Edzelf/Esp-radio/schema.png

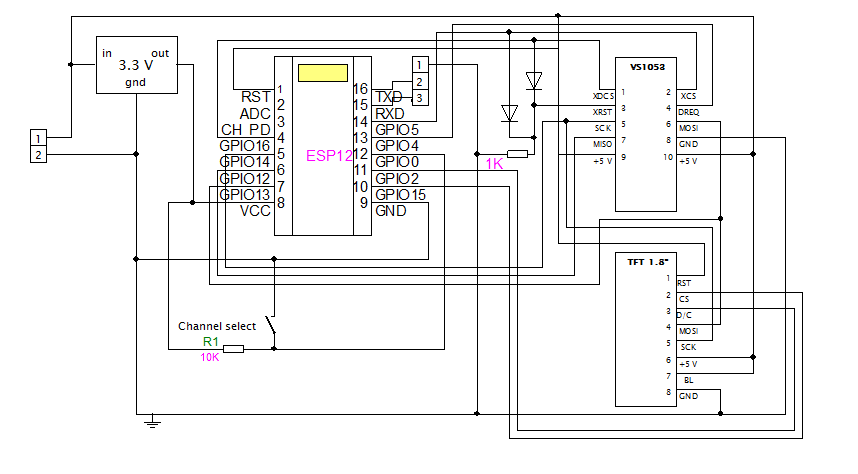
schema.png
