Edzelf/Esp-radio/(threads)

Thread 2 (2016-04-26):

Why not move mp3client to AsyncTCP as well?

me-no-dev, 2016-04-26:
Since I see you already have the Async server up (yeah! :)), why not move the mp3 stream to async as well? You will not need to buffer the client and you can write to the VS1053 as data comes. Using that will also ACK the data only after you have it loaded to the VS, which will make networking a little more predictable :)
Let me know what you think, I can help if needed :)

Edzelf, 2016-04-26:
I will try that.

Edzelf, 2016-04-26:
Hello,

I 've tried it.  But is was no success.
It looks like the client misses some bytes now and then.
In de debug output I see in the original version:
D: ICY 200 OK
D: icy-notice1:<BR>This stream requires <a
href="http://www.winamp.com/">Winamp</a><BR>
D: icy-notice2:SHOUTcast Distributed Network Audio Server/Linux v1.9.8<BR>
D: icy-name:NAXI LOVE RADIO (NAXI,Belgrade,Serbia, NAXI,Beograd,Srbija) - 128k

And in de async version:
D: ICY 200 OK
D: icy-notice1:<BR>This stream requires <a
href="http://www.winamp.com/">Winamp</a><BR>
D: icy-notice2:SHOUTcast Distributed Network Audio Server/Linux
v1.9.8<BR>icy-name:NAXI LOVE RADIO (NAXI,Belgrade,Serbia, NAXI,Beograd,Srbija) -
128k

So at least one linefeed is missing.
After that, the separation between mp3-data and metadata is not possible.

You will find the new source below.

Greetings,
Ed.

--------------------------------------------------------------------------------
//******************************************************************************************
//*  Esp_radio -- Webradio receiver for ESP8266, 1.8 color display and VS1053
MP3 module.  *
//*  With ESP8266 running at 80 MHz, it is capable of handling up to 256 kb
bitrate.       *
//*  With ESP8266 running at 160 MHz, it is capable of handling up to 320 kb
bitrate.      *
//******************************************************************************************
// ESP8266 libraries used:
//  - ESP8266WiFi
//  - SPI
//  - Adafruit_GFX
//  - TFT_ILI9163C
//  - EEPROM
//  - ESPAsyncTCP
//  - ESPAsyncWebServer
//  - FS
//  - ArduinoOTA
// A library for the VS1053 (for ESP8266) is not available (or not easy to
find).  Therefore
// a class for this module is derived from the maniacbug library and integrated
in this sketch.
//
// See http://www.internet-radio.com for suitable stations.  Add the stations of
your choice
// to the table "hostlist" in the global data secting further on.  This will be
written to
// EEPROM and can be modified through remote access through the web server.
//
// Brief description of the program:
// First a suitable WiFi network is found and a connection is made.
// Then a connection will be made to a shoutcast server.  The server starts with
some
// info in the header in readable ascii, ending with a double CRLF, like:
//  icy-name:Classic Rock Florida - SHE Radio
//  icy-genre:Classic Rock 60s 70s 80s Oldies Miami South Florida
//  icy-url:http://www.ClassicRockFLorida.com
//  content-type:audio/mpeg
//  icy-pub:1
//  icy-metaint:32768          - Metadata after 32768 bytes of MP3-data
//  icy-br:128                 - in kb/sec
//
// After de double CRLF is received, the server starts sending mp3-data.  This
data contains
// metadata (non mp3) after every "metaint" mp3 bytes.  This metadata is empty
in most cases,
// but if any is available the content will be presented on the TFT.
// Pushing the input button causes the player to select the next station in the
hostlist (EEPROM).
//
// The display used is a Chinese 1.8 color TFT module 128 x 160 pixels.  The
TFT_ILI9163C.h
// file has been changed to reflect this particular module.  TFT_ILI9163C.cpp
has been
// changed to use the full screenwidth if rotated to mode "3".  Now there is
room for 26
// characters per line and 16 lines.  Software will work without installing the
display.
//
// For configuration of the WiFi network(s): see the global data section further on.
//
// The SPI interface for VS1053 and TFT uses hardware SPI.
//
// Wiring:
// NodeMCU  GPIO    Pin to program  Wired to LCD        Wired to VS1053
Wired to rest
// -------  ------  --------------  ---------------     -------------------
---------------------
// D0       GPIO16  16              -                   pin 1 DCS            -
// D1       GPIO5    5              -                   pin 2 CS             LED
on nodeMCU
// D2       GPIO4    4              -                   pin 4 DREQ           -
// D3       GPIO0    0 FLASH        -                   -          
Control button
// D4       GPIO2    2              pin 3 (D/C)         -                    -
// D5       GPIO14  14 SCLK         pin 5 (CLK)         pin 5 SCK            -
// D6       GPIO12  12 MISO         -                   pin 7 MISO           -
// D7       GPIO13  13 MOSI         pin 4 (DIN)         pin 6 MOSI           -
// D8       GPIO15  15              pin 2 (CS)          -                    -
// D9       GPI03    3 RXD0         -                   -          
Reserved serial input
// D10      GPIO1    1 TXD0         -                   -          
Reserved serial output
// -------  ------  --------------  ---------------     -------------------
---------------------
// GND      -        -              pin 8 (GND)         pin 8 GND  
Power supply
// VCC 3.3  -        -              pin 6 (VCC)         -                    LDO
3.3 Volt
// VCC 5 V  -        -              -                   pin 9 5V   
Power supply
// RST      -        -              pin 1 (RST)         pin 3 RESET
Reset circuit
//
// The reset circuit is a circuit with 2 diodes to GPIO5 and GPIO16 and a
resistor to ground
// (wired OR gate) because there was not a free GPIO output available for this
function.
// This circuit is included in the documentation.
// Issue:
// Webserver produces error "LmacRxBlk:1" after some time.  After that it will
work verry slow.
// The program will reset the ESP8266 in such a case.  It seems that this error
will show up
// less frequently if DNS is not used.  Now we have switched to async webserver,
maybe that
// results in a better stability.
//
// 31-03-2016, ES: First set-up.
// 01-04-2016, ES: Detect missing VS1053 at start-up.
// 05-04-2016, ES: Added commands through http server on port 80.
// 06-04-2016, ES: Added list of stations in EEPROM
// 14-04-2016, ES: Added icon and switch preset on stream error.
// 18-04-2016, ES: Added SPIFFS for webserver
// 19-04-2016, ES: Added ringbuffer
// 20-04-2016, ES: WiFi Passwords through SPIFFS files, enable OTA
// 21-04-2016, ES: Switched to Async Webserver (thanks to me-no-dev)
// 26-04-2016, ES: Switched to Async client as well
//
#include <ESP8266mDNS.h>
#include <ESP8266WiFi.h>
#include <ESPAsyncTCP.h>
#include <ESPAsyncWebServer.h>
#include <ESPAsyncTCP.h>
#include <SyncClient.h>
#include <SPI.h>
#include <Adafruit_GFX.h>
#include <TFT_ILI9163C.h>
#include <Ticker.h>
#include <stdio.h>
#include <string.h>
#include <EEPROM.h>
#include <FS.h>
#include <ArduinoOTA.h>

extern "C"
{
  #include "user_interface.h"
}

// Color definitions for the TFT screen
#define    BLACK   0x0000
#define    BLUE    0xF800
#define    RED     0x001F
#define    GREEN   0x07E0
#define CYAN    GREEN | BLUE
#define MAGENTA RED | BLUE
#define YELLOW  RED | GREEN
#define WHITE   0xFFFF

// Digital I/O used
// Pins for VS1053 module
#define VS1053_CS     5
#define VS1053_DCS    16
#define VS1053_DREQ   4
// Pins CS and DC for TFT module
#define TFT_CS 15
#define TFT_DC 2
// Control button for controlling station
#define BUTTON 0
// Maximal number of presets in EEPROM and size of an entry
#define EENUM 64
#define EESIZ 64
// Ringbuffer for smooth playing 20000 bytes is 160 Kbits, about 1.5 seconds at
128kb bitrate.
#define RINGBFSIZ 20000

//******************************************************************************************
// Global data
section.                                                                    *
//******************************************************************************************
enum datamode_t { INIT, HEADER, DATA, METADATA } ;         // State for datastream
// Global variables
String           ssid ;                                    // SSID of selected
WiFi network
int              DEBUG = 1 ;
#if defined ( dns )
  MDNSResponder  mdns ;                                    // The MDNS responder
#endif
SyncClient       mp3client ;                               // An instance of the
mp3 client
AsyncWebServer   cmdserver ( 80 ) ;                        // Instance of
embedded webserver
String           cmd ;                                     // Command from remote
TFT_ILI9163C     tft = TFT_ILI9163C ( TFT_CS, TFT_DC ) ;
Ticker           tckr ;                                    // For timing 10 sec
uint32_t         totalcount = 0 ;                          // Counter mp3 data
char             sbuf[100] ;                               // For debug lines
datamode_t       datamode ;                                // State of datastream
int              metacount ;                               // Number of bytes in
metadata
int              datacount ;                               // Counter databytes
before metadata
char             metaline[150] ;                           // Readable line in
metadata
char             streamtitle[150] ;                        // Streamtitle from
metadata
int              bitrate = 0 ;                             // Bitrate in
kb/sec  
int              metaint = 0 ;                             // Number of
databytes between metadata
int              currentpreset = 1 ;                       // Preset station to
play (index in hostlist (EEPROM))
int              newpreset = 1 ;                           // Requested preset
char             host[EESIZ] ;                             // The hostname
char             sname[100] ;                              // Stationname
int              port ;                                    // Port number for host
char             newstation[EESIZ] ;                       // Station:port from
remote
int              delpreset = 0 ;                           // Preset to be
deleted if nonzero
uint8_t          reqvol = 80 ;                             // Requested volume
char             currentstat[EESIZ] ;                      // Current station:port
uint8_t*         ringbuf ;                                 // Ringbuffer for VS1053
uint16_t         rbwindex = 0 ;                            // Fill pointer in
ringbuffer
uint16_t         rbrindex = RINGBFSIZ - 1 ;                // Emptypointer in
ringbuffer
uint16_t         rcount = 0 ;                              // Number of bytes in
ringbuffer
//
// List of initial preset stations.
// This will be copied to EEPROM if EEPROM is empty.  The first entry [0] is
reserved
// for detection of a not yet filled EEPROM.
// In EEPROM, every entry takes EESIZ bytes.
const char*      hostlist[] = {
                     "Stations from remote control",  // Reserved entry
                     "109.206.96.34:8100",            //  1 - NAXI LOVE RADIO,
Belgrade, Serbia 128-kbps
                     "us1.internet-radio.com:8180",   //  2 - Easy Hits Florida
128-kbps
                     "us2.internet-radio.com:8050",   //  3 - CLASSIC ROCK MIA
WWW.SHERADIO.COM
                     "us1.internet-radio.com:15919",  //  4 - Magic Oldies Florida
                     "us2.internet-radio.com:8132",   //  5 - Magic 60s Florida
60s Top 40 Classic Rock
                     "us1.internet-radio.com:8105",   //  6 - Classic Rock
Florida - SHE Radio
                     "205.164.36.153:80",             //  7 - BOM PSYTRANCE
(1.FM TM)  64-kbps
                     "205.164.62.15:10032",           //  8 - 1.FM - GAIA, 64-kbps
                     "109.206.96.11:80",              //  9 - TOP FM Beograd
106,8  64-kpbs
                     "85.17.121.216:8468",            // 10 - RADIO LEHOVO 971
GREECE, 64-kbps
                     "85.17.121.103:8800",            // 11 - STAR FM 88.8 Corfu
Greece, 64-kbps
                     "85.17.122.39:8530",             // 12 - stylfm.gr laiko,
64-kbps
                     "94.23.66.155:8106",             // 13 - *ILR CHILL &
GROOVE* 64-kbps
                     "205.164.62.22:7012",            // 14 - 1.FM - ABSOLUTE
TRANCE (EURO) RADIO 64-kbps
                     NULL } ;

//******************************************************************************************
// End of lobal data
section.                                                              *
//******************************************************************************************

void dbgprint ( const char* p ) ;   // Forward declaration for VS1053 stuff

//******************************************************************************************
// VS1053 stuff.  Based on maniacbug
library.                                              *
//******************************************************************************************
// VS1053 class
definition.                                                                *
//******************************************************************************************
class VS1053
{
private:
  uint8_t       cs_pin ;                        // Pin where CS line is connected
  uint8_t       dcs_pin ;                       // Pin where DCS line is connected
  uint8_t       dreq_pin ;                      // Pin where DREQ line is connected
  uint8_t       curvol ;                        // Current volume setting
0..100%
  const uint8_t vs1053_chunk_size = 32 ;
  // SCI Register
  const uint8_t SCI_MODE          = 0x0 ;
  const uint8_t SCI_BASS          = 0x2 ;
  const uint8_t SCI_CLOCKF        = 0x3 ;
  const uint8_t SCI_AUDATA        = 0x5 ;
  const uint8_t SCI_WRAM          = 0x6 ;
  const uint8_t SCI_WRAMADDR      = 0x7 ;
  const uint8_t SCI_AIADDR        = 0xA ;
  const uint8_t SCI_VOL           = 0xB ;
  const uint8_t SCI_AICTRL0       = 0xC ;
  const uint8_t SCI_AICTRL1       = 0xD ;
  const uint8_t SCI_num_registers = 0xF ;
  // SCI_MODE bits
  const uint8_t SM_SDINEW         = 11 ;        // Bitnumber in SCI_MODE always on
  const uint8_t SM_RESET          = 2 ;         // Bitnumber in SCI_MODE soft reset
  const uint8_t SM_CANCEL         = 3 ;         // Bitnumber in SCI_MODE cancel song
  const uint8_t SM_TESTS          = 5 ;         // Bitnumber in SCI_MODE for tests
  const uint8_t SM_LINE1          = 14 ;        // Bitnumber in SCI_MODE for
Line input
  SPISettings   VS1053_SPI ;                    // SPI settings for this slave
  uint8_t       endFillByte ;                   // Byte to send when stopping song
  char          lsbuf[60] ;                     // For debugging
protected:
  inline void await_data_request() const
  {
    while ( !digitalRead ( dreq_pin ) )
    {
        yield() ;                         // Very short delay
    }
  }

  inline void control_mode_on() const
  {
    SPI.beginTransaction ( VS1053_SPI ) ; // Prevent other SPI users
    digitalWrite ( dcs_pin, HIGH ) ;      // Bring slave in dontrol mode
    digitalWrite ( cs_pin, LOW ) ;
  }

  inline void control_mode_off() const
  {
    digitalWrite ( cs_pin, HIGH ) ;       // End control mode
    SPI.endTransaction() ;                // Allow other SPI users
  }

  inline void data_mode_on() const
  {
    SPI.beginTransaction ( VS1053_SPI ) ; // Prevent other SPI users
    digitalWrite ( cs_pin, HIGH ) ;       // Bring slave in data mode
    digitalWrite ( dcs_pin, LOW ) ;
  }

  inline void data_mode_off() const
  {
    digitalWrite ( dcs_pin, HIGH ) ;      // End data mode
    SPI.endTransaction() ;                // Allow other SPI users
  }

  uint16_t read_register ( uint8_t _reg ) const ;
  void     write_register ( uint8_t _reg, uint16_t _value ) const ;
  void     sdi_send_buffer ( uint8_t* data, size_t len ) ;
  void     sdi_send_fillers ( size_t length ) ;
  void     wram_write ( uint16_t address, uint16_t data ) ;
  uint16_t wram_read ( uint16_t address ) ;

public:
  // Constructor.  Only sets pin values.  Doesn't touch the chip.  Be sure to
call begin()!
  VS1053 ( uint8_t _cs_pin, uint8_t _dcs_pin, uint8_t _dreq_pin ) ;
  void     begin() ;                                   // Begin operation.  Sets
pins correctly,
                                                       // and prepares SPI bus.
  void     startSong() ;                               // Prepare to start
playing. Call this each
                                                       // time a new song starts.
  void     playChunk ( uint8_t* data, size_t len ) ;   // Play a chunk of data.
Copies the data to
                                                       // the chip.  Blocks
until complete.
  void     stopSong() ;                                // Finish playing a song.
Call this after
                                                       // the last playChunk call.
  void     setVolume ( uint8_t vol ) ;                 // Set the player
volume.Level from 0-100,
                                                       // higher is louder.
  uint8_t  getVolume() ;                               // Get the currenet
volume setting.
                                                       // higher is louder.
  void     printDetails ( const char *header ) ;       // Print configuration
details to serial output.
  void     softReset() ;                               // Do a soft reset
  bool     testComm ( const char *header ) ;           // Test communication
with module
  inline bool data_request() const
  {
    return ( digitalRead ( dreq_pin ) == HIGH ) ;
  }
} ;

//******************************************************************************************
// VS1053 class
implementation.                                                            *
//******************************************************************************************

// Constructor
VS1053::VS1053 ( uint8_t _cs_pin, uint8_t _dcs_pin, uint8_t _dreq_pin ) :
  cs_pin(_cs_pin), dcs_pin(_dcs_pin), dreq_pin(_dreq_pin)
{
}

uint16_t VS1053::read_register ( uint8_t _reg ) const
{
  uint16_t result ;

  control_mode_on() ;
  SPI.write ( 3 ) ;                          // Read operation
  SPI.write ( _reg ) ;                       // Register to write (0..0xF)
  // Note: transfer16 does not seem to work
  result = ( SPI.transfer ( 0xFF ) << 8 ) |  // Read 16 bits data
           ( SPI.transfer ( 0xFF ) ) ;
  await_data_request() ;                     // Wait for DREQ to be HIGH again
  control_mode_off() ;
  return result ;
}

void VS1053::write_register ( uint8_t _reg, uint16_t _value ) const
{
  control_mode_on( );
  SPI.write ( 2 ) ;                          // Write operation
  SPI.write ( _reg ) ;                       // Register to write (0..0xF)
  SPI.write16 ( _value ) ;                   // Send 16 bits data
  await_data_request() ;
  control_mode_off() ;
}

void VS1053::sdi_send_buffer ( uint8_t* data, size_t len )
{
  size_t chunk_length ;                      // Length of chunk 32 byte or shorter

  data_mode_on() ;
  while ( len )                              // More to do?
  {
    await_data_request() ;                   // Wait for space available
    chunk_length = len ;
    if ( len > vs1053_chunk_size )
    {
      chunk_length = vs1053_chunk_size ;
    }
    len -= chunk_length ;
    SPI.writeBytes ( data, chunk_length ) ;
    data += chunk_length ;
  }
  data_mode_off() ;
}

void VS1053::sdi_send_fillers ( size_t len )
{
  size_t chunk_length ;                      // Length of chunk 32 byte or shorter

  data_mode_on() ;
  while ( len )                              // More to do?
  {
    await_data_request() ;                   // Wait for space available
    chunk_length = len ;
    if ( len > vs1053_chunk_size )
    {
      chunk_length = vs1053_chunk_size ;
    }
    len -= chunk_length ;
    while ( chunk_length-- )
    {
      SPI.write ( endFillByte ) ;
    }
  }
  data_mode_off();
}

void VS1053::wram_write ( uint16_t address, uint16_t data )
{
  write_register ( SCI_WRAMADDR, address ) ;
  write_register ( SCI_WRAM, data ) ;
}

uint16_t VS1053::wram_read ( uint16_t address )
{
  write_register ( SCI_WRAMADDR, address ) ;            // Start reading from WRAM
  return read_register ( SCI_WRAM ) ;                   // Read back result
}

bool VS1053::testComm ( const char *header )
{
  // Test the communication with the VS1053 module.  The result wille be returned.
  // If DREQ is low, there is problably no VS1053 connected.  Pull the line HIGH
  // in order to prevent an endless loop waiting for this signal.  The rest of the
  // software will still work, but readbacks from VS1053 will fail.
  int       i ;                                         // Loop control
  uint16_t  r1, r2, cnt = 0 ;
  uint16_t  delta = 300 ;                               // 3 for fast SPI

  if ( !digitalRead ( dreq_pin ) )
  {
    dbgprint ( "VS1053 not properly installed!" ) ;
    // Allow testing without the VS1053 module
    pinMode ( dreq_pin,  INPUT_PULLUP ) ;               // DREQ is now input
with pull-up
    return false ;                                      // Return bad result
  }
  // Further TESTING.  Check if SCI bus can write and read without errors.
  // We will use the volume setting for this.
  // Will give warnings on serial output if DEBUG is active.
  // A maximum of 20 errors will be reported.
  if ( strstr ( header, "Fast" ) )
  {
    delta = 3 ;                                         // Fast SPI, more loops
  }
  dbgprint ( header ) ;                                 // Show a header
  for ( i = 0 ; ( i < 0xFFFF ) && ( cnt < 20 ) ; i += delta )
  {
    write_register ( SCI_VOL, i ) ;                     // Write data to SCI_VOL
    r1 = read_register ( SCI_VOL ) ;                    // Read back for the
first time
    r2 = read_register ( SCI_VOL ) ;                    // Read back a second time
    if  ( r1 != r2 || i != r1 || i != r2 )              // Check for 2 equal reads
    {
      sprintf ( lsbuf, "VS1053 error retry SB:%04X R1:%04X R2:%04X", i, r1, r2 ) ;
      dbgprint ( lsbuf ) ;
      cnt++ ;
      delay ( 10 ) ;
    }
    yield() ;                                           // Allow ESP firmware to
do some bookkeeping
  }
  return ( cnt == 0 ) ;                                 // Return the result
}

void VS1053::begin()
{
  pinMode      ( dreq_pin,  INPUT ) ;                   // DREQ is an input
  pinMode      ( cs_pin,    OUTPUT ) ;                  // The SCI and SDI signals
  pinMode      ( dcs_pin,   OUTPUT ) ;
  digitalWrite ( dcs_pin,   HIGH ) ;                    // Start HIGH for SCI en SDI
  digitalWrite ( cs_pin,    HIGH ) ;
  delay ( 100 ) ;
  dbgprint ( "Reset VS1053..." ) ;
  digitalWrite ( dcs_pin,   LOW ) ;                     // Low & Low will bring
reset pin low
  digitalWrite ( cs_pin,    LOW ) ;
  delay ( 2000 ) ;
  dbgprint ( "End reset VS1053..." ) ;
  digitalWrite ( dcs_pin,   HIGH ) ;                    // Back to normal again
  digitalWrite ( cs_pin,    HIGH ) ;
  delay ( 500 ) ;
  // Init SPI in slow mode ( 2 MHz )
  VS1053_SPI = SPISettings ( 200000, MSBFIRST, SPI_MODE0 ) ;
  //printDetails ( "Right after reset/startup" ) ;
  delay ( 20 ) ;
  //printDetails ( "20 msec after reset" ) ;
  testComm ( "Slow SPI,Testing VS1053 read/write registers..." ) ;
  // Most VS1053 modules will start up in midi mode.  The result is that there
is no audio
  // when playing MP3.  You can modify the board, but there is a more elegant way:
  wram_write ( 0xC017, 3 ) ;                            // Switch to MP3 mode
  wram_write ( 0xC019, 0 ) ;                            // Switch to MP3 mode
  delay ( 100 ) ;
  //printDetails ( "After test loop" ) ;
  softReset() ;                                         // Do a soft reset
  // Switch on the analog parts
  write_register ( SCI_AUDATA, 44100 + 1 ) ;            // 44.1kHz + stereo
  // The next clocksetting allows SPI clocking at 5 MHz, 4 MHz is safe then.
  write_register ( SCI_CLOCKF, 6 << 12 ) ;              // Normal clock settings
multiplyer 3.0 = 12.2 MHz
  //SPI Clock to 4 MHz. Now you can set high speed SPI clock.
  VS1053_SPI = SPISettings ( 4000000, MSBFIRST, SPI_MODE0 ) ;
  write_register ( SCI_MODE, _BV ( SM_SDINEW ) | _BV ( SM_LINE1 ) ) ;
  testComm ( "Fast SPI, Testing VS1053 read/write registers again..." ) ;
  delay ( 10 ) ;
  await_data_request() ;
  endFillByte = wram_read ( 0x1E06 ) & 0xFF ;
  sprintf ( lsbuf, "endFillByte is %X", endFillByte ) ;
  dbgprint ( lsbuf ) ;
  //printDetails ( "After last clocksetting" ) ;
  delay ( 100 ) ;
}

void VS1053::setVolume ( uint8_t vol )
{
  // Set volume.  Both left and right.
  // Input value is 0..100.  100 is the loudest.
  uint16_t value ;                                      // Value to send to SCI_VOL

  if ( vol != curvol )
  {
    curvol = vol ;                                      // Save for later use
    value = map ( vol, 0, 100, 0xFF, 0x00 ) ;           // 0..100% to one channel
    value = ( value << 8 ) | value ;
    write_register ( SCI_VOL, value ) ;                 // Volume left and right
  }
}

uint8_t VS1053::getVolume()                             // Get the currenet
volume setting.
{
  return curvol ;
}

void VS1053::startSong()
{
  sdi_send_fillers ( 10 ) ;
}

void VS1053::playChunk ( uint8_t* data, size_t len )
{
  sdi_send_buffer ( data, len ) ;
}

void VS1053::stopSong()
{
  uint16_t modereg ;                     // Read from mode register
  int      i ;                           // Loop control

  sdi_send_fillers ( 2052 ) ;
  delay ( 10 ) ;
  write_register ( SCI_MODE, _BV ( SM_SDINEW ) | _BV ( SM_CANCEL ) ) ;
  for ( i = 0 ; i < 200 ; i++ )
  {
    sdi_send_fillers ( 32 ) ;
    modereg = read_register ( SCI_MODE ) ;  // Read status
    if ( ( modereg & _BV ( SM_CANCEL ) ) == 0 )
    {
      sdi_send_fillers ( 2052 ) ;
      sprintf ( lsbuf, "Song stopped correctly after %d msec",
                i * 10 ) ;
      dbgprint ( lsbuf ) ;
      return ;
    }
    delay ( 10 ) ;
  }
  printDetails ( "Song stopped incorrectly!" ) ;
}

void VS1053::softReset()
{
  write_register ( SCI_MODE, _BV ( SM_SDINEW ) | _BV ( SM_RESET ) ) ;
  delay ( 10 ) ;
  await_data_request() ;
}

void VS1053::printDetails ( const char *header )
{
  uint16_t     regbuf[16] ;
  uint8_t      i ;

  dbgprint ( header ) ;
  dbgprint ( "REG   Contents" ) ;
  dbgprint ( "---   -----" ) ;
  for ( i = 0 ; i <= SCI_num_registers ; i++ )
  {
    regbuf[i] = read_register ( i ) ;
  }
  for ( i = 0 ; i <= SCI_num_registers ; i++ )
  {
    delay ( 5 ) ;
    sprintf ( lsbuf, "%3X - %5X", i, regbuf[i] ) ;
    dbgprint ( lsbuf ) ;
  }
}

// The object for the MP3 player
VS1053 mp3 (  VS1053_CS, VS1053_DCS, VS1053_DREQ ) ;

//******************************************************************************************
// End VS1053
stuff.                                                                       *
//******************************************************************************************

//******************************************************************************************
// Ringbuffer (fifo)
routines.                                                             *
//******************************************************************************************
//******************************************************************************************
//                              R I N G S P A C
E                                          *
//******************************************************************************************
inline bool ringspace()
{
  return ( rcount < RINGBFSIZ ) ;     // True is at least one byte of free space
is available
}

//******************************************************************************************
//                              R I N G A V A I
L                                          *
//******************************************************************************************
inline uint16_t ringavail()
{
  return rcount ;                     // Return number of bytes available
}

//******************************************************************************************
//                                P U T R I N
G                                            *
//******************************************************************************************
bool putring ( uint8_t b )            // Put one byte in the ringbuffer
{
  // No check on available space.  See ringspace()
  *(ringbuf+rbwindex) = b ;           // Put byte in ringbuffer
  if ( ++rbwindex == RINGBFSIZ )      // Increment pointer and
  {
    rbwindex = 0 ;                    // wrap at end
  }
  rcount++ ;                          // Count number of bytes in the
}

//******************************************************************************************
//                                G E T R I N
G                                            *
//******************************************************************************************
uint8_t getring()
{
  // Assume there is always something in the bufferpace.  See ringavail()
  if ( ++rbrindex == RINGBFSIZ )      // Increment pointer and
  {
    rbrindex = 0 ;                    // wrap at end
  }
  rcount-- ;                          // Count is now one less
  return *(ringbuf+rbrindex) ;        // return the oldest byte
}

//******************************************************************************************
//                               E M P T Y R I N
G                                         *
//******************************************************************************************
void emptyring()
{
  rbwindex = 0 ;                      // Reset ringbuffer administration
  rbrindex = RINGBFSIZ - 1 ;
  rcount = 0 ;
}

//******************************************************************************************
//                                  D B G
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

Thread 8 (2016-05-23):

D: VS1053 error retry SB:0000 R1:FFFF R2:FFFF

praveenchaun, 2016-05-23:
Hi There,
I am getting some errors however code continue to run. Cannot listen anything from head phone. Do I need to modify the board to support MP3?

Serial monitor output attached.

Thanks,
[error.txt](https://github.com/Edzelf/Esp-radio/files/277036/error.txt)

praveenchaun, 2016-05-23:
I mean no sound on head phone. Thanks.

Edzelf, 2016-05-23:
Praveenchaun,

It looks like the connection to the VS1053 is not correct.  There shouldn't be errors after "Slow SPI,Testing VS1053 read/write registers...".  In your case I see a readback of "FFFF", so I assume that writing commands to SPI did not work.  Check the wiring.....

praveenchaun, 2016-05-24:
Thanks for your response.
I have not connected the reset wiring to VS1053, is that could be an issue?
I was trying to reset the board manually pulling it to GND between below steps.
D: Reset VS1053...
D: End reset VS1053...
Could you please let me know what the diod values you used?

Edzelf, 2016-05-24:
There is no need for the reset wiring as long as you use power-off power-on to reset the radio.  I used 14148 diodes.  If "Testing VS1053 read/write registers" produces errors, check pins 1,2,4,5, and 7 of the VS1053 board.  I'm pretty sure that one of these pins is not (or wrong) wired.

praveenchaun, 2016-05-26:
Today I reconnected everything and noticed that it stops at the below location:

: Restored settings: volume 80, preset 1
D: 1Reset VS1053...
D: End reset VS1053...
D: inside testComm
D: VS1053 not properly installed!

Once I disconnect the DREQ Pin, proceeds to rest of the steps and fails!!

D: Fast SPI, Testing VS1053 read/write registers again...
D: VS1053 error retry SB:0003 R1:0000 R2:0000
D: VS1053 error retry SB:0006 R1:0000 R2:0000

Something wrong with my module. I am using ESP12E Firmware :

2nd boot version : 1.4(b1)
  SPI Speed      : 40MHz
  SPI Mode       : QIO
  SPI Flash Size & Map: 8Mbit(512KB+512KB)
jump to run user1 @ 1000

ŒÂÕ�MEM CHECK FAIL!!!
ärlŽ‚rô
Ai-Thinker Technology Co. Ltd.
=====================
Sketch upload options as you suggested.

Edzelf, 2016-05-26:
Your ESP8266 works correctly according to the debug output.
After power up or reset the DREQ line must be HIGH. "VS1053 not properly installed!" will be printed if this line is LOW.  Pin 4 of the VS1084 should be on a 3 Volt level  when not connected.  If not, the board is probably damaged.  Are u sure that the module is powered by 5 Volt?

Closed 2016-06-06.

Thread 9 (2016-05-24):

esp board, do not connect to internet..what I doing wrong?

yo2ldk, 2016-05-24:
Hi Ed,

 first, thank you for your work, I really need something like this !
I have two modules, one esp8266 like ESP-12F :

http://g02.a.alicdn.com/kf/HTB1gXfyLVXXXXafXFXXq6xXFXXXk/221078962/HTB1gXfyLVXXXXafXFXXq6xXFXXXk.jpg

and other like ESP-12E I think:

http://g01.a.alicdn.com/kf/HTB18APYLVXXXXaOaXXXq6xXFXXXb/221815479/HTB18APYLVXXXXaOaXXXq6xXFXXXb.jpg

 Now, i change the file name ssid.pw, to my ssid network, and text inside with my password. then I copy into folder Data, where the schetch it is, also folder ESP8266FS with jar file in it.
 When I upload file, I selected NodeMCU 0.9 board, then NodeMCU 1.0.
not work  at all.. (firmware is uploaded ok)
 I not see on router this connection, and LCD is blank.
please some advice  I'm blocked  :(

(or on my mail - yo2ldk  a r r o u n d yahoo dot   c o m )
  thank you in advance

Edzelf, 2016-05-24:
The .pw file must be, together with index.html and favicon.ico in the map "data" (lower case).  Then you have to upload this map to your ESP8266 as shown at page 2 of the the pdf-file.  There should not be a "jar"-file in it.  Try to capture the debug output and publish it here, than I can see what's wrong.

yo2ldk, 2016-05-24:
thank you for you time and fast reply!

 please tell me also in Arduino software/tools/debbug level, what I need to select from there ?
 and, because I'm still novice, how can I read.obtain the debug file?

Edzelf, 2016-05-24:
No settings are required for debug level output.  Just start serial monitor (Ctrl+Shift+M in IDE) and copy the output.

yo2ldk, 2016-05-24:
still the same, nothing in headset, looks like is not connected via wifi , LED is on for a bit when insert power, then is off, is it was traffic, I presume it was blink,
wires is checked and re check, firmware is ok, on serial terminal monitor is blank, nothing.
I put out display, still nothing.
I will try later, at home router. Thank you for your patience

Edzelf, 2016-05-24:
I do not know what you mean by "firmware".  Did the upload of the sketch and the "ESP8266 Data Upload" succeed?  In the debug output you should see at least some output lines concerning WiFi connection and VS1053 tests.  As an example of the debug output see the attached file.
[debug.txt](https://github.com/Edzelf/Esp-radio/files/279410/debug.txt)

MiloPS3, 2016-05-26:
Hello, I had the same problem, I have ESP12E Lolin
you must rename .pw file at "myssid.pw" and change password and ssid inside
select Flash Size: "4 M(1M SPIFFS)".
upload this map to your ESP8266 as shown at page 2 of the pdf-file(pw file +index.html+favicon.ico)
if in debug output is (my neme ssid is "PS4" and "MO")
`D: FS Total 957314, used 9287
D: /favicon.ico                     -    766
D: /index.html                      -   6563
D: /MO.pw                           -     71
D: /PS4.pw                          -     71
`
upload success done
if in next debug output is
`D: Selected network:               
D: Try WiFi
`
wrong name pw file of wrong select Flash Size
right is
`D: Selected network: PS4              
D: Try WiFi PS4
`
if not define USETFT and use  button on D8/GPIO15 , disconnect pull-up if is used at start esp,log high on D8 is Boot on SD card (esp not start)

Excuse me for my bad English

Edzelf, 2016-05-26:
Milo, You are right about the .pw file(s).  I will make that more clear in the document file.
You are also right about GPIO15 (D8), which must be low to allow the ESP to start.  I will think of a solution for that.

MiloPS3, 2016-05-26:
change LOW to HIGH   in
oldval3 = newval ;                          // Yes, remember value
      //if ( newval == LOW )                        // Button pushed?
	  if ( newval == HIGH )                        // Button pushed?
It is not a good solution (2 button active in low and 1 button active high)
but it works

Edzelf, 2016-05-26:
Fixed it already.

WiGeorg, 2018-03-07:
hello Ed,
I followed this discussion (and others I found) with some given solutions to connect to WiFi, but I dont have any success! My little system only open an AP under 192.168.4.1
I use a NodeMCU 1.0(ESP 12F - LoLin), my configuration is:
4M (3M SPIFFS) => 4M(1MSPIFFS) do not work too
v2 Prebuilt (MSS0536) => v1.4Prebuilt do not work too
Arduino IDE 1.85
My pw-file is named "mySSID.pw" with the content "mySSID/mypw"

Please see the debug-file here:
[My Output.txt](https://github.com/Edzelf/Esp-radio/files/1789058/My.Output.txt)
Do you have any idea what goes wrong?

Thanks!

Willi

Edzelf, 2018-03-07:
A *.pw file is no longer required for the latest version of the radio.  You have to enter the WiFi credentials in the radio.ini file like this:
```
# WiFi network credentials, may be more than on entry.  Strongest signal will be selected.
wifi_00 = TP-LINK_9ECA/PASWORDXXX

```

WiGeorg, 2018-03-07:
Hello Ed, thank you!I started without a pw-file, but without succes. I found the pw tip in a thread. After my last mail I found out that the system connect, when I configer my router to No Security. This isn't a real solution. Standard is WEP/WEP2 with AES/TPK. It seems to be a problem of cryptage.Do you have any idea?WilliAm 07.03.2018 16:30 schrieb Ed Smallenburg <notifications@github.com>:A *.pw file is no longer required for the latest version of the radio.  You have to enter the WiFi credentials in the radio.ini file like this:
# WiFi network credentials, may be more than on entry.  Strongest signal will be selected.
wifi_00 = TP-LINK_9ECA/PASWORDXXX

—You are receiving this because you commented.Reply to this email directly, view it on GitHub, or mute the thread.

Closed 2016-06-06.

Thread 11 (2016-08-05):

ESP-01

iqbeul, 2016-08-05:
Dear Edzelf
Im newbie for esp8266, but interested with your project, i try following your pdf guide from preparing Arduino IDE to Install Library. i dont understand how to upload the sketch what is the different update through Tools/ESP8266Sketch Data Upload with Upload like usual arrow in the main panel of Arduino IDE.
So far is unsuccesfull when i try with ESP-01 and use arduino uno as ISP, is it possible to upload and test with this board ? what should i do to get esp-01 can receive upload sketch
Thank you in advance

Edzelf, 2016-08-06:
The ESP-01 is not suitable for this project.  There are not enough pins to drive the VS1053 module and the memory is too small to load the program and the data.  I suggest to use a ESP-12 or even better a nodeMCU module.  The nodeMCU has its own USB interface so you don't need the Arduino for upload.

bickyb, 2016-08-15:
First off, awesome project.   I had a few questions:

1)I was reading through the PDF and it mentions using a "VS1063 module".  Was that supposed to be VS1053 module?

2) Let's say I want to play just a standalone MP3 file residing on a web server (e.g., www.somedomain.com/mymp3file.mp3
How would I go about doing this?  It seems your code shows how to connect to mp3 streams, but I wanted to see if single mp3 playback is doable.

3) I wanted to see if the following board would be usable:
https://learn.adafruit.com/adafruit-feather-huzzah-esp8266/overview

instead of the ESP-12 board.

Closed 2016-08-15.

Thread 12 (2016-08-05):

Web page not loading completely

nlovrens, 2016-08-05:
Hi,
First of all, i would like to thank you for all what you have done, great work!
But I have one issue:
When opening web page of the esp, page is not loaded completely (see attach).
Everything else works, I can listen to music, issue additional commands thru web and so on...
Can you, please help?

Thank you

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

Edzelf, 2016-08-06:
Check if index.html in the data directory (the files in the SPIFFS) has the right length. It should be 6563 bytes.  If you connect a serial monitor, you should see a directory listing in the debug output.
An ESP-12 should have more than enough space to hold the files.
You could use the "show source" of your browser to examine the contents (specially near the end) of the index.html file.

nlovrens, 2016-08-06:
I couldn't find the problem. File index.html is correct size and it is listed in serial output.
I have also tried to delete most of the stuff from index.html and leave just the header and one word in the body, then page was loaded completely. After that I have tried to add more and more stuff to body and then after some point page didn't want to load anymore. It looks like if the index.html grows over certain size then problem starts.
I have also tried to downgrade Arduino ide to 1.6.8 and ESP8266 package to 2.2.0 as stated in your PDF but it didn't help. I have also tried to flash esp as 1M(3M SPIFFS) to check if memory is corrupted, but behavior was the same.

Edzelf, 2016-08-07:
I think your analysis is right.  Could you try to use a different WiFi network (ask a neighbour or a friend)?
What kind of ESP module are you using?

nlovrens, 2016-08-07:
Hi.
After lots of troubleshooting I have found the problem. Cisco VPN client that I have installed on my PC changed MTU on all my network interfaces to 1300 (default in windows is 1500). And apparently expressIFs IP stack doesn't support MTU size less than 1460. After manually reverting my MTU to 1500 web page loaded successfully. You can close the issue.
Thank you for all your support!

Closed 2016-08-08.

Thread 16 (2016-08-15):

Feature Request - Bootstrapping to Wifi

bickyb, 2016-08-15:
It would be really cool if you could make it so that one can connect to the ESP-radio via their phone using a browser (kind of like you do a wifi router upon initial config).  From there, it would be nice if you could search for wifi spots available, select one, and provide credentials to connect to it.
I love the current setup but right now it requires one to have to know what wifi spots they might be connecting to and to preprogram them.  It would be cool if one could press a button to put the device in learn mode so you can configure the wifi credentials on the fly.

Edzelf, 2016-08-15:
The web server is included in the Esp-radio.  In order to connect to the webserver the ESP has has to connect to the WiFi first.  Theoretically it should be possible to let the ESP act like a station and access point simultaneously, but I do not have experience with this set-up.

But if you mean to dynamically add WiFi stations while the ESP is already connected it is possible.  This feature would need some extra software.

bbx10, 2016-08-24:
[WiFiManager](https://github.com/tzapu/WiFiManager) works well for entering new SSID and password. I have used it before.

Edzelf, 2016-08-24:
bbx10,
That looks nice!  I will implement this feature in the near future.

Edzelf, 2016-10-04:
Fixed in the current version.

Closed 2016-10-04.

Thread 17 (2016-08-15):

Which type of diodes

bickyb, 2016-08-15:
Hi,
I saw in the circuit diagram in the PDF that you use 2 diodes.
Can you please specify which types of diodes you suggest using?

Edzelf, 2016-08-15:
The diodes are not critical.  I used 1N5148.

Closed 2016-10-04.

Thread 18 (2016-08-15):

Where to hookup audio amplifier

bickyb, 2016-08-15:
Hi,
One thing I could not figure out from the circuit diagrams is how you are connecting the audio amplifier to the VS1053 board.
The VS1053 board has a 3.5mm output which can be connected to headphones.
What is a bit unclear to me is how you can connect the audio amp to the VS1053 board.  Do you have a cable plugged into the 3.5 jack and are you tapping into the audio from the line level out or do you somehow connect the amplifier to the VS1053 board directly?

Also, can you please let us know an example of the type of amplifier you used in your circuit?

Edzelf, 2016-08-15:
The audio amplifier is connected through the 3.5 mm output jack.  Note that the common pin of the output jack is not at ground level.  Therefore I used a separate power circuit (battery) for the amplifier.

For the amplifier I used a cheap class D type base on a PAM8403 chip ( 2 dollar for 10 pieces).

Closed 2016-09-15.

Thread 19 (2016-09-08):

webserver doesnt work correct

macmattes, 2016-09-08:
hi

thanks for this project, i use your software with a nodemcu clone from china and a vs1003 board.
streaming and audio works fine, but i am unable to use the webinterface. Some time the site loads nearly full, only the presets are missed , mostly i got a broken website which starts with "hr.open ( "GET", theUrl, false ...........  and shows the html code instead the site.
And if the site is visible i am unable to use any of the buttons, because loading never ends.
i have reflashed the esp some times also with a blink sketch and different flash sizes. nothing changed.
if i stop the site loading and use only the functions like "/?uppreset=1" it changes the channel without a delay. the other functions are also working. hope you can help to find my problem with the website.
i used safari or firefox on osx, both the same

Edzelf, 2016-09-08:
Hello,
Maybe it is a problem with the vs1003 board.  Just remove the vs1003 and try the web-interface to see if it is loading.  I tried several Chinese boards without problems.  Send you debug output to ed.at.smallenburg.nl.  (.at. = @).
Ed.

Verzonden vanaf Samsung-tablet.

-------- Oorspronkelijk bericht --------
Van: macmattes <notifications@github.com>
Datum: 08-09-2016  20:04  (GMT+01:00)
Aan: Edzelf/Esp-radio <Esp-radio@noreply.github.com>
Onderwerp: [PossibleSpam] [Edzelf/Esp-radio] webserver doesnt work correct (#19)

hi

thanks for this project, i use your software with a nodemcu clone from china and a vs1003 board.

streaming and audio works fin, but i am unable to use the webinterface. Some time the site loads nearly full, only the presets are missed , mostly i got a broken website which starts with "hr.open ( "GET", theUrl, false ...........  and shows the html code instead the site.

And if the site is visible i am unable to use any of the buttons, because loading never ends.

i have reflashed the esp some times also with a blink sketch and different flash sizes. nothing changed.

if i stop the site loading and use only the functions like "/?uppreset=1" it changes the channel without a delay. the other functions are also working. hope you can help to find my problem with the website.

i used safari or firefox on osx, both the same

—
You are receiving this because you are subscribed to this thread.
Reply to this email directly, view it on GitHub, or mute the thread.

{"api_version":"1.0","publisher":{"api_key":"05dde50f1d1a384dd78767c55493e4bb","name":"GitHub"},"entity":{"external_key":"github/Edzelf/Esp-radio","title":"Edzelf/Esp-radio","subtitle":"GitHub repository","main_image_url":"https://cloud.githubusercontent.com/assets/143418/17495839/a5054eac-5d88-11e6-95fc-7290892c7bb5.png","avatar_image_url":"https://cloud.githubusercontent.com/assets/143418/15842166/7c72db34-2c0b-11e6-9aed-b52498112777.png","action":{"name":"Open in GitHub","url":"https://github.com/Edzelf/Esp-radio"}},"updates":{"snippets":[{"icon":"DESCRIPTION","message":"webserver doesnt work correct (#19)"}],"action":{"name":"View Issue","url":"https://github.com/Edzelf/Esp-radio/issues/19"}}}

Edzelf, 2016-09-08:
Are you sure that javascript works on osx?

Verzonden vanaf Samsung-tablet.

-------- Oorspronkelijk bericht --------
Van: macmattes <notifications@github.com>
Datum: 08-09-2016  20:04  (GMT+01:00)
Aan: Edzelf/Esp-radio <Esp-radio@noreply.github.com>
Onderwerp: [PossibleSpam] [Edzelf/Esp-radio] webserver doesnt work correct (#19)

hi

thanks for this project, i use your software with a nodemcu clone from china and a vs1003 board.

streaming and audio works fin, but i am unable to use the webinterface. Some time the site loads nearly full, only the presets are missed , mostly i got a broken website which starts with "hr.open ( "GET", theUrl, false ...........  and shows the html code instead the site.

And if the site is visible i am unable to use any of the buttons, because loading never ends.

i have reflashed the esp some times also with a blink sketch and different flash sizes. nothing changed.

if i stop the site loading and use only the functions like "/?uppreset=1" it changes the channel without a delay. the other functions are also working. hope you can help to find my problem with the website.

i used safari or firefox on osx, both the same

—
You are receiving this because you are subscribed to this thread.
Reply to this email directly, view it on GitHub, or mute the thread.

{"api_version":"1.0","publisher":{"api_key":"05dde50f1d1a384dd78767c55493e4bb","name":"GitHub"},"entity":{"external_key":"github/Edzelf/Esp-radio","title":"Edzelf/Esp-radio","subtitle":"GitHub repository","main_image_url":"https://cloud.githubusercontent.com/assets/143418/17495839/a5054eac-5d88-11e6-95fc-7290892c7bb5.png","avatar_image_url":"https://cloud.githubusercontent.com/assets/143418/15842166/7c72db34-2c0b-11e6-9aed-b52498112777.png","action":{"name":"Open in GitHub","url":"https://github.com/Edzelf/Esp-radio"}},"updates":{"snippets":[{"icon":"DESCRIPTION","message":"webserver doesnt work correct (#19)"}],"action":{"name":"View Issue","url":"https://github.com/Edzelf/Esp-radio/issues/19"}}}

Edzelf, 2016-09-08:
Could you try to use a different wifi network?  Maybe it something to do with the maximal packet size of your router.  You may also try to load a short and a long .txt file on the SPIFFS.  Your browser should be able to load this correctly (http://<IP>/file.txt or something like that).
Verzonden vanaf Samsung-tablet.

-------- Oorspronkelijk bericht --------
Van: macmattes <notifications@github.com>
Datum: 08-09-2016  20:04  (GMT+01:00)
Aan: Edzelf/Esp-radio <Esp-radio@noreply.github.com>
Onderwerp: [PossibleSpam] [Edzelf/Esp-radio] webserver doesnt work correct (#19)

hi

thanks for this project, i use your software with a nodemcu clone from china and a vs1003 board.

streaming and audio works fin, but i am unable to use the webinterface. Some time the site loads nearly full, only the presets are missed , mostly i got a broken website which starts with "hr.open ( "GET", theUrl, false ...........  and shows the html code instead the site.

And if the site is visible i am unable to use any of the buttons, because loading never ends.

i have reflashed the esp some times also with a blink sketch and different flash sizes. nothing changed.

if i stop the site loading and use only the functions like "/?uppreset=1" it changes the channel without a delay. the other functions are also working. hope you can help to find my problem with the website.

i used safari or firefox on osx, both the same

—
You are receiving this because you are subscribed to this thread.
Reply to this email directly, view it on GitHub, or mute the thread.

{"api_version":"1.0","publisher":{"api_key":"05dde50f1d1a384dd78767c55493e4bb","name":"GitHub"},"entity":{"external_key":"github/Edzelf/Esp-radio","title":"Edzelf/Esp-radio","subtitle":"GitHub repository","main_image_url":"https://cloud.githubusercontent.com/assets/143418/17495839/a5054eac-5d88-11e6-95fc-7290892c7bb5.png","avatar_image_url":"https://cloud.githubusercontent.com/assets/143418/15842166/7c72db34-2c0b-11e6-9aed-b52498112777.png","action":{"name":"Open in GitHub","url":"https://github.com/Edzelf/Esp-radio"}},"updates":{"snippets":[{"icon":"DESCRIPTION","message":"webserver doesnt work correct (#19)"}],"action":{"name":"View Issue","url":"https://github.com/Edzelf/Esp-radio/issues/19"}}}

macmattes, 2016-09-10:
hi

i am searching for a solution, it looks like a problem with the asyncwebserver or spiffs, i tried now without the decoder board and different flash spiff sizes, and also with a new nodemcu clone(same model)  nothing changes, the debug log shows the commands /?list uppreset.... all available, and i can see also that the t.md file is loaded from spiffs, but the index.html will not load.
a first test with a index.html without the script block fails, also.
i have send you my debug log, and i will search further

macmattes, 2016-09-11:
hi

everything is fine with espradio, it works on my cellphone browser. thanks
courios

Edzelf, 2016-09-11:
Take a look at this: https://support.zen.co.uk/kb/Knowledgebase/Changing-the-MTU-size-in-Mac-OS-X-10.6-to-10.9

Verzonden vanaf Samsung-tablet.

-------- Oorspronkelijk bericht --------
Van: macmattes <notifications@github.com>
Datum: 11-09-2016  10:46  (GMT+01:00)
Aan: Edzelf/Esp-radio <Esp-radio@noreply.github.com>
Cc: Ed Smallenburg <ed@smallenburg.nl>, Comment <comment@noreply.github.com>
Onderwerp: Re: [Edzelf/Esp-radio] webserver doesnt work correct (#19)

hi

everything is fine with espradio, it works on my cellphone browser. thanks

courios

—
You are receiving this because you commented.
Reply to this email directly, view it on GitHub, or mute the thread.

{"api_version":"1.0","publisher":{"api_key":"05dde50f1d1a384dd78767c55493e4bb","name":"GitHub"},"entity":{"external_key":"github/Edzelf/Esp-radio","title":"Edzelf/Esp-radio","subtitle":"GitHub repository","main_image_url":"https://cloud.githubusercontent.com/assets/143418/17495839/a5054eac-5d88-11e6-95fc-7290892c7bb5.png","avatar_image_url":"https://cloud.githubusercontent.com/assets/143418/15842166/7c72db34-2c0b-11e6-9aed-b52498112777.png","action":{"name":"Open in GitHub","url":"https://github.com/Edzelf/Esp-radio"}},"updates":{"snippets":[{"icon":"PERSON","message":"@macmattes in #19: hi\r\n\r\neverything is fine with espradio, it works on my cellphone browser. thanks\r\ncourios"}],"action":{"name":"View Issue","url":"https://github.com/Edzelf/Esp-radio/issues/19#issuecomment-246169270"}}}

Closed 2016-09-10.

Thread 21 (2016-09-15):

sound comes out in chunks

tomtobback, 2016-09-15:
Hi, thanks a lot for this excellent project. I almost got it working and maybe you can help me to troubleshoot. I hear very short chunks of music from my VS1053. The webserver test says:
Free memory is 8992, ringbuf 0, stream 0  (is this normal?)
At startup, the Serial monitor reports that the VS1053 is not properly installed, as below.
There seems to be a problem with the reset of the VS1053, if i connect the pull-down resistor to the diodes' output, it stays LOW in permanent reset and i don't get any sound; if i disconnect the pull-down, then i get those sound chunks.
Thanks fro any suggestions- Tom

D: Reset VS1053...
D: End reset VS1053...
D: VS1053 not properly installed!
D: Fast SPI, Testing VS1053 read/write registers again...
D: VS1053 error retry SB:0000 R1:FFFF R2:FFFF
D: VS1053 error retry SB:0003 R1:FFFF R2:FFFF
D: VS1053 error retry SB:0006 R1:FFFF R2:FFFF
D: VS1053 error retry SB:0009 R1:FFFF R2:FFFF
D: VS1053 error retry SB:000C R1:FFFF R2:FFFF
D: VS1053 error retry SB:000F R1:FFFF R2:FFFF
D: VS1053 error retry SB:0012 R1:FFFF R2:FFFF
D: VS1053 error retry SB:0015 R1:FFFF R2:FFFF
D: VS1053 error retry SB:0018 R1:FFFF R2:FFFF
D: VS1053 error retry SB:001B R1:FFFF R2:FFFF
D: VS1053 error retry SB:001E R1:FFFF R2:FFFF
D: VS1053 error retry SB:0021 R1:FFFF R2:FFFF
D: VS1053 error retry SB:0024 R1:FFFF R2:FFFF
D: VS1053 error retry SB:0027 R1:FFFF R2:FFFF
D: VS1053 error retry SB:002A R1:FFFF R2:FFFF
D: VS1053 error retry SB:002D R1:FFFF R2:FFFF
D: VS1053 error retry SB:0030 R1:FFFF R2:FFFF
D: VS1053 error retry SB:0033 R1:FFFF R2:FFFF
D: VS1053 error retry SB:0036 R1:FFFF R2:FFFF
D: VS1053 error retry SB:0039 R1:FFFF R2:FFFF
D: endFillByte is FF
D: * Scan Networks *

Edzelf, 2016-09-15:
It looks like you have the diodes mounted in reverse.
For testing you could do without the reset circuit.
First step is to get rid of the error messages.  Are you sure that the GND of the VS1053 is tightly connected to the GND of the ESP?

While not playing, ringbuf 0, stream 0 is okay (no streem, nothing buffered).
During playing the ringbuf is mostly filled up to 20000 bytes and the stream should also have some bytes in it.

tomtobback, 2016-09-16:
Hi Ed, i got rid of some errors; Slow SPI is working, but the Fast SPI test still fails as below
CPU is set to 160MHz, not sure where the speed issue comes from. the ESP-12 that i am using is quite old, maybe a hardware issue, i'll buy a new one to try. or any other ideas?
Than

D: Reset VS1053...
D: End reset VS1053...
D: Slow SPI,Testing VS1053 read/write registers...
D: Fast SPI, Testing VS1053 read/write registers again...
D: VS1053 error retry SB:07E9 R1:07E9 R2:0000
D: VS1053 error retry SB:13E9 R1:13E9 R2:0000
D: VS1053 error retry SB:17A9 R1:17A9 R2:0000
D: VS1053 error retry SB:1929 R1:1929 R2:0000
D: VS1053 error retry SB:1AA9 R1:1AA9 R2:0000
D: VS1053 error retry SB:1C29 R1:1C29 R2:0000
D: VS1053 error retry SB:1DA9 R1:1DA9 R2:0000
D: VS1053 error retry SB:2FA9 R1:2FA9 R2:0000
D: VS1053 error retry SB:3009 R1:3009 R2:0000
D: VS1053 error retry SB:3069 R1:3069 R2:0000
D: VS1053 error retry SB:37E9 R1:37E9 R2:0000
D: VS1053 error retry SB:38A9 R1:38A9 R2:0000
D: VS1053 error retry SB:3A29 R1:3A29 R2:0000
D: VS1053 error retry SB:3BA9 R1:3BA9 R2:0000
D: VS1053 error retry SB:3EA9 R1:3EA9 R2:0000
D: VS1053 error retry SB:43E9 R1:43E9 R2:0000
D: VS1053 error retry SB:47A9 R1:47A9 R2:0000
D: VS1053 error retry SB:4929 R1:4929 R2:0000
D: VS1053 error retry SB:4AA9 R1:4AA9 R2:0000
D: VS1053 error retry SB:4C29 R1:4C29 R2:0000
D: endFillByte is 0

Edzelf, 2016-09-16:
Looks like an SPI problem.
Did you check the ground connections?
You may try to run the ESP on 80 MHz, change line 1382 to:
system_update_cpu_freq ( 80 ) ; // Set to 80/160 MHz.
You may also try to disconnect the TFT display, it shares the SPI bus and maybe there is something wrong there.

tomtobback, 2016-10-06:
Hi Ed,
It seems i have identified the cause of the problem: the VS1053 i am using is an Arduino shield, with a SD card, and when an SD card is inserted, it interferes with the SPI. As soon as i unplug the SD card, it works without a glitch! I tried pulling the chip select of the SD card high but that does not solve it. Maybe you have any ideas?
Thanks a lot for this great project.

Edzelf, 2016-10-06:
Yes, that makes sense.  Maybe you can find out what GPIO is used for the SD card and then redefine the pins used in the project.
Have you noticed the new version of Esp_radio (with MQTT and new configuration setup)?

tomtobback, 2016-10-07:
hi Ed, all working fine now with the new version, without display, one button on GPIO0 for next station. It seems the next station function does not check for the number of defined stations so it just keeps going up, trying even when there's no presets - is this easy to fix?
Another note; the code as GPIO0 as INPUT_PULLUP so the 10K resistor in the schematics is not necessary, right?
And in the VS1053.begin, the test for slow SPI says 2MHz in the comments but the number is 200,000 so that is rather 200kHz, right?

Edzelf, 2016-10-07:
tomtobback:
1 - Will return to preset 0 now after highest preset.
2 - Pull-up not necessary (but doesn't harm).
3- Slow SPI test is at 200 kHz indeed.

Current version has some loose ends, as I am trying to make uploads more stable and I am busy to support stand-alone mp3 files.

Closed 2016-10-04.

Thread 25 (2016-10-04):

Make AsyncMqttClient.h optional like USETFT

NoNeedForAName123, 2016-10-04:
please add download reference to AsyncMqttClient.h to documentation and make the usage of Mqtt configurable.
see https://github.com/NoNeedForAName123/Esp-radio/blob/master/Esp_radio.ino how it worked for me.

NoNeedForAName123, 2016-10-04:
pls. see https://github.com/NoNeedForAName123/Esp-radio/blob/master/Esp_radio.ino how it worked for me.

Edzelf, 2016-10-05:
If you mean "upload", thats already documented.  You can switch off Mqtt by removing the "mqtt"-lines in the radio.ini file.  I documented the last feature in the new pdf-file.

NoNeedForAName123, 2016-10-05:
Sorry, I mean in the ESP-radio.pdf in the chapter "Arduino IDE installation for Esp-radio" there is the download location for the AsyncMqttClient missing. So even with switching off mqtt in the ini file compilation fails:

`/Esp-radio/Esp-radio.ino:113:29: fatal error: AsyncMqttClient.h: No such file or directory
 #include <AsyncMqttClient.h>

https://github.com/marvinroger/async-mqtt-client
                             ^
compilation terminated.`

Edzelf, 2016-10-11:
Fixed.

Closed 2016-10-11.

Thread 28 (2016-10-11):

power supply

tomtobback, 2016-10-11:
Hi Ed, thanks again for this wonderful project, working well now.
Some notes that might be of interest; when i tried to power both ESP and amp (small 5V stereo class D amp) from the same 5V, i found out that the VS1053 audio output is DC biased to 1.25V, which seems to be the case on most boards. There's an application note explaining how to get rid of the bias (blocking caps etc), but that still had a lot of noise probably due to the shared power supply (or the breadboard setup). So i also opted for 2 separate power supplies, and the sound is very clean.
I like the switch circuit in your PDF but i was wondering if this is not a little dangerous, to charge 2 lithium cells at the same time, with 1 charger which cannot know the state of both cells. Additionally, when you switch your radio off, the (presumably) fully charged batt1 is directly connected to the less than fully charged batt2, which i think can lead to high currents, potentially dangerous if your lithium cells do not each have protection circuits.
The ESP seems to need more than 100mA constantly, just out of interest, how many hours do you get out of your battery approximately?
As above is not really an issue, feel free to close it.

Edzelf, 2016-10-11:
Thank you for your feedback.  You are right.  The current may be very high.  For simplicity I think might be sufficient to add a current limiting resistor, like 5.6 ohms, to the load line of "battery 2".  An extra charger would also do the trick as well as using cells with protection circuits.
I cannot tell how long the radio runs on batteries.  Normally it is connected to a power adapter, so it will be charged when I switch of to "off".  In the "On" state, only the battery for the amplifier is discharged (26 mA).  The current for the ESP8266 plus the VS1053 is 135 mA, so it should work for about 15 hours.
Have you tried my new version?  It now can play standalone MP3s as well.

tomtobback, 2016-10-15:
Hi Ed, i was a bit confused, you mean mp3 files on another server, right?
for a moment i thought we could upload mp3 files to the ESP, at the bottom of the config screen, but i guess that's not what this upload is intended for?

Edzelf, 2016-10-15:
Esp-radio will play mp3 file that are placed on a remote server.  You can however upload any file to the ESP, it was meant to make changes to the html files.  I do have a version that is capable of playing from SPIFFS by specifying "localhost" as the server in the station, but since the SPIFFS can only store 3 MB it is not very useful.
The SPIFFS is not very stable.  I noticed that reading from a file is very slow sometimes.
However, my TFT has an on-board "MicroSD Card Breakout".  Do you think it's worthwhile to have this implemented?

tomtobback, 2016-11-16:
Hi Ed, it took me a while to finish this project, it's working very well now. to answer your question, personally i'm not too interested in playing music from SD card so wouldn't vote for that.
it's very functional for me the way it is now.
i've posted some pics on my blog if you'd like to see my build: http://cassiopeia.hk/internetradio/

Edzelf, 2017-01-31:
Finally saw your blog.
Nice box and nice story too!

Closed 2017-02-22.

Thread 29 (2016-10-14):

Problem with library AsyncMqttClient

Lubosno, 2016-10-14:
Thank you for super project.
New version i can not compile.
I have error  in line 1566  mqttclient.onConnect ( onMqttConnect ) ;
Please advice and help
Lubosno from Czech rep.

This is my error report:
> Arduino: 1.6.8 (Windows XP), Vývojová deska: "Generic ESP8266 Module, 160 MHz, 80MHz, DIO, >115200, 4M (1M SPIFFS), ck, Disabled, None"

> C:\Documents and Settings\sklad\Dokumenty\Arduino\Esp-radio-master (1)\Esp-radio-master\Esp->radio-master.ino: In function 'void setup()':

>Esp-radio-master:1566: error: no matching function for call to 'AsyncMqttClient::onConnect(void (&)())'
>       mqttclient.onConnect ( onMqttConnect ) ;

>C:\Documents and Settings\sklad\Dokumenty\Arduino\Esp-radio-master (1)\Esp-radio-master\Esp->radio-master.ino:1566:44: note: candidate is:

>In file included from C:\Documents and Settings\sklad\Dokumenty\Arduino\libraries\async-mqtt-client->master\src/AsyncMqttClient.h:4:0,

> from C:\Documents and Settings\sklad\Dokumenty\Arduino\Esp-radio-master (1)\Esp-radio->master\Esp-radio-master.ino:116:

>C:\Documents and Settings\sklad\Dokumenty\Arduino\libraries\async-mqtt-client->master\src/AsyncMqttClient.hpp:43:20: note: AsyncMqttClient& >AsyncMqttClient::onConnect(AsyncMqttClientInternals::OnConnectUserCallback)
 >  AsyncMqttClient& onConnect(AsyncMqttClientInternals::OnConnectUserCallback callback);
>C:\Documents and Settings\sklad\Dokumenty\Arduino\libraries\async-mqtt-client->master\src/AsyncMqttClient.hpp:43:20: note:   no known conversion for argument 1 from 'void()' to >'AsyncMqttClientInternals::OnConnectUserCallback {aka std::function<void(bool)>}'
>exit status 1
>no matching function for call to 'AsyncMqttClient::onConnect(void (&)())'

Edzelf, 2016-10-14:
Looks like you have the wrong library for MQTT.  This project uses "AsyncMqttClient by Marvin Roger Version 0.3.0".  See https://github.com/marvinroger/async-mqtt-client.

This is a list of the libraries used (at the end of the compiler logging:
ESP8266WiFi op versie 1.0 in map: \AppData\Local\Arduino15\packages\esp8266\hardware\esp8266\2.3.0\libraries\ESP8266WiFi
ESPAsyncTCP-master op versie 1.0.0 in map: \Arduino\libraries\ESPAsyncTCP-master
ESPAsyncWebServer-master op versie 1.0.0 in map: \Arduino\libraries\ESPAsyncWebServer-master
async-mqtt-client-master op versie 0.3.0 in map: \Arduino\libraries\async-mqtt-client-master
SPI op versie 1.0 in map: \AppData\Local\Arduino15\packages\esp8266\hardware\esp8266\2.3.0\libraries\SPI
Adafruit_GFX_Library op versie 1.1.5 in map: \Arduino\libraries\Adafruit_GFX_Library
TFT_ILI9163C-master op versie 0.9 in map: \Arduino\libraries\TFT_ILI9163C-master
Ticker op versie 1.0 in map: \Arduino15\packages\esp8266\hardware\esp8266\2.3.0\libraries\Ticker
ArduinoOTA op versie 1.0 in map: \Arduino15\packages\esp8266\hardware\esp8266\2.3.0\libraries\ArduinoOTA
Hash op versie 1.0 in map: \Arduino15\packages\esp8266\hardware\esp8266\2.3.0\libraries\Hash
ESP8266mDNS in map: \Arduino15\packages\esp8266\hardware\esp8266\2.3.0\libraries\ESP8266mDNS (legacy)

Lubosno, 2016-10-14:
Hallo, i have lastes version from internet 0.5.0

This is my log

> async-mqtt-client-master ve verzi 0.5.0 v adresáři: C:\Documents and Settings\sklad\Dokumenty\Arduino\libraries\async-mqtt-client-master

the others library are the same

Thank

Edzelf, 2016-10-14:
I updated the code for using 0.5.0 version of the library.

Closed 2016-10-14.

Thread 30 (2016-10-14):

Support for m3u URLs

larbigj, 2016-10-14:
Please add support for m3u URLs

karawin, 2016-10-14:
and xspf and pls to be complete ;-)
Nice project.

Edzelf, 2016-10-14:
Hmm, I will look into that.

larbigj, 2016-10-24:
mp3: http://www.rockantenne.de/webradio/rockantenne.m3u

aac: http://www.rockantenne.de/webradio/rockantenne.aac.pls

Edzelf, 2016-11-15:
m3u playlists are now supported.

Closed 2016-12-07.

Thread 31 (2016-10-22):

function "muteflag" not working  and Configuration file cannot be edited through web interface.

pasagame, 2016-10-22:
1. function "muteflag" not working, i test by MQTT (mute, unmute) no effect.
2. Configuration file can not be edited or upload through web interface. if have edit or uploading files "Radio.ini"  from the Web server some data on file is lost and espradio cannot working. Be solved by upload via "ESP8266 Sketch Data Upload" on arduino ide only then will work properly.

http://www.mx7.com/view2/zr9d6GpCasnkljmj

Edzelf, 2016-10-22:
1. mute/unmute works now.
2. Sometimes uploads are damaged.  It looks like there is a problem in the SPIFFS library.

pasagame, 2016-10-23:
now i test function mute/unmute not work.

Edzelf, 2016-10-23:
Did you rebuild the project?
Check line 111 in your sketch.  It should read "#define VERSION "22-oct-2016".
I tested it in the webinterface:
http://192.168.2.12/?mute
http://192.168.2.12/?unmute

pasagame, 2016-10-23:
thank you, i update to lastest version. mute function working proberly.

Closed 2016-10-23.

Thread 32 (2016-10-22):

Reset connection in schematic different from wiring diagram

harmverbeek, 2016-10-22:
In the schematic the RST pin of the ESP12 seems to be connected to +5V(!) and the RST pin of the LCD.
In the wiring table it is supposed to connect to the RST pins of both LCD and VS1053.

What is the right way?

Edzelf, 2016-10-22:
Harm,
The drawing was not correct.  I 've uploaded a new one.  The reset of the ESP is pulled high by a resistor on the mounting board.  The reset of the TFT and the VS1053 is done by the reset circuit (2 diodes and a resistor): when GPIO5 and GPIO16 are both low, the reset pins go low.

68erDirk, 2016-11-13:
What is the purpose of the reset circuit? I left it away completely and only connected everything as described under "wiring"? Everything seems to work well.

snazzware, 2017-03-21:
FYI, I recently loaded up this project on a Wemos D1 mini, and just wired the Reset pin of the VS1053 board to the D1's reset pin. Worked like a charm!

Edzelf, 2017-03-24:
snazzware: thats fine.  But this pin is not programmable, so the VS1053 will not be reset on powerup.  This reset, however, seems to be not necessary in practice.  So all will work correctly, even if you connect the reset pin of the VS1053 to +5 Volt.

Thread 33 (2016-10-27):

TFT display not working

pasagame, 2016-10-27:
I use a 1.8 TFT, but it does not work. I used standalone. (Test code), works properly. please look picture this link http://www.mx7.com/view2/zrLdZLyC7TSCjbPc

standalone (test code)
# include <Adafruit_GFX.h>  //Adafruit_GFX.h
# include <TFT_ILI9163C.h>  //TFT_ILI9163C.h
# include <SPI.h>  //SPI.h

// Color definitions for the TFT screen (if used)
# define  BLACK   0x0000
# define BLUE    0xF800
# define RED     0x001F
# define GREEN   0x07E0
# define CYAN    GREEN | BLUE
# define MAGENTA RED | BLUE
# define YELLOW  RED | GREEN
# define WHITE   0xFFFF
# define TFT_CS 15
# define TFT_DC 2

TFT_ILI9163C     tft = TFT_ILI9163C ( TFT_CS, TFT_DC ) ;

void setup() {
  SPI.begin() ;
  tft.begin() ;                                      // Init TFT interface
  tft.fillRect ( 0, 0, 160, 128, BLACK ) ;           // Clear screen does not work when rotated
  tft.setRotation ( 3 ) ;                            // Use landscape format
  tft.clearScreen() ;                                // Clear screen
  tft.setTextSize ( 1 ) ;                            // Small character font
  tft.setTextColor ( WHITE ) ;
  tft.println ( "Starting" ) ;

}

void loop(){
  //
}

Edzelf, 2016-10-27:
At the moment I have no possibility to look at the code.  If it works stand-alone, try to disconnect the VS1053 and the resetlines.
Verzonden vanaf Samsung-tablet.

-------- Oorspronkelijk bericht --------
Van: pasagame <notifications@github.com>
Datum: 27-10-16  10:58  (GMT+01:00)
Aan: Edzelf/Esp-radio <Esp-radio@noreply.github.com>
Onderwerp: [PossibleSpam] [Edzelf/Esp-radio] TFT display not working (#33)

I use a 1.8 TFT, but it does not work. I used standalone. (Test code), works properly. please look picture this link http://www.mx7.com/view2/zrLdZLyC7TSCjbPc

standalone (test code)

#include

#include

#include

// Color definitions for the TFT screen (if used)

#define  BLACK   0x0000

#define BLUE    0xF800

#define RED     0x001F

#define GREEN   0x07E0

#define CYAN    GREEN | BLUE

#define MAGENTA RED | BLUE

#define YELLOW  RED | GREEN

#define WHITE   0xFFFF

#define TFT_CS 15

#define TFT_DC 2

TFT_ILI9163C     tft = TFT_ILI9163C ( TFT_CS, TFT_DC ) ;

void setup() {

  SPI.begin() ;

  tft.begin() ;                                      // Init TFT interface

  tft.fillRect ( 0, 0, 160, 128, BLACK ) ;           // Clear screen does not work when rotated

  tft.setRotation ( 3 ) ;                            // Use landscape format

  tft.clearScreen() ;                                // Clear screen

  tft.setTextSize ( 1 ) ;                            // Small character font

  tft.setTextColor ( WHITE ) ;

  tft.println ( "Starting" ) ;

}

void loop(){

//

}

—
You are receiving this because you are subscribed to this thread.
Reply to this email directly, view it on GitHub, or mute the thread.

{"api_version":"1.0","publisher":{"api_key":"05dde50f1d1a384dd78767c55493e4bb","name":"GitHub"},"entity":{"external_key":"github/Edzelf/Esp-radio","title":"Edzelf/Esp-radio","subtitle":"GitHub repository","main_image_url":"https://cloud.githubusercontent.com/assets/143418/17495839/a5054eac-5d88-11e6-95fc-7290892c7bb5.png","avatar_image_url":"https://cloud.githubusercontent.com/assets/143418/15842166/7c72db34-2c0b-11e6-9aed-b52498112777.png","action":{"name":"Open in GitHub","url":"https://github.com/Edzelf/Esp-radio"}},"updates":{"snippets":[{"icon":"DESCRIPTION","message":"TFT display not working (#33)"}],"action":{"name":"View Issue","url":"https://github.com/Edzelf/Esp-radio/issues/33"}}}

pasagame, 2017-09-17:
until now i cannot use tft display.

Closed 2017-01-31.

Thread 34 (2016-10-31):

% simbol in wifi passw

jammoyano, 2016-10-31:
If wifi passw uses % can't connect to SSID

jammoyano, 2016-11-08:
Partially solved. Just insert wifi passw on code.

Closed 2016-11-08.

Thread 36 (2016-11-02):

ESP Record voice by vs1053

etoshey, 2016-11-02:
Hello,
According to your shematic, i have an wierd esp wroom and vs1053 mudule (geeethec) , then use your esp radio code (that is great and useful source code) , it works fine.
You wrote a comment on your code about start up modules in midi mode , i have to change PGIO DDR and ODATA for record voice?
I am trying to record voice  but i have a problem . Dreq pin gone low when start to record.
At the first, in my code :
cs pin ==> HIGH
dcs pin==> HIGH
dreq pin define as an INPUT
SPISettings => 250000, MSBFIRST, SPI_MODE0
and then soft reset (SCI_MODE= SM_SDINEW | SM_RESET)
Now, SCI_STATUS register equals 72 (0010 1010). Sine Test is OK,
record initiation :
SCI_CLOCKF = 0xC000 // set max clock
wait for rising DREQ pin
SCI_BASS = 0 // clear Bass
SCI_MODE= SM_SDINEW | SM_RESET // soft reset
wait for rising DREQ pin
SCI_WRAMADDR =0xC01A
SCI_WRAM = 0x02
SCI_AICTRL0= 1024
SCI_AICTRL1= 1024
SCI_AICTRL2= 0
SCI_AICTRL3= 0;
loadPlugin...
Active
SCI_MODE = SM_ADPCM | SM_SDINEW
SCI_AIADDR = 0x34
wait for rising DREQ pin ==> INFINITY LOOP, because the DREQ pin stay down.

I can not find my mistake , If is possible guide me, Thanks

Edzelf, 2016-11-15:
I did some experimenting with recording (ogg-format).  Not with the best results....  You can examine my code on http://smallenburg.nl/Ogg-encoder.zip.
Note that you have to supply a file for your WiFi SSID containing the password, for example SSID.pw.

fredericplante, 2016-12-13:
At line 18, you specifies "Pin to program". What does that mean? What is hooked on those pins?

Edzelf, 2016-12-14:
It is the pinnumber that you use in the sketch to address the pin.  Note the issue I mentioned at the top of the Ogg-encoder sketch: "Sometimes the conversion will not start"....
GPIO[0] and GPIO[1] are being set to LOW in the sketch.

fredericplante, 2016-12-14:
So it basically, it's the same pin out then the Radio-player, except for Xrst that is set to pin 3, instead of the reset pin of the ESP8266.

Edzelf, 2016-12-14:
Could be, this is a different project, so the pin configuration and software will differ.

fredericplante, 2016-12-21:
Before I buy another VS1053, tel me will this broadcaster project, the zip file you just sent, and the radio project connect and play along together?

Edzelf, 2016-12-21:
Yes, I had it working for a while.  But it was not very reliable.  I think it will be a challenge to get it working.

fredericplante, 2016-12-21:
Well ok then, it will be part of my late xMass shopping. Thank you Ed

Closed 2016-11-15.

Thread 37 (2016-11-08):

Panic & reboot

jammoyano, 2016-11-08:
It's unable to play or use the radio .... just reboot after reboot.

Here is the serial monitor ... ¿any idea?

`D: /config.html                     -   3817
D: /favicon.ico                     -    766
D: /index.html                      -   6769
D: /radio.ini                       -    538
D: Added SSID 00 = Wlan_99d5_2 to acceptable networks
D: * Scan Networks *
D: Number of available networks: 7
D:  1 - ONO_2016                  Signal: -87 dBm Encryption Auto
D:  2 - _AUTO_ONOWiFi             Signal: -86 dBm Encryption None
D:  3 - Orange-5F28               Signal: -89 dBm Encryption Auto
D:  4 - Ptv Maria Jose            Signal: -91 dBm Encryption Auto
D:  5 - MOVISTAR_B888             Signal: -93 dBm Encryption WPA
D:  6 - Wlan_99d5_2               Signal: -82 dBm Encryption WPA2  Acceptable
D:  7 - Ptv_4729_2                Signal: -83 dBm Encryption WPA2
D: --------------------------------------
D: Command: mqttbroker with parameter broker.hivemq.com
D: Command: mqttport with parameter 1883
D: Command: mqttuser with parameter none
D: Command: mqttpasswd with parameter none
D: Command: mqtttopic with parameter espradio
D: Command: mqttpubtopic with parameter espradioIP
D: Command: wifi_00 with parameter Wlan_99d5_2/xxxxxxx
D: Starting ESP Version 22-oct-2016...  Free memory 16880
D: Sketch size 321056, free size 724992
D: Reset VS1053...
D: End reset VS1053...
D: Slow SPI,Testing VS1053 read/write registers...
D: Fast SPI, Testing VS1053 read/write registers again...
D: endFillByte is 0
D: Selected network: Wlan_99d5_2      
D: Try WiFi Wlan_99d5_2
D: IP = 10.0.0.70
D: Start server for commands
D: list request from browser

Panic C:\Users\Jose\AppData\Local\Arduino15\packages\esp8266\hardware\esp8266\2.3.0\cores\esp8266\core_esp8266_main.cpp:98 __yield

ctx: sys
sp: 3ffff840 end: 3fffffb0 offset: 01b0

>>>stack>>>
3ffff9f0:  3fff7ac8 00000007 3ffffa40 40216b35
3ffffa00:  0000000a 3ffffa58 3ffffa40 402153a5
3ffffa10:  3ffe0070 0000021a 3ffffa58 4021434d
3ffffa20:  3ffe8be0 3fff865c 3ffffa40 402143db
3ffffa30:  00000000 3fff865c 3fff8bc4 4020858e
3ffffa40:  3fff8ac4 0000001f 0000001e 40214139
3ffffa50:  00000000 00000000 3ffea0d8 00000000
3ffffa60:  000003e8 00003b60 3fff921c 3fff8b94
3ffffa70:  3ffe90fc 3fff0ad4 3fff0298 3fff925c
3ffffa80:  0000005f 0000005a 3fff9314 0000005f
3ffffa90:  0000005a 3fff87ec 0000000f 0000000a
3ffffaa0:  3fff8ac0 3fff2bcc 3fff865c 00003b56
3ffffab0:  00000002 00000001 3fff865c 40209715
3ffffac0:  00000000 00000000 00000000 3fff0aac
3ffffad0:  00000010 3ffffb60 3ffea0d8 00000000
3ffffae0:  000003e8 3ffffb98 00000000 00000000
3ffffaf0:  00000010 3ffffb80 00000000 3fff2abc
3ffffb00:  0000000f 00000001 3fff2bcc 0000000f
3ffffb10:  00000004 00000003 3ffffb60 00000000
3ffffb20:  00000000 3ffffb80 3ffffb80 4021490c
3ffffb30:  3ffe8ca0 00000000 3ffffb80 00000002
3ffffb40:  00000002 3fff865c 3fff865c 40216288
3ffffb50:  3fff8670 3fff8804 3ffffb80 4020eb69
3ffffb60:  3ffe8ca0 3fff8804 3fff8670 402148ac
3ffffb70:  3fff8670 3fff292c 3fff8670 40214b2d
3ffffb80:  00000000 3ffeb9c0 3fff865c 4020d000
3ffffb90:  00000002 3ffeb9c0 3fff8670 40214b90
3ffffba0:  3ffeb9c0 00000000 00000000 00000002
3ffffbb0:  00000002 3ffeb9c0 3fff865c 4020d3f6
3ffffbc0:  3fff8670 3fff292c 3fff8670 00000018
3ffffbd0:  0000001a 3ffeb9a8 3fff865c 4020d036
3ffffbe0:  3fff8670 3ffeb9a8 3fff8670 40214b90
3ffffbf0:  3ffeb9a8 00000000 00000000 00000018
3ffffc00:  0000001a 3ffeb9a8 3fff865c 4020d228
3ffffc10:  3fff8670 3fff292c 3fff8670 0000001c
3ffffc20:  00000036 3ffeb98c 3fff865c 4020d036
3ffffc30:  3fff8670 3ffeb98c 3fff8670 40214b90
3ffffc40:  3ffeb98c 00000000 00000000 0000001c
3ffffc50:  00000036 3ffeb98c 3fff865c 4020d228
3ffffc60:  3fff8670 3fff292c 3fff8670 00000020
3ffffc70:  00000056 3ffeb96c 3fff865c 4020d036
3ffffc80:  3fff8670 3ffeb96c 3fff8670 40214b90
3ffffc90:  3ffeb96c 00000000 00000000 00000020
3ffffca0:  00000056 3ffeb96c 3fff865c 4020d228
3ffffcb0:  3fff8670 3fff292c 3fff8670 00000036
3ffffcc0:  0000008c 3ffeb936 3fff865c 4020d036
3ffffcd0:  3fff8670 3ffeb936 3fff8670 40214b90
3ffffce0:  3ffeb936 00000000 00000000 00000036
3ffffcf0:  0000008c 3ffeb936 3fff865c 4020d228
3ffffd00:  3fff8670 3fff292c 3fff8670 00000049
3ffffd10:  000000d5 3ffeb8ed 3fff865c 4020d036
3ffffd20:  3fff8670 3ffeb8ed 3fff8670 40214b90
3ffffd30:  3ffeb8ed 00000000 00000000 00000049
3ffffd40:  000000d5 3ffeb8ed 3fff865c 4020d228
3ffffd50:  3fff8670 00000001 3fff8670 00000057
3ffffd60:  0000012c 3ffeb896 3fff865c 4020d036
3ffffd70:  3fff8670 3ffeb896 3fff8670 40214b90
3ffffd80:  3ffeb896 00000000 00000000 00000057
3ffffd90:  0000012c 3ffeb896 3fff865c 4020d228
3ffffda0:  3ffe8ca0 3fff8670 3fff8670 00000011
3ffffdb0:  0000013d 3ffeb885 3fff865c 4020d036
3ffffdc0:  3fff8670 3ffeb885 3fff8670 40214b90
3ffffdd0:  3ffeb885 00000000 00000000 00000011
3ffffde0:  0000013d 3ffeb885 3fff865c 4020d228
3ffffdf0:  00000002 40100fab 3fff8670 00000033
3ffffe00:  00000170 3ffeb852 3fff865c 4020cfa9
3ffffe10:  3fff8670 3ffeb852 3fff8670 40214b90
3ffffe20:  3ffeb852 3ffee370 3ffffe70 00000033
3ffffe30:  00000170 3ffeb852 3fff865c 4020d228
3ffffe40:  3ffeb16c 00000000 00000000 4010068c
3ffffe50:  00000000 00e7c449 4010292a 00000100
3ffffe60:  3fff8670 3ffeb16c 3ffeb16c 00000001
3ffffe70:  00000001 00007fff 000000d6 3fff2b60
3ffffe80:  00000001 3fff2a8c 3fff2b0c 4020d421
3ffffe90:  3fffc278 401026c4 3fff2b0c 4020b50c
3ffffea0:  3fff85a4 3fff07d8 3fff85a4 402350d1
3ffffeb0:  3fff23c4 3fff23d0 00000006 3fff21d8
3ffffec0:  3fff85a4 3fff21e0 3fff21dc 4020b55f
3ffffed0:  3fff85a4 3fff21e0 3fff21dc 4023a84c
3ffffee0:  00000170 4600000a 00000018 00000170
3ffffef0:  00000018 00000000 3fff2c8c 40106d84
3fffff00:  00000000 00000000 3ffeb84a 3fff23c8
3fffff10:  3ffeb82a 3fff23d0 3fff2a8c 40238d45
3fffff20:  3fff2104 3fff2c44 3fff2c44 3ffef490
3fffff30:  00000000 3fff2a8c 0000001c 3fff2c44
3fffff40:  3ffeb81c 00000000 3fff2a8c 40238141
3fffff50:  0700000a 000001ce 00000000 00000014
3fffff60:  00000002 0000001a 40218b8b 3ffee370
3fffff70:  3ffeb7f4 3fffdcc0 3ffea9c0 3ffea9c0
3fffff80:  40218afe 3ffee370 00000000 3fff2c94
3fffff90:  3fffdc80 00000000 3fff2a8c 4022cbcf
3fffffa0:  40000f49 3fffdab0 3fffdab0 40000f49
<<<stack<<<

 ets Jan  8 2013,rst cause:2, boot mode:(3,7)

load 0x4010f000, len 1384, room 16
tail 8
chksum 0x2d
csum 0x2d
v3de0c112
~ld
…CáD: FS Total 2949250, used 14056
`

Edzelf, 2016-11-15:
I think that in an asynchronous part of the code (the webserver) a  "yield" or "delay" is executed.  That is not allowed.  Does the radio works if you do not connect to the webserver?

Pavulon87, 2016-11-24:
Got the same problem. It is caused by lauching "list" command.
It happens when **radio.ini** is not ended with new line character.
In `readinifile()` function:
`line = inifile.readStringUntil ( '\n' ) ;`

Pavulon87, 2016-11-24:
Quick workaround:

`
void getpresets ( AsyncWebServerRequest *request )
{
  String              path ;                           // Full file spec as string
  File                inifile ;                        // File containing URL with mp3
  String              line ;                           // Input line from .ini file
  String              linelc ;                         // Same, but lowercase
  int                 inx ;                            // Position of search char in line
  int                 i ;                              // Loop control
  AsyncResponseStream *response ;                      // Response to client

  response = request->beginResponseStream ( "text/plain" ) ;
  path = String ( INIFILENAME ) ;                      // Form full path
  inifile = SPIFFS.open ( path, "r" ) ;                // Open the file

  if ( inifile )
  {
    int fileSize = inifile.size();
    int readBytes = 0;
    char c[1];

    while ( inifile.available() && readBytes < fileSize  )
    {
      line = "";
      while ( readBytes < fileSize && inifile.readBytes(c, 1) )
      {
        readBytes++;

        if ( c[0] == '\n' )
        {
          break;
        }

        line += c[0];
      }

      //line = inifile.readStringUntil ( '\n' ) ;        // Read next line
      linelc = line ;                                  // Copy for lowercase
      linelc.toLowerCase() ;                           // Set to lowercase
      if ( linelc.startsWith ( "preset_" ) )           // Found the key?
      {
        i = linelc.substring(7, 9).toInt() ;           // Get index 00..99
        inx = line.indexOf ( "#" ) ;                   // Get position of "#"
        if ( inx > 0 )                                 // Equal sign present?
        {
          line.remove ( 0, inx + 1 ) ;                 // Yes, remove non-comment part
        }
        else
        {
          inx = line.indexOf ( "=" ) ;                 // Get position of "="
          line.remove ( 0, inx + 1 ) ;                 // Yes, remove first part of line
        }
        line = chomp ( line ) ;                        // Remove garbage
        response->printf ( "%02d%s|", i,
                           line.c_str() ) ;            // 2 digits plus description
      }
    }
    inifile.close() ;                                  // Close the file
  }

  request->send ( response ) ;
}
`

jammoyano, 2017-02-12:
Hi guys,

Sorry for too long answer, but I've several "questions" to solve (including moved to another city)
I've just try the new web interface by @Sander0542 (https://github.com/Edzelf/Esp-radio/issues/52) and seems to be solved ... but It still in "surveillance mode"

Thanks.

Closed 2017-02-12.

Thread 38 (2016-11-13):

Slightly changed config.html

68erDirk, 2016-11-13:
I added a "back" button to the config.html which now leads back to the index.html. See attached file (rename to "config.html")
[config.txt](https://github.com/Edzelf/Esp-radio/files/587710/config.txt)
and use this if you like.

68erDirk, 2016-11-13:
Managed to fork and piull request. PLease see there.

Closed 2016-11-13.

Thread 39 (2016-11-13):

This is an updated Version with additional features

68erDirk, 2016-11-13:
[Esp_radio.txt](https://github.com/Edzelf/Esp-radio/files/587877/Esp_radio.txt)

This is an updated version. I didn't manage to fork from the source, so I just renamed and uploaded the new file. Please check and feel free to integrate the code into your codebase.

New Features for TFT-Version with one button are:
- Long button press (between 300 ms and 2 secs) go back one channel
- Wrap channel up and down (so back form preset zero goes to last preset)
- Long press (>2 secs) mutes, every press afterwards unmutes the sound.

68erDirk, 2016-11-13:
Finally managed to fork and pull request, please see there

Closed 2016-11-13.

Thread 41 (2016-11-15):

Way to gain extra pins

fredericplante, 2016-11-15:
Has any one consider introducing a PCF8574 chip to handle all the control lines? The chip even has an interrupt pin so the handling of DREQ on the vs1053 would be fairly générique. I might give it a look this weekend, cause you seam to use 5 pins +2 for reset where you only need 3

Have a good one you all :D

Edzelf, 2016-11-15:
I did some experimenting with a simple 74HC595.  With this shiftregister connected to the SPI-bus you can control 8 output lines including:
VS1053: Reset, DCS and CS
TFT:  Reset, D/C and CS
The rest of the outputs may be used  to drive some informative LEDs.

fredericplante, 2016-11-15:
The problem with 595 is that they use an cs line of it's own. while the pcf8574 only use 2, the extra one is to probe interruption, if you want it. otherwise you can drop the int line and check the I2C when you feel it need it.

Many people don't like the I2C for many reason, the fact is that it's no good for heavy stream of data. But it's the best to handle small stuff, like doing an interrupt contrôler, keyboard, status led, and other simple data.

68erDirk, 2016-11-15:
Why don't you spent a bit more than 2 Euros and buy an arduino pro mini or nano? The ka-radio project uses an arduino nano just connected by the TX Wire, VCC and GND to connect to a display. It gives a lot of additional possibilities like easily using a remote control.

fredericplante, 2016-11-15:
Bravo 68erDirk, your project also rock :)

68erDirk, 2016-11-15:
it's not my project, it is karawin's project. I just built both since I wanted to find out the differences. I like both. Ka-radio has the advantage of downloading new versions via OTA and it has a nicer web interface. The new idea of an additional idea seems promising for add-ons. Your project is great since it is very minimalistic (display without additional chip), so I built it into a very small case of about 4x5x3 cm size! I prfer the Arduino IDE since I have some experience with it and it was not necessary to create a different ide. So I was able to create an addon (see my fork with pull request) to use the single button for three features (Fwd, Back an d mute). I would like to contribute more features to your project, so if you have some ideas, feel free to ask me for help.

fredericplante, 2016-11-15:
The next step, I guess, is to plug all that on the TVOut project

Closed 2016-12-12.

Thread 42 (2016-11-23):

App

Sander0542, 2016-11-23:
Hello,

This is not an issue, but i'am making an app and I was wondering if I have to use the buttons or can use some urls like <ip>/index.html?<parameter>=<value>
Is this possible, because I dont have the radio right now.

Kinds Regards,
Sander Jochems

Edzelf, 2016-11-24:
Sander,
Yes, you can control the radio through the web-interface.  That's the way I use it: no buttons.  You may also control it by MTTQ commands or through the serial interface, although the last option is probably not suitable in combination with an app.

Regards,
Ed.

Sander0542, 2016-11-24:
Thanks,

Could you please give me an list of all the url parameters so i can make as much as possible in the app

Kind Regards,
Sander Jochems

Edzelf, 2016-11-25:
It is documented in the pdf-file.

Sander0542, 2016-11-26:
In the PDF is see ?parameter=value but i can get anymore out

I have this:
?uppreset=1
?downpreset=1
?upvolume=2
?downvolume=2

Sander0542, 2016-11-26:
Is there a way to add a station without entering a number or can I look what the latest number is?

Sander0542, 2016-12-01:
If you want to take a look on what I have now visit [this site](http://www.sanderjochems.nl/projects/2). Any ideas or tips are welcome.

Sander0542, 2016-12-06:
I have added a download link on the site, if you want to try it your welcome to do. if you find any bug could you please tell them.

Edzelf, 2016-12-07:
I used in the software the settings according to the datasheet:
- ST AMPLITUDE bits 15:12 Treble Control in 1.5 dB steps (-8..7, 0 = off)
- ST FREQLIMIT bits 11:8 Lower limit frequency in 1000 Hz steps (1..15)
- SB AMPLITUDE bits 7:4 Bass Enhancement in 1 dB steps (0..15, 0 = off)
- SB FREQLIMIT bits 3:0 Lower limit frequency in 10 Hz steps (2..15)

Although 4 bits are reserved for the 4 settings, not all 16 values are meaningful.  The select buttons in index.html are used to limit the settings to acceptable values (14 to 16 options per function, never 17).

GabeHC, 2017-01-20:
preset station not working which has Chinese characters in it's name.
help please!

Edzelf, 2017-01-20:
Example please.

Verzonden vanaf Samsung-tablet.

-------- Oorspronkelijk bericht --------
Van: Gabriel Huang <notifications@github.com>
Datum: 20-01-17  17:29  (GMT+01:00)
Aan: Edzelf/Esp-radio <Esp-radio@noreply.github.com>
Cc: Ed Smallenburg <ed@smallenburg.nl>, Comment <comment@noreply.github.com>
Onderwerp: Re: [Edzelf/Esp-radio] App (#42)

preset station not working which has Chinese characters in it's name.

help please!

—
You are receiving this because you commented.
Reply to this email directly, view it on GitHub, or mute the thread.

{"api_version":"1.0","publisher":{"api_key":"05dde50f1d1a384dd78767c55493e4bb","name":"GitHub"},"entity":{"external_key":"github/Edzelf/Esp-radio","title":"Edzelf/Esp-radio","subtitle":"GitHub repository","main_image_url":"https://cloud.githubusercontent.com/assets/143418/17495839/a5054eac-5d88-11e6-95fc-7290892c7bb5.png","avatar_image_url":"https://cloud.githubusercontent.com/assets/143418/15842166/7c72db34-2c0b-11e6-9aed-b52498112777.png","action":{"name":"Open in GitHub","url":"https://github.com/Edzelf/Esp-radio"}},"updates":{"snippets":[{"icon":"PERSON","message":"@GabeHC in #42:  preset station not working which has Chinese characters in it's name. \r\nhelp please!"}],"action":{"name":"View Issue","url":"https://github.com/Edzelf/Esp-radio/issues/42#issuecomment-274115497"}}}

Sander0542, 2017-01-20:
Maybe the characters are not supported by the app, if you send an example i can test it and fix this bug.

GabeHC, 2017-01-21:
I am using Lenovo YOGA tablet. my radio.ini is [Here](https://dl.dropboxusercontent.com/u/23181672/radio.ini)

Sander0542, 2017-01-21:
Hello,

There was a bug in the app with preset numbers, if you update the app then I guess it is fixed.

Regards,
Sander

GabeHC, 2017-01-21:
did you update download link in your project?
try to update several times, still V 1.3.4

Sander0542, 2017-01-21:
I'll reupload the file

Sander0542, 2017-03-28:
The App is now uploaded to Google Play --> [](https://play.google.com/store/apps/details?id=com.thunkable.android.sander542jochems.ESP_Radio)

Its also updated on the about page.

Sander0542, 2017-04-06:
If anyone has good ideas for the app, just say it to me and I may can add it!

Thread 44 (2016-12-03):

Version without VS1053

probonopd, 2016-12-03:
Is is also possible to run this without the VS1053 as described [here](https://github.com/espressif/ESP8266_MP3_DECODER#running-without-the-i2s-dac)? This would shorten the long waiting time for the China module to arrive...

probonopd, 2016-12-03:
Similarly, I am wondering whether a "[Audio AUX WITH IR Remote Control MP3+WAV+WMA Decoder Board 2W Amplifier TF Card](http://www.ebay.com/itm/Audio-AUX-WITH-IR-Remote-Control-MP3-WAV-WMA-Decoder-Board-2W-Amplifier-TF-Card/131851346950)" could somehow be hooked up to the ESP. For 5 USD this not only includes a MP3 decoder, but also an infrared remote sender and receiver, and a class D amplifier.

Question, how would we get the radio streams in there. Emulate reading an audio file from SD card?

Edzelf, 2016-12-05:
I don't think it is worthwhile to use the PWM method.  The sound quality is minimal and stereo is not possible.
The GPD2826C chip is great, but it has no interface to communicate with the ESP8266.

probonopd, 2016-12-05:
So if we could emulate a SD card, the GPD2826C could "read" from it...

fredericplante, 2016-12-06:
That is actually the most retort idea I have read so far. Can the SPI library allow the esp8266 to work in SPI slave mode? Then the next question is, are you willing to make a FAT emulator that will patch between the Net and the GPD2856C module to make a stream flow so the GPD2856C believe he is dealing with a SDcard.

fredericplante, 2016-12-06:
I guess, if you manage to put the ESP8266 in SPI slave mode, It would be a breeze to simply wait for the play signal, then upload the MP3 crudely, like you do with the VS1053, straight to the GPD2856C module, using the SD port. I would drop functions like next and last. button.

I would be curious to see if it's very complicated to pick up the recorded signal, using the record function on the GPD2856C module, to stream the input line of the device over the network

fredericplante, 2016-12-06:
http://electronics.stackexchange.com/questions/29010/sd-card-emulation

Edzelf, 2016-12-07:
It's a wild idea...  But I don't think I will pick this up.
Even wilder: There are SD-cards that can be filled over a WiFi connection, so theoretically you could send mp3 files OTA to the SD in the module....

milkpirate, 2017-05-16:
Since we are talking about alternatives to the VS1053: As the, by probonopd, mentioned project uses an
 I2S DAC (ES9023)... I have laying around. Since I had trouble getting this setup to work I would like to try you code with the ES9023. Would that be suitable to your project?

fredericplante, 2017-05-16:
The EsP would require some  extra RAM. There is such an MP3 player on the esp github page, I think

fredericplante, 2017-05-16:
Does not seem to be there

Edzelf, 2017-05-16:
I'm working on the ESP32 version for this radio.  That will give you plenty of RAM.

fredericplante, 2017-05-16:
Oh I have not follow for a month, now, so it work on esp32 now? I have lot of reading to do, it seem.

Thread 45 (2016-12-08):

Some error message

fredericplante, 2016-12-08:
I finally got to the point where it was your project turn to try. But I got these error message, myust be nothing but...

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

Edzelf, 2016-12-08:
Did you change something around line 112?  It should read something like:
// Define the version number:
#define VERSION "15-nov-2016"
// TFT.  Define USETFT if required.
#define USETFT
#include <ESP8266WiFi.h>

fredericplante, 2016-12-08:
`// 15-11-2016, ES: Support for .m3u playlists.
//
// Define the version number:
#define VERSION "15-nov-2016"                  //My line 112
// TFT.  Define USETFT if required.
#define USETFT
#include <ESP8266WiFi.h>
#include <ESPAsyncTCP.h>
#include <ESPAsyncWebServer.h>
#include <AsyncMqttClient.h>
#include <SPI.h>
#if defined ( USETFT )
#include <Adafruit_GFX.h>
#include <TFT_ILI9163C.h>
#endif`

fredericplante, 2016-12-08:
// 15-11-2016, ES: Support for .m3u playlists.
//
// Define the version number:
#define VERSION "15-nov-2016"           /<--- Line 112
// TFT.  Define USETFT if required.
#define USETFT
#include <ESP8266WiFi.h>
#include <ESPAsyncTCP.h>
#include <ESPAsyncWebServer.h>
#include <AsyncMqttClient.h>
#include <SPI.h>
#if defined ( USETFT )
#include <Adafruit_GFX.h>
#include <TFT_ILI9163C.h>
#endif

fredericplante, 2016-12-08:
If it can help
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

fredericplante, 2016-12-08:
This is what comes out with full débug message:

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

fredericplante, 2016-12-08:
I don't think that the problem is in your code, the problem seem to come from the AsynMTTQclient library, when I try ton compile the FullyFeatured example, it return the same exact message:

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

Any suggestions?

Edzelf, 2016-12-08:
Reïnstall IDE and libraries?

Verzonden vanaf Samsung-tablet.

-------- Oorspronkelijk bericht --------
Van: Frédéric Plante <notifications@github.com>
Datum: 09-12-16  00:00  (GMT+01:00)
Aan: Edzelf/Esp-radio <Esp-radio@noreply.github.com>
Cc: Ed Smallenburg <ed@smallenburg.nl>, Comment <comment@noreply.github.com>
Onderwerp: Re: [Edzelf/Esp-radio] Some error message (#45)

I don't think that the problem is in your code, the problem seem to come from the AsynMTTQclient library, when I try ton compile the FullyFeatured example, it return the same exact message:

Arduino: 1.6.5 (Windows XP), Board: "Generic ESP8266 Module, 80 MHz, 40MHz, DIO, 115200, 4M (3M SPIFFS), ck, Disabled, None"
In file included from C:\Documents and Settings\So sory\Application Data\Arduino15\packages\esp8266\hardware\esp8266\2.3.0-rc2\libraries\ESP8266WiFi\src/WiFiClient.h:25:0,

from C:\Documents and Settings\So sory\Application Data\Arduino15\packages\esp8266\hardware\esp8266\2.3.0-rc2\libraries\ESP8266WiFi\src/ESP8266WiFi.h:39,

from FullyFeatured.ino:1:

c:\documents and settings\so sory\application data\arduino15\packages\esp8266\tools\xtensa-lx106-elf-gcc\1.20.0-26-gb404fb9-2\xtensa-lx106-elf\include\c++\4.8.2\bits\stl_vector.h: In member function 'std::vector<_Tp, _Alloc>::size_type std::vector<_Tp, _Alloc>::_M_check_len(std::vector<_Tp, _Alloc>::size_type, const char*) const':

C:\Documents and Settings\So sory\Application Data\Arduino15\packages\esp8266\hardware\esp8266\2.3.0-rc2\cores\esp8266/Arduino.h:253:18: error: expected unqualified-id before '(' token

#define max(a,b) ((a)>(b)?(a):(b))

^

c:\documents and settings\so sory\application data\arduino15\packages\esp8266\tools\xtensa-lx106-elf-gcc\1.20.0-26-gb404fb9-2\xtensa-lx106-elf\include\c++\4.8.2\bits\stl_bvector.h: In member function 'std::vector<bool, _Alloc>::size_type std::vector<bool, _Alloc>::_M_check_len(std::vector<bool, _Alloc>::size_type, const char*) const':

C:\Documents and Settings\So sory\Application Data\Arduino15\packages\esp8266\hardware\esp8266\2.3.0-rc2\cores\esp8266/Arduino.h:253:18: error: expected unqualified-id before '(' token

#define max(a,b) ((a)>(b)?(a):(b))

^

Error compiling.
This report would have more information with

"Show verbose output during compilation"

enabled in File > Preferences.

Any suggestions?

—
You are receiving this because you commented.
Reply to this email directly, view it on GitHub, or mute the thread.

{"api_version":"1.0","publisher":{"api_key":"05dde50f1d1a384dd78767c55493e4bb","name":"GitHub"},"entity":{"external_key":"github/Edzelf/Esp-radio","title":"Edzelf/Esp-radio","subtitle":"GitHub repository","main_image_url":"https://cloud.githubusercontent.com/assets/143418/17495839/a5054eac-5d88-11e6-95fc-7290892c7bb5.png","avatar_image_url":"https://cloud.githubusercontent.com/assets/143418/15842166/7c72db34-2c0b-11e6-9aed-b52498112777.png","action":{"name":"Open in GitHub","url":"https://github.com/Edzelf/Esp-radio"}},"updates":{"snippets":[{"icon":"PERSON","message":"@fredericplante in #45: I don't think that the problem is in your code, the problem seem to come from the AsynMTTQclient library, when I try ton compile the FullyFeatured example, it return the same exact message:\r\n\r\n\u003e Arduino: 1.6.5 (Windows XP), Board: \"Generic ESP8266 Module, 80 MHz, 40MHz, DIO, 115200, 4M (3M SPIFFS), ck, Disabled, None\"\r\n\u003e \r\n\u003e In file included from C:\\Documents and Settings\\So sory\\Application Data\\Arduino15\\packages\\esp8266\\hardware\\esp8266\\2.3.0-rc2\\libraries\\ESP8266WiFi\\src/WiFiClient.h:25:0,\r\n\u003e                  from C:\\Documents and Settings\\So sory\\Application Data\\Arduino15\\packages\\esp8266\\hardware\\esp8266\\2.3.0-rc2\\libraries\\ESP8266WiFi\\src/ESP8266WiFi.h:39,\r\n\u003e                  from FullyFeatured.ino:1:\r\n\u003e c:\\documents and settings\\so sory\\application data\\arduino15\\packages\\esp8266\\tools\\xtensa-lx106-elf-gcc\\1.20.0-26-gb404fb9-2\\xtensa-lx106-elf\\include\\c++\\4.8.2\\bits\\stl_vector.h: In member function 'std::vector\u003c_Tp, _Alloc\u003e::size_type std::vector\u003c_Tp, _Alloc\u003e::_M_check_len(std::vector\u003c_Tp, _Alloc\u003e::size_type, const char*) const':\r\n\u003e C:\\Documents and Settings\\So sory\\Application Data\\Arduino15\\packages\\esp8266\\hardware\\esp8266\\2.3.0-rc2\\cores\\esp8266/Arduino.h:253:18: error: expected unqualified-id before '(' token\r\n\u003e  #define max(a,b) ((a)\u003e(b)?(a):(b))\r\n\u003e                   ^\r\n\u003e c:\\documents and settings\\so sory\\application data\\arduino15\\packages\\esp8266\\tools\\xtensa-lx106-elf-gcc\\1.20.0-26-gb404fb9-2\\xtensa-lx106-elf\\include\\c++\\4.8.2\\bits\\stl_bvector.h: In member function 'std::vector\u003cbool, _Alloc\u003e::size_type std::vector\u003cbool, _Alloc\u003e::_M_check_len(std::vector\u003cbool, _Alloc\u003e::size_type, const char*) const':\r\n\u003e C:\\Documents and Settings\\So sory\\Application Data\\Arduino15\\packages\\esp8266\\hardware\\esp8266\\2.3.0-rc2\\cores\\esp8266/Arduino.h:253:18: error: expected unqualified-id before '(' token\r\n\u003e  #define max(a,b) ((a)\u003e(b)?(a):(b))\r\n\u003e                   ^\r\n\u003e Error compiling.\r\n\u003e \r\n\u003e   This report would have more information with\r\n\u003e   \"Show verbose output during compilation\"\r\n\u003e   enabled in File \u003e Preferences.\r\n\r\nAny suggestions?\r\n"}],"action":{"name":"View Issue","url":"https://github.com/Edzelf/Esp-radio/issues/45#issuecomment-265881706"}}}

medamarko, 2016-12-09:
I would try to take ARDUINO directly from git and copy over installed one, there were some fixes in recent weeks.
https://github.com/esp8266/Arduino

fredericplante, 2016-12-09:
> Sketch uses 354,961 bytes (33%) of program storage space. Maximum is 1,044,464 bytes.
> Global variables use 44,072 bytes (53%) of dynamic memory, leaving 37,848 bytes for local variables. Maximum is 81,920 bytes.

Ah ah! This only show that I've negleted my arduino install folder for to long. ;)

Thank you for you patience. I getting on the few implementation that I was thinking about.

fredericplante, 2016-12-09:
By the way Would you freak alot if I put a toggle on the debug output to redirected to an telnet kind of output? Cause I would really appreciate to regain GPIO1 and GPIO3 to setup an I2C interface

Edzelf, 2016-12-09:
No problem, go ahead.

Verzonden vanaf Samsung-tablet.

-------- Oorspronkelijk bericht --------
Van: Frédéric Plante <notifications@github.com>
Datum: 09-12-16  17:58  (GMT+01:00)
Aan: Edzelf/Esp-radio <Esp-radio@noreply.github.com>
Cc: Ed Smallenburg <ed@smallenburg.nl>, Comment <comment@noreply.github.com>
Onderwerp: Re: [Edzelf/Esp-radio] Some error message (#45)

By the way Would you freak alot if I put a toggle on the debug output to redirected to an telnet kind of output? Cause I would really appreciate to regain GPIO1 and GPIO3 to setup an I2C interface

—
You are receiving this because you commented.
Reply to this email directly, view it on GitHub, or mute the thread.

{"api_version":"1.0","publisher":{"api_key":"05dde50f1d1a384dd78767c55493e4bb","name":"GitHub"},"entity":{"external_key":"github/Edzelf/Esp-radio","title":"Edzelf/Esp-radio","subtitle":"GitHub repository","main_image_url":"https://cloud.githubusercontent.com/assets/143418/17495839/a5054eac-5d88-11e6-95fc-7290892c7bb5.png","avatar_image_url":"https://cloud.githubusercontent.com/assets/143418/15842166/7c72db34-2c0b-11e6-9aed-b52498112777.png","action":{"name":"Open in GitHub","url":"https://github.com/Edzelf/Esp-radio"}},"updates":{"snippets":[{"icon":"PERSON","message":"@fredericplante in #45: By the way Would you freak alot if I put a toggle on the debug output to redirected to an telnet kind of output? Cause I would really appreciate to regain GPIO1 and GPIO3 to setup an I2C interface"}],"action":{"name":"View Issue","url":"https://github.com/Edzelf/Esp-radio/issues/45#issuecomment-266064705"}}}

Closed 2016-12-09.

Thread 46 (2016-12-10):

MetaName

Sander0542, 2016-12-10:
Hello,

Is there a way to get the song title in the website?

fredericplante, 2016-12-11:
There must be some standard in streaming MP3, just like in normal .mp3, there must be idx tag, or some thing.

[ID tag](https://www.google.ca/url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,d.cGc)

Sander0542, 2016-12-11:
Yes, but if you have debug on then you can see the StreamTitle but in the website i cant find any thing about it

fredericplante, 2016-12-11:
Oh I get what you mean, yeap, many thing miss on the web page, I say, it also lack a play, pause, stop buttons. and the web interface to play a standalone mp3 file. I let you work on this while I'm on the I2C interface to gain extra pins

Edzelf, 2016-12-12:
I will include some extra song information (web interface) in the next release.  In the current version this is only visible on the TFT.

fredericplante, 2016-12-12:
A webpage containing a play list that point to stand alone  mp3 would be nice also. ;)

Edzelf, 2016-12-23:
The status button displays some info now.  Will be better in the future.

Closed 2016-12-26.

Thread 47 (2016-12-12):

Wow! Great work

fredericplante, 2016-12-12:
The fact is that I have a Vs1003, so now you can say it also work with this serie. So far, to day, I only done the plain no tft montage. works to the perfection, not considering a rare and few skips here and there that I was expecting any way,.

Now this is the first time that this damn module work correctly, the "Hello" example sucked, and the library that attempt to cover the subject, well they lack of every thing, and did not work very well on esp8266. But you, you made it happen.

Ok, now that I know it work, I going to make the modifications, tomorrow, to introduce the PCF8575 to free up some pins, I would like to trow the gestion of All the control pins over I2C, so this way, it might be possible to add few button, and an SDCard to the beast.

Give you news about it, I should have lot of time within the next few week, since it's winter vacation now.

Take good care of you self Ed, and thank you some much, I really appreciate you job

Closed 2017-01-01.

Thread 48 (2016-12-12):

MQTT client

fredericplante, 2016-12-12:
All was good when I when to bed, last night, and this morning, BANG! it's dead, I've comment from line 1598 to 1611, and all is back on line, without the MQTT part.

What is MQTT, any way?

fredericplante, 2016-12-12:
Oh I see, it's a protocole that allow me to talk to my device from the internet, right? Personally, I prefere to use IRC services, then any internet of cloud thing.

Closed 2017-01-01.

Thread 51 (2016-12-25):

Resume player after stop command

ohalushchak, 2016-12-25:
Tried to add a new command "resume". It should start to play music after it was stoped. For this command I do the next logic:

hostreq = true ;

But it looks like something else is missing.

Edzelf, 2016-12-25:
Looks good.  I will test it later.

Verzonden vanaf Samsung-tablet.

-------- Oorspronkelijk bericht --------
Van: ohalushchak <notifications@github.com>
Datum: 25-12-16  15:56  (GMT+01:00)
Aan: Edzelf/Esp-radio <Esp-radio@noreply.github.com>
Cc: Subscribed <subscribed@noreply.github.com>
Onderwerp: [Edzelf/Esp-radio] Resume player after stop command (#51)

Tried to add a new command "resume". It should start to play music after it was stoped. For this command I do the next logic:
hostreq = true ;
But it looks like something else is missing.

—
You are receiving this because you are subscribed to this thread.
Reply to this email directly, view it on GitHub, or mute the thread.

{"api_version":"1.0","publisher":{"api_key":"05dde50f1d1a384dd78767c55493e4bb","name":"GitHub"},"entity":{"external_key":"github/Edzelf/Esp-radio","title":"Edzelf/Esp-radio","subtitle":"GitHub repository","main_image_url":"https://cloud.githubusercontent.com/assets/143418/17495839/a5054eac-5d88-11e6-95fc-7290892c7bb5.png","avatar_image_url":"https://cloud.githubusercontent.com/assets/143418/15842166/7c72db34-2c0b-11e6-9aed-b52498112777.png","action":{"name":"Open in GitHub","url":"https://github.com/Edzelf/Esp-radio"}},"updates":{"snippets":[{"icon":"DESCRIPTION","message":"Resume player after stop command (#51)"}],"action":{"name":"View Issue","url":"https://github.com/Edzelf/Esp-radio/issues/51"}}}

ohalushchak, 2016-12-25:
Here is some additional information:
Request: /?stop=0
log:
D: Command: stop with parameter 0
D: STOP requested
D: Stopping client
D: Song stopped correctly after 0 msec

Request: /?resume=0
log:
Command: resume with parameter 0
D: Connect to new host stream.mjoy.ua
D: Connect to stream.mjoy.ua on port 80, extension /
D: Connected to server
D: Server: Apache/2.4.7 (Ubuntu)
D: Last-Modified: Fri, 16 Oct 2015 10:26:07 GMT
D: Accept-Ranges: bytes
D: Content-Length: 11510
D: Connection: close
D: Content-Type: text/html
D: Switch to DATA, bitrate is 0
D: No data input
D: No data input
D: Trying other station/file...
D: STOP requested
D:
D:
D: Song stopped correctly after 0 msec
D: New preset/file requested
D: Connect to new host ua.uar.net:8000/galychyna
D: Slash in station
D: Connect to ua.uar.net on port 8000, extension /galychyna
D: Connected to server
D: Server: Icecast 2.4.1
D: Content-Type: audio/mpeg
D: Cache-Control: no-cache
D: Expires: Mon, 26 Jul 1997 05:00:00 GMT
D: Pragma: no-cache
D: Access-Control-Allow-Origin: *
D: icy-br:256
D: icy-description:This is only a trial
D: icy-genre:galychyna
D: icy-name:Galychyna FM
D: icy-pub:0
D: icy-url:http://www.galychyna.fm
D: icy-metaint:16000
D: Switch to DATA, bitrate is 256
D: Metadata block 16 bytes
D: Streamtitle found, 15 bytes
D: StreamTitle='';
D: Recovered from dataloss

Edzelf, 2016-12-26:
Yes, it's clear.  The variable "host" is shortened in the function "connecttohost", making it unusable for a second call to this function.  I will change this and add the "resume" feature to the software within a few days.

Edzelf, 2016-12-28:
Resume works now.  It is not yet implemented in the web interface.

Closed 2016-12-28.

Thread 53 (2016-12-30):

SPIFFS destroyed after OTA

GabeHC, 2016-12-30:
OTA uses esp's upper flash for buffering, how to avoid SPIFFS from destroy?
is it possible to update sketch data wirelessly?

GabeHC, 2016-12-30:
My mistake! it never happened! please ignore me.

Closed 2016-12-30.

Thread 54 (2017-01-04):

Connect To Website

Sander0542, 2017-01-04:
Hello,

Ed, I have a question, I'm trying to make a ESP8266 with a Temprature Sensor (DS18B20), How can I send data to a url with parameter like this: `example.com/add.php?room=livingroom&temp=20.5`
Could you please help me?

Regards,
Sander Jochems

Edzelf, 2017-01-04:
I will send you an example.

Sander0542, 2017-01-04:
Thank you very much!

Sander0542, 2017-01-06:
When do you will send it?

Edzelf, 2017-01-06:
Already send it through the contactform on you site.

Sander0542, 2017-01-06:
That one didnt work, the last week, there was a bug, could you please send it to contact@sanderjochems.nl?

Closed 2017-01-06.

Thread 56 (2017-01-15):

geeetech vs1053 shield & wemos D1

thermo2016, 2017-01-15:
Hello, I was hoping to use one of these shields
http://www.geeetech.com/wiki/index.php/Arduino_MP3_shield_board_with_TF_card
fitted to a wemos D1. I've changed the digitial io lines to:
`#define VS1053_CS     D6`
`#define VS1053_DCS    D7`
`#define VS1053_DREQ   D2`

These values are taken from the (arduino) sparkfun libraries.
I've also undefined digital switches & tft to prevent any contention.
Unfortunately it doesn't work, I get these errors when starting:
D: Reset VS1053...
D: End reset VS1053...
D: Slow SPI,Testing VS1053 read/write registers...
D: VS1053 error retry SB:012C R1:0000 R2:0000
D: VS1053 error retry SB:0258 R1:0000 R2:0000
D: VS1053 error retry SB:0384 R1:0000 R2:0000
D: VS1053 error retry SB:04B0 R1:0000 R2:0000
D: VS1053 error retry SB:05DC R1:0000 R2:0000
D: VS1053 error retry SB:0708 R1:0000 R2:0000
D: VS1053 error retry SB:0834 R1:0000 R2:0000
D: VS1053 error retry SB:0960 R1:0000 R2:0000
D: VS1053 error retry SB:0A8C R1:0000 R2:0000
D: VS1053 error retry SB:0BB8 R1:0000 R2:0000
D: VS1053 error retry SB:0CE4 R1:0000 R2:0000
D: VS1053 error retry SB:0E10 R1:0000 R2:0000
D: VS1053 error retry SB:0F3C R1:0000 R2:0000
D: VS1053 error retry SB:1068 R1:0000 R2:0000
D: VS1053 error retry SB:1194 R1:0000 R2:0000
D: VS1053 error retry SB:12C0 R1:0000 R2:0000
D: VS1053 error retry SB:13EC R1:0000 R2:0000
D: VS1053 error retry SB:1518 R1:0000 R2:0000
D: VS1053 error retry SB:1644 R1:0000 R2:0000
D: VS1053 error retry SB:1770 R1:0000 R2:0000
D: VS1053 not properly installed!
D: endFillByte is 0

It looks like the vs1053 isn't being detected for some reason.
Any ideas?
Thanks

GabeHC, 2017-01-16:
I have it figure out that WEMOS D1 map pin2 to ESP8266 GPIO 16, and it is the only pin can't be use for interrupt, So I had it remap like following:
#define VS1053_CS     16
#define VS1053_DCS    4
#define VS1053_DREQ   5

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

and hardwire like this 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

thermo2016, 2017-01-16:
Thank you for the very helpful info.  It's now working with the pins you suggested. Thank you.
(Although the issue is resolved the info is useful enough to keep somewhere)

GabeHC, 2017-01-20:
Dose any one gets SD files playing working?
Try to add SdFat.h SdFatUtil.h got an error says  redefinition of 'class fs::File'

thermo2016, 2017-01-21:
Are you using SDFat.h from the sparkfun libraries? If so, these do not compile on the esp8266 - I tried!
I have better luck when using an example from File->Examples->SD(esp8266).
Using the cardinfo example I was able to list the contents of the SD card - use chipSelect = 2;
If you have the sparkfun libraries, you may have to move/delete them.

GabeHC, 2017-01-21:
i had modify sparkfun libraries to work on ESP8266. and it works just fine.
the same hardware play MP3 files from SD card.
I thought it will be simple to just adapt it SdFat to ESP-RADIO
but there are conflicts on fs.h
don't know differences between SPIFFS and SD file system.
Do you?

acocalypso, 2017-03-16:
I have an geeetech vs1053 as well and using a nodemcu any idea how to get it working?

SurenBono, 2019-01-18:
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

> `#define VS1053_CS D1`   // break pin xcs, hard solder vspin6 to D1 only after confirming 1ST  by fritzzing
> `#define VS1053_DCS D0` // break pin xds, hard solder vspin7 to D0 only after confirming 1ST  by fritzzing
> `#define VS1053_DREQ D2`  // remains

upload sketch with 180mhz & iW variant / v2HigherBandwidth option

Thread 57 (2017-01-17):

M3U not working.

GabeHC, 2017-01-17:
add these lines to preset station, but can't get it to work.

preset_17 = pianosolo.streamguys.net/live.m3u               # 17 - Whisperings:Solo Piano Radio
preset_19 = listen.radionomy.com/taiwan-lounge.m3u    # 19 - Taiwan-Lounge Radio

Can you help? Thanks!

Edzelf, 2017-01-17:
Fixed.

GabeHC, 2017-01-17:
Thanks, Working good now!

is playing Youtube Radio possible?

Edzelf, 2017-01-17:
No, sorry.

arlaor, 2017-01-18:
Hi @Edzelf
How can i play mp3 on a server?

Edzelf, 2017-01-19:
.mp3 should work.  Enter the following example in the in the play-field of the webinterface:
www.stephaniequinn.com/Music/Rondeau.mp3
or add it to your presets.
For (small) .mp3 file in SPIFFS use something like:
localhost/friendly.mp3

arlaor, 2017-01-19:
Hi @Edzelf
Then what I would have to do is generate a local radio with my audio files?
Other Question.
Is it possible to save the volume and equalization parameters for each radio station? Or does it save the general volume of last entry to the ESP-12E module?

Edzelf, 2017-01-19:
If you have your mp3-files on a NAS, you should be able to play them.
Parameters per station is a nice feature for the wishlist...

GabeHC, 2017-01-22:
My M3U file as following:
#EXTM3U
#EXTINF:281,JUDY10
http://10.0.0.5/music/2008/10.mp3
#EXTINF:282,JUDY02
http://10.0.0.5/music/2008/02.mp3
#EXTINF:236,JUDY03
http://10.0.0.5/music/2008/03.mp3
#EXTINF:257,JUDY04
http://10.0.0.5/music/2008/04.mp3
#EXTINF:254,JUDY05
http://10.0.0.5/music/2008/05.mp3
#EXTINF:258,JUDY06
http://10.0.0.5/music/2008/06.mp3
#EXTINF:268,JUDY07
http://10.0.0.5/music/2008/07.mp3
#EXTINF:247,JUDY08
http://10.0.0.5/music/2008/08.mp3
#EXTINF:326,JUDY09
http://10.0.0.5/music/2008/09.mp3
#EXTINF:219,JUDY01
http://10.0.0.5/music/2008/01.mp3

it keeps looping first track, is it something wrong it did of the m3u file or sketches bug?
and how to make it m3u8 compatible?

Edzelf, 2017-01-23:
Fixed.

arlaor, 2017-01-23:
Hi @Edzelf

As I can set the VS1053 settings so that when I start, show them in the control page as I have set them in the radio.ini file, for example: treble gain + 4.5dB, Bass Freq: 50Hz.
I have tried to put them this way literally, but it does not show them as I have established them and I have also tried
```javascript
# VS1053 settings
volume = 84
toneha = 3
tonehf = 6
tonela = 5
tonelf = 6
```
But neither shows them and I do not know if they have already taken them internally.

another question. With what parameters and files do you recommend updating the firmware of the ESP-12E, in order to achieve the best compatibility between the module and the esp-radio project?

Edzelf, 2017-01-24:
You tone-settings should work.  But it is a one-way command.  The result is not visible in the webinterface.  Maybe I will include this feature in the next release.

As far as  I know, the term "firmware" is used in the ESP826 for the software in flash memory.  So in this case it's the software of Esp-radio.  Other types of "firmware" are NodeMCO or the "AT"-interface.
There is no way to update the  ROM-software.

arlaor, 2017-01-24:
Hi @Edzelf
You can also include that automatically when the station is changed, by the NEXT or PREV button or when the module is turned on, automatically shows the station that is playing from the PRESET section and in the STATUS section, showing the streamtitle

GabeHC, 2017-01-26:
Sluggish WEB UI response when playing mp3, m3u.
Randomly skips songs playing.

arlaor, 2017-01-26:
sound error to station play http://live3.rcnmundo.com/lamega.mp3

Edzelf, 2017-01-26:
The station "live3.rcnmundo.com/lamega.mp3" gives the wrong stream info:
icy-metaint: 16000
In fact there is no metadata after 16000 bytes.
Look at the debug-output for more information.

arlaor, 2017-01-27:
Hi @Edzelf
I was trying to get the debug-output for more information, but I did not know how to do it, the [information](https://github.com/esp8266/Arduino/blob/master/doc/Troubleshooting/debugging.md) I found about debug-output, talk about a debug port that my arduino IDE does not have and does not show how I can enable it to get it report.
The same problem I have obtained in other stations:
prem2.radiotunes.com/latinpophits_hi?6637214e119025aea9c9de18
19523.live.streamtheworld.com/LOS40.mp3
19373.live.streamtheworld.com/CADENADIAL.mp3
oidos.streamlicensing.com/thedumphigh?cb=472457.mp3

Which makes me believe that due to problems of speed of internal transmission of the ESP-12E or memory to buffer.
I do not know if the signatureware that has my module leaves very little work space for your sketch and must change it.

The arduino IDE also does not show exceptions that are generating the problem.
When the radio station generates the noises mentioned, the red led of the ESP-12E module flashes, indicating that there is a small cut in the transmission
What else can I check?

Edzelf, 2017-01-28:
prem2.radiotunes.com/latinpophits_hi?6637214e119025aea9c9de18 works well here.
19523.live.streamtheworld.com/LOS40.mp3 works well here.
19373.live.streamtheworld.com/CADENADIAL.mp3 works well here.
oidos.streamlicensing.com/thedumphigh?cb=472457.mp3 works well here.
live3.rcnmundo.com/lamega.mp3 still does not work due wrong "icy-metaint" supplied by the station.

For debugging: just start the "Serial monitor" of the IDE.  Thee first chunk of the mp3-data will be displayed and it should start with "FF FB" for these stations.

The ESP-8266 has enough memory and CPU power for this project, but it lacks buffers for multiple TCP-connections.  So when all inputbuffers are filled with mp3 data, you may have difficulties reaching the web interface.

The led on the ESP-module should be on (probably flashing very fast) all the time when playing.

arlaor, 2017-01-28:
`D: First chunk:
D: FF F3 82 64 00 0E E9 67
D: 75 3F 3C C2 6A 0F C8 FE
D: CA 44 4B C4 68 A1 5D E1
D: D5 12 D8 53 92 5B 1F A1
`

arlaor, 2017-01-29:
Hi @Edzelf
I found the following when initially playing radio stations that have a bitrate of 64kbps and smaller bitrates.
Free memory is reduced to a value of 4000 and smaller, but when I initially touch stations with bitrates higher than 128kbps, free memory have a value of 8500 and higher.

When the free memory falls to a value of 4000, the stations begin to generate strange noises and to break the transmission. After lowering the free memory to 4000, it remains in this value and all the stations that are heard after this no matter the bitrate (128kbps), all produce strange noises and the free memory is not recovered until the reset button is pressed .

I do not believe that the error is of the radio transmitters but of the way the arduino code establishes the parameters to reproduce small bitrates and of not allow the recovery of the free memory or of releasing it after the change of a station of radio to another one.

Edzelf, 2017-01-29:
Can you give me the URL of the station that shows the problem?

arlaor, 2017-01-30:
live3.rcnmundo.com/ntn24.mp3
live3.rcnmundo.com/lamega.mp3
live4.rcnmundo.com/lafmpoplatino.mp3
live1.rcnmundo.com/rumbaybembe.mp3
...and others
These stations can listen to them normally without any noise or cuts from foobar2000 player or from google chrome, but unfortunately not in your project.
I would like to be able to solve these small problems in your project.

Another concern is about OTA. Request password to open the arduino IDE and to upload a file via the network port. what is the password?

Edzelf, 2017-01-30:
I will try.
No need for OTA password, just select the right port and start upload.  It 's not very reliable, sometimes it works after 3 times.

Edzelf, 2017-01-30:
All these station have an error in the metadata.  The first metadata block is always at 16014 bytes.  It should be at 16000.  After the first block it is sometimes at 16000 but mostly not.
I don't know a solution for this.

karawin, 2017-01-30:
Edzel, sorry but these stations are in chunked html. They play well in karadio.
See the chunked html definition at https://fr.wikipedia.org/wiki/Chunked_transfer_encoding
No doubt that you can improve your software.

karawin, 2017-01-30:
https://en.wikipedia.org/wiki/Chunked_transfer_encoding

Edzelf, 2017-01-30:
Clear.  It's new for me.  I will try to implement  this.

Edzelf, 2017-01-30:
Fixed.  New version supports "chunked transfer encoding" now.

arlaor, 2017-01-30:
Hi @Edzelf  @karawin
Now it works normally. Excellent work

arlaor, 2017-01-30:
Hi @Edzelf
The handling of the controls in the web page like volume, status, test, treble, Bass, when I am playing the radio stations mentioned in previous messages (64kbps and lower bitrates), produce important delays in the web page.

Edzelf, 2017-01-31:
See my answer on "Random error while updating web page".
There is a hardware solution: use a separate ESP8266 for the webinterface and interconnect the 2 through the serial interface.

GabeHC, 2017-02-02:
I suggest following changes.

1. make PREV NEXT to work on playlist on tracks when playing m3u
2. add random playing when in playlist mode
3. add m3u8 support, to do this will
  - change html charset to utf-8
  - remove all ( b > 0x7F )
  - add
```
if ( host.endsWith ( ".m3u" )                     // Is it an m3u playlist?
    ||  host.endsWith ( ".m3u8" )                // or .m3u8 for UTF-8 playlist
   )
```

arlaor, 2017-02-08:
Hi @Edzelf
You can support this radio station or this type of links
The two links belong to the same station and are supported by foobar2000 player
http://streams.deltaradio.de/delta-live/mp3-128/streams.deltaradio.de/play.m3u
http://streams.deltaradio.de/delta-live/mp3-128
The second link can be played from chrome

Edzelf, 2017-02-09:
The 2nd link yields a redirection to: regiocast.hoerradar.de/deltaradio128?sABC=589p85q8%233n79694784rn57rr01s34sp2s9305
Use this instead, as Esp-radio does not support redirection.

Closed 2017-04-05.

Thread 59 (2017-01-24):

Random error while updating web page

arlaor, 2017-01-24:
Hi @Edzelf
Sometimes happens that when you update the web page this does not reload the sp-radio page and sends the following code to the web page
After this does not reload the page, until you press the reset button

```javascript
     }
    }
    xhr.open ( "GET", theUrl, false ) ;
    xhr.send() ;
   }

   function handlepreset ( presctrl )
   {
    if ( presctrl.value >= 0 )
    {
      httpGet ( "preset=" + presctrl.value ) ;
    }
   }

   function handletone ( tonectrl )
   {
     var theUrl = "/?tone" + tonectrl.id + "=" + tonectrl.value +
                  "&version=" + Math.random() ;
     var xhr = new XMLHttpRequest() ;
     xhr.onreadystatechange = function() {
       if ( xhr.readyState == XMLHttpRequest.DONE )
       {
         resultstr.value = xhr.responseText ;
       }
     }
     xhr.open ( "GET", theUrl, false ) ;
     xhr.send() ;
   }

   function setstat()
   {
     var theUrl = "/?station=" + station.value + "&version=" + Math.random() ;
     var xhr = new XMLHttpRequest() ;
     xhr.onreadystatechange = function() {
       if ( xhr.readyState == XMLHttpRequest.DONE )
       {
         resultstr.value = xhr.responseText ;
       }
     }
     xhr.open ( "GET", theUrl, false ) ;
     xhr.send() ;
   }
   // Fill preset list initially
   //
   var i, select, opt, stations ;
   select = document.getElementById("selpres") ;
   var theUrl = "/?list=0" + "&version=" + Math.random() ;
   var xhr = new XMLHttpRequest() ;
   xhr.onreadystatechange = function() {
     if ( xhr.readyState == XMLHttpRequest.DONE )
     {
       stations = xhr.responseText.split ( "|" ) ;
       for ( i = 0 ; i < ( stations.length - 1 ) ; i++ )
       {
         opt = document.createElement( "OPTION" ) ;
         opt.value = stations[i].substring ( 0, 2 ) ;
         opt.text = stations[i].substring ( 2 ) ;
         select.add( opt ) ;
       }
     }
   }
   xhr.open ( "GET", theUrl, false ) ;
   xhr.send() ;
  </script>
  <script type="text/javascript">
    var stylesheet = document.createElement('link') ;
    stylesheet.href = 'radio.css' ;
    stylesheet.rel = 'stylesheet' ;
    stylesheet.type = 'text/css' ;
    document.getElementsByTagName('head')[0].appendChild(stylesheet) ;
  </script>
 </body>
</html>
<noscript>
  <link rel="stylesheet" href="radio.css">
  Sorry, ESP-radio does not work without JavaScript!
</noscript>
```

Edzelf, 2017-01-24:
Yes,  this is probably the case when there is no buffer space left for the TCP data.  I have the idea that it happens more when listening to mp3-files.  mp3 streams works better.  I will try to find a solution, but its not so easy.

GabeHC, 2017-01-28:
Adding spi dram will help?

Edzelf, 2017-01-28:
There is plenty of RAM in the ESP8266 for this project.  It's the lack of TCP-buffers in the the "BIOS" that has problem with multiple TCP connections.

arlaor, 2017-02-01:
When making a change directly in the CONFIG page, such as removing or increasing a radio station and saving the changes, with the SAVE and RESTART buttons, upon restarting the ESP-12E module can not be connected again until the file " Radio.ini "again via arduino IDE.
If more than 20 radio stations are added, the INDEX page is not displayed in the PRESET drop-down list and displays incorrect information on the "config" web page.

Edzelf, 2017-02-01:
The size of the radio.ini file is limited to about 3292 bytes, due to limited free memory space .  If you want more, you have to lower the size of the RINGBUF.
You can check the size of radio.ini by entering "testfile=radio.ini" in the serial monitor.
You may also uses TABs instead of multiple spaces in radio.ini and remove commentlines in order to preserve space.  This way I managed to have a list of 30 presets in my radio.ini (RINGUFSIZE=20000), 80 presets with RINGBUFSIZE=10000.
Tip: use STOP before changing the configuration.

arlaor, 2017-02-01:
Hi @Edzelf
I have seen in some projects that use FS, they upload compressed files in ".gz", to gain space in memory.
Is there any possibility of doing the same with the file radio.ini, to be able to obtain a greater number of stations?

Edzelf, 2017-02-09:
radio.ini must be in a form readable bij the sketch.  For .gz file you need software to unzip the file in the ESP8266.

Birdstreet, 2017-12-13:
Decreasing the size of the .ini file helped in my case. And thanks for your job!

Thread 60 (2017-02-01):

SPIFFS files

fenyvesi, 2017-02-01:
I try to use a different VS1063b board (Sparkfun breakout board) without success: no sound. The board works, I tried it with Arduino.
For debugging I wanted to play a local mp3 file stored in SPIFFS. I put the mp3 files ( 2 * 11k) into the /data directory but they are not transferred in the process of uploading. I wasn't able to guess how to upload through the Web interface either.
Any advice?
Thanks.

fenyvesi, 2017-02-01:
Arduino v1.6.11 is used.

Edzelf, 2017-02-01:
I do not have a VS1063 board, so I can't test it.
For uploading to SPIFFS: press the "STOP" before uploading or saving configuration.

fenyvesi, 2017-02-01:
Thank you for the answer.

Sorry it was misspelled. VS1053B.
The board connects GPIO0, GPIO1, GPIO2, GPIO3 to Ground.  The Line_In, MIC_P to AGND through a capacitor. Reset, Rx to HIGH.

I can see the 1st chunk in the console, the status seems to be OK, but I can see often:
Free memory is 10704, ringbuf 0, stream 0 (may be because of streaming and not having capacity for http.

The mp3 file i can play from browser doesn't work:

D: STOP requested
D: Stopping client
D: Song stopped correctly after 0 msec
D: Command: station with parameter www.stephaniequinn.com/Music/Rondeau.mp3
D: Connect to new host www.stephaniequinn.com/Music/Rondeau.mp3
D: Connect to www.stephaniequinn.com on port 80, extension /Music/Rondeau.mp3
D: Connected to server
D: Content-Type: audio/mpeg
D: Last-Modified: Wed, 29 Jul 2009 16:21:00 GMT
D: Accept-Ranges: bytes
D: Server: Microsoft-IIS/8.5
D: X-Powered-By: ASP.NET
D: Content-Length: 2157423
D: Connection: close
D: Switch to DATA, bitrate is 0
D: No data input
D: No data input
D: Trying other station/file...
D: STOP requested
D: Song stopped correctly after 0 msec
D: New preset/file requested (6/0) from 205.164.62.15:10032

fenyvesi, 2017-02-01:
I tried to upload. It crashed.

: Command: stop (without parameter)
D: STOP requested
D: Stopping client
D: Song stopped correctly after 0 msec
D: Command: getnetworks with parameter 0
D: File upload gsm.mp3, len 1321, index 0
D: File upload gsm.mp3, len 308, index 10081
D: File upload gsm.mp3, 9068 bytes finished
D: FileRequest received /upload

Exception (28):
epc1=0x40207dbb epc2=0x00000000 epc3=0x00000000 excvaddr=0x00000000 depc=0x00000000

ctx: sys
sp: 3ffffbf0 end: 3fffffb0 offset: 01a0

>>>stack>>>

fenyvesi, 2017-02-01:
After restarting I have it:

D: FS Total 2949250, used 11546
D: /radio.ini                       -    1601
D: /gsm.mp3                     -    9068

The length is incorrect, the real length is 10.389 bytes instead of 9.068. In the uploading process seems to be a problem.

I can't play:

D: Command: stop (without parameter)
D: Command: station with parameter localhost/gsm.mp3
D: Switch to DATA, bitrate is 0
D: STOP requested
D: Song stopped correctly after 0 msec

Edzelf, 2017-02-01:
Even without a VS1053 connected the debug output should be like the text below.
The lines starting with "D: First chunk:" are missing.  That means that there is no data coming from the WiFi connection.  So first concentrate on that.  Do you have a steady WiFi connection?  Do you have a strong powersupply?
-----------------------------------------------------------------------------------------------

D: Connect to new host www.stephaniequinn.com/Music/Rondeau.mp3
D: Connect to www.stephaniequinn.com on port 80, extension /Music/Rondeau.mp3
D: Connected to server
D: Content-Type: audio/mpeg
D: Last-Modified: Wed, 29 Jul 2009 16:21:00 GMT
D: Accept-Ranges: bytes
D: Server: Microsoft-IIS/8.5
D: X-Powered-By: ASP.NET
D: Content-Length: 2157423
D: Connection: close
D: Switch to DATA, bitrate is 0
D: First chunk:
D: FF FB B0 60 00 00 00 00
D: 00 00 00 00 00 00 00 00
D: 00 00 00 00 00 00 00 00
D: 00 00 00 00 00 00 00 00

fenyvesi, 2017-02-01:
The ESP and the VS board powered by USB. Even 500 mA should be enough. The Wifi connection is stable, 1 meter from the AP.

If I connect a preset station, than tranfers data.

D: Song stopped correctly after 0 msec
D: New preset/file requested (4/0) from airspectrum.cdnstream1.com:8114/1648_128
D: Connect to new host airspectrum.cdnstream1.com:8114/1648_128
D: Connect to airspectrum.cdnstream1.com on port 8114, extension /1648_128
D: Connected to server
D: Content-Type: audio/mpeg
D: icy-br:128
D: ice-audio-info: ice-samplerate=44100;ice-bitrate=128;ice-channels=2
D: icy-br:128
D: icy-description:Today's Easy Hits from the 70s, 80s, 90s through Today!
D: icy-genre:Easy Listening
D: icy-name:Easy Hits Florida
D: icy-private:0
D: icy-pub:1
D: icy-url:http://www.easyhitsflorida.com
D: Server: Icecast 2.4.0-kh3
D: Cache-Control: no-cache, no-store
D: Pragma: no-cache
D: Access-Control-Allow-Origin: *
D: Access-Control-Allow-Headers: Origin, Accept, X-Requested-With, Content-Type
D: Access-Control-Allow-Methods: GET, OPTIONS, HEAD
D: Connection: Close
D: Expires: Mon, 26 Jul 1997 05:00:00 GMT
D: icy-metaint:16000
D: Switch to DATA, bitrate is 128
D: Metadata block 48 bytes
D: Streamtitle found, 47 bytes
D: StreamTitle='Teddy Pendergrass - Love T.K.O. ';

fenyvesi, 2017-02-01:
But no chunk only title.

fenyvesi, 2017-02-01:
After restarting I always get the 1st chunk, no later. The LED is almost constantly lights. In the meantime the test: Free memory is 10720, ringbuf 0, stream 0

: New preset/file requested (-1/0) from icecast.omroep.nl:80/radio1-bb-mp3
D: Connect to new host icecast.omroep.nl:80/radio1-bb-mp3
D: Connect to icecast.omroep.nl on port 80, extension /radio1-bb-mp3
D: Connected to server
D: Server: Icecast 2.4.2
D: Content-Type: audio/mpeg
D: Cache-Control: no-cache
D: Expires: Mon, 26 Jul 1997 05:00:00 GMT
D: Pragma: no-cache
D: icy-br:192
D: ice-audio-info: bitrate=192
D: icy-br:192
D: icy-genre:Talk
D: icy-name:Radio 1
D: icy-pub:0
D: icy-url:http://www.radio1.nl
D: icy-metaint:16000
D: Switch to DATA, bitrate is 192
D: First chunk:
D: F7 C2 DD 0C AF 1E 2A 44
D: 88 9E 3F 2D C4 2D 08 A5
D: 55 AF AE 42 5C 1B DD 3C
D: 88 90 57 2A 15 EB C6 12
D: Metadata block 64 bytes
D: Streamtitle found, 56 bytes
D: StreamTitle='NPO Radio 1 - Radio EenVandaag - AVROTROS';

fenyvesi, 2017-02-01:
I will try your latest version, now I use the previous one.

.

Edzelf, 2017-02-01:
I just fixed a bug concerning file upload: the first chunk was not saved to SPIFFS.
Ringbuf = 0 or stream = 0 means that incoming data is slower than it should be for the given bitrate.  If the led is on, it could mean that the VS1053 demands too much data.  Maybe DREQ is always low.  In that case you may have the line "VS1053 not properly installed!" in your debug output at startup.

fenyvesi, 2017-02-01:
I haven't seen the message but will check DREQ.
this is the debug after boot. The SCI registers are dumped twice.  Immediately before the chunk is printed, all the registers show 0.

D: FS Total 2949250, used 21837
D: /radio.ini                       -    1601
D: /gsm.mp3                         -    9068
D: /mqtt.mp3                        -    9851
D: Added SSID 00 = MADOX3G to acceptable networks
D: Added SSID 01 = TUSNAD5 to acceptable networks
D: * Scan Networks *
D: Number of available networks: 2
D:  1 - TUSNAD6                   Signal: -90 dBm Encryption WPA2
D:  2 - MADOX3G                   Signal: -55 dBm Encryption WPA2  Acceptable
D: --------------------------------------
D: Command: mqttbroker (without parameter)
D: Command: mqttport with parameter 1883
D: Command: mqttuser with parameter none
D: Command: mqttpasswd with parameter none
D: Command: mqtttopic with parameter espradio
D: Command: mqttpubtopic with parameter espradioIP
D: Command: wifi_00 with parameter MADOX3G/Newton01
D: Command: wifi_01 with parameter TUSNAD5/Newton01
D: Command: volume with parameter 72
D: Command: toneha with parameter 0
D: Command: tonehf with parameter 0
D: Command: tonela with parameter 0
D: Command: tonelf with parameter 0
D: Command: preset with parameter 6
D: Preset set to 6
D: Command: preset_00 with parameter 109.206.96.34:8100
D: Command: preset_01 with parameter airspectrum.cdnstream1.com:8114/1648_128
D: Command: preset_02 with parameter us2.internet-radio.com:8050
D: Command: preset_03 with parameter airspectrum.cdnstream1.com:8000/1261_192
D: Command: preset_04 with parameter airspectrum.cdnstream1.com:8008/1604_128
D: Command: preset_05 with parameter us1.internet-radio.com:8105
D: Command: preset_06 with parameter icecast.omroep.nl:80/radio1-bb-mp3
D: Command: preset_07 with parameter 205.164.62.15:10032
D: Command: preset_08 with parameter skonto.ls.lv:8002/mp3
D: Command: preset_09 with parameter 94.23.66.155:8106
D: Starting ESP Version Tue, 23 Jan 2017 15:10:00 GMT...  Free memory 14648
D: Sketch size 340784, free size 704512
D: Reset VS1053...
D: End reset VS1053...
D: Slow SPI,Testing VS1053 read/write registers...
D: Fast SPI, Testing VS1053 read/write registers again...
D: endFillByte is 0
D: After last clocksetting
D: REG   Contents
D: ---   -----
D:   0 -  4800
D:   1 -    40
D:   2 -     0
D:   3 -  6000
D:   4 -     0
D:   5 -  AC44
D:   6 -     0
D:   7 -  1E06
D:   8 -     0
D:   9 -     0
D:   A -     0
D:   B -  FFFC
D:   C -     0
D:   D -     0
D:   E -     0
D:   F -     0
D: Selected network: MADOX3G          
D: Try WiFi MADOX3G
D: IP = 192.168.0.201
D: Start server for commands
D: STOP requested
D: Song stopped correctly after 0 msec
D: New preset/file requested (-1/0) from icecast.omroep.nl:80/radio1-bb-mp3
D: Connect to new host icecast.omroep.nl:80/radio1-bb-mp3
D: Connect to icecast.omroep.nl on port 80, extension /radio1-bb-mp3
D: Connected to server
D: Server: Icecast 2.4.2
D: Content-Type: audio/mpeg
D: Cache-Control: no-cache
D: Expires: Mon, 26 Jul 1997 05:00:00 GMT
D: Pragma: no-cache
D: icy-br:192
D: ice-audio-info: bitrate=192
D: icy-br:192
D: icy-genre:Talk
D: icy-name:Radio 1
D: icy-pub:0
D: icy-url:http://www.radio1.nl
D: icy-metaint:16000
D: Switch to DATA, bitrate is 192
D: first chunk
D: REG   Contents
D: ---   -----
D:   0 -     0
D:   1 -     0
D:   2 -     0
D:   3 -     0
D:   4 -     0
D:   5 -     0
D:   6 -     0
D:   7 -     0
D:   8 -     0
D:   9 -     0
D:   A -     0
D:   B -     0
D:   C -     0
D:   D -     0
D:   E -     0
D:   F -     0
D: First chunk:
D: DC E6 19 61 4B 01 4E CA
D: EC C8 ED 53 52 5C A6 D6
D: 3F FF AA 4E EA 9A 6E CC
D: 86 39 39 4D 6A 2D 7E 59
D: Metadata block 64 bytes
D: Streamtitle found, 56 bytes
D: StreamTitle='NPO Radio 1 - Radio EenVandaag - AVROTROS';

fenyvesi, 2017-02-01:
I compiled your latest version (30 minutes old) and I got the message you suggested. I check DREQ.

D: Reset VS1053...
D: End reset VS1053...
D: VS1053 not properly installed!

fenyvesi, 2017-02-01:
I'm not sure, but almost.

The problem is that after initialization th VS1053 is kept in reset. I was lazy and not having TFT I used GPIO15 for reset directly (without the diodes). But if TFT is not used you suppose that it is a button and goes low later so keeping the board in reset status forever.

I rearrange the setup tomorrow.

Thank you for your help and sorry for being so dumb.
George

fenyvesi, 2017-02-02:
It works.

Closed 2017-02-02.

Thread 61 (2017-02-05):

TFT Colours

thermo2016, 2017-02-05:
I have a problem with the colours shown on the TFT, they seem to completely messed up.
I have a TFT which seems to match what is shown in the PDF, blue circuit board, "1.8 SPI 128x160" at the top, "1.8 TFT MODULE" at the bottom.
The colours are defined as:
#define	BLACK   0x0000
#define	BLUE    0xF800
#define	RED     0x001F
#define	GREEN   0x07E0
#define CYAN    GREEN | BLUE
#define MAGENTA RED | BLUE
#define YELLOW  0x07FF
#define WHITE   0xFFFF

But through trial & error I have found these are close:
#define BLACK   0xFFFF
#define CYAN    0x00E1
#define YELLOW  0x0070
#define WHITE   0x00E0

It appears the colour scheme on the TFT is not 5:6:5. Any ideas what is going on?

Edzelf, 2017-02-06:
The color scheme for my TFT is 5:6:5.  It seems strange that BLACK = 0xFFFF in your case.  Looks like the color bits are inverted.  So try the inversed values.
The library I used is TFT_ILI9163C-master version 0.9.
For the TFT module, I am using the 8 pins connector, the 16 pins on the other side are not used.

thermo2016, 2017-02-06:
I tried inverting the bits, but the colours didn't make sense. I think there is a hardware fault with the TFT. I have ordered replacements (red circuit board). I'll close when I can confirm.
BTW, I think your definition of BLUE & RED may be swapped, and YELLOW may be incorrect. From the TFT_ILI9163C-master example test.ino the colours are defined as:
#define	BLACK   0x0000
#define	BLUE    **0x001F**
#define	RED     **0xF800**
#define	GREEN   0x07E0
#define CYAN    0x07FF
#define MAGENTA 0xF81F
#define YELLOW  **0xFFE0**
#define WHITE   0xFFFF
My TFT shows these colours incorrectly as well.

thermo2016, 2017-02-16:
Replacement TFT has arrived, connected and tested. Using the default colours as defined, it works as expected.
I think the blue mother board TFT screens have quality issues. In my experience, the red motherboard TFT appears to work.
Issue closed. Problem was hardware fault.

Closed 2017-02-16.

Thread 63 (2017-03-16):

Preset not working

acocalypso, 2017-03-16:
Hi after playing around with it, I figured out that my preset is not laoding.

D: New preset/file requested (-1/0) from http://server1.blitz-stream.de:4400
D: Connect to new host http://server1.blitz-stream.de:4400
D: Connect to http on port 0, extension //server1.blitz-stream.de:4400
D: Request http://server1.blitz-stream.de:4400 failed!
D: No data input

radio.ini

# Presets
preset = 1					                                  # Start with preset 6
preset_00 = http://server1.blitz-stream.de:4400               #  0 - METAL-ONLY

But when I enter http://server1.blitz-stream.de:4400 and press play it is working.

Any idea what causes that issue?

Edzelf, 2017-03-16:
In the debug log you see that the portnumber derived from the preset is "0".  This should be "4400"
Note that the "http://" prefix is not allowed in the preset list in radio.ini.  Remove this prefix like:
preset_00 = server1.blitz-stream.de:4400 # 0 - METAL-ONLY
And it will work correctly.

acocalypso, 2017-03-16:
Thanks that worked for me :)

Closed 2017-03-16.

Thread 64 (2017-04-04):

Any plan porting to ESP32?

GabeHC, 2017-04-04:
is there any plan to port it to ESP32?

Edzelf, 2017-04-04:
I do not own an ESP32 at the moment.  But it shouldn't be to hard to port it.

Edzelf, 2017-05-23:
ESP32 version is released.

bbx10, 2017-05-24:
Thanks @Edzelf. ESP32 version working on one of these https://github.com/espressif/arduino-esp32#esp32dev-board-pinmap and Adafruit VS1053 breakout board.

GabeHC, 2017-06-23:
Thanks! and it works much better than ESP8266

Closed 2018-01-09.

Thread 66 (2017-04-10):

Schematic and Analog buttons

hcremer, 2017-04-10:
Hello,

first of all, I would like to express my admiration and gratitude for the great job you have done programming this.
I first tried it with the Linux Arduino IDE, it compiles fine but it is not uploading the sketch.
I then switched to Windows and it worked.
I still have no sound, but I think my VS1053 is a piece of junk as it doesn't give any sound in the MIDI and MP3 tests with an arduino also (already ordered a new one).

I had problems understanding the circuit schematic (png-image) on the reset circuit. I think the 5V and other wires are mixed up between the diodes and the VS1053. Could you maybe draw this more clear?
Afterwards I found out, that the pdf-instructions-file has a corrected version of the schematic, but I used a printout of the png-image first.

Another question is if it would be possible to add 2 more analog switches for volume up and down? Or maybe a MCP23017 portexpander? This would be great for a standalone radio.

Again thanks a lot for this great piece of work.

Edzelf, 2017-04-10:
**Reset circuit.**
The reset circuit for the VS1053 is base on a OR-gate formed by the two diodes.  Only if both GPIO16 and GPIO05 are LOW, the VS1053 reset pin will go low.
I will correct the PNG-image.
But I think you can omit this circuit and just pull up XRST as the VS1053 does not need the reset in normal circumstances.
**Extra functions.**
I think it is possible to add 2 more analog switches.  A port expander is also possible.  And you may consider GPIO0 for a simple IR remote control.

hcremer, 2017-04-10:
Thank you very much for the quick response!

Closed 2017-04-10.

Thread 67 (2017-04-10):

how to solve Sluggish WEB UI response problem when playing MP3?

GabeHC, 2017-04-10:
You mentioned it is lack of TCP buffer, Do you figuring out how to?

Edzelf, 2017-04-10:
Some station deliver MP3 data faster than the decoder can handle according to the bitrate.  The TCP buffers will then be saturated, leaving no space for handling data for the web interface.  You may have noticed that some stations are working fine, while others have problems.
It would be nice if some buffer space could be reserved for the webinterface.
I also tried to speed up the bitrate of the decoder a little when the buffers are filling up, but it did not work in my case.  An other approach might be to skip frames in this case, but I haven't tried that.
A final solution is to use 2 a separate ESP for the webinterface....

Edzelf, 2017-05-23:
ESP32 version is released.  Performance seems much better with multiple TPC connections.

GabeHC, 2017-06-23:
You are amazing!
No more lost control while playing M3U MP3. Web interface response almost instantly.
Thank you so much.

One Question thought: my VS1053 MP3 shield SD card mounting fails, it works fine on 5V arduinos. could it be logic level issues?

Edzelf, 2017-06-23:
Sounds like a wiring error.  Have you tried different SD cards?

jgrulich, 2018-01-10:
I've found that when disabled ArduinoOTA, it improves significantly the web response and overall stability.
BTW, HTTPUpdate may be better choice for OTA.

Thread 68 (2017-04-10):

Analog Input

hcremer, 2017-04-10:
I made some tests with analog input switches. My ESP-12F always reads 1024 when the voltage is over 1 V. So I needed to add a 15k resistor between 3.3V and the analog circuit.
Are other ESP's reading 0 - 3.3V with the same software?

Edzelf, 2017-04-11:
Yes, some models will measure 0-1 Volt, other 0-3.3V.  In your case you have to lower the resistor in the ladder that is connected to ground to about 2.7 kOhm.
You can use the web-interface or the serial interface to monitor the ADC reading.

hcremer, 2017-04-11:
Thank you very much for the quick answer!

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

NonaSuomy, 2017-05-08:
I did a simulation here [analog read 3.3v](http://www.falstad.com/circuit/circuitjs.html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)

[analog read 1v](http://www.falstad.com/circuit/circuitjs.html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)

If you change R5 to anything under 4.3k you will be in the 1v range.

NonaSuomy, 2017-05-09:
Any chance @Edzelf can add something to the documentation about this as a lot are 1v analog read.

Edzelf, 2017-05-09:
Fixed.

NonaSuomy, 2017-05-09:
Thank you.

Closed 2017-06-08.

Thread 69 (2017-04-12):

SPI problem with ESP32

madjid13, 2017-04-12:
hello,

I have a problem with my esp32 i have bought to aliexpress:
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

When i connect it to my sd card spi interface, i have this message in my serial windows arduino:
ets Jun  8 2016 00:22:57

rst:0x1 (POWERON_RESET),boot:0x33 (SPI_FAST_FLASH_BOOT)
ets Jun  8 2016 00:22:57

rst:0x10 (RTCWDT_RTC_RESET),boot:0x33 (SPI_FAST_FLASH_BOOT)
configsip: 0, SPIWP:0x00
clk_drv:0x00,q_drv:0x00,d_drv:0x00,cs0_drv:0x00,hd_drv:0x00,wp_drv:0x00
mode:DIO, clock div:1
cmd len -1
Falling back to built-in command interpreter.
OK
>ets Jun  8 2016 00:22:57

rst:0x10 (RTCWDT_RTC_RESET),boot:0x33 (SPI_FAST_FLASH_BOOT)
configsip: 0, SPIWP:0x00
clk_drv:0x00,q_drv:0x00,d_drv:0x00,cs0_drv:0x00,hd_drv:0x00,wp_drv:0x00
mode:DIO, clock div:1
cmd len -1
Falling back to built-in command interpreter.
OK
>ets Jun  8 2016 00:22:57

rst:0x10 (RTCWDT_RTC_RESET),boot:0x33 (SPI_FAST_FLASH_BOOT)
configsip: 0, SPIWP:0x00
clk_drv:0x00,q_drv:0x00,d_drv:0x00,cs0_drv:0x00,hd_drv:0x00,wp_drv:0x00
mode:DIO, clock div:1
cmd len -1
Falling back to built-in command interpreter.
OK
Could helpppp me, thanks!!!!

Edzelf, 2017-04-13:
Sorry, I do not own any ESP32.  I will order one from Ali.
The ESP-radio software is designed for ESP-12.

madjid13, 2017-04-13:
Thanks

Le 13 avr. 2017 9:47 AM, "Ed Smallenburg" <notifications@github.com> a
écrit :

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

andybrk, 2017-04-27:
I did check the SW (with modifications) under ESP32. (without Web interface yet)
I move the SPIFFS to the SD card and this has absolutely no problems.  May be you have a hardware issue.
The problem with the ESP32 is different:
Have to modify the timer (no problem)
All seems to work, but no sound (I suppose the ESP32 is more slowly under Arduino, but I'm still investigate)
The WIFI and web functions are complete different (should not be a problem but hard work)

madjid13, 2017-04-27:
Thanks a lot
I will try again.
Have a nice day.

Le 27 avr. 2017 3:53 AM, "andybrk" <notifications@github.com> a écrit :

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

Edzelf, 2017-04-27:
Got my ESP32 now.  I'm working on the ESP32 version.  Fixing the webinterface is quite a job.

andybrk, 2017-04-27:
The speed is real a problem, too. I did measure this sub with a scope:  putring ( mp3client.read() ) ;
need for esp8266 7us and for the esp32 80us about (include digitalWrite). For the esp32 is missing the "user_interface.h". This could be the reason that the SW can't use direct the espressif libraries

madjid13, 2017-04-27:
Edzelf:please if you have the same esp32 iot from Aliexpress, could tell me exactly how sdcard

madjid13, 2017-04-27:
Is working and share schematics pinout.
Thanks 🤔

Edzelf, 2017-05-23:
ESP32 version is released!

Thread 70 (2017-04-23):

Fun: Python script to send URLs from streamtheworld.com (iheartradio) to esp-radio player.

NonaSuomy, 2017-04-23:
Send a radio station to your esp-radio player: [GIST](https://gist.github.com/NonaSuomy/5f09f76d60e30ad127230cf22709f986)

Simple script, at the top of the script, is the usage example, basically, find a radio station on iheartradio:

[iheartradio station list USA](https://en.wikipedia.org/wiki/List_of_radio_stations_owned_by_iHeartMedia)
[iheartradio](http://www.iheartradio.com)
[iheartradio Canada](http://www.iheartradio.ca)

Look at the source code of the iheartradio page (click on song history will help a bit) you will find things like this in it:

view-source:http://www.iheartradio.ca/all-stations/7.13793734?mode=history

```
<div class="delayed-image-load" data-class=""  data-src="/image/policy:1.1870492:1472654994/Trancid.jpg?f=default&$p$f=a34e00f&{width}" data-ratio="" data-alt="">

                                        <noscript>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</noscript>
                
        </div>

                    <div class="streamIcon">
                        <button class="stream-link stream-radio-station" data-ajax="true"
                                                        data-station-callsign="IHR_TRAN"
                                data-ad-unit="/5479/iheartradio.en/allstations"
                                data-ad-ss="radioplayer"
                                data-station-id="1.1870491"
                        >
                            <span class="ico ico-play">
                                <span class="ico load-hover"></span>
                            </span>
                        </button>
```

This is what we want:

```
data-station-callsign="IHR_TRAN"
```

IHR_TRAN is the callsign for the station you want to play. (Trancid)

Another stations callsign CIMXFM etc.

This is the radio station we are grabbing below from [iheartradio 89x "CIMXFM"](http://www.iheartradio.ca/89x)

```
Usage: python2 streamtheworldespradio.py CIMXFM 10.13.37.65
                                   ^Radio callsign  ^IP address of esp-radio Device
```
Make sure you have python2 and curl installed on the system you are sending the station from, download the script to a file on that device, then type the command, I named the script streamtheworldespradio.py, so type on the command line:

```
python2 streamtheworldespradio.py (The radio call sign + FM/AM on the end) (IP Address of your esp-radio Player)
```

First, test with the call sign above/below make sure it is all in CAPS as I know that one works (may not work outside of Canada), the hard part would be finding how they named the call sign for the station you want, and some may be location locked so be aware. Also add FM/AM on the end of the call sign or the script will complain "Callsign is missing FM, AM".

The script then tells the website to give us the ShoutCast stream URL for audio stream compatibility purposes with _SC.

```
python2 streamtheworldespradio.py CIMXFM 10.13.37.65
```

The script is grabbing the stream URL that is a randomly encoded string of characters for that station you want, then send the URL to the ESP8266.

The script requests a URL like this:
http://playerservices.streamtheworld.com/api/livestream?version=1.5&mount=CIMXFM&lang=en

Then it sends back an XML which we extract the values from:
```
<live_stream_config xmlns="http://provisioning.streamtheworld.com/player/livestream-1.5" version="1.5">
  <script/>
    <mountpoints>
      <mountpoint>
        <status>
          <status-code>200</status-code>
          <status-message>OK</status-message>
        </status>
        <transports>
          <transport>http</transport>
        </transports>
        <metadata>
          <shoutcast-v1 enabled="true" mountSuffix="_SC"/>
          <shoutcast-v2 enabled="false" mountSuffix="_SC"/>
          <sse-sideband enabled="true" streamSuffix="_SC" metadataSuffix="_SBM"/>
        </metadata>
        <servers>
          <server sid="18853">
          <ip>18853.live.streamtheworld.com</ip>
          <ports>
            <port type="http">80</port>
            <port type="http">3690</port>
          </ports>
        </server>
        <server sid="17023">
          <ip>17023.live.streamtheworld.com</ip>
          <ports>
            <port type="http">80</port>
            <port type="http">3690</port>
          </ports>
        </server>
        <server sid="13733">
          <ip>13733.live.streamtheworld.com</ip>
          <ports>
             <port type="http">80</port>
             <port type="http">3690</port>
          </ports>
        </server>
        <server sid="14213">
          <ip>14213.live.streamtheworld.com</ip>
          <ports>
            <port type="http">80</port>
            <port type="http">3690</port>
          </ports>
        </server>
      </servers>
      <metrics>
        <tag name="uuid"/>
      </metrics>
      <mount>CIMXFM</mount>
      <format>FLV</format>
      <bitrate>48000</bitrate>
      <media-format container="flv" cuepoints="stwcue">
        <audio index="0" samplerate="22050" codec="mp3" bitrate="48000" channels="2"/>
      </media-format>
      <authentication>0</authentication>
      <timeout>0</timeout>
      <send-page-url>0</send-page-url>
    </mountpoint>
  </mountpoints>
</live_stream_config>
```

The script extracts,

Random generated IP: 18853.live.streamtheworld.com
Port: 80, 3690, etc
MountPoint(callsign): CIMXFM

I noticed that there was ShoutCast compatibility in the XML which it shows to add "_CS" onto the mount point: CIMXFMAAC_CS

Then the script sends this data gathered from the XML to esp-radio device:

curl http://10.13.37.65/?station="18853.live.streamtheworld.com:3690/CIMXFMAAC_SC"

Then esp-radio should start playing the stream.

If you attach a serial cable to esp-radio you should be able to debug what URL is getting passed to it, to see if the station is getting sent properly.

Successful run should look like this on the serial line:

```
$ cu -l ttyUSB0 -s 115200
Connected.
D: Connect to new host 18163.live.streamtheworld.com:80/CIMXFMAAC_SC
D: Connect to 18163.live.streamtheworld.com on port 80, extension /CIMXFMAAC_SC
D: Connected to server
D: Expires: Thu, 01 Dec 2003 16:00:00 GMT
D: Cache-Control: no-cache, must-revalidate
D: Pragma: no-cache
D: Access-Control-Allow-Methods: GET, HEAD
D: Access-Control-Allow-Origin: *
D: Access-Control-Allow-Credentials: true
D: Set-Cookie: uuid=01e12b07-2b5b-4fe1-a009-0dd613569506; expires=Sat, 22-Dec-2029 21:30:41 GMT; path=
D: Content-Type: audio/aacp
D: Connection: close
D: icy-br: 40
D: icy-description:
D: icy-genre: Rock
D: icy-name:
D: icy-url: http://www.89xradio.com
D: icy-metaint: 16000
D: Server: MediaGateway 4.2.5-003
D: Switch to DATA, bitrate is 40
D: First chunk:
D: FF F1 5E 40 1D 5F FC 01
D: 58 15 25 0C C4 93 05 04
D: 21 5A F9 9F 77 44 F7 D5
D: F7 CD 6A B8 E5 75 15 08
D: Metadata block 48 bytes
D: Streamtitle found, 45 bytes
D: StreamTitle='Young the Giant - Silvertongue';
```

Hope it helps!

NonaSuomy, 2017-05-04:
[Integration](https://github.com/Edzelf/Esp-radio/issues/82)

Closed 2017-05-09.

Thread 71 (2017-04-24):

Can't send URLs with symbols "&" tried &amp; and %26 URL gets cut off.

NonaSuomy, 2017-04-24:
Example URL http://10.13.37.65/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

Console shows it got the url: http://api.voicerss.org/?f=32khz_16bit_stereo
I removed the & symbol and then it shows:
http://api.voicerss.org/?f=32khz_16bit_stereokey=29334415954d491b85535df4eb4dd821
etc... I tried to use url escape codes but they have symbols in them that it doesn't like as well so they get cut off, ie &amp; and %26.

Also tried to send a URL with & in it from the website send box and it did the same thing, I will test the console commands next.

Edzelf, 2017-04-24:
Your "station"-command is probably too long (159 characters).  Try to increase the size of "cmd" from 130 to 200 and the value of "DEBUG_BUFFER_SIZE" to 200.
Note that there is no need to include "http://" in the station command (saves another 7 bytes..).

NonaSuomy, 2017-04-24:
I'll give that a shot increasing those values, does it start counting after = or station= included or is the entire URL included?

```
http://10.13.38.65/?station=
?station=http://api.voicerss.org/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
```

Equals 155 Characters: [letter counter](http://www.lettercount.com/)

Also
```
station=http://api.voicerss.org/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
```
Works from the serial interface but
```
http://10.13.38.65/?station=
?station=http://api.voicerss.org/?f=32khz_16bit_stereo&key=29334415954d491b85535df4eb4dd821&hl=en-us&src=hello
```
Count: 139 (Full URL)

Doesn't work from the web browser, will increasing that debug_buffer_size help that?

Maybe there is not enough memory on the ESP8266 to handle this but valid URLs can be as long as 2000 characters give or take for most standard web browsers.

Excerpt from (SOF)[http://stackoverflow.com/questions/417142/what-is-the-maximum-length-of-a-url-in-different-browsers]

[RFC 2616](http://www.faqs.org/rfcs/rfc2616.html) (Hypertext Transfer Protocol HTTP/1.1) section 3.2.1 says
```
The HTTP protocol does not place any a priori limit on the length of a URI. Servers MUST be able to handle the URI of any resource they serve, and SHOULD be able to handle URIs of unbounded length if they provide GET-based forms that could generate such URIs. A server SHOULD return 414 (Request-URI Too Long) status if a URI is longer than the server can handle (see section 10.4.15).
```

That RFC has been obsoleted by [RFC7230](http://tools.ietf.org/html/rfc7230#section-3.1.1) which is a refresh of the HTTP/1.1 specification. It contains similar language, but also goes on to suggest this:

```
Various ad hoc limitations on request-line length are found in practice. It is RECOMMENDED that all HTTP senders and recipients support, at a minimum, request-line lengths of 8000 octets.
```

NonaSuomy, 2017-04-24:
Not sure if this helps any,

<Rickta59> https://github.com/me-no-dev/ESPAsyncWebServer/blob/master/src/WebRequest.cpp#L244
<Rickta59> that seems to be where it starts parsing the args
<shbrngdo> I'm just anticipating the usual problems that show up on a) microcontroller b) trying to be a web server c) the way networking behaves sometimes when you can't have large buffers
<Rickta59> this seems to be where it parse out each arg ... I don't see any limit https://github.com/me-no-dev/ESPAsyncWebServer/blob/master/src/WebRequest.cpp#L206
<shbrngdo> how much RAM is available on that device (esp8266) anyway
<Rickta59> lots
<NoSu> Rickta59, in the esp-radio ino I think host only holds the first part of the URL before /
<shbrngdo> well, lots = megabytes, or ?
<Rickta59> 10s of k
<shbrngdo> ok, so a URL line should be "bufferable" before parsing it.  I assume it's re-assembled from the MTU 'chunks' properly?
<NoSu> 45k
<Rickta59> I would put some debug prints in the _parseReqHeader routine and see if you are receiving the entire string
<shbrngdo> ^^^ yes
<Rickta59> if that is true .. then keep dive deeper and deeper until you find where it is chopped
<Rickta59> from what I see here it seems like there is no limit
<Rickta59> you might send a bogus arg after the station= ...
<Rickta59> something like &argends=1
<Rickta59> so the parse routine can see the end of your tts string
<shbrngdo> the other thing to consider, when an HTTP request is sent, it's a whole boatload of crap to wade through
<Rickta59> he is just looking at a get request  ...
<shbrngdo> you could easily exceed an MTU with the first chunk, which might cause your URLs to be truncated
<Rickta59> the info he needs is on the first line
<shbrngdo> right it's a GET request but it is HTTP/1.1 ?
<Rickta59>  I don't know how the esp webserver works
<shbrngdo> use nc to listen on a port, and do a simple GET request from firefox to your nc application.  watch the output.
<Rickta59> he is using a web browser to send the url
<shbrngdo> I'm anticipating that the web browser's request has a boatload of cruft in it, which may exceed the MTU, causing the request to be truncated if it's not re-assembled into a buffer
<shbrngdo> or it might exceed a buffer size that's too small
<shbrngdo> one nice test would be to send an HTTP/1.0 request, by hand, using nc or similar utility
<Rickta59> do you have any long real mp3 stations NoSu ?
<Rickta59> are they limited to 130 bytes?
<Rickta59> or is it just the ip address of the shoutcast station?
<NoSu> that's a hard one as most stations are just a url:port/mp3
<NoSu> most people don't have massivedomainnamegarbledygook123408230948etc.com domain names
<Rickta59> right ..
<Rickta59> https://github.com/Edzelf/Esp-radio/blob/master/Esp_radio.ino#L2476
<Rickta59> that does seem to limit the length of the string
<Rickta59> you are co-opting the station thing ...
<Rickta59> might be better to deal with it differently
<Rickta59> as it assumes you are only going to be using a short string
<Rickta59> make it "speakmsg" or something ...
<Rickta59> then implement it similar but use different buffers
<shbrngdo> I did a quick check - entering the example URL from earlier, I got a 492 byte HTTP/1.1 request.  but that's on my machine.  not sure what other browsers might do.  But the URL was at the beginning, so overrun might not be relevant.
<Rickta59> https://github.com/Edzelf/Esp-radio/blob/master/Esp_radio.ino#L2583
<Rickta59> seems like that line, you could corrupt memory if you send a really long string
<shbrngdo> ouch - nice find then
<Rickta59> and then it just be acting weird not because it truncates the get arg .. but because memory has become corrupt
<shbrngdo> exactly - buffer too small?
<shbrngdo> I hadn't considered buffer overrun [assuming that much was obvious... guess not]
<NoSu> do you mean if you comment out that sprintf statement it might just work with more chars
<NoSu> characters
<NoSu> as it did crash one time when I sent it a long URL
<NoSu> then when it rebooted I sent it again and it played.
<shbrngdo> that would make sense, yeah.  sprintf if using '%s' and similar is likely to overrun with unexpected data.  'snprintf' helps

NonaSuomy, 2017-04-25:
so tried with DEBUG_BUFFER_SIZE set to 200 still works from the console to a max of
```
D: Connect to new host api.voicerss.org/?f=32khz_16bit_stereo&key=29334415954d491b85535df4eb4dd821&hl=en-us&src=hello-this-is-that-extended-par
D: Connect to api.voicerss.org on port 80, extension /?f=32khz_16bit_stereo&key=29334415954d491b85535df4eb4dd821&hl=en-us&src=hello-this-is-that-extended-par
```
Character Count 128

Basically the same as before, from the serial console, and through the web interface it still doesn't work.

NonaSuomy, 2017-04-25:
Got it working with _POST instead of the GET url, it definatly trunicates the url because of the ampersand as first questioned.

**SEND FROM _POST**
```
curl --data "station=api.voicerss.org/?f=32khz_16bit_stereo%26key=29334415954d491b85535df4eb4dd821%26hl=en-us%26src=hello-this-is-that-extended-part-two-woot-woot-chaboogie" 10.13.38.65
```

Post as well first didn't work and cut off the URL at the ampersand, but the one thing post allowed was escaping the ampersands with %26 which using the web URL didn't.

NonaSuomy, 2017-04-27:
This is what I got working so far:
[OpenHab](http://www.openhab.org) is Home Automation Software
[ESP-Radio with Text To Speech for OpenHab](https://gist.github.com/NonaSuomy/8a41816defe7b3d918c147d9d274c101)
Next I may try to get the stations changing channels through OpenHab.

Thread 72 (2017-04-24):

set volume for each main loop pass?

andybrk, 2017-04-24:
In the actual SW will change the volume each main loop pass.
I think its better to do it so to lost not so much of time:

  bool           old_muteflag;
......
  if (!( muteflag == old_muteflag )) {
    old_muteflag = muteflag;
    if ( muteflag ) {                                   // mute / unmute
      vs1053player.setVolume ( 0 ) ;                    // Mute
    } else {
      vs1053player.setVolume ( ini_block.reqvol ) ;     // Unmute
    }
  }

Edzelf, 2017-04-24:
The requested volume will be written to the VS1053 register only if there is a change.  If nothing chnges, setVolume returns without any action.
Check the code of "setVolume".

andybrk, 2017-04-24:
Ok, this I didn't see. But you save the sub routine call if you catch this case in the main. I don't know which and how many registers will safe the ESP SW for a call. I did not analyse the timing if this could be  important or not. I suppose the ESP has much to do. ;-)
Just I try understand the SW to make this SW for the ESP32.

Edzelf, 2017-04-24:
Note that "volume"-, "upvolume"- and "downvolume"-commands will not work anymore with your code.
The function call will probably take less than 0.5 microseconds and even a delay of several milliseconds will not harm in the mail loop.
I will get my ESP32 next week (I hope) and I will try to make e Esp-radio for it.

andybrk, 2017-04-26:
You are right. This I didn't see.
I had in my mind that we need 50us about to put one byte to the VS1053 for higher bit rate. But the filling of the VBS103 is running in the both first wile loops of the main loop. So we have much of time. ;-)
If you can make this SW for the ESP32 this would be fine. My planning is to use a SD card for the mp3 files, the configuration and the websites. So we can have a fine mpeg player. I want t use this with a touch screen.
The other idea is, make a mod for the ESP8266 and remove GPIO9 and 10 from the flash. Then we have enough GPIOs for an additional SD card. (use the same SPI) but not for a touch screen.

Closed 2017-04-26.

Thread 73 (2017-04-25):

Get Current Station ID

Sander0542, 2017-04-25:
Hi,

I am the developer of the ESP Radio App, and I would love to have a option to get the current preset id.

Regards,
Sander

Sander0542, 2017-04-25:
or when you do this:

`http://192.168.178.24/?uppreset=1`

that it says `current preset is 3` instead of `command accepted`

Edzelf, 2017-04-26:
Fixed.  Output will look like: "Preset is now 6"

Sander0542, 2017-04-27:
Thanks you so much!

This is very hard needed for the tablet app

Sander0542, 2017-04-30:
I just installed the update, but when you are on preset 0 and go prev I go to -1 and then -2

Edzelf, 2017-05-01:
If the preset is out of range (like -1), the software will detect "no data" and will switch to the next higher preset.
I realize that the selected preset is not reflected to the app automatically.

NonaSuomy, 2017-05-13:
ok will do, I cleaned it up a bit, and then found out it sends blank values just fine :+1: also changed it so it didn't retain and had QoS of 0 in case those things were causing the connection drop and no luck still dropped the connection.

Here's the  refactored code: [GIST](https://gist.github.com/NonaSuomy/e50cfdf079fe1bbbcac30a381e34fd93)

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

Thread 74 (2017-04-27):

Request: First time boot with no radio.ini start up in wireless ad-hoc mode.

NonaSuomy, 2017-04-27:
Any chance you could make so the esp8266 starts up in ad-hoc mode if there's no radio.ini then the person could configure their AP then save a radio.ini for next boot.

Edzelf, 2017-04-28:
Esp-radio was designed to start up in AP mode if no ini-file is found.  I must admit I did not test this thoroughly.

NonaSuomy, 2017-04-28:
Ok I will test again, I somehow got stuck where it spammed the serial console with messages that it couldn't find the ini, but once I figured out how to upload the data folder with the arduino ide it started to work so didn't try it again.

NonaSuomy, 2017-05-02:
Ok so I was able to see the AP, but when I connect to Esp-radio with the password Esp-radio it connects and then when I try to go to the url in the browser 192.168.4.1 I html source code:

```
q.statusText ;
          }
        }
        oReq.send ( oData ) ;
        return false ;
      }

      // Fill configuration initially
      // First the available WiFi networks
      var i, select, opt, networks, params ;

      select = document.getElementById("selnet") ;
      var theUrl = "/?getnetworks=0" + "&version=" + Math.random() ;
      var xhr = new XMLHttpRequest() ;
      xhr.onreadystatechange = function() {
        if ( xhr.readyState == XMLHttpRequest.DONE )
        {
          networks = xhr.responseText.split ( "|" ) ;
  
          for ( i = 0 ; i < ( networks.length - 1 ) ; i++ )
          {
            opt = document.createElement( "OPTION" ) ;
            opt.value = i ;
            opt.text = networks[i] ;
            ssid.add( opt ) ;
          }
        }
      }
      xhr.open ( "GET", theUrl, false ) ;
      xhr.send() ;

      // Now get the configuration parameters from radio.ini
      theUrl = "/radio.ini" ;
      xhr.onreadystatechange = function() {
        if ( xhr.readyState == XMLHttpRequest.DONE )
        {
          inifile.value = xhr.responseText ;
        }
      }
      xhr.open ( "GET", theUrl, false ) ;
      xhr.send() ;
    </script>
    <script type="text/javascript">
      var stylesheet = document.createElement('link') ;
      stylesheet.href = 'radio.css' ;
      stylesheet.rel = 'stylesheet' ;
      stylesheet.type = 'text/css' ;
      document.getElementsByTagName('head')[0].appendChild(stylesheet) ;
    </script>
  </body>
</html>
```

Edzelf, 2017-05-03:
Fixed: New version will no longer try to connect if no Internet connection.
The fact that you see the source code cannot reproduced here.
Check your config_html.h file.

NonaSuomy, 2017-05-09:
Thanks, nothing was wrong with config_html.h probably had something to do with corrupt SPIFFS or memory overflow. After reflashing SPIFFS it has yet to dump the code, I have yet to have it dump the code again. Have yet to get AP properly working though, will keep looking and report back after playing with other items.

Edzelf, 2017-05-10:
Yes, SPIFFS is not very reliable.  For that reason there is a "testfile" function available in the radio.  Specially for long files it will show read problems.

robpan3, 2017-11-14:
I´m sorry, but I don´t understand where the file "radio.ini" man must put.
The error on "serial monitor" is "File /radio.ini not found!"
Thanks a lot for any help.
Roberto
Italy

Edzelf, 2017-11-14:
Roberto, the radio.ini file must be transferred to the SPIFFS.  It should be in your "data" subdirectory an can be uploaded by the IDE,  menu tools-> ESP8266 Sketch Data Upload.

robpan3, 2017-11-14:
Thanks a lot, ED for your suggestions.
I have read with "attention" your PDF of the project.
I have create a folder "Tools" instead "tools".  I think is was the problem.
Now I understand someting more about SPIFFS.
Thanks very much for your speed answering.
Your project is fantastic.  I hope (I'm sure)  to complete all.
Thanks.
Roberto
Aosta
Italy

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

robpan3, 2017-11-14:
"ESP8266 Sketch Data Upload" on Arduino IDE
Perfect!  Thanks!

Edzelf, 2017-11-14:
I meant the Tools option/tab in the IDE, not a folder.....

robpan3, 2017-11-15:
Again a little question.
You said that you use **14148** Diodes (in the page https://github.com/edzelf/esp-radio/issues/8). I think you use **1N4148**.
But can I use 1N4007 instead? I already have it at home.
I 'm already able to receive my preferred station (without audio), only on serial monitor.
I'm already satisfied for the moment.  But I am beginner! I'm studiing also the SPIFFS.
Excuse me for my poor english.
Thanks again!
And again many many compliments for your complex and big big project!
Roberto
Italy

Edzelf, 2017-11-15:
The reset circuit is not really necessary.  Just connect the reset line of the VS1053 to the reset line of the ESP6288.
If you like, any diode will do, but keep the lines short, as the radio signals of the wifi may cause a DC signal on the diodes.

robpan3, 2017-11-16:
Thanks, Ed!

atacanteknik, 2017-11-19:
i add diodes  on vs1053 its very simple

robpan3, 2017-12-14:
Hallo Ed,
I have almost realized the Espradio without the display. But it RUN!!!! You have made a SUPER SUPER Project!
I don't have time for hobby because my job!!
I don't have the precise TFT display of the project.
Can I use the Nokia 5110 instead?
If not, I wait from China the correct component.
Thanks a lot!
How can I contribute for your project/projects?
I'm very satisfied!!
Roberto
Aosta
Italy

Edzelf, 2017-12-14:
The 5110 is very limited.  It is worth the trouble of waiting for a better display.  Order a ESP32 as well, because it is much better than the 8266.

Birdstreet, 2018-01-25:
Compressing the .html  .css  and javascript part of the .html files of the web UI make the radio work more stable in AP mode. No partly loaded content issue.

olavsson, 2018-02-16:
How do you compress the .html .css and javascript part of the .html files?

Edzelf, 2018-02-16:
@Roberto. A small donation on my paypal account (ed@smallenburg.nl) will be welcome of course.

msafu2668, 2019-07-15:
hi Ed..I am first here.. where to put the data folder..?

Edzelf, 2019-07-16:
In the same directory where the sketch (the .ino file) is located.

bnicolae86, 2023-07-13:
I cannot make it work. The `data `folder is located on the same directory but I still receive this message: `File /radio.ini not found!
` . Maybe that's why the wifi connection is not working. I modified `radio.ini `  and put it inside data folder.

Edzelf, 2023-07-16:
Yes, the file radio.ini should be in the data folder.

bnicolae86, 2023-07-16:
> Yes, the file radio.ini should be in the data folder.

I wrote a sketch to read the file from SPIFFS and the file radio.ini is present,  I can view its content. But when I upload esp radio sketch I receive this message, radio.ini file not found. Maybe is something that I'm doing wrong.

Edzelf, 2023-07-16:
Please show the error message and the surrounding texts.

bnicolae86, 2023-07-17:
> Please show the error message and the surrounding texts.

After sketch upload I push also the radio.ini file

```
[SPIFFS] data    : C:\Users\user\Downloads\esp-radio\Esp_radio\data
[SPIFFS] size    : 3048
[SPIFFS] page    : 256
[SPIFFS] block   : 8192
/radio.ini
[SPIFFS] upload  : C:\Users\user\AppData\Local\Temp\arduino_build_930043/Esp_radio.spiffs.bin
[SPIFFS] address  : 0x100000
[SPIFFS] reset    : --before default_reset --after hard_reset
[SPIFFS] port     : COM3
[SPIFFS] speed    : 115200
........
Configuring flash size...
Auto-detected Flash size: 4MB
Compressed 3121152 bytes to 5246...
Writing at 0x00100000... (100 %)
Wrote 3121152 bytes (5246 compressed) at 0x00100000 in 0.5 seconds (effective 53831.0 kbit/s)...
Hash of data verified.
```

radio.ini file cannot be found
```
D: FS Total 3121152, used 16384
D: File /radio.ini not found!
D: * Scan Networks *
D: Number of available networks: 6
...
D: File /radio.ini not found, use save command to create one!
D: Starting ESP Version Fri, 11 Feb 2022 13:05:00 GMT...  Free memory 22880
D: Sketch size 443120, free size 602112
D: Reset VS1053...
D: End reset VS1053...

Edzelf, 2023-07-17:
Ther is something wrong with the file upload.  You should see something like:
```
D: FS Total 1024000, used 24576
D: radio.ini                        -    1765
```
If you can connect using the network "Esp-radio" at 192.168.4.1, you may paste the contents of radio.ini in the config page, edit it and save it.

bnicolae86, 2023-07-17:
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

I tried that but my ESP keeps rebooting with a message like this:
```
--------------- CUT HERE FOR EXCEPTION DECODER ---------------

>>>stack>>>

<<<stack<<<

--------------- CUT HERE FOR EXCEPTION DECODER ---------------

Thread 75 (2017-04-27):

Request: Optional SRAM instead of ring buffer

NonaSuomy, 2017-04-27:
[23LC1024](http://www.microchip.com/wwwproducts/en/23LC1024)
[23LCV1024](http://www.microchip.com/wwwproducts/en/23LCV1024)
[PDF 23LC1024](http://ww1.microchip.com/downloads/en/DeviceDoc/20005142C.pdf)
[PDF 23LCV1024](http://ww1.microchip.com/downloads/en/DeviceDoc/25156A.pdf)

I've tested samples of these parts from Ti with Ka-Radio and they work.

23LC1024 has Vhold <== using this one.
23LCV1024 has VBAT

*Note: If your chip has a /Vhold in place of /VBAT, the pin 7 must be wired to VCC (pin8)* instead of pin 7 to GND for the V series..
*Note2: Pin3 is not used in SPI mode and should not be left floating on the 23LC1024 (23LCV1024 pin3 is N/C).

1:CS = GPIO16
2:MISO = GPIO12
3:NC = VCC 3.3v
4:GND
5:MOSI = GPIO13
6:SCK = GPIO14
7:VCC 3.3v
8:VCC 3.3v

andybrk, 2017-04-27:
For what? I think the internal ram is much more faster than a ram on the SPI interface. We  have to transfer one byte for max bitrate  (320kb) in 25us about.

Edzelf, 2017-04-27:
Additional RAM will not have any effect on the performance of Esp-radio.  The firmware will still use the limited TCP buffers.

NonaSuomy, 2017-04-27:
What are the TCP buffers limited to?

Edzelf, 2017-04-27:
The buffers are allocated by the Espressive firmware.  There's no way to add extra buffers.
So when the mp3-stream fills up all available buffers, communication with the webinterface and/or mqtt will be blocked.  Some stations send more data than the VS1053 can handle.  This causes the TCP input-buffers to saturate.
I'm working on the ESP32 version now.  Maybe this one has a better schema for using the TCP input buffers.

NonaSuomy, 2017-04-27:
Thanks for the explanation, well I hope you still work on the esp8266 version as it has the lowest entry point currently and seems to work well so far, also glad you did it with Arduino, do you happen to know why when trying to play a small sample of say 1 second or few seconds around that it starts of choppy in the audio? When I tell it to stream the Text To Speech files it sometimes chops the first few words up a bit. Any way you can think to prevent it?

h1aji, 2021-05-24:
Hi @Edzelf
I found this project [ESP8266Audio](https://github.com/earlephilhower/ESP8266Audio ) where SRAM is being used.
Can you tell what is done differently there? Is there any chance to use that approach for Esp-radio?
Thanks

Edzelf, 2021-05-24:
I don't know what the problem is with your radio, but I think extra memory will not help to fix it.  In fact, the ringbuffer can be extended, as it is not using all of the available memory.

h1aji, 2021-05-25:
The issue is interruptions when the radio works. Only low bitrates works fine, like 64. I checked the antenna and it seems fine.
I have seen also on Karadio project optional SRAM which improves this situation

Edzelf, 2021-05-25:
I do not think the lack of memory is the problem.  Please give me the station that is causing the problem, so I can try to reproduce the error.

h1aji, 2021-06-05:
for example this one: http://orion.shoutca.st:8554/stream

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

Edzelf, 2021-06-07:
I was able to reproduce the problem.   I guess 320 kbps is to much for the processor.  The ESP32 version of the radio will play this station without problems.

h1aji, 2021-06-07:
Would it be possible to add support for 23LC1024 SPI RAM? like descirebed in this project [ESP8266Audio](https://github.com/earlephilhower/ESP8266Audio)

> Using external SPI RAM to increase buffer
A class allows you to use a 23lc1024 SPI RAM from Microchip as input buffer. This chip connects to ESP8266 HSPI port and provides a large buffer to help avoid hiccus in playback of web streams.

I have got this SRAM chip and keen to test. Say if it could be added as USESRAM option.

I created fork and modified your code slightly to work with LCD 2004 and IR receiver
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

Edzelf, 2021-06-07:
As I said, the memory is probably not the problem.  And I dont think SPI memory will be faster than internal RAM.

h1aji, 2021-06-13:
What is the maximum value for RINGBFSIZ ?

>  And I dont think SPI memory will be faster than internal RAM.

In this case question is not speed but buffer size, having an extra 1Mb buffer should store 3 seconds if you play 320kbits/s mp3 stream. You can see it in Ka-radio project (also in ESP8266Audio), and people reported (on russian forum) that it fixed issues with hiccups.

Edzelf, 2021-06-13:
The TEST button in the webinterface will tell you the amount of free memory.  Increase the ring buffer size accordingly.

h1aji, 2021-07-12:
@NonaSuomy would you be able assist with testing code for spi ram?

Thread 76 (2017-04-28):

EarSpeaker spatial processing

Sindi1, 2017-04-28:
Hi,

first of all - thank for the great project!

Sound is great while using headphones. But using an amplifier with speakers 4 meters away from each other stereo sound is not very good. Compared to my web radio on the phone I was a little bit disappointed.
Checking the data sheet  for the VS1053 I think I found the reason:
"For the best headphone listening experience the VS1053 includes EarSpeaker spatial processing which accurately simulates how a room with stereo loudspeakers would sound. This option can naturally be turned off when required."

So my question is: Is there an option to turn this feature on / off? Would be great!

Second question: Has anybody a solution for running ESP / VS1053 and an amplifier with grounded audio input on same power ground?

Regards,
Bernd

andybrk, 2017-04-28:
The problem is that the VS1053 have not GND related outputs. I think the best solution is a preamplifier with differential inputs or use a small NF transformer betwen the VS1053 and your amplifier.
In default (see 3.6.1) is the spartial prcessing is on (default 0x4800). But the SW do switch off that in line 568. ( write_register ( SCI_MODE, _BV ( SM_SDINEW ) | _BV ( SM_LINE1 ) ) ; in VS1053::begin() )

Sindi1, 2017-04-29:
Tahnks. So how should the line look like to turn spartial prcessing on?

andybrk, 2017-04-29:
First has to define first the new used bits: (add after line 333)
const uint8_t SM_EARSPEAKER_LO          = 4 ;        // Bitnumber in SCI_MODE for spatial processing L
const uint8_t SM_EARSPEAKER_HI           = 7 ;        // Bitnumber in SCI_MODE for spatial processing H

Then in line 469 ( 3 possibilities)
minimal spatial processing:
( write_register ( SCI_MODE, _BV ( SM_SDINEW ) | _BV ( SM_LINE1 ) | _BV (SM_EARSPEAKER_LO) ) ;
normal spatial processing:
( write_register ( SCI_MODE, _BV ( SM_SDINEW ) | _BV ( SM_LINE1 ) | _BV (SM_EARSPEAKER_HI)  ) ;
extreme spatial processing:
 ( write_register ( SCI_MODE, _BV ( SM_SDINEW ) | _BV ( SM_LINE1 ) | _BV (SM_EARSPEAKER_LO) | _BV (SM_EARSPEAKER_HI ) ) ;

But I doesn't think that this is your problem.

Edzelf, 2017-04-29:
Sounds like this is a problem of the amplifier.  Note that the VS1053 has no grounded common for the output signals.  So you have to supply a separate power supply or use audio  transformers, 40 cents a piece on aliexpress.

Sindi1, 2017-04-29:
Thanks. I know that VS1035 has no grounded common. For now I am using separated power supplies.
I thought there might be an easy way like putting a capacitor between the output common and the amplifiers grounded input.

First  "problem" was the (stereo) sound compared to another webradio / source. Sounds a little bit like one reverse polarity speakers and I thought this might be the spatial processing. The headphone sound was so good, the amplifier / speaker combination also when using a different source.

So I will have to make some more comparison.

Sindi1, 2017-05-01:
I was a problem of the speakers and the distance between them. And the basement is no a good place to do a sound check.

Kestranor, 2017-06-12:
Sorry to hijack this thread, but I have a sound problem when connecting to a class D amplifier as well, even using separated power supplies it comes out very distorted and seems to be somewhat slowed as well. Is there a recommended way to connect the jack output from the VS1053 to a class D amplifier?
Thanks.

Edzelf, 2017-06-12:
Make sure that it works correctly with earphones.  Then make sure that the ground of the VS1053 is NOT connected to the ground of the amplifier or its power supply.  Th "middle" connection of the analog output of the VS1053 must be connected to the ground of the amplifier an its power supply.

Thread 80 (2017-04-30):

Diodes have to be schottky

andybrk, 2017-04-30:
Just I found why I had so much problems that the SW can't write any registers. (volume change doesn't work and so on)
I mad tests and found that if I uncomment the calls of "printDetails" then all registers of the vs1053 shows allways 0.
I try to put the reset pin on an extra port of the ESP8266 and modify the reset of the VS1053 for that. This works fine.
So I began to investigate and found that the high level on the reset port of the VS1053 with the diodes seems a little bit to low. I did use universal diodes 1N4848 for that. I did change the resistor from 1k to 10k, but this was not successful
As I replace this diodes with schottky type (1N 5817, just I had in my stuffs) then it works fine.
May be I have a bad exemplar of the VS1053, but for security should use schottky diodes for the reset circuit. Also I did change the resistor from 1k to 10k.

Edzelf, 2017-05-01:
Using Shottky diodes is a good idea.  You may omit the reset circuit.  Just add a pull-up on XRST.  Or connect it to the reset line of the ESP8266.

Closed 2017-06-17.

Thread 82 (2017-05-02):

Integrating IHeartRadio into ESP-Radio Arduino Code

NonaSuomy, 2017-05-02:
I started attempting to integrate IHeartRadio XML Parsing into ESP-Radio, but hit a bump in the Parsing code works outside of ESP-Radio but doesn't seem to be able to trigger mp3client inside ESP-Radio code base.

[Diff](https://www.diffchecker.com/hQtU7A7s) Line 1070 on the right of the Diff is where it tries to open the stream of data for XML content parsing.

XMLParsingTest.ino:
[GIST .ino](https://gist.github.com/NonaSuomy/3f35d98e9a0b5cb0054cec44923ee427)
Working...

Testing in ESP-Radio:
[https://github.com/NonaSuomy/Esp-radio/blob/NonaSuomy-XML-Parser/Esp_radio.ino](https://github.com/NonaSuomy/Esp-radio/blob/NonaSuomy-XML-Parser/Esp_radio.ino)

Gets stuck at line 1070
```
  if (mp3client.connect (ihrhost, xmlPort ) ) {
```

I tried to make a second client called xmlclient instead of mp3client and got the same results (nothing).

Any help would be appreciated!

NonaSuomy, 2017-05-03:
Enabled Debug Core+WiFi over serial and got some further information...

Connecting to url http://playerservices.streamtheworld.com:80/api/livestream?version=1.5&mount=CIMXFMAAC&lang=en
[hostByName] request IP for: playerservices.streamtheworld.com
[hostByName] Host: playerservices.streamtheworld.com lookup error: -5!
Not Connected to IHR
D: STOP requested
D: Song stopped correctly after 10 msec
D: Connect to new host
D: Connect to  on port 80, extension /
[hostByName] request IP for:
[hostByName] Host:  lookup error: -12!
D: Request  failed!

Edzelf, 2017-05-03:
Line 1070 is called during the "setup()" phase.  At that moment there is no Internet connection, so a DNS lookup will always fail.
The function "iheartradio" is called from "analyzeCmd".  Within "analyzeCmd" no timely actions are permitted as it will run mostly asynchronously to the main loop.

NonaSuomy, 2017-05-03:
Thanks for the tip!

[Show Diff](http://www.mergely.com/ay1A6BS8/)
[GitHub .ino ESP-Radio with XML-Parser](https://github.com/NonaSuomy/Esp-radio/blob/NonaSuomy-XML-Parser/Esp_radio.ino)

```
D: Command: xml with parameter IHR_TRAN
D: STOP requested
D: Stopping client
D: Song stopped correctly after 0 msec
D: Connect to new host: IHR_TRAN
D: Connecting to url: http://playerservices.streamtheworld.com:80/api/livestream?version=1.5&mount=IHR
[hostByName] request IP for: playerservices.streamtheworld.com
[hostByName] Host: playerservices.streamtheworld.com IP: 208.92.55.74
D: Connected!
D: XML parser processing...
D: Found: 18073.live.streamtheworld.com:3690/IHR_TRANAAC_SC
D: Closing XML connection.
D: Stopping client
D: Connect to new host 18073.live.streamtheworld.com:3690/IHR_TRANAAC_SC
D: Connect to 18073.live.streamtheworld.com on port 3690, extension /IHR_TRANAAC_SC
[hostByName] request IP for: 18073.live.streamtheworld.com
[hostByName] Host: 18073.live.streamtheworld.com IP: 208.92.55.40
D: Connected to server
D: Expires: Thu, 01 Dec 2003 16:00:00 GMT
D: Cache-Control: no-cache, must-revalidate
D: Pragma: no-cache
D: Access-Control-Allow-Methods: GET, HEAD
D: Access-Control-Allow-Origin: *
D: Access-Control-Allow-Credentials: true
D: Set-Cookie: uuid=e42b6045-278b-4d4d-9b9d-db3cc87d4921; expires=Sat, 22-Dec-2029 21:30:41 GMT; path=
D: Content-Type: audio/aacp
D: Connection: close
D: icy-br: 48
D: icy-description: Non-stop Trance and Progressive 24/7
D: icy-genre:
D: icy-name: iHeart Trancid
D: icy-url:
D: icy-metaint: 16000
D: Server: MediaGateway 4.2.5-003
D: Switch to DATA, bitrate is 48
D: First chunk:
D: FF F1 5E 40 23 FF FC 01
D: 44 36 2C 91 56 54 09 44
D: 82 11 9D F0 3B 8D 4A AB
D: 90 32 CC 91 08 05 DE 4A
D: Metadata block 48 bytes
D: Streamtitle found, 34 bytes
D: StreamTitle='Tiesto - Flight 643';
D: Command: xml with parameter CIMXFM
D: STOP requested
D: Stopping client
D: Song stopped correctly after 10 msec
D: Connect to new host: CIMXFM
D: Connecting to url: http://playerservices.streamtheworld.com:80/api/livestream?version=1.5&mount=CIM
[hostByName] request IP for: playerservices.streamtheworld.com
[hostByName] Host: playerservices.streamtheworld.com IP: 208.92.55.74
D: Connected!
D: XML parser processing...
D: Found: 14163.live.streamtheworld.com:3690/CIMXFMAAC_SC
D: Closing XML connection.
D: Stopping client
D: Connect to new host 14163.live.streamtheworld.com:3690/CIMXFMAAC_SC
D: Connect to 14163.live.streamtheworld.com on port 3690, extension /CIMXFMAAC_SC
[hostByName] request IP for: 14163.live.streamtheworld.com
[hostByName] Host: 14163.live.streamtheworld.com IP: 208.80.52.67
D: Connected to server
D: Expires: Thu, 01 Dec 2003 16:00:00 GMT
D: Cache-Control: no-cache, must-revalidate
D: Pragma: no-cache
D: Access-Control-Allow-Methods: GET, HEAD
D: Access-Control-Allow-Origin: *
D: Access-Control-Allow-Credentials: true
D: Set-Cookie: uuid=771e18c8-824a-4751-97d5-f59143a1e91c; expires=Sat, 22-Dec-2029 21:30:41 GMT; path=
D: Content-Type: audio/aacp
D: Connection: close
D: icy-br: 40
D: icy-description:
D: icy-genre: Rock
D: icy-name:
D: icy-url: http://www.89xradio.com
D: icy-metaint: 16000
D: Server: MediaGateway 4.2.5-003
D: Switch to DATA, bitrate is 40
D: First chunk:
D: FF F1 5E 40 1D 7F FC 01
D: 2E 15 20 80 18 28 06 0A
D: B2 41 B0 4C 8F 97 AF A6
D: BE 5E C6 75 BF 1E 7E 78
D: Metadata block 48 bytes
D: Streamtitle found, 33 bytes
D: StreamTitle='Muse - Dead Inside';
```
:tada:

Does it look copacetic?

NonaSuomy, 2017-05-03:
Added a channel switcher Test to the HTML code: [index_html.h](https://github.com/NonaSuomy/Esp-radio/blob/NonaSuomy-XML-Parser/index_html.h)
I'll try to figure out adding them to the radio.ini and load them from there later hopefully! :smile_cat:

Edzelf, 2017-05-04:
Looks good!  I'm including this feature in my version.  Testing now.

Edzelf, 2017-05-04:
iHeartRadio is implemented now.
mountpoints can be specified like normal presets, just prefix it with "ihr/", see documentation.
Is there a list somewhere of working iHeartRadio stations?

NonaSuomy, 2017-05-04:
Great work with the prefix, I'll give it a test when I get home.

Just to note I forgot to add XML to analyze cmd comment section inside the code I noticed it is in the PDF but not in the source. [.ino source](https://github.com/Edzelf/Esp-radio/blob/master/Esp_radio.ino#L2647)
I would add the line url from the documentation but it's in the PDF format and Github doesn't support that nicely.

I was trying to figure out a way to pull a list from their site but the API is undocumented, my priority was to get it playing first.

There are some tips here on how to find callsigns from the HTML source on the website: [issues/70](https://github.com/Edzelf/Esp-radio/issues/70)

Essentially the live radio stations are usually in this format XXXXFM for an FM broadcast or XXXXAM for an AM broadcast, so you could look up the callsign letters of a station online and then check to see if IHeartRadio manages their stream then just type ihr/CIMXFM etc, the IHR_ streams are outside of that normality as they only exist on their service. I found those by playing the station on their website then clicking the history option in their player than looking at the source of that page with the log of the songs they last played on it. usually, you can just search for the word "callsign" in the source and you should find a tag with it inside.

You can read their history to find out most of the stations they support in the [wikipedia iHeartRadio](https://en.wikipedia.org/wiki/IHeartRadio)

NonaSuomy, 2017-05-04:
Updated the [README.md ](https://github.com/NonaSuomy/Esp-radio/blob/master/README.md) -
 [Change](https://github.com/NonaSuomy/Esp-radio/commit/41d480abb426c1eb5e7ad0359a0e794f4c9c42f1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)

koskee, 2017-06-12:
@NonaSuomy would you by any chance have a tiny bit of free time to help me figure out why I can't get any of the IHR stations working? Edzelf has already implied that he will be busy for the next week(s) and won't be available to do so in that time.

 Having these stations functioning is one of the main points of leverage I will have to utilize to get my boss and coworkers to agree to evaluate the internet radio concept to be adopted in the shop where I work, so it is somewhat vital that I am able to get to the bottom of why they aren't playing properly. (the local station that they are stuck on just so happens to be an ihr station)

Any help would be appreciated, and I figure you're probably the only other person that understands the code well enough to help me work through the  issue. I am not sure if I'm doing something wrong, or if there's a bug or what, but i'm really at a loss when it comes to what approach to take next in resolving this.

I opened an issue under the esp32 version that explains where I'm at, and referenced it above. As far as I am aware, the code for both versions should be pretty much the same, although I haven't done a side by side comparison to legitimately make this claim.
Regardless, I believe you wrote (at least) the original code for the implementation, so If youd be so gracious as to go over it and put in your two cents on my problem, It'd be very much appreciated.

Let me know if there's anything I can do to make it easier on you as well..

Thanks in advance,
Koskee

NonaSuomy, 2017-06-13:
The callsign is indeed ihr/CHBDFM case sensitive.

Are you able to stream any of the shoutcast stations ip:port/mp3 etc ?

koskee, 2017-06-13:
Umm. I am uncertain. What I do recall is that it seemed that in addition to ihr not working, that any of the example stations that were addressed with a raw ip address were also not working, so I replaced them in the preset list almost immediately. I was unaware that these stations had anything in common (ie. Shoutcast) since they had no common domain name and hence didn't seem related.
I had assumed they were just random IPs from around the internet that had been broadcasting at one point or another, but had since shut down.

So those were Shoutcast then? They didn't work before, but it's been a long time since I've attempted to use them. Would it help if I gave them a go?

koskee, 2017-06-14:
Nevermind, I guess some of those IP addressed stations do work.

On another note, here is the debug output I'm getting from the `ihr/IHR_IEDM` station. Notice how by almost any measure, it appears to be working, yet for whatever reason, there is absolutely no audio output.

```
`rst:0x1 (POWERON_RESET),boot:0x17 (SPI_FAST_FLASH_BOOT)
ets Jun  8 2016 00:22:57

rst:0x10 (RTCWDT_RTC_RESET),boot:0x17 (SPI_FAST_FLASH_BOOT)
configsip: 0, SPIWP:0x00
clk_drv:0x00,q_drv:0x00,d_drv:0x00,cs0_drv:0x00,hd_drv:0x00,wp_drv:0x00
mode:DIO, clock div:1
load:0x3fff0008,len:8
load:0x3fff0010,len:160
load:0x40078000,len:10632
load:0x40080000,len:252
entry 0x40080034

D: Starting ESP32-radio Version Wed, 31 May 2017 12:05:00 GMT...  Free memory 194672
D: GPIO0 is HIGH
D: GPIO12 is HIGH
D: GPIO13 is HIGH
D: GPIO14 is HIGH
D: GPIO17 is HIGH
D: GPIO22 is HIGH
D: GPIO25 is HIGH
D: GPIO26 is HIGH
D: GPIO27 is HIGH
D: GPIO32 is HIGH
D: GPIO33 is HIGH
D: GPIO34 is LOW
D: GPIO35 is LOW
D: GPIO0 will execute uppreset = 1
D: GPIO12 will execute upvolume = 2
D: GPIO13 will execute downvolume = 2
D: Added SSID Excide to list of networks
D: Scan Networks
D: Scan completed
D: Number of available networks: 4
D:  1 - Excide                    Signal: -41 dBm, Encryption WPA2_PSK, Acceptable
D:  2 - 2WIRE891a                 Signal: -45 dBm, Encryption WPA2_PSK,
D:  3 - SASKTEL848                Signal: -91 dBm, Encryption WPA_WPA2_PSK,
D:  4 - JCW WiFi                  Signal: -93 dBm, Encryption WPA2_PSK,
D: End of list
D: Command: mqttbroker with parameter none
D: Command: mqttport with parameter 1883
D: Command: mqttuser with parameter none
D: Command: mqttpasswd with parameter ******
D: Command: volume with parameter 100
D: Command: toneha with parameter 2
D: Command: tonehf with parameter 6
D: Command: tonela with parameter 3
D: Command: tonelf with parameter 10
D: Command: preset with parameter 10
D: Slow SPI,Testing VS1053 read/write registers...
D: Fast SPI, Testing VS1053 read/write registers again...
D: endFillByte is 28
D: Connect to WiFi
D: Connecting to access point: Excide
D: Connected to Excide
D: IP = 192.168.1.10
D: Start server for commands
D: SD Card Mount Failed!
D: New preset/file requested (10/0) from ihr/IHR_IEDM
D: Connect to new iHeartRadio host: IHR_IEDM
D: GET /api/livestream?version=1.5&mount=IHR_IEDMAAC&lang=en
D: Connected!
D: XML parser processing...
D: Found: 15323.live.streamtheworld.com:3690/IHR_IEDMAAC_SC
D: Closing XML connection.
D: Stopping client
D: Connect to new host 15323.live.streamtheworld.com:3690/IHR_IEDMAAC_SC
D: Connect to 15323.live.streamtheworld.com on port 3690, extension /IHR_IEDMAAC_SC
D: Connected to server
D: Switch to HEADER
D: Expires: Thu, 01 Dec 2003 16:00:00 GMT
D: Cache-Control: no-cache, must-revalidate
D: Pragma: no-cache
D: Access-Control-Allow-Methods: GET, HEAD
D: Access-Control-Allow-Origin: *
D: Access-Control-Allow-Credentials: true
D: Set-Cookie: uuid=448d9fba-2137-4cca-8743-3b02464eb272; expires=Sat, 22-Dec-2029 21:30:41 GMT; path=/; domain=.live.streamtheworld.com
D: Content-Type: audio/aacp
D: audio/aacp seen.
D: Connection: close
D: icy-br: 48
D: icy-description: All Things Dance
D: icy-genre:
D: icy-name: Evolution
D: icy-url:
D: icy-metaint: 16000
D: Server: MediaGateway 4.2.6-001
D: Switch to DATA, bitrate is 48, metaint is 16000
D: First chunk:
D: FF F1 5E 40 22 BF FC 01
D: 52 36 2A 0C C5 22 0D 82
D: 82 50 A1 04 22 EE CC D0
D: C5 37 57 8A 01 12 A4 02
D: Metadata block 64 bytes
D: Streamtitle found, 60 bytes
D: StreamTitle='Yellow Claw / Dj Snake / Elliphant - Good Day';
D: Metadata block 64 bytes
D: Streamtitle found, 48 bytes
D: StreamTitle='David Guetta / Justin Bieber - 2u';`
```

Edzelf, 2017-06-14:
Contents type is audio/aacp.  Shouldn't that bee audio/mp3?  Please compare it with a working station.  I am not able to test it here.

koskee, 2017-06-16:
Sorry, spent the last couple evenings catching up on some other stuff and eradicating a virus/worm that snuck onto my personal network. All is back to normal now. I will see what further data I can dig up later tonight.

So,  it may be deciphering the wrong content type, does that mean these mp3 boards do not support aac, or would it be misinterpreting the data stream?
It seems odd that the stream works for others but not on mine, which (presumably)  has the same or nearly the same firmware.

Not sure if anyone else noticed the extra leading dot (.) near the end of this line, would that cause it to parse a poorly formatted url? :
`D: Set-Cookie: uuid=448d9fba-2137-4cca-8743-3b02464eb272; expires=Sat, 22-Dec-2029 21:30:41 GMT; path=/; domain=.live.streamtheworld.com`

NonaSuomy, 2017-06-18:
Nope AAC is correct and these boards support it. It defiantly looks like it`s working, just seems like the volumes turned down though it says 100 in the log maybe make it play a shoutcast station then play the ihr stream.

koskee, 2017-06-18:
I did a bit of further poking around, it seems that any mpeg stream is working (fantastically I might add) and anything that comes up with a content type of aac(p) refuses to play.

I found this (Dutch?) webstore that sells them: http://shop.egnite.de/de/embedded-entwicklung/audio-ics/66/vlsi-vs1053b-l?c=127

After auto-translation, it says:

> A license for the MPEG Layer-3 decoder from Technicolor is included in the price. For a WMA licensing, please contact Microsoft directly. Customers who wish to use AAC must purchase a license from Via Licensing.

The datasheet also talks about something about being able to have an embedded serial number from the factory for "digital rights management" purposes. Could it be that the board I have is not properly licenced for aac decoding? (After all it did come from China so I would not be surprised if it was either a counterfeit board or a slimmed down version that did not have full features.. Which  the sellers opted for as a penny pinching tactic)

NonaSuomy, 2017-06-18:
Unusual maybe try a sketch that only plays audio files from sd

I got mine from china ebay sellers http://www.ebay.ca/itm/VS1053-MP3-Module-with-SD-card-slot-VS1053B-Ogg-real-time-recording-for-Arduino-/262866917974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

maybe raw chips are not setup properly like the breakout boards?

NonaSuomy, 2017-06-18:
Here's the datasheet in english https://www.sparkfun.com/datasheets/Components/SMD/vs1053.pdf

Edzelf, 2017-06-18:
I used this one: [https://www.aliexpress.com/item/1PCS-New-VS1053-MP3-Module-Development-Bard-on-board-recording-function/32354143509.html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](url)

koskee, 2017-06-19:
Well, that's a bit frustrating, but I guess that would make sense - I had a closer look and figured out that the board I have has a VS1003B chip instead of a VS1053B, despite being sold as the latter. The datasheet for the 1003 makes no mention of the AAC format on first glance.

Guess I have to wait another 2 months for a new board to arrive >:(
It's really lucky that I hadn't started fab/etching the custom board I had designed for this. I had just finalized the layout yesterday, but the new board looks like it has a different pinout so I suppose some revisions are in order.

I'll close the issue on the other side, but this one doesn't belong to me. Thanks for your help everyone @Edzelf @NonaSuomy

NonaSuomy, 2017-06-23:
Glad I could help you solved the mystery!

Just to note I would double check the pin layout as I believe a bunch of the VS series are drop in replacements for each other without too much fuss.

koskee, 2017-06-24:
I was hoping they would be, although based on the pictures of the module (bought the one recommended by @Edzelf)  it appears that the pins are arranged in a double row pattern instead of the single row of 9 pins on the one I have. Obviously a different design, but I wanted to be sure that I got a genuine module this time, to avoid waiting additional months to get it all built.

Since I already designed for this board (and since they obviously do make 1053 versions with the same pinout - i'm guessing because this  board is labeled vs1003/VS1053 breakout or something like that) I will likely try to incorporate headers for the new board into the design I already made for dual compatibility. I'm trying to avoid making it a dual layer design for simplicity's sake so I guess we shall see.

On that note, can anyone confirm that the pinout is 2 x __ on those modules? Also if somebody has a caliper and one of those boards and doesn't mind taking a few measurements for me, it would save me a good chunk of time not having to wait for the new one to arrive. (or a datasheet would probably suffice if it includes a diagram with measurements)

NonaSuomy, 2017-06-24:
Maybe you could modify this board https://github.com/dsaltas/WiFi-WebRadio

koskee, 2017-06-25:
Oh I guess i should have been more clear, I would need a datasheet showing the measurements of this module (ie. the pin spacing and relative localisation between the board edges and the aforementioned pins):
 (https://www.aliexpress.com/item/1PCS-New-VS1053-MP3-Module-Development-Bard-on-board-recording-function/32354143509.html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)
I'd ask the seller, but in my experience they often don't have any usable information on the products they sell.

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

(this actually happened to me pretty recently)

Mantikor, 2017-06-25:
**koskee**, datasheet for this module is unlikely to exist in nature, probably you should guess to type in google.com datasheet vs1053, and not to laugh for Chinese, who does not know English and responds with a learned phrase.

koskee, 2017-06-25:
Was merely an example to illustrate the fact that the sellers often cannot communicate on a functional level. If anything,  I'd say I'm frustrated with the fact that I bought a VS1053 module and got something different. Any laughter would be because there's not much else I can do about it. Just have to realize,  that's how it goes sometimes, as irritating as it is waiting 3 months for stuff to arrive.

I agree that such a datasheet is unlikely to find its way into my hands, if it exists. That is why I am asking for someone to measure theirs with a caliper, if they could as it would save a lot of time and hassle searching for information that may or may not exist..

Thread 83 (2017-05-05):

Long time on

udavst, 2017-05-05:
After power on, immediately connects to Wifi, and does not respond 1-5 minutes, neither on ping, nor on the web, does not play. In the logs - connected to WIFI (last line), to buttons (A0) reacts - outputs to log. After 1-5 minutes, it starts to play itself and everything starts to work quickly and stably. Because of what there can be such a delay at turning on?

P.S. The version without LCD, ESP - Wemos D1 mini is used.

Edzelf, 2017-05-05:
There is no logging for "connected to Wifi".  The log should show something like:
D: Selected network: XXXXX       
D: Try WiFi XXXXXX
D: IP = 192.168.2.9
D: Start server for commands.
The radio tries to connect to the preset defined by your radio.ini file.  If the first station does not react it will try the next one and so on.  This may take some time.  But all of this must be visible in the logging.

udavst, 2017-05-05:
Yes, for a very long time it hangs on Try WiFi xxxxxxx. On the router it is already connected, and the address is issued, but ESP-Radio continues to wait for something in this place.

Edzelf, 2017-05-05:
Show me the complete logging

udavst, 2017-05-05:
`D: endFillByte is 0
D: Selected network: udavst@gmail.com 
D: Try WiFi udavst@gmail.com
D: FS Total 2949250, used 2008
D: /radio.ini                       -    1516
D: Added SSID 00 = udavst@gmail.com to acceptable networks
D: Added SSID 01 = udavst@gmail.com_5g to acceptable networks
D: * Scan Networks *
D: Number of available networks: 13
D:  1 - ARMENIA.AM                Signal: -70 dBm Encryption WPA2
D:  2 - MTSRouter_83B0E6          Signal: -60 dBm Encryption WPA2
D:  3 - zakroma                   Signal: -86 dBm Encryption WPA2
D:  4 - UPVEL                     Signal: -92 dBm Encryption Auto
D:  5 - Home-40                   Signal: -91 dBm Encryption Auto
D:  6 - MTSRouter_8423A6          Signal: -69 dBm Encryption WPA2
D:  7 - Home_Tatiana              Signal: -66 dBm Encryption WPA2
D:  8 - MTSRouter-010979          Signal: -70 dBm Encryption WPA2
D:  9 - MTSRouter_84D8C2          Signal: -86 dBm Encryption WPA2
D: 10 - Spark-Home                Signal: -88 dBm Encryption Auto
D: 11 - udavst@gmail.com          Signal: -64 dBm Encryption WPA2  Acceptable
D: 12 - BelMet                    Signal: -83 dBm Encryption None
D: 13 - MTSRouter-237CE2          Signal: -60 dBm Encryption WPA2
D: --------------------------------------
D: Command: mqttbroker with parameter broker.hivemq.com
D: Command: mqttport with parameter 1883
D: Command: mqttuser with parameter No
D: Command: mqttpasswd with parameter No
D: Command: mqtttopic with parameter espradio
D: Command: mqttpubtopic with parameter espradioIP
D: Command: wifi_00 with parameter udavst@gmail.com/00000000oo
D: Command: wifi_01 with parameter udavst@gmail.com_5g/00000000oo
D: Command: volume with parameter 82
D: Command: toneha with parameter 0
D: Command: tonehf with parameter 0
D: Command: tonela with parameter 5
D: Command: tonelf with parameter 12
D: Command: preset with parameter 2
D: Command: preset_00 with parameter 109.206.96.34:8100
D: Command: preset_01 with parameter ep128.streamr.ru
D: Command: preset_02 with parameter s2.radioheart.ru:8005/nonstop
D: Command: preset_03 with parameter 192.240.102.3:9042/stream
D: Command: preset_04 with parameter 81.30.54.74:8000/radio3
D: Command: preset_05 with parameter stream3.radiostyle.ru:8003/radioacca
D: Command: preset_06 with parameter s07.radio-tochka.com:6455/
D: Command: preset_07 with parameter s7.radioheart.ru:8003/live
D: Command: preset_08 with parameter 16bit.fm/play/16bit.fm_cafe_128.m3u
D: Command: preset_09 with parameter 94.23.66.155:8106
D: Command: preset_10 with parameter ic3.101.ru:8000/c10_4?setst=-1
D: Command: preset_11 with parameter radio.mixadance.fm:8000/relax
D: Command: preset_12 with parameter beloeradio.ru:8080/whiteradio.mp3
D: Starting ESP Version Wed, 04 May 2017 10:45:00 GMT...  Free memory 13696
D: Sketch size 341056, free size 704512
D: Reset VS1053...
D: End reset VS1053...
D: Slow SPI,Testing VS1053 read/write registers...
D: Fast SPI, Testing VS1053 read/write registers again...
D: endFillByte is 0
D: Selected network: udavst@gmail.com 
D: Try WiFi udavst@gmail.com
**DELAY**
D: IP = 192.168.1.11
D: Start server for commands
D: Connecting to MQTT broker.hivemq.com, port 1883, user No, password No...
D: MQTT Connected to the broker broker.hivemq.com, session is not present
D: Subscribing to espradio at QoS 2, packetId = 1
D: Publishing IP 192.168.1.11 to topic espradioIP
D: MQTT Subscribe acknowledged, packetId = 1, QoS = 2
D: MQTT Publish acknowledged, packetId = 2
D: STOP requested
D: Song stopped correctly after 0 msec
D: New preset/file requested (-1/0) from s2.radioheart.ru:8005/nonstop
D: Connect to new host s2.radioheart.ru:8005/nonstop
D: Connect to s2.radioheart.ru on port 8005, extension /nonstop
D: Connected to server
D: Accept-Ranges: none
D: Content-Type: audio/mpeg
D: icy-br:128
D: ice-audio-info: bitrate=128
D: icy-description:NONSTOP
D: icy-genre:Club
D: icy-name:Index_Radio
D: icy-pub:0
D: icy-url:http://club_inex.myrh.ru/
D: Server: Icecast 2.3.3-kh11
D: Cache-Control: no-cache, no-store
D: Pragma: no-cache
D: Access-Control-Allow-Origin: *
D: Access-Control-Allow-Headers: Origin, Accept, X-Requested-With, Content-Type
D: Access-Control-Allow-Methods: GET, OPTIONS, HEAD
D: Connection: close
D: Expires: Mon, 26 Jul 1997 05:00:00 GMT
D: icy-metaint:16000
D: Switch to DATA, bitrate is 128
D: First chunk:
D: FF FB 90 64 EC 80 02 C5
D: 25 DB 69 E7 1D 20 47 C2
D: 2B AF 24 E9 65 0C 24 95
D: 73 E7 A4 4F 41 60 8C 6D
D: Metadata block 48 bytes
D: Streamtitle found, 39 bytes
D: StreamTitle='Q-Q Biko - Picture Of Me';
D: list request from browser
`

udavst, 2017-05-05:
D: endFillByte is 0
D: Selected network: udavst@gmail.com 
D: Try WiFi udavst@gmail.com
D: FS Total 2949250, used 2008
D: /radio.ini                       -    1516
D: Added SSID 00 = udavst@gmail.com to acceptable networks
D: Added SSID 01 = udavst@gmail.com_5g to acceptable networks
D: * Scan Networks *
D: Number of available networks: 13
D:  1 - ARMENIA.AM                Signal: -70 dBm Encryption WPA2
D:  2 - MTSRouter_83B0E6          Signal: -60 dBm Encryption WPA2
D:  3 - zakroma                   Signal: -86 dBm Encryption WPA2
D:  4 - UPVEL                     Signal: -92 dBm Encryption Auto
D:  5 - Home-40                   Signal: -91 dBm Encryption Auto
D:  6 - MTSRouter_8423A6          Signal: -69 dBm Encryption WPA2
D:  7 - Home_Tatiana              Signal: -66 dBm Encryption WPA2
D:  8 - MTSRouter-010979          Signal: -70 dBm Encryption WPA2
D:  9 - MTSRouter_84D8C2          Signal: -86 dBm Encryption WPA2
D: 10 - Spark-Home                Signal: -88 dBm Encryption Auto
D: 11 - udavst@gmail.com          Signal: -64 dBm Encryption WPA2  Acceptable
D: 12 - BelMet                    Signal: -83 dBm Encryption None
D: 13 - MTSRouter-237CE2          Signal: -60 dBm Encryption WPA2
D: --------------------------------------
D: Command: mqttbroker with parameter broker.hivemq.com
D: Command: mqttport with parameter 1883
D: Command: mqttuser with parameter No
D: Command: mqttpasswd with parameter No
D: Command: mqtttopic with parameter espradio
D: Command: mqttpubtopic with parameter espradioIP
D: Command: wifi_00 with parameter udavst@gmail.com/00000000
D: Command: wifi_01 with parameter udavst@gmail.com_5g/00000000
D: Command: volume with parameter 82
D: Command: toneha with parameter 0
D: Command: tonehf with parameter 0
D: Command: tonela with parameter 5
D: Command: tonelf with parameter 12
D: Command: preset with parameter 2
D: Command: preset_00 with parameter 109.206.96.34:8100
D: Command: preset_01 with parameter ep128.streamr.ru
D: Command: preset_02 with parameter s2.radioheart.ru:8005/nonstop
D: Command: preset_03 with parameter 192.240.102.3:9042/stream
D: Command: preset_04 with parameter 81.30.54.74:8000/radio3
D: Command: preset_05 with parameter stream3.radiostyle.ru:8003/radioacca
D: Command: preset_06 with parameter s07.radio-tochka.com:6455/
D: Command: preset_07 with parameter s7.radioheart.ru:8003/live
D: Command: preset_08 with parameter 16bit.fm/play/16bit.fm_cafe_128.m3u
D: Command: preset_09 with parameter 94.23.66.155:8106
D: Command: preset_10 with parameter ic3.101.ru:8000/c10_4?setst=-1
D: Command: preset_11 with parameter radio.mixadance.fm:8000/relax
D: Command: preset_12 with parameter beloeradio.ru:8080/whiteradio.mp3
D: Starting ESP Version Wed, 04 May 2017 10:45:00 GMT...  Free memory 13696
D: Sketch size 341056, free size 704512
D: Reset VS1053...
D: End reset VS1053...
D: Slow SPI,Testing VS1053 read/write registers...
D: Fast SPI, Testing VS1053 read/write registers again...
D: endFillByte is 0
D: Selected network: udavst@gmail.com 
D: Try WiFi udavst@gmail.com
**DELAY**
D: IP = 192.168.1.11
D: Start server for commands
D: Connecting to MQTT broker.hivemq.com, port 1883, user No, password No...
D: MQTT Connected to the broker broker.hivemq.com, session is not present
D: Subscribing to espradio at QoS 2, packetId = 1
D: Publishing IP 192.168.1.11 to topic espradioIP
D: MQTT Subscribe acknowledged, packetId = 1, QoS = 2
D: MQTT Publish acknowledged, packetId = 2
D: STOP requested
D: Song stopped correctly after 0 msec
D: New preset/file requested (-1/0) from s2.radioheart.ru:8005/nonstop
D: Connect to new host s2.radioheart.ru:8005/nonstop
D: Connect to s2.radioheart.ru on port 8005, extension /nonstop
D: Connected to server
D: Accept-Ranges: none
D: Content-Type: audio/mpeg
D: icy-br:128
D: ice-audio-info: bitrate=128
D: icy-description:NONSTOP
D: icy-genre:Club
D: icy-name:Index_Radio
D: icy-pub:0
D: icy-url:http://club_inex.myrh.ru/
D: Server: Icecast 2.3.3-kh11
D: Cache-Control: no-cache, no-store
D: Pragma: no-cache
D: Access-Control-Allow-Origin: *
D: Access-Control-Allow-Headers: Origin, Accept, X-Requested-With, Content-Type
D: Access-Control-Allow-Methods: GET, OPTIONS, HEAD
D: Connection: close
D: Expires: Mon, 26 Jul 1997 05:00:00 GMT
D: icy-metaint:16000
D: Switch to DATA, bitrate is 128
D: First chunk:
D: FF FB 90 64 EC 80 02 C5
D: 25 DB 69 E7 1D 20 47 C2
D: 2B AF 24 E9 65 0C 24 95
D: 73 E7 A4 4F 41 60 8C 6D
D: Metadata block 48 bytes
D: Streamtitle found, 39 bytes
D: StreamTitle='Q-Q Biko - Picture Of Me';
D: list request from browser

udavst, 2017-05-05:
The router issues the address immediately, but esp is still waiting for something. Tried another ESP, the same behavior. Another ESP is working on sending the weather - it does not have problems with the connection.

thermo2016, 2017-05-05:
Could it be this?:
D: Added SSID 01 = udavst@gmail.com_5g to acceptable networks
that is a 5g wifi but the esp is 2.4ghz only.
If the 5g is a stronger signal it will try this first.
Try removing the reference to the 5g wifi.

udavst, 2017-05-05:
ESP does not see the same 5g networks, I thought it did not matter what I put in there. I removed the second network completely, and switched the router to 20MHz (it was 20/40 auto). Everything began to work perfectly. Thank you!

Closed 2017-05-23.

Thread 84 (2017-05-05):

Remember Last Station

udavst, 2017-05-05:
Can I make the last station play when I switch on, which was played before shutting down?

Edzelf, 2017-05-05:
Yes, save the preset number in the internal EEPROM (not too often, and only if different than the previous setting).
At startup you retrieve the preset and store it in "ini_block.newpreset".
I will include this feature in the coming ESP32 version of the radio.

udavst, 2017-05-05:
And in this version you can make a patch? For the test) I really want this feature, especially when there is no screen.

Edzelf, 2017-05-05:
I will try.  But it may take quite some time (other priorities..).

udavst, 2017-05-05:
Thanks )

Edzelf, 2017-05-23:
The ESP32 version will remember the settings.

Thread 85 (2017-05-09):

abs() avoid doing work inside brackets?

NonaSuomy, 2017-05-09:
[ref](https://www.arduino.cc/en/reference/abs)
```
Warning

Because of the way the abs() function is implemented, avoid using other functions inside the brackets, it may lead to incorrect results.

abs(a++);   // avoid this - yields incorrect results

abs(a);
a++;          // use this instead - keep other math outside the function
```

Original
```
//******************************************************************************************
//                                  A N A G E T S W                                        *
//******************************************************************************************
// Translate analog input to switch number.  0 is inactive.                                *
//******************************************************************************************
uint8_t anagetsw ( uint16_t v )
{
  int      i ;                                    // Loop control
  int      oldmindist = 1000 ;                    // Detection least difference
  int      newdist ;                              // New found difference
  uint8_t  sw = 0 ;                               // Number of switch detected (0 or 1..3)

  if ( v > analogrest )                           // Inactive level?
  {
    for ( i = 0 ; i < NUMANA ; i++ )
    {
      newdist = abs ( analogsw[i] - v ) ;          // Compute difference

      if ( newdist < oldmindist )                  // New least difference?
      {
        oldmindist = newdist ;                     // Yes, remember
        sw = i + 1 ;                               // Remember switch
      }
    }
  }
  return sw ;                                      // Return active switch
}
```

Should it be something like this instead?
```
//******************************************************************************************
//                                  A N A G E T S W                                        *
//******************************************************************************************
// Translate analog input to switch number.  0 is inactive.                                *
//******************************************************************************************
uint8_t anagetsw ( uint16_t v )
{
  int      i ;                                    // Loop control
  int      aval ;                                 // Switch value - Analog value
  int      oldmindist = 1000 ;                    // Detection least difference
  int      newdist ;                              // New found difference
  uint8_t  sw = 0 ;                               // Number of switch detected (0 or 1..3)

  if ( v > analogrest )                           // Inactive level?
  {
    for ( i = 0 ; i < NUMANA ; i++ )
    {
      aval = analogsw[i] - v ;
      newdist = abs ( aval ) ;          // Compute difference

      if ( newdist < oldmindist )                  // New least difference?
      {
        oldmindist = newdist ;                     // Yes, remember
        sw = i + 1 ;                               // Remember switch
      }
    }
  }
  return sw ;                                      // Return active switch
}
```

NonaSuomy, 2017-05-09:
Changing this seemed to fix my analog button issue of it detecting wrong button presses.

Edzelf, 2017-05-09:
Fixed.

NonaSuomy, 2017-05-09:
Thanks @Edzelf

Closed 2017-05-09.

Thread 86 (2017-05-09):

Ported Esp-radio to Adafruit Feather boards

bbx10, 2017-05-09:
If interested in using Adafruit Feather boards, see the fork http://github.com/bbx10/Esp-radio.

NonaSuomy, 2017-05-10:
Nice work pull the abs fix from today if you want to use analog buttons.

bbx10, 2017-05-11:
Ok, I will try to keep in sync with the latest changes.

Thread 88 (2017-05-10):

replace special / non ASCII characters before displaying on TFT

everyb313, 2017-05-10:
**idea for displaying UTF8 characters in songtitle**
(code stolen at  http://playground.arduino.cc/Main/Utf8ascii)
--> replace UTF8 characters with a lookup table before printing on TFT

---------------------
void displayinfo ( const char* str, uint16_t ypos, uint16_t height, uint16_t color )
{
#if defined ( USETFT )
  char s[255];
  strcpy(s,str);
  utf8ascii(s);

(....)

tft.println(s);
#endif
}

//******************************************************************************************
// ****** UTF8-Decoder: convert UTF8-string to extended ASCII *******
//******************************************************************************************
static byte c1;  // Last character buffer

// Convert a single Character from UTF8 to Extended ASCII
// Return "0" if a byte has to be ignored
static const byte lut_C3[] = { "AAAAAAACEEEEIIIIDNOOOOO#0UUUU###aaaaaaaceeeeiiiidnooooo##uuuuyyy" };
byte utf8ascii(byte ascii) {
    if ( ascii<128 )   // Standard ASCII-set 0..0x7F handling
    {   c1=0;
        return( ascii );
    }

    // get previous input
    byte last = c1;   // get last char
    c1=ascii;         // remember actual character

    switch (last)     // conversion depending on first UTF8-character
    {
//        case 0xC2: return  (ascii);  break;
//        case 0xC3: return  (ascii | 0xC0);  break;
//        case 0x82: if(ascii==0xAC) return(0x80);       // special case Euro-symbol

        case 0xC2: return  ('~');  break;
        case 0xC3: return  (lut_C3[ascii-128]);  break;
        case 0x82: if(ascii==0xAC) return('E');       // special case Euro-symbol
 
    }

    return  (0);                                     // otherwise: return zero, if character has to be ignored
}

//******************************************************************************************
// convert String object from UTF8 String to Extended ASCII
//******************************************************************************************
String utf8ascii(String s)
{
        String r="";
        char c;
        for (int i=0; i<s.length(); i++)
        {
                c = utf8ascii(s.charAt(i));
                if (c!=0) r+=c;
        }
        return r;
}

//******************************************************************************************
// In Place conversion UTF8-string to Extended ASCII (ASCII is shorter!)
//******************************************************************************************
void utf8ascii(char* s)
{
        int k=0;
        char c;
        for (int i=0; i<strlen(s); i++)
        {
                c = utf8ascii(s[i]);
                if (c!=0)
                        s[k++]=c;
        }
        s[k]=0;
}

Edzelf, 2017-05-11:
Looks good.  I have never seen these strange characters on the screen.  But I will include the code.

everyb313, 2017-05-11:
Maybe you can try the following radio stations (French, Spanish, Portugese):
streaming210.radionomy.com:80/Radio-Tango-Velours
streaming210.radionomy.com:80/Colombiasalsarosa
streaming211.radionomy.com:80/CorcovadoRadio

Edzelf, 2017-05-11:
Fixed. See new version.

Closed 2017-05-31.

Thread 89 (2017-05-24):

Streamtitle not shown

Sindi1, 2017-05-24:
I have a strange problem. From today to tomorrow the radio does not show the song title, artist or information. It just shows the station name and "Connect to .."

After pressing the “Flash-button” on the NodeMCU Board title and artist were displayed.

Example:

http://mp3-live.swr3.de/swr3_m.m3u

Display Shows:
**SWR3-Livestream
Connect to swr-swr3-live.cast.addradio.de on port 80, extension /swr/swr3/live/mp3/128/stream.mp3**

In addition, there are sound disturbances every few seconds

After pressing Flash:

**Am Mikrofon: Marcus Barsch
SWR3**

No sound disturbances anymore.

Serial log:

: Command: preset with parameter 01
D: Preset set to 1
D: STOP requested
D: Stopping client
D: Song stopped correctly after 0 msec
D: New preset/file requested (0/0) from mp3-live.swr3.de/swr3_m.m3u
D: Connect to new host mp3-live.swr3.de/swr3_m.m3u
D: Playlist request, entry 1
D: Connect to mp3-live.swr3.de on port 80, extension /swr3_m.m3u
D: Connected to server
D: Read from playlist
D: Playlistheader: HTTP/1.1 200 OK
D: Playlistheader: Server: Apache
D: Playlistheader: Content-Disposition: attachment; filename="swr3_mp3_m.m3u"
D: Playlistheader: ETag: "3487cdbeb7c9afc2a11abe4717b1733e"
D: Playlistheader: Content-Length: 241
D: Playlistheader: Content-Type: audio/x-mpegurl
D: Playlistheader: Cache-Control: max-age=86400
D: Playlistheader: Date: Wed, 24 May 2017 20:36:58 GMT
D: Playlistheader: Connection: close
D: Playlistheader:
D: Switch to PLAYLISTDATA
D: Playlistdata: #EXTM3U
D: Playlistdata: #EXTINF:-1,SWR3-Livestream
D: Playlistdata: http://swr-swr3-live.cast.addradio.de/swr/swr3/live/mp3/128/stream.mp3
D: Entry 1 in playlist found: http://swr-swr3-live.cast.addradio.de/swr/swr3/live/mp3/128/stream.mp3
D: Connect to new host swr-swr3-live.cast.addradio.de/swr/swr3/live/mp3/128/stream.mp3
D: Connect to swr-swr3-live.cast.addradio.de on port 80, extension /swr/swr3/live/mp3/128/stream.mp3
D: Connected to server
D: Switch to DATA, bitrate is 0
D: First chunk:
D: 48 54 54 50 2F 31 2E 30
D: 20 32 30 30 20 4F 4B 0D
D: 0A 43 6F 6E 74 65 6E 74
D: 2D 54 79 70 65 3A 20 61

**After pressing Flash:**

D: Digital button 2 pushed
D: STOP requested
D: Stopping client
D: Song stopped correctly after 0 msec
D: New preset/file requested (1/2) from mp3-live.swr3.de/swr3_m.m3u
D: Connect to new host mp3-live.swr3.de/swr3_m.m3u
D: Playlist request, entry 2
D: Connect to mp3-live.swr3.de on port 80, extension /swr3_m.m3u
D: Connected to server
D: Read from playlist
D: Playlistheader: HTTP/1.1 200 OK
D: Playlistheader: Server: Apache
D: Playlistheader: Content-Disposition: attachment; filename="swr3_mp3_m.m3u"
D: Playlistheader: ETag: "3487cdbeb7c9afc2a11abe4717b1733e"
D: Playlistheader: Content-Length: 241
D: Playlistheader: Content-Type: audio/x-mpegurl
D: Playlistheader: Cache-Control: max-age=86400
D: Playlistheader: Date: Wed, 24 May 2017 20:40:04 GMT
D: Playlistheader: Connection: close
D: Playlistheader:
D: Switch to PLAYLISTDATA
D: Playlistdata: #EXTM3U
D: Playlistdata: #EXTINF:-1,SWR3-Livestream
D: Playlistdata: http://swr-swr3-live.cast.addradio.de/swr/swr3/live/mp3/128/stream.mp3
D: Entry 1 in playlist found: http://swr-swr3-live.cast.addradio.de/swr/swr3/live/mp3/128/stream.mp3
D: Playlistdata: #EXTINF:-1,SWR3-Livestream
D: Playlistdata: http://swr-mp3-m-swr3.akacast.akamaistream.net/7/720/137136/v1/gnl.akacast.akamaistre
D: Entry 2 in playlist found: http://swr-mp3-m-swr3.akacast.akamaistream.net/7/720/137136/v1/gnl.akaca
D: Connect to new host swr-mp3-m-swr3.akacast.akamaistream.net/7/720/137136/v1/gnl.akacast.akamaistrea
D: Connect to swr-mp3-m-swr3.akacast.akamaistream.net on port 80, extension /7/720/137136/v1/gnl.akaca
D: Connected to server
D: Content-Type: audio/mpeg
D: icy-description:Mehr Hits. Mehr Kicks. Einfach SWR3
D: icy-genre:Pop Music
D: icy-name:SWR3
D: icy-pub:1
D: icy-url:http://www.swr3.de
D: Server: Akacast 1.0
D: Cache-Control: no-cache
D: icy-metaint:16000
D: Switch to DATA, bitrate is 0
D: First chunk:
D: 63 EB 7E BF F4 92 2E 3A
D: 9B C0 00 01 A4 43 41 2C
D: 8B 40 67 79 DB 2A 23 5A
D: D6 51 E6 8D B5 09 7F 5F
D: Metadata block 48 bytes
D: Streamtitle found, 41 bytes
D: StreamTitle='Am Mikrofon: Marcus Barsch';

Edzelf, 2017-05-25:
I can reproduce this problem.  The same error occurs in mu ESP32 version.  The header "icy-metaint:16000" is not seen.  Therefore the sound is disturbed every 16000 bytes.  If you go directly to "swr-swr3-live.cast.addradio.de on port 80, extension /swr/swr3/live/mp3/128/stream.mp3" it works correctly.

I will look in to this problem later.

Edzelf, 2017-05-26:
Fixed.

Sindi1, 2017-05-27:
Thanks :+1:

Closed 2017-05-26.

Thread 90 (2017-05-26):

Empty streams & url parsing error

koskee, 2017-05-26:
I just got my radio up and running after figuring out a bunch of library related compile errors. Arduino boards manager is garbage Imo.

I'm actually quite happy with the radio so far. However, I've run into a couple things that aren't optimal, as well as an ini file parsing issue.

First, I guess I should mention that on my first trip through the channels, it appears that approximately 1 of 2 of the stations will connect and appear to be functional, (even pulling up track names from the metadata and the first chunk has normal hex values from what I can tell) but there's no output. I would assume that if they were selected to be used in the project as a demo station, that they must work for at least somebody? Why would I be getting either "no data" or a stream with no output? Would it be licensing/country issues? I didn't think that would be an issue with internet radio so just wondering what's up with that..

Second, and the real issue I had was adding a station that I found thru the link at the bottom of the web interface. The simplified link is "http://noisefm.ru:8000/play.m3u&t=.m3u" after I removed the first portion of the url (I assumed that's just a wrapper used for launching some kind of player,  probably?)
The issue that I'm observing with this is that when it tries to connect it truncates anything past the '&' and ultimately fails to connect. Basically when the stream's url is pulled from radio.ini, it tries to connect to "http://noisefm.ru:8000/play.m3u" which not only does not work, but the esp has a fit over it, presumably one of the characters has special significance or possibly just because of the double '.' dot.
It apparently sees that as an EOF (end of file) because upon adding that to the ini file (I put it as preset 2) all of the other stations that would have been listed after it were no longer available in the preset list on webinterface.
I know that it should work because I had initially tried entering it into the text entry "play stream/file" box on webinterface to test that I had the correct url, and that worked fine.

An additional effect, although I'm not certain the two are related because I had an instance when this happened prior to changing the ini, was that when clicking the config tab, I just get the last portion of the html code that would have made up the page appearing as plaintext in the browser window. This began happening consistently after changing the file.
I haven't identified how to replicate this behaviour, but it seems almost like when the esp is bogged down doing something intensive that maybe the connection is timing out or the response (datatype?)  isn't being sent properly which makes the browser think that what it's receiving is the plaintext body of the page. It's weird because one might think that the` <html tags> ` would still have an effect, especially because it doesn't display `<html><head></head><body>` or any of the beginning of the html document, only the last maybe ~50 lines.

For resolving the url parsing error, possibly enclosing the url in quotes inside the ini file - or some other special character -  seems like a feasible remedy to me, but I haven't had a lot of time to analyze the code (its relatively a pretty hefty size application - one of the most elaborate that I've seen for the ESP.. Good work!) It's likely you guys would know best what might work, and what might not, since you will be much more intimately familiar with how the code works.

Any help is appreciated -  sorry if this bug report is a little sparse on initial troubleshooting, but I tried to gather as much I could while still remaining relevant. Let me know if there's any troubleshooting/testing you guys need me to do.

Edzelf, 2017-05-26:
It looks like everything past the ampersand is removed.  I will look in to that.
I will also check which stations in the list are no longer available.

Edzelf, 2017-05-26:
Ampersands are not allowed in a preset station.  In your example "noisefm.ru:8000/play.m3u" will work correctly.  The playinglist is only one entry in this case, so you can also use "noisefm.ru:8000/play" as well.
I have checked the example stations.  Some of them did not work because of a patch I made this morning.  It made distinction between "Content-Type" en "content-type" in the HTTP header.  That's corrected now.

The SPIFFS system is not very reliable, so occasionally it can happen that a part of the info is missed when read from the SPIFFS.

My ESP32 version seems to perform much better.

koskee, 2017-05-26:
Okay, I tried your alternate URL, and it works. So that's excellent. Now I'm wondering where you derived the alternate address from? Is there a procedure for acquiring valid URLs for a given station? or is /play a common address for these sorts of things? Just wondering so I don't have to come back and ask you to figure out why a bunch of stations aren't working and so I know what to do when I encounter more ampersands. I'll leave this open for a day or 2 so you have a chance to respond.

Thanks for your prompt attention/resolution.

At work I am currently forced to listen to a certain country music station 8hrs/day and its driving me crazy (they play the same songs 2-4 times in a single shift), so this little project will hopefully provide us humble workers with some much needed variety once I sweet talk the manager into adopting this extremely inexpensive and excellent alternative. You're truly a lifesaver and I applaud thee.

Edzelf, 2017-05-27:
Nice story about your music at work!
The best way to see the target URL for a station is by using Winamp.  See the PDF file, page 4.  I have changed the text to clarify the procedure.  Note that URLs ending with ".mu3" are just playlists, not stations.  Often playlist contain just one station, so there's no real need for al list.

koskee, 2017-05-27:
Perfect. I will try that.

Thank you, you've been most helpful.

Closed 2017-05-27.

Thread 91 (2017-05-28):

Station transition latency reduction (?)

koskee, 2017-05-28:
Just thinking out loud here, but judging by the debug prints that the radio spits out into the serial monitor, it appears the radio issues a stop request before connecting to the next station. This leaves a considerable audio gap while  it connects to the next server, resolves metadata, etc.

Depending on how quickly the radio is able to resolve the new stream, could we not skip the stop request and just append the new stream onto the existing buffer? I read somewhere in the docs that the ring buffer should be able to hold enough for about 1.5 seconds of audio @ a certain bitrate, which although it probably wouldn't eliminate the gap entirely in all cases, it just seems like stopping the stream before doing anything else is only prolonging the gap between streams.

There's probably a good reason for doing it how it currently is done, but if not, wouldn't it make more sense to leave it playing as long as possible while transitioning servers?

koskee, 2017-05-28:
I did a little bit of testing, and despite my choppy output from the most recent version (discussed in another issue) it seems with a minor code change to remove a stop request when changing stations, that the gap is significantly reduced.  Now that I've gone back to a functional version, I will test the same change to see if the results are similar.

koskee, 2017-05-29:
Well it appears to work. Depending on how fast the radio picks up the next stream, it seems like at least some of the time the transition is gapless. I haven't been able to thoroughly test the modification, because I have yet to take the time to create an ini file that has only stations that work, but i'm happy to report that switching stations without issuing a stop command doesn't cause a crash or anything overly undesirable.

All I did was comment out the if structure that checks if the radio is stopped and issues the command if it isnt in the loop function (where it decides to change stations). I'd create a pull request but I haven't ever done that before so I would likely need to figure out how. It's a simple enough change to implement tho, I doubt it really warrants a PR.

Let me know if you would rather I send a PR, or if you have questions about where the changes I made were.

Edzelf, 2017-05-29:
During the switch station process, the "loop()" function is not executed.  So there are no reads from the ringbuffer.  Switch time in normally about one second.  Some buffering is done by the VS1053 itself (size of audio FIFO is 2048 stereo (2x16 bit) samples) and that's what you can gain by postponing the stop command.

koskee, 2017-06-01:
Well it seems to improve the fluidity of changing channels as there is less dead time. Unfortunately, for whatever reason the module will briefly pause for maybe a second as soon as it receives the command, and then finishes playing out whatever buffer it still has after this short pause.  The new station comes in pretty much immediately after the remaining audio data runs out from the last  station.

I haven't been able to trace the reason for the pause, but it occurs to me that it's either the heavy loading caused by the new connection, or maybe one of the various delay commands scattered throughout the sketch.

However, it seems odd that the buffer inside the mp3 module doesn't seem to offset the gap caused by the reconnection at all.

Perhaps the esp32 will be better at handling this, with its dual core, and other performance improvements.

If there are any deliberate reasons for the module to be taking a momentary break here,  off the top of (anyone's?)  head, that might point me in the right direction, would appreciate the tip.

Regardless, I find it much less noticeable if keep the audio going as much as possible.

Also, would it be fair to assume you've already considered using an interrupt to fill the ring buffer  at more tightly controlled intervals? Or maybe even the ticker library? I don't think it's a real  interrupt, but I could be wrong about that and it could be worth looking at if it allows the code to generate the data array in a more controlled & consistent fashion.

Thread 92 (2017-05-28):

Latest .ino commit results in choppy output

koskee, 2017-05-28:
I had originally thought it was my internet connection (lots of people in my house use it, so its sometimes slow) or as a result of one of my modifications to the code, but upon further testing, it seems that the latest commit to the arduino file has made the output from my radio choppy.  The characteristics of this are dependent on the bitrate of the stream. Basically it gives me a fraction of a second of audio followed by a fraction of a second of silence (the silence seems to be longer for higher bitrate streams). What made me believe it was actually the new version is I went back to the previous version, and it picks up the stream just fine (although not all the stations work as I had previously mentioned in another issue).

I hate to be a bother, but..
Since I am not entirely fluent in all of GitHub's features, I haven't been able to find where it will list the changes made from one file to another, so I am uncertain of what was actually changed, but you had said it was something to do with the difference between "content-type" and "Content-Type" I believe.
As you had said, all of the streams appear to be sending audio in this new version, however I can't actually listen to any of them as they are all full of gaps. To me, it seems like the ESP is no longer keeping the buffer full enough for smooth playback, so it seems we may need to find an alternate (faster) fix for the issue? Its unfortunate that the patch didn't work out as I had hoped.

Ideas? Thoughts?

Edzelf, 2017-05-29:
The "26 May 2017 14:35" version should play smoothly.  Al least mine is....
You may use the TEST command to inspect the filling of the ringbuffer.  This should be close to 20000.  Then you also see the number of bytes in the input stream.  If this is zero, the WiFi connection is poor.
The list of changes is kept in the sketch itself.
If you have 7 dollars to spare, switch to the ESP32 version.  It is more stable and has more goodies.

koskee, 2017-05-29:
I think ive figured it out.

I was getting a lot of "mpeg compression" noises, ie. Blips and bloops and various garbled sounds from the radio that hadn't been apparent in earlier testing. I rearranged my breadboard, thinking I was maybe corrupting the data running power lines beside signal lines, with very limited success. It helped a bit but the odd corruption sounds were completely stubborn and would not go away. I tried adding a hefty capacitor to the 5v power rail, and a smaller one on the 3v3 rail, in case it was a power supply issue - marginal improvement.

I saw you said elsewhere that the reset circuit could be removed, so I ran the reset line to the reset on the ESP. This prevented both from booting or even flashing the LED. So I ran it to the 3.3v pwr bus, and it was kind of working, but the noise was super prevalent.

I clearly wasn't thinking, because the mp3 board is not 3v3, it's a 5v. Connected the reset line directly to the 5v bus, and the difference was immediately obvious (tried with a resistor first which didn't really help). My jaw hit the floor. The audio from the module is now crystal clear and everything seems WAY more stable, in terms of the audio anyway.

So I'm thinking this is the way to go. The esp can only put out 3v3 on a good day, and add a diode drop, even with a smaller shottky drop would put that into the dreadedful "undefined"  voltage range pretty easily.

So for anyone getting strange output from the 1053 board, giving the reset line a solid 5v really helped.

Now I'll just have to try the latest version again and see if the problem has been remedied.

Ps.
I ordered a couple esp32s dev boards this weekend, just have to wait for them to arrive. Paid for quick shipping, so hopefully by week's end..

Edzelf, 2017-05-29:
3.3 Volt should be enough.  But I found that the reset line of the VS1053 seems to pick-up the high frequency of the ESP transmitter easily.  A very short line to the reset of the ESP should work.  But +5 Volt is also a good solution, then it can be reset by power-off.

koskee, 2017-06-01:
Made some progress with incorporating a reset circuit that was controllable with the esp but still gave solid output.

What I did was take the two dual diode outputs and feed them into the a annode of an opticoupler with ~100ohm series resistor from cathode to ground. The collector of the PC817 opticoupler was fed 5V from the rail, and the emitter was connected to the XRST. This was still a bit choppy so I reinforced the voltage level coming out of the 817 with a 4.7uF cap between ground and the emitter, which manages to hold the reset line steady at around 4.2V coming out of the opticoupler.

I also should mention that I've got a 2200uF electrolytic cap and a yellow 10nF multilayer ceramic on my 5V power bus, and a 63uF Electro holding the 3v3 bus stable.

Overall it works really well, despite being a little component happy. I think that once I get it onto a perf board instead of the solderless breadboard I've been using for testing & experimenting, that all most of the wiring can be kept reply short and soldered in for a superior connection compared to the cheap pressure clips in my breadboard.

koskee, 2017-06-06:
I've now moved on to ESP32, and for anybody that is on the fence about whether the upgrade is worthwhile, there truly is no question about it.

Where the 8266 just barely covered the bases of running this setup, the ESP32 is all that AND a bag of potato chips. It's clearly got plenty of room to spare, and the webinterface actually works properly!
From what I've seen so far, the new 32 platform can fully handle the task, and without making any compromises along the way.

For example, Ive upped my ring buffer to 32,000 - to start -  and I'm sure I can go much higher.. I am going to see if I can find the upper limit of that sometime soon. I found the esp would only run reliably with around 21000 - maaaybe 22000 in the buffer before it got unstable.

Cheers guys, good luck

Closed 2017-06-06.

Thread 93 (2017-05-29):

Feature Request: Add a2dp as soon as it is available in arduino-esp32

68erDirk, 2017-05-29:
One of the great improvements of ESP32 is the integrated bluetooth feature. For ESP-idf there is already an example for a a2dp sink (https://github.com/espressif/esp-idf/tree/master/examples/bluetooth/a2dp_sink). I hope this will soon be available in the arduino esp32 as well. At that point I would appreciate to have it integrated in order to be able to connect a smartphone vie bluetooth and play the a2dp stream on my esp-radio.

Edzelf, 2017-05-29:
Please put ESP32-Radio issues at the ESP32-Radio repository.

68erDirk, 2017-05-29:
Sorry. Changed now!

Edzelf, 2017-05-29:
Have to wait for Arduino version indeed.

Closed 2017-05-29.

Thread 94 (2017-05-29):

Feature request: analogue buttons operation

vadpol, 2017-05-29:

vadpol, 2017-05-29:
I've managed to assemble as much compact version as possible in a small box with d-class amplifier and 2500 mAh lipo incorporated. Headphones also could be connected, then the amp is switched off automatically. It works perfectly well without any problem from the very beginning for max 10hrs continuous play on one battery charge. I saw that the newest update has the new resistor configuration of analogue buttons because many esps on the market have a0 input of 1V as a max. Propose just to change the one 10k resistor connected to the ground to 3,6k one as the simplest way. Then the output voltage of the total resistor chain will never exceed 1V whatever button is pushed. Secondly, also propose to configure the buttons as follows (after some practicing): one button just for incrementing (in a circle) of the preset stations, the remained two buttons for volume adjusment up and down. This will be more convenient for using of the device on the run without need to go to a webpage to do so. Many thanks!

Edzelf, 2017-05-30:
If you have only one power source, you may have sound distortion due to the unusual analog output of the VS1053.  Maybe you classs-d amplifier works perfectly with the VS1053.  What type do you use?
The analog buttons in my example will output 139 mV with no button pushed, The buttons will generate 161, 192 or 238 mV.  But you are free to use other values.  The software will search for the nearest value with respect to asw1, asw2, asw3.  asw1, asw2, asw3 are in ADC counts, not mV.
The ESP32 version has up to 14 free definable digital input for this purpose.

vadpol, 2017-05-30:
I use just generic PAM8403 based Chinese made d-class stereo amplifier and didn't find any sound distortion so far even everything is working on one battery. I also modified a power scheme (by using of a very compact 5V operated relay of DPDT type) and two switching groups two position slide switch in such a way that there are two power modes available.  If no USB power connected: - there is total OFF mode or battery power ON mode. If USB power connected (which triggers a relay if so): - power ON mode from USB source only or BATTERY CHARGING mode (no power to the rest of the scheme). I could share the diagram if I manage to draw it nicely :)  As for the analogue buttons - they are working fine with my described above setup and the following values: asw1 = 309, asw2 = 779, asw3 = 446. The preset stations could be incremented or decremented by the buttons, also to set the initial one by dedicated button. No issue with that. My request is a bit different - as I am more to hardware than to software - would it be possible  to assign (in the code) two analogue buttons for the volume adjustment, not for choosing of the preset stations up and down? As to my practical experience with the device  so far one button is well enough to pick up the station if repeatedely pushed and thus going through the presets one by one in a loop. The remained two buttons in this case would be much more convenient to use for the volume adjustment up and down.  Honestly I've tried to do so already in the code but my change causes the full reset when one of the two buttons is pushed :( so suspect that I didn't take everything into consideration. I believe that just small code change is needed in this case, but do not aware  where exactly... It would be nice to have a proposed version I think. Could you work it out or just give a clue on what to change in the code? ESP8266 version is used. Many thanks!

vadpol, 2017-05-30:
Here is a small video on how it sounds however still USB powered and with active external sound boxes
[ESP Web radio.zip](https://github.com/Edzelf/Esp-radio/files/1038470/ESP.Web.radio.zip)
Battery powered it sounds the same, no difference!

vadpol, 2017-05-30:
I do believe that sound distortion problem lies in the connecting cable length in between ESP8266 module and VS1053 module. It should be as short as possible. In my case there is no cable, everything is connected via intermediate small pcb where all the connections are done.

Edzelf, 2017-05-30:
Nice box you made!

Some class-d amplifiers have an analog common connected to GND.  The analog common of the VS1053 is at 1.65 Volt.  That will cause the destortion.

The code in timer100() could be something like this:
```
        dbgprint ( "Analog button %d pushed, v = %d", anewval, v ) ;
        if ( anewval == 1 )                         // Button 1?
        {
          ini_block.newpreset = currentpreset + 1 ; // Yes, goto next preset
        }
        else if ( anewval == 2 )                    // Button 2?
        {
          ini_block.reqvol += 2  ;                  // Increase volume
        }
        else if ( anewval == 3 )                    // Button 3?
        {
          ini_block.reqvol -= 2  ;                  // Decrease volume
        }
```

vadpol, 2017-05-30:
Many thanks, I will give it a try! I still want to encapsulate the box in a carbon film when it's done.  I was changing exactly the same subroutine timer100, but perhaps missed something. Let's see, I will come back soon.

vadpol, 2017-05-31:
Just tested with above correction - it works just fine! Good job! This will help to avoid a variable volume resistor at the side of the box, so even smaller size box then! If I am not so nasty - just thought that it also might be a good idea to implement a volume indication on the display in the bottom line, something like 'VOLUME = **' were ** could be just numbers from 00 to 99 (or 100) showing the present value. Will it be possible? Thanks a lot!

vadpol, 2017-05-31:
Made a small update of above code to keep the volume value within 0-100 range as it was jumping over:

dbgprint ( "Analog button %d pushed, v = %d", anewval, v ) ;
        if ( anewval == 1 )                         // Button 1?
        {
          ini_block.newpreset = currentpreset + 1 ; // Yes, goto next preset
        }
        else if ( anewval == 2 )                    // Button 2?
        {
          ini_block.reqvol += 2  ;                  // Increase volume
          if ( ini_block.reqvol > 100 )             // Keeping of the volume within upper limit
          ini_block.reqvol = 100 ;
        }
        else if ( anewval == 3 )                    // Button 3?
        {
          ini_block.reqvol -= 2  ;                  // Decrease volume
          if ( ini_block.reqvol < 0)                // Keeping of the volume within lower limit
          ini_block.reqvol = 0 ;
        }

Edzelf, 2017-05-31:
Volume indicator added in new version.

vadpol, 2017-05-31:
Everything works fine! Thanks a lot!

kolivi5, 2021-11-21:
Hi.
Please help with analog keys.
I made an esp radio with one button, and it works. I'm trying to insert 3 buttons but the buttons don't work.
I changed in the code:
 #define asw1    252
#define asw2    334
#define asw3    499
//#define asw1    2000
//#define asw2    2000
//#define asw3    2000
Do you need anything else
change?
Where is the mistake?

Edzelf, 2021-11-22:
This looks okay.   I would suggest to add some debug lines in the "anagetsw" function, like this:
```
//******************************************************************************************
//                                  A N A G E T S W                                        *
//******************************************************************************************
// Translate analog input to switch number.  0 is inactive.                                *
// Note that it is adviced to avoid expressions as the argument for the abs function.      *
//******************************************************************************************
uint8_t anagetsw ( uint16_t v )
{
  int      i ;                                    // Loop control
  int      oldmindist = 1000 ;                    // Detection least difference
  int      newdist ;                              // New found difference
  uint8_t  sw = 0 ;                               // Number of switch detected (0 or 1..3)

  if ( v > analogrest )                           // Inactive level?
  {
    for ( i = 0 ; i < NUMANA ; i++ )
    {
      dbgprint ( "ana switch seen" ) ;
      newdist = analogsw[i] - v ;                  // Compute difference
      newdist = abs ( newdist ) ;                  // Make it absolute
      if ( newdist < oldmindist )                  // New least difference?
      {
        oldmindist = newdist ;                     // Yes, remember
        sw = i + 1 ;                               // Remember switch
        dbgprint ( "sw may be %d", sw ) ;
      }
    }
    dbgprint ( "sw %d detected", sw ) ;
  }
  return sw ;                                      // Return active switch
}

```

kolivi5, 2021-11-23:
Hello,
thank you very much for your prompt response.

I've tried this code and it works (with R4=3k3)! Thank you again, you
helped a lot.

All the best,
Ivica

pon, 22. stu 2021. u 08:50 Ed Smallenburg ***@***.***>
napisao je:

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

Closed 2017-05-31.

Thread 97 (2017-06-24):

Modify the way to install ESP8266 in Arduino IDE

blotfi, 2017-06-24:
Hi
thanks for your work,
may I suggest you to modify in the pdf the way to install the 8266 boards, according to
https://github.com/esp8266/Arduino#installing-with-boards-manager
see below
That is much more simple than the old method

Also a schematic with fritzing would be nice

best regards
Lotfi

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

Thread 98 (2017-06-24):

Geeeteck VS1053 icw ESP12E dev board DOIT

ilioss, 2017-06-24:
Hello All,
[list-opstartesp8266-12E dev.txt](https://github.com/Edzelf/Esp-radio/files/1099817/list-opstartesp8266-12E.dev.txt)

After first building the internet radio with the ESP32 ( succesfull ) I started again with the original internet radio with the 12E.
Install. the ESP12E DEV KIT ( DOIT) on a geeeteck VS1053 arduino shield. No succes. After some looking around on internet I tested the board as mp3 player with succes. I was able to have song played from the sd card.
Again I connect to my ESP12E no succes.
So I have two doubts,
1) Is my ESP12 E still healty?
2) Howe do I check my geeetech shield or must it set for the correct operating mode?
The serial monotor list gives also as SV1053 test all 00000 aperntly I think it is not tested.
See enclosed list. On my ESP32 list some figures are filled with data other than 00000.
Like to hear,
Greetings,
Theo``

Edzelf, 2017-06-24:
As the debug logging shows only bad reads from VS1053, I'm pretty sure that the wiring is not correct.

ilioss, 2017-06-24:
Hi Ed,
Thanks for your quick reply.
Indeed the list show bad VS1053.
Either wrong and or bad connections between ESP12E dev kit and VS1053.
Menwhile I tested the ESP12 solo it works ok.
The VS1053 also tested as mp3 player looks ok.
Now i would like to test the i/o from both to start with the ESP12.
Can i test all the outputs like
pinMode (2, OUTPUT);

digitalWrite(2, high);
delay(1000);
digitalWrite(2, low);
delay(1000);

For all gpio,s?
Than i can check output for theire function.
Apart from that I will double check my connections.
Regards,
Theo

Edzelf, 2017-06-25:
Yes, good plan.  All input bits can be tested likewise.

Closed 2017-07-03.

Thread 99 (2017-07-10):

Allways errors from VS1053 on startup

ManfredEP, 2017-07-10:
Hello,
I tried to build the whole device and then load software and SPIFFS image but on start the device on serial interface allways reports a lot of errors. All belongs to VS1053 and looks like:
D: VS1053 error retry SB:000C R1:FFFF R2:FFFF
All the lines I could not copy here since the copy&paste doesn't work for unknown reason on the whole stuff ... only on parts like a single line. The hex data behind the SB: are different in different lines but not the R!: and R": parts bind it. What's wrong here? Are there chances it's only a missing connection or some other build-up error or is the VS1053 damaged?

greetings and thanks to all with any help (or any information where to go to get help if needed)

Edzelf, 2017-07-10:
Looks like a wiring error.  The error message come from a test.  Data is written to the VS1053 and then the data is read back twice and compared with the original data.  "SB"stands for "Should Be", "R1" for "Read back 1st try", "R2" for "Read back 2nd try".
So check the wiring of all 9 wires that go to the VS1053.  The reset line (pin 3) may be connected to the reset pin of the ESP8266.  Then you don't need the reset circuit.

Cut and past of the debug output works correct if you do not select the garbage lines at the beginning of the output.  So start with the first line containing "D:".

ManfredEP, 2017-07-10:
Thanks for your fast answer. You are right: the connections were wrong I found out by myself at 3 o'clock in the morning. Now I corrected the error but now the message is much shorter: vs1053 not properly installed. Hope the device is not damaged (due to the error one pin was shorted to V(DD)). I will check this now.

Thanks too for the help on cut&paste. Next time it would help I hope.

greetings

ManfredEP, 2017-07-10:
Taken wrong button, excuse me.

greetings

texynz, 2017-08-11:
Im getting similar:

D: Slow SPI,Testing VS1053 read/write registers...
D: VS1053 error retry SB:0000 R1:FFFF R2:FFFF
D: VS1053 error retry SB:012C R1:FFFF R2:FFFF
D: VS1053 error retry SB:0258 R1:FFFF R2:FFFF
D: VS1053 error retry SB:0384 R1:FFFF R2:FFFF
D: VS1053 error retry SB:04B0 R1:FFFF R2:FFFF
D: VS1053 error retry SB:05DC R1:FFFF R2:FFFF
D: VS1053 error retry SB:0708 R1:FFFF R2:FFFF
D: VS1053 error retry SB:0834 R1:FFFF R2:FFFF
D: VS1053 error retry SB:0960 R1:FFFF R2:FFFF
D: VS1053 error retry SB:0A8C R1:FFFF R2:FFFF
D: VS1053 error retry SB:0BB8 R1:FFFF R2:FFFF
D: VS1053 error retry SB:0CE4 R1:FFFF R2:FFFF
D: VS1053 error retry SB:0E10 R1:FFFF R2:FFFF
D: VS1053 error retry SB:0F3C R1:FFFF R2:FFFF
D: VS1053 error retry SB:1068 R1:FFFF R2:FFFF
D: VS1053 error retry SB:1194 R1:FFFF R2:FFFF
D: VS1053 error retry SB:12C0 R1:FFFF R2:FFFF
D: VS1053 error retry SB:13EC R1:FFFF R2:FFFF
D: VS1053 error retry SB:1518 R1:FFFF R2:FFFF
D: VS1053 error retry SB:1644 R1:FFFF R2:FFFF
D: VS1053 not properly installed!

Using this module

http://g01.a.alicdn.com/kf/HTB1UPydJVXXXXclXFXXq6xXFXXX1/Free-Shipping-1PCS-VS1003B-VS1053-MP3-Module-font-b-Development-b-font-Board-Onboard-font-b.jpg

Wiring is correct.

Tried bridging pins 31/32 just in case that board suffers from stuck in midi mode.

Gets the first chunk from the stream and then nothing. NOthing i heard.

Edzelf, 2017-08-12:
Looks like a problem with the SPI bus.  MISO seems to be HIGH all the time.  Has nothing to do with midi mode, bacause the test is performed on the volume register of the VS1053.

texynz, 2017-08-12:
Chucked that board and got a new one and it ran straight away. Buy cheap and you bound to get some bad ones in the batch.

Edzelf, 2017-08-12:
I managed to repair one faulty VS1053.  It had a solder bridge between 2 pins.

Thread 100 (2017-07-23):

Distorted audio output

web-sto, 2017-07-23:
Hello to all of may help me,

First of all, thanks to Ed for the great piece of work.

Now my issue, I got the setup to work without TFT for the moment, but the audio output sounds distorted, slower, artificial, not sure, but like using wrong codec. Symptoms are almost like issue #92, but playing with suggestions did not cure anything. Strange as well, wiring the reset circuit diodes give VS1053 setup error message in debug window and audio output does not start automatically, I need to pull the reset wire from VCC and put it back.

I'using a simple ESP8266-12F and a VS1053 with B chip and SD card option which is not wired.  Website interface is working, except volume option. Changing channels works fine. SPIFFS  buffer is on 20000.

Any suggestion is appreciated.

Hint for users getting resets on power on the ESP8266: Even though my ESP8266 breakout board was well equipped with capacitors on power supply I got only resets on power up. Simply adding additional VCC and GND wires to supply power to the ESP helped to solve the issue to power up the ESP.

STO

web-sto, 2017-07-23:
Hello,

Reading issue #101 I was trying what 64bit stream would sound like and indeed it played well.
Playing with the working setup, restarting, volume, treble/bass I noticed very low volume after restart. So raising volume using web interface made 128bit streams work as well.

So for me it seems volume is very low after power on, even though in config it is set on 72.

Closed 2017-07-27.

Thread 101 (2017-07-23):

can only process 64kBit streams

student1704, 2017-07-23:
I have build this project with NODEMCU 0.9 and VS1053 without a TFT.
But only 64kBit streams are processed properly. With faster streams the tone is unclear.

What to do?

Edzelf, 2017-07-23:
Please give the URL of a failing stream.  Can you check if this stream works on a Windows machine?

student1704, 2017-07-24:
I have tried many - alwas the same error. So, it is not a matter of one URL only.
I can hear voices from faster streams but it is not understandable.
Furthermore it seems that volume controll doesn't work or the output signal is extrem stong.
I use the VS1053B. Are the control commands different to the VS1053?

Edzelf, 2017-07-24:
Please give the URL of a failing stream. Can you check if this stream works on a Windows machine?

student1704, 2017-07-25:
I use the standard radio.ini and replaced item 6 and 7 with 64kbit streams. Those work any other not.
I think the problem comes from signal XSC. Because when I connect it as proposed - nothing happen. When I tie XCS with 10 K to GND then 64 kbit work. It seems - control commands are not accepted.

Edzelf, 2017-07-25:
Remove the reset circuit (the 2 diodesand the 1 k resistor).  Then tie the RST pin of the VS1053 to the RST of the NodeMcu or with a pull-up resistor to +3.3V

student1704, 2017-07-25:
Ok, I made the modifications, but without no success.
I attached 2 screenshots measured with my slow logic analyzer.
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

Edzelf, 2017-07-25:
Yes, XCS seems to be the problem.  It should be low during the clockpulses.

KabuloKans, 2018-01-19:
Hi Edzelf and congrats for your cool project !

Got same issues as student1704 (and the same chip V1053b).  Only streams below 64k are working correctly (without resistor tied to GND),  volume/tones settings aren't working but I can see commands executed in the serial terminal. (Other settings are working on the website version : Next/Prev/Stop/Resume/status/Test)

Got rid of breadboards, removed the reset circuits, etc...
Nothing worked and XCS always HIGH too.

Any idea ? (Maybe a small difference between V1053 and V1053B ?)

KabuloKans, 2018-01-19:
Don't really know why but this is working now...
Changed a jack adapter... (don't understand the link between amp and sound distortion...)

Thanks for your work anyway !

KabuloKans, 2018-01-19:
Is it possible that a capacitor (in ESP) is being in cause ?

While testing I had suddenly no sound from VS1053b output so I thought the problem was amp related.
I checked my cables (and tried a new one) and removed the ESP from my shield (DIY). Unfortunately (and shame on me!) I replaced the ESP upside/down for a second.
When I replaced the ESP correctly, everything was working.  Maybe I helped a capacitor to discharge.

Edzelf, 2018-01-19:
In the IDE: Select V1.4 Prebuilt as IwIP Variant. 256 kbps stations will work now.

KabuloKans, 2018-01-19:
Thank you for helping !

Thread 102 (2017-07-26):

Again error on ESP8266 with vs1053

ManfredEP, 2017-07-26:
Since the other one sends a lot of error messages back to master I bought a new vs1053. I had made some mistake on wiring SPI so the fault was not strange to me. But now it doesn't work too. SPI works fine (as I think on the messages from ESP). Wb Interface works too and a file playing I can start ... but there's nothing played. Allways the same: no data input.
`D: FS Total 2949250, used 1286626
FS Total 2949250, used 1286626
D: /radio.ini                       -     887
D: /Test.mp3                        - 1274727
D: Added SSID 00 = Rx5dsT to acceptable networks
D: * Scan Networks *
D: Number of available networks: 6
D:  1 - DIRECT-QLCLX-3300 Series  Signal: -85 dBm Encryption WPA2
D:  2 - Rx5dsTG                   Signal: -77 dBm Encryption WPA2
D:  3 - Gastzugang                Signal: -85 dBm Encryption Auto
D:  4 - FRITZ!Box Fon WLAN 7390   Signal: -76 dBm Encryption WPA2
D:  5 - Speedlink-967             Signal: -84 dBm Encryption WPA2
D:  6 - Rx5dsT                    Signal: -68 dBm Encryption Auto  Acceptable
D: --------------------------------------
D: Command: mqttbroker (without parameter)
D: Command: mqttport with parameter 1883
D: Command: mqttuser with parameter none
D: Command: mqttpasswd with parameter none
D: Command: mqtttopic with parameter kuechenradio
D: Command: mqttpubtopic with parameter kuechenradioIP
D: Command: wifi_00 with parameter Rx5dsT/--------------------------------
D: Command: volume with parameter 99
D: Command: toneha with parameter 0
D: Command: tonehf with parameter 0
D: Command: tonela with parameter 0
D: Command: tonelf with parameter 0
D: Command: preset with parameter 0
D: Command: preset_00 with parameter swr-swr4-rp.cast.addradio.de/swr/swr4/rp/mp3/128/stream.mp3
D: Starting ESP Version Wed, 31 May 2017 12:35:00 GMT...  Free memory 12992
Starting ESP Version Wed, 31 May 2017 12:35:00 GMT...  Free memory 12992
D: Sketch size 345264, free size 700416
Sketch size 345264, free size 700416
D: Reset VS1053...
D: End reset VS1053...
D: Slow SPI,Testing VS1053 read/write registers...
D: Fast SPI, Testing VS1053 read/write registers again...
D: endFillByte is 0
D: Selected network: Rx5dsT           
Selected network: Rx5dsT           
D: Try WiFi Rx5dsT
D: IP = 192.168.178.27
D: Start server for commands
D: STOP requested
D: Song stopped correctly after 0 msec
D: New preset/file requested (-1/0) from http://swr-swr4-rp.cast.addradio.de/swr/swr4/rp/mp3/128/strea
D: Connect to new host http://swr-swr4-rp.cast.addradio.de/swr/swr4/rp/mp3/128/stream.mp3
D: Connect to http on port 0, extension //swr-swr4-rp.cast.addradio.de/swr/swr4/rp/mp3/128/stream.mp3
D: Request http://swr-swr4-rp.cast.addradio.de/swr/swr4/rp/mp3/128/stream.mp3 failed!
D: No data input
D: No data input
D: Trying other station/file...
D: STOP requested
D: Song stopped correctly after 0 msec
D: New preset/file requested (0/0) from
`
Please excuse me: The password of my WiFi I have deleted with '-'. In original the password is correct. I have checked for it: the device is correctly connected to wifi and shown in the list the ap have.
Now the ini-file of the device:
`# radio.ini
# Initialization file for Esp-radio
#
# MQTT broker, credentials and topic  to subscribe
#
mqttbroker =  			# Broker to connect with
mqttport = 1883					            # Portnumber (1883 is default)
mqttuser = none					            # (No) username for broker
mqttpasswd = none				            # (No) password for broker
mqtttopic = kuechenradio				        # Topic for receiving commands
mqttpubtopic = kuechenradioIP			      # IP will be pubished here
#
# WiFi network credentials, may be more than on entry.  Strongest signal will be selected.
wifi_00 = Rx5dsT/--------------------------------

#
# VS1053 settings
volume = 99
toneha = 0
tonehf = 0
tonela = 0
tonelf = 0
#
# Presets
preset = 0					                               # Start with preset 0
preset_00 = http://swr-swr4-rp.cast.addradio.de/swr/swr4/rp/mp3/128/stream.mp3 #  0 - SWR4
# End of file
This is one station from here. The radio has a special purpose so only this is needed. If the one file on SPIFFS stored is requested through web interface this is the reaction:
`D: FileRequest received /index.html
D: Response sent
D: FileRequest received /favicon.ico
D: Response sent
D: list request from browser
D: FileRequest received /radio.css
D: Response sent
D: Command: station with parameter Test.mp3
D: Connect to new host Test.mp3
D: Connect to  on port 80, extension /
D: Request Test.mp3 failed!
D: No data input
D: Trying other station/file...
D: STOP requested
D: Song stopped correctly after 0 msec
D: New preset/file requested (0/0) from
`
So the question is: what is happening here? Or: Why nothing correct is happening here?

Thanks for suggestions or possible corrections

Manfred

Edzelf, 2017-07-27:
The problem lies in this line:
D: Connect to http on port 0, extensi....
Port 0 is wrong, it should be should be 80.
I will look into it.
A workaround may be to specify the preset like:
preset_00 = swr-swr4-rp.cast.addradio.de/swr/swr4/rp/mp3/128/stream.mp3:80     # 0 - SWR4

Edzelf, 2017-07-27:
For files on SPIFFS, you should specify the file like:
localhost/Test.mp3
Note that the name is case-sensitive.

Edzelf, 2017-07-27:
Found the problem.  Just remove the "http://" from the beginning of the line:
preset_00 = swr-swr4-rp.cast.addradio.de/swr/swr4/rp/mp3/128/stream.mp3 # 0 - SWR4

ManfredEP, 2017-07-27:
Hello,
first I checked with file, since for the radio check I have to change the ini file. That's the reaction on it:
`D: New preset/file requested (0/0) from
D: Command: station with parameter localhost/Test.mp3
D: First chunk:
D: 49 44 33 03 00 00 00 00
D: 01 68 54 50 45 31 00 00
D: 00 04 00 00 00 4D 43 32
D: 54 53 53 45 00 00 00 4C
D: Recovered from dataloss
D: No data input
D: No data input
D: Trying other station/file...
D: STOP requested
D: Song stopped correctly after 0 msec
D: New preset/file requested (0/0) from
`
As one can see it tries but it doesn't work. Is here anyone using this radio so I can check if there is anything other wrong (for example a problem in the software)? The error message looks for me like a try to read but any problem stops it.
Now I have changed the ini file. First the http:// at the beginning is out and :80 I have added at the end of the line.
That's the reaction:
`D: Start server for commands
D: STOP requested
D: Song stopped correctly after 0 msec
D: New preset/file requested (-1/0) from swr-swr4-rp.cast.addradio.de/swr/swr4/rp/mp3/128/stream.mp3:8
D: Connect to new host swr-swr4-rp.cast.addradio.de/swr/swr4/rp/mp3/128/stream.mp3:80
D: Connect to swr-swr4-rp.cast.addradio.de/swr/swr4/rp/mp3/128/stream.mp3 on port 80, extension /swr/s
D: Request swr-swr4-rp.cast.addradio.de/swr/swr4/rp/mp3/128/stream.mp3:80 failed!
D: No data input
D: No data input
`
You can see: It doesn't work. Any other ideas?

Manfred

ManfredEP, 2017-07-27:
Hello,
one addition: What's that:  on port 80, extension /swr/s? I mean the 'extension' and so on. On the file it wrote: extension //Test.mp3. That looks like a copy of a part of the name I keid in. But on the radion line this is not so since there is only one part liking simular: ....de/swr/swr4.... the part with 6 letters behind .de looks like this. But if so this is senceless. Do anyone know where this come from and what is the meaning of it? Why this is written? Or is it something wrong like a buffer overflow for example. The example lines for the ini file in the package are a lot shorter than this.

Manfred

Edzelf, 2017-07-27:
This is in my ini-file:
# Presets
preset = 0 # Start with preset 0
preset_00 = swr-swr4-rp.cast.addradio.de/swr/swr4/rp/mp3/128/stream.mp3 # 0 - SWR4

And this is the debug output:
D: New preset/file requested (-1/0) from swr-swr4-rp.cast.addradio.de/swr/swr4/rp/mp3/128/stream.mp3
D: Connect to new host swr-swr4-rp.cast.addradio.de/swr/swr4/rp/mp3/128/stream.mp3
D: Connect to swr-swr4-rp.cast.addradio.de on port 80, extension /swr/swr4/rp/mp3/128/stream.mp3
D: Connected to server
D: Switch to HEADER
D: Content-Type: audio/mpeg
D: audio/mpeg seen.
D: icy-description:SWR4. Da sind wir daheim
D: icy-genre:Varied
D: icy-name:SWR4 RP
D: icy-pub:1
D: icy-url:http://www.swr.de/swr4/rp
D: Server: dg-swr-http_dus-dtag_edge_40708f628e109c6bd708e8b067467adc
D: Cache-Control: no-cache, no-store
D: Access-Control-Allow-Origin: *
D: Access-Control-Allow-Headers: Origin, Accept, X-Requested-With, Content-Type
D: -Allow-Headers: Origin, Accept, X-Requested-With, Content-Type seen.
D: Access-Control-Allow-Methods: GET, OPTIONS, HEAD
D: Connection: Close
D: Expires: Mon, 26 Jul 1997 05:00:00 GMT
D: icy-metaint:16000
D: Switch to DATA, bitrate is 0, metaint is 16000
D: First chunk:
D: FF FB 94 60 C4 00 03 25
D: 47 DE 61 E3 33 6A 48 E1
D: 2B CD 25 23 25 0D 21 21
D: 77 86 2C 6D A9 12 87 AF
D: Metadata block 48 bytes
D: Streamtitle found, 47 bytes
D: StreamTitle='"Sternenregen" von Thomas Anders';

Edzelf, 2017-07-28:
Tip: you can change the ini-file through the web interface on the config page.

ManfredEP, 2017-08-11:
I've got it. It works now. There was one faulty connection on SPI. Now all is fine.

Thanks to all.

Manfred

Closed 2017-08-11.

Thread 103 (2017-08-09):

using oled 0.92" display

blotfi, 2017-08-09:
Hi
Thank you for sharing your project
Are they a version that uses the small oled 0.92" display?
Has anyone fork the project to use it?
thanks
Lotfi

Edzelf, 2017-08-09:
I think the display is too small to be useful for this project.

fredericplante, 2017-08-09:
To small unless you scroll the text.

blotfi, 2017-08-10:
just to display the radio canal and scroll the content information .
it is an I2C interface, and D3/D4 are available
What are the routines I have to rewrite ?
thanks
by the way your radio works great
what aout the reset circuit ? can I juste plug the RST to GND via 1k directly without the GPIO diodes

Edzelf, 2017-08-10:
Look at the code fragments after "#if defined (USETFT)".  Those are the parts that must be changed.
Consider to switch to the ESP32 version; it is much better.
The RST pin of the VS1053 can be tied to the reset pin of the ESP8266 or via a 1 k resistor to +3.3 Volt.
See also [https://github.com/Edzelf/Esp-radio/issues/32](https://github.com/Edzelf/Esp-radio/issues/32)

blotfi, 2017-08-10:
Ok, I share my code that use OLED : check defined ( USEOLED )
`
// https://github.com/olikraus/u8g2/wiki/u8g2setupcpp
U8G2_SSD1306_128X64_NONAME_F_SW_I2C u8g2(U8G2_R0, /* clock=*/ D4, /* data=*/ D3, /* reset=*/ U8X8_PIN_NONE);   // All Boards without Reset of the Display
`

but I disabled the scroll (look in the loop routine)  coz it makes the VC1053 buffer to be empty.. take too much ressources :-(
perhaps on ESP32 it will work better

here is the code
best

`//******************************************************************************************
//*  Esp_radio -- Webradio receiver for ESP8266, 1.8 color display and VS1053 MP3 module,  *
//*               by Ed Smallenburg (ed@smallenburg.nl)                                    *
//*  With ESP8266 running at 80 MHz, it is capable of handling up to 256 kb bitrate.       *
//*  With ESP8266 running at 160 MHz, it is capable of handling up to 320 kb bitrate.      *
//******************************************************************************************
// ESP8266 libraries used:
//  - ESP8266WiFi       - Part of ESP8266 Arduino default libraries.
//  - SPI               - Part of Arduino default libraries.
//  - Adafruit_GFX      - https://github.com/adafruit/Adafruit-GFX-Library
//  - TFT_ILI9163C      - https://github.com/sumotoy/TFT_ILI9163C
//  - ESPAsyncTCP       - https://github.com/me-no-dev/ESPAsyncTCP
//  - ESPAsyncWebServer - https://github.com/me-no-dev/ESPAsyncWebServer
//  - FS - https://github.com/esp8266/arduino-esp8266fs-plugin/releases/download/0.2.0/ESP8266FS-0.2.0.zip
//  - ArduinoOTA        - Part of ESP8266 Arduino default libraries.
//  - AsyncMqttClient   - https://github.com/marvinroger/async-mqtt-client
//  - TinyXML           - Fork https://github.com/adafruit/TinyXML
//
// A library for the VS1053 (for ESP8266) is not available (or not easy to find).  Therefore
// a class for this module is derived from the maniacbug library and integrated in this sketch.
//
// See http://www.internet-radio.com for suitable stations.  Add the stations of your choice
// to the .ini-file.
//
// Brief description of the program:
// First a suitable WiFi network is found and a connection is made.
// Then a connection will be made to a shoutcast server.  The server starts with some
// info in the header in readable ascii, ending with a double CRLF, like:
//  icy-name:Classic Rock Florida - SHE Radio
//  icy-genre:Classic Rock 60s 70s 80s Oldies Miami South Florida
//  icy-url:http://www.ClassicRockFLorida.com
//  content-type:audio/mpeg
//  icy-pub:1
//  icy-metaint:32768          - Metadata after 32768 bytes of MP3-data
//  icy-br:128                 - in kb/sec (for Ogg this is like "icy-br=Quality 2"
//
// After de double CRLF is received, the server starts sending mp3- or Ogg-data.  For mp3, this
// data may contain metadata (non mp3) after every "metaint" mp3 bytes.
// The metadata is empty in most cases, but if any is available the content will be presented on the TFT.
// Pushing the input button causes the player to select the next preset station present in the .ini file.
//
// The display used is a Chinese 1.8 color TFT module 128 x 160 pixels.  The TFT_ILI9163C.h
// file has been changed to reflect this particular module.  TFT_ILI9163C.cpp has been
// changed to use the full screenwidth if rotated to mode "3".  Now there is room for 26
// characters per line and 16 lines.  Software will work without installing the display.
// If no TFT is used, you may use GPIO2 and GPIO15 as control buttons.  See definition of "USETFT" below.
// Switches are than programmed as:
// GPIO2 : "Goto station 1"
// GPIO0 : "Next station"
// GPIO15: "Previous station".  Note that GPIO15 has to be LOW when starting the ESP8266.
//         The button for GPIO15 must therefore be connected to VCC (3.3V) instead of GND.

//
// For configuration of the WiFi network(s): see the global data section further on.
//
// The SPI interface for VS1053 and TFT uses hardware SPI.
//
// Wiring:
// NodeMCU  GPIO    Pin to program  Wired to LCD        Wired to VS1053      Wired to rest
// -------  ------  --------------  ---------------     -------------------  ---------------------
// D0       GPIO16  16              -                   pin 1 DCS            -
// D1       GPIO5    5              -                   pin 2 CS             LED on nodeMCU
// D2       GPIO4    4              -                   pin 4 DREQ           -
// D3       GPIO0    0 FLASH        -                   -                    Control button "Next station"
// D4       GPIO2    2              pin 3 (D/C)         -                    (OR)Control button "Station 1"
// D5       GPIO14  14 SCLK         pin 5 (CLK)         pin 5 SCK            -
// D6       GPIO12  12 MISO         -                   pin 7 MISO           -
// D7       GPIO13  13 MOSI         pin 4 (DIN)         pin 6 MOSI           -
// D8       GPIO15  15              pin 2 (CS)          -                    (OR)Control button "Previous station"
// D9       GPI03    3 RXD0         -                   -                    Reserved serial input
// D10      GPIO1    1 TXD0         -                   -                    Reserved serial output
// -------  ------  --------------  ---------------     -------------------  ---------------------
// GND      -        -              pin 8 (GND)         pin 8 GND            Power supply
// VCC 3.3  -        -              pin 6 (VCC)         -                    LDO 3.3 Volt
// VCC 5 V  -        -              pin 7 (BL)          pin 9 5V             Power supply
// RST      -        -              pin 1 (RST)         pin 3 RESET          Reset circuit
//
// The reset circuit is a circuit with 2 diodes to GPIO5 and GPIO16 and a resistor to ground
// (wired OR gate) because there was not a free GPIO output available for this function.
// This circuit is included in the documentation.
// Issues:
// Webserver produces error "LmacRxBlk:1" after some time.  After that it will work very slow.
// The program will reset the ESP8266 in such a case.  Now we have switched to async webserver,
// the problem still exists, but the program will not crash anymore.
// Upload to ESP8266 not reliable.
//
// 31-03-2016, ES: First set-up.
// 01-04-2016, ES: Detect missing VS1053 at start-up.
// 05-04-2016, ES: Added commands through http server on port 80.
// 14-04-2016, ES: Added icon and switch preset on stream error.
// 18-04-2016, ES: Added SPIFFS for webserver.
// 19-04-2016, ES: Added ringbuffer.
// 20-04-2016, ES: WiFi Passwords through SPIFFS files, enable OTA.
// 21-04-2016, ES: Switch to Async Webserver.
// 27-04-2016, ES: Save settings, so same volume and preset will be used after restart.
// 03-05-2016, ES: Add bass/treble settings (see also new index.html).
// 04-05-2016, ES: Allow stations like "skonto.ls.lv:8002/mp3".
// 06-05-2016, ES: Allow hiddens WiFi station if this is the only .pw file.
// 07-05-2016, ES: Added preset selection in webserver.
// 12-05-2016, ES: Added support for Ogg-encoder.
// 13-05-2016, ES: Better Ogg detection.
// 17-05-2016, ES: Analog input for commands, extra buttons if no TFT required.
// 26-05-2016, ES: Fixed BUTTON3 bug (no TFT).
// 27-05-2016, ES: Fixed restore station at restart.
// 04-07-2016, ES: WiFi.disconnect clears old connection now (thanks to Juppit).
// 23-09-2016, ES: Added commands via MQTT and Serial input, Wifi set-up in AP mode.
// 04-10-2016, ES: Configuration in .ini file. No more use of EEPROM and .pw files.
// 11-10-2016, ES: Allow stations that have no bitrate in header like icecast.err.ee/raadio2.mp3.
// 14-10-2016, ES: Updated for async-mqtt-client-master 0.5.0
// 22-10-2016, ES: Correction mute/unmute.
// 15-11-2016, ES: Support for .m3u playlists.
// 22-12-2016, ES: Support for localhost (play from SPIFFS).
// 28-12-2016, ES: Implement "Resume" request.
// 31-12-2016, ES: Allow ContentType "text/css".
// 02-01-2017, ES: Webinterface in PROGMEM.
// 16-01-2017, ES: Correction playlists.
// 17-01-2017, ES: Bugfix config page and playlist.
// 23-01-2017, ES: Bugfix playlist.
// 26-01-2017, ES: Check on wrong icy-metaint.
// 30-01-2017, ES: Allow chunked transfer encoding.
// 01-02-2017, ES: Bugfix file upload.
// 26-04-2017, ES: Better output webinterface on preset change.
// 03-05-2017, ES: Prevent to start inputstream if no network.
// 04-05-2017, ES: Integrate iHeartRadio, thanks to NonaSuomy.
// 09-05-2017, ES: Fixed abs problem.
// 11-05-2017, ES: Convert UTF8 characters before display, thanks to everyb313.
// 24-05-2017, ES: Correction. Do not skip first part of .mp3 file.
// 26-05-2017, ES: Correction playing from .m3u playlist and LC/UC problem.
// 31-05-2017, ES: Volume indicator on TFT.
//
// Define the version number, also used for webserver as Last-Modified header:
#define VERSION "Wed, 31 May 2017 12:35:00 GMT"
// TFT.  Define USETFT if required.
//#define USETFT
#include <ESP8266WiFi.h>
#include <ESPAsyncTCP.h>
#include <ESPAsyncWebServer.h>
#include <AsyncMqttClient.h>
#include <SPI.h>
#if defined ( USETFT )
#include <Adafruit_GFX.h>
#include <TFT_ILI9163C.h>
#endif
#include <Ticker.h>
#include <stdio.h>
#include <string.h>
#include <FS.h>
#include <ArduinoOTA.h>
#include <TinyXML.h>

#define USEOLED
#if defined ( USEOLED )
#include <U8g2lib.h>

#ifdef U8X8_HAVE_HW_I2C
#include <Wire.h>
#endif

#define dy 16
#define y0 14
#endif

extern "C"
{
#include "user_interface.h"
}

// Definitions for 3 control switches on analog input
// You can test the analog input values by holding down the switch and select /?analog=1
// in the web interface. See schematics in the documentation.
// Switches are programmed as "Goto station 1", "Next station" and "Previous station" respectively.
// Set these values to 2000 if not used or tie analog input to ground.
#define NUMANA  3
//#define asw1    252
//#define asw2    334
//#define asw3    499
#define asw1    2000
#define asw2    2000
#define asw3    2000
//
// Color definitions for the TFT screen (if used)
#define BLACK   0x0000
#define BLUE    0xF800
#define RED     0x001F
#define GREEN   0x07E0
#define CYAN    GREEN | BLUE
#define MAGENTA RED | BLUE
#define YELLOW  RED | GREEN
#define WHITE   BLUE | RED | GREEN
// Digital I/O used
// Pins for VS1053 module
#define VS1053_CS     5
#define VS1053_DCS    16
#define VS1053_DREQ   4
// Pins CS and DC for TFT module (if used, see definition of "USETFT")
#define TFT_CS 15
#define TFT_DC 2
// Control button (GPIO) for controlling station
#define BUTTON1 2
#define BUTTON2 0
#define BUTTON3 15
// Ringbuffer for smooth playing. 20000 bytes is 160 Kbits, about 1.5 seconds at 128kb bitrate.
#define RINGBFSIZ 20000
// Debug buffer size
#define DEBUG_BUFFER_SIZE 100
// Name of the ini file
#define INIFILENAME "/radio.ini"
// Access point name if connection to WiFi network fails.  Also the hostname for WiFi and OTA.
// Not that the password of an AP must be at least as long as 8 characters.
// Also used for other naming.
#define NAME "Esp-radio"
// Maximum number of MQTT reconnects before give-up
#define MAXMQTTCONNECTS 20
//
//******************************************************************************************
// Forward declaration of various functions                                                *
//******************************************************************************************
void   displayinfo ( const char* str, uint16_t pos, uint16_t height, uint16_t color ) ;
void   showstreamtitle ( const char* ml, bool full = false ) ;
void   handlebyte ( uint8_t b, bool force = false ) ;
void   handlebyte_ch ( uint8_t b, bool force = false ) ;
void   handleFS ( AsyncWebServerRequest* request ) ;
void   handleFSf ( AsyncWebServerRequest* request, const String& filename ) ;
void   handleCmd ( AsyncWebServerRequest* request )  ;
void   handleFileUpload ( AsyncWebServerRequest* request, String filename,
                          size_t index, uint8_t* data, size_t len, bool final ) ;
char*  dbgprint( const char* format, ... ) ;
char*  analyzeCmd ( const char* str ) ;
char*  analyzeCmd ( const char* par, const char* val ) ;
String chomp ( String str ) ;
void   publishIP() ;
String xmlparse ( String mount ) ;

//
//******************************************************************************************
// Global data section.                                                                    *
//******************************************************************************************
// There is a block ini-data that contains some configuration.  Configuration data is      *
// saved in the SPIFFS file radio.ini by the webinterface.  On restart the new data will   *
// de read from this file.                                                                 *
// Items in ini_block can be changed by commands from webserver/MQTT/Serial.               *
//******************************************************************************************
struct ini_struct
{
  String         mqttbroker ;                              // The name of the MQTT broker server
  uint16_t       mqttport ;                                // Port, default 1883
  String         mqttuser ;                                // User for MQTT authentication
  String         mqttpasswd ;                              // Password for MQTT authentication
  String         mqtttopic ;                               // Topic to suscribe to
  String         mqttpubtopic ;                            // Topic to pubtop (IP will be published)
  uint8_t        reqvol ;                                  // Requested volume
  uint8_t        rtone[4] ;                                // Requested bass/treble settings
  int8_t         newpreset ;                               // Requested preset
  String         ssid ;                                    // SSID of WiFi network to connect to
  String         passwd ;                                  // Password for WiFi network
} ;

enum datamode_t { INIT = 1, HEADER = 2, DATA = 4,
                  METADATA = 8, PLAYLISTINIT = 16,
                  PLAYLISTHEADER = 32, PLAYLISTDATA = 64,
                  STOPREQD = 128, STOPPED = 256
                } ;        // State for datastream

// Global variables
int              DEBUG = 1 ;
ini_struct       ini_block ;                               // Holds configurable data
WiFiClient       mp3client ;                               // An instance of the mp3 client
AsyncWebServer   cmdserver ( 80 ) ;                        // Instance of embedded webserver on port 80
AsyncMqttClient  mqttclient ;                              // Client for MQTT subscriber
IPAddress        mqtt_server_IP ;                          // IP address of MQTT broker
char             cmd[130] ;                                // Command from MQTT or Serial
#if defined ( USETFT )
TFT_ILI9163C     tft = TFT_ILI9163C ( TFT_CS, TFT_DC ) ;
#endif
#if defined ( USEOLED )
// https://github.com/olikraus/u8g2/wiki/u8g2setupcpp
u8g2_uint_t offset1, offset2;			// current offset for the scrolling text
u8g2_uint_t width1, width2;			// pixel width of the scrolling text (must be lesser than 128 unless U8G2_16BIT is defined
const unsigned int text1_y0=30, text2_y0=60;
char text1[] = "Radio Chaine 3             ";  // scroll this text from right to left
const int text1_len=27;
char text2[] = "Katy Perry - Miss You More                      ";  // scroll this text from right to left
const int text2_len=48;

U8G2_SSD1306_128X64_NONAME_F_SW_I2C u8g2(U8G2_R0, /* clock=*/ D4, /* data=*/ D3, /* reset=*/ U8X8_PIN_NONE);   // All Boards without Reset of the Display
#endif

Ticker           tckr ;                                    // For timing 100 msec
TinyXML          xml;                                      // For XML parser.
uint32_t         totalcount = 0 ;                          // Counter mp3 data
datamode_t       datamode ;                                // State of datastream
int              metacount ;                               // Number of bytes in metadata
int              datacount ;                               // Counter databytes before metadata
String           metaline ;                                // Readable line in metadata
String           icystreamtitle ;                          // Streamtitle from metadata
String           icyname ;                                 // Icecast station name
int              bitrate ;                                 // Bitrate in kb/sec
int              metaint = 0 ;                             // Number of databytes between metadata
int8_t           currentpreset = -1 ;                      // Preset station playing
String           host ;                                    // The URL to connect to or file to play
String           playlist ;                                // The URL of the specified playlist
bool             xmlreq = false ;                          // Request for XML parse.
bool             hostreq = false ;                         // Request for new host
bool             reqtone = false ;                         // New tone setting requested
bool             muteflag = false ;                        // Mute output
uint8_t*         ringbuf ;                                 // Ringbuffer for VS1053
uint16_t         rbwindex = 0 ;                            // Fill pointer in ringbuffer
uint16_t         rbrindex = RINGBFSIZ - 1 ;                // Emptypointer in ringbuffer
uint16_t         rcount = 0 ;                              // Number of bytes in ringbuffer
uint16_t         analogsw[NUMANA] = { asw1, asw2, asw3 } ; // 3 levels of analog input
uint16_t         analogrest ;                              // Rest value of analog input
bool             resetreq = false ;                        // Request to reset the ESP8266
bool             NetworkFound ;                            // True if WiFi network connected
String           networks ;                                // Found networks
String           anetworks ;                               // Aceptable networks (present in .ini file)
String           presetlist ;                              // List for webserver
uint8_t          num_an ;                                  // Number of acceptable networks in .ini file
String           testfilename = "" ;                       // File to test (SPIFFS speed)
uint16_t         mqttcount = 0 ;                           // Counter MAXMQTTCONNECTS
int8_t           playlist_num = 0 ;                        // Nonzero for selection from playlist
File             mp3file  ;                                // File containing mp3 on SPIFFS
bool             localfile = false ;                       // Play from local mp3-file or not
bool             chunked = false ;                         // Station provides chunked transfer
int              chunkcount = 0 ;                          // Counter for chunked transfer

// XML parse globals.
const char* xmlhost = "playerservices.streamtheworld.com" ;// XML data source
const char* xmlget =  "GET /api/livestream"                // XML get parameters
                      "?version=1.5"                       // API Version of IHeartRadio
                      "&mount=%sAAC"                       // MountPoint with Station Callsign
                      "&lang=en" ;                         // Language
int         xmlport = 80 ;                                 // XML Port
uint8_t     xmlbuffer[150] ;                               // For XML decoding
String      xmlOpen ;                                      // Opening XML tag
String      xmlTag ;                                       // Current XML tag
String      xmlData ;                                      // Data inside tag
String      stationServer( "" ) ;                          // Radio stream server
String      stationPort( "" ) ;                            // Radio stream port
String      stationMount( "" ) ;                           // Radio stream Callsign

//******************************************************************************************
// End of global data section.                                                             *
//******************************************************************************************

//******************************************************************************************
// Pages and CSS for the webinterface.                                                     *
//******************************************************************************************
#include "about_html.h"
#include "config_html.h"
#include "index_html.h"
#include "radio_css.h"
#include "favicon_ico.h"
//
//******************************************************************************************
// VS1053 stuff.  Based on maniacbug library.                                              *
//******************************************************************************************
// VS1053 class definition.                                                                *
//******************************************************************************************
class VS1053
{
  private:
    uint8_t       cs_pin ;                        // Pin where CS line is connected
    uint8_t       dcs_pin ;                       // Pin where DCS line is connected
    uint8_t       dreq_pin ;                      // Pin where DREQ line is connected
    uint8_t       curvol ;                        // Current volume setting 0..100%
    const uint8_t vs1053_chunk_size = 32 ;
    // SCI Register
    const uint8_t SCI_MODE          = 0x0 ;
    const uint8_t SCI_BASS          = 0x2 ;
    const uint8_t SCI_CLOCKF        = 0x3 ;
    const uint8_t SCI_AUDATA        = 0x5 ;
    const uint8_t SCI_WRAM          = 0x6 ;
    const uint8_t SCI_WRAMADDR      = 0x7 ;
    const uint8_t SCI_AIADDR        = 0xA ;
    const uint8_t SCI_VOL           = 0xB ;
    const uint8_t SCI_AICTRL0       = 0xC ;
    const uint8_t SCI_AICTRL1       = 0xD ;
    const uint8_t SCI_num_registers = 0xF ;
    // SCI_MODE bits
    const uint8_t SM_SDINEW         = 11 ;        // Bitnumber in SCI_MODE always on
    const uint8_t SM_RESET          = 2 ;         // Bitnumber in SCI_MODE soft reset
    const uint8_t SM_CANCEL         = 3 ;         // Bitnumber in SCI_MODE cancel song
    const uint8_t SM_TESTS          = 5 ;         // Bitnumber in SCI_MODE for tests
    const uint8_t SM_LINE1          = 14 ;        // Bitnumber in SCI_MODE for Line input
    SPISettings   VS1053_SPI ;                    // SPI settings for this slave
    uint8_t       endFillByte ;                   // Byte to send when stopping song
  protected:
    inline void await_data_request() const
    {
      while ( !digitalRead ( dreq_pin ) )
      {
        yield() ;                                 // Very short delay
      }
    }

    inline void control_mode_on() const
    {
      SPI.beginTransaction ( VS1053_SPI ) ;       // Prevent other SPI users
      digitalWrite ( dcs_pin, HIGH ) ;            // Bring slave in control mode
      digitalWrite ( cs_pin, LOW ) ;
    }

    inline void control_mode_off() const
    {
      digitalWrite ( cs_pin, HIGH ) ;             // End control mode
      SPI.endTransaction() ;                      // Allow other SPI users
    }

    inline void data_mode_on() const
    {
      SPI.beginTransaction ( VS1053_SPI ) ;       // Prevent other SPI users
      digitalWrite ( cs_pin, HIGH ) ;             // Bring slave in data mode
      digitalWrite ( dcs_pin, LOW ) ;
    }

    inline void data_mode_off() const
    {
      digitalWrite ( dcs_pin, HIGH ) ;            // End data mode
      SPI.endTransaction() ;                      // Allow other SPI users
    }

    uint16_t read_register ( uint8_t _reg ) const ;
    void     write_register ( uint8_t _reg, uint16_t _value ) const ;
    void     sdi_send_buffer ( uint8_t* data, size_t len ) ;
    void     sdi_send_fillers ( size_t length ) ;
    void     wram_write ( uint16_t address, uint16_t data ) ;
    uint16_t wram_read ( uint16_t address ) ;

  public:
    // Constructor.  Only sets pin values.  Doesn't touch the chip.  Be sure to call begin()!
    VS1053 ( uint8_t _cs_pin, uint8_t _dcs_pin, uint8_t _dreq_pin ) ;
    void     begin() ;                                   // Begin operation.  Sets pins correctly,
    // and prepares SPI bus.
    void     startSong() ;                               // Prepare to start playing. Call this each
    // time a new song starts.
    void     playChunk ( uint8_t* data, size_t len ) ;   // Play a chunk of data.  Copies the data to
    // the chip.  Blocks until complete.
    void     stopSong() ;                                // Finish playing a song. Call this after
    // the last playChunk call.
    void     setVolume ( uint8_t vol ) ;                 // Set the player volume.Level from 0-100,
    // higher is louder.
    void     setTone ( uint8_t* rtone ) ;                // Set the player baas/treble, 4 nibbles for
    // treble gain/freq and bass gain/freq
    uint8_t  getVolume() ;                               // Get the currenet volume setting.
    // higher is louder.
    void     printDetails ( const char *header ) ;       // Print configuration details to serial output.
    void     softReset() ;                               // Do a soft reset
    bool     testComm ( const char *header ) ;           // Test communication with module
    inline bool data_request() const
    {
      return ( digitalRead ( dreq_pin ) == HIGH ) ;
    }
} ;

//******************************************************************************************
// VS1053 class implementation.                                                            *
//******************************************************************************************

VS1053::VS1053 ( uint8_t _cs_pin, uint8_t _dcs_pin, uint8_t _dreq_pin ) :
  cs_pin(_cs_pin), dcs_pin(_dcs_pin), dreq_pin(_dreq_pin)
{
}

uint16_t VS1053::read_register ( uint8_t _reg ) const
{
  uint16_t result ;

  control_mode_on() ;
  SPI.write ( 3 ) ;                                // Read operation
  SPI.write ( _reg ) ;                             // Register to write (0..0xF)
  // Note: transfer16 does not seem to work
  result = ( SPI.transfer ( 0xFF ) << 8 ) |        // Read 16 bits data
           ( SPI.transfer ( 0xFF ) ) ;
  await_data_request() ;                           // Wait for DREQ to be HIGH again
  control_mode_off() ;
  return result ;
}

void VS1053::write_register ( uint8_t _reg, uint16_t _value ) const
{
  control_mode_on( );
  SPI.write ( 2 ) ;                                // Write operation
  SPI.write ( _reg ) ;                             // Register to write (0..0xF)
  SPI.write16 ( _value ) ;                         // Send 16 bits data
  await_data_request() ;
  control_mode_off() ;
}

void VS1053::sdi_send_buffer ( uint8_t* data, size_t len )
{
  size_t chunk_length ;                            // Length of chunk 32 byte or shorter

  data_mode_on() ;
  while ( len )                                    // More to do?
  {
    await_data_request() ;                         // Wait for space available
    chunk_length = len ;
    if ( len > vs1053_chunk_size )
    {
      chunk_length = vs1053_chunk_size ;
    }
    len -= chunk_length ;
    SPI.writeBytes ( data, chunk_length ) ;
    data += chunk_length ;
  }
  data_mode_off() ;
}

void VS1053::sdi_send_fillers ( size_t len )
{
  size_t chunk_length ;                            // Length of chunk 32 byte or shorter

  data_mode_on() ;
  while ( len )                                    // More to do?
  {
    await_data_request() ;                         // Wait for space available
    chunk_length = len ;
    if ( len > vs1053_chunk_size )
    {
      chunk_length = vs1053_chunk_size ;
    }
    len -= chunk_length ;
    while ( chunk_length-- )
    {
      SPI.write ( endFillByte ) ;
    }
  }
  data_mode_off();
}

void VS1053::wram_write ( uint16_t address, uint16_t data )
{
  write_register ( SCI_WRAMADDR, address ) ;
  write_register ( SCI_WRAM, data ) ;
}

uint16_t VS1053::wram_read ( uint16_t address )
{
  write_register ( SCI_WRAMADDR, address ) ;            // Start reading from WRAM
  return read_register ( SCI_WRAM ) ;                   // Read back result
}

bool VS1053::testComm ( const char
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

Thread 104 (2017-08-11):

no response from web interface

PeterFF, 2017-08-11:
Dear Mr. Smallenburg

thank you upfront for your great project work. The MP3 ESP-Radio plays all my streams nicely, with TFT display and configuration via the Android App.

The issue why I am contacting you is that the web interface of the esp-radio isn’t responding.

Neither the index.html nor config.html page complete and when looking into the source-code-of-the-page it seems randomly only one or most of the time no TCP packet
arrived with the/all browser/s running into a timeout. The esp-radio log shows successful delivery of the requested html page.  Even the tiny content of the about.html is not delivered complete.
I can GET and SET individual parameters via the webbrowser only.

I did test it on ESP8266-12E, NodeMCU ESP8266-12, WeMos ESP8266 boards, (80 and 160MHz) with always same behaviour
I use Arduino 1.8.3, ESP8266 core 2.3.0 (same problem with “your” 2.2.0 core) with latest ESPAsyncTCP and ESPAsyncWebserver from github.
Surprisingly the ESPAsyncWebserver example is working fine.

Could you please advise how to get the webinterface running and might share your version of ESPAsyncTCP/Webserver (as zip), which I suspect as the source of this issue ?

Best regards
  Peter

Edzelf, 2017-08-11:
Peter,
This is a known problem, see [https://github.com/Edzelf/Esp-radio/issues/67](https://github.com/Edzelf/Esp-radio/issues/67)
Consider to switch to my ESP32 version of the radio.  The ESP32 seem to have better handling of the TCP input buffers and is much more stable.
You can find the ESPAsyncTCP webserver at [https://github.com/me-no-dev](https://github.com/me-no-dev).  I use the most recent version.

PeterFF, 2017-08-11:
Dear Ed,

thank you for the response. I have read issue #67 and thought only sometimes the webinterface fails, which would be acceptable.

Since I saw your screenshots of the webpages I thought I can use it for initial setup or updates, even if it sometime fails. But on my ESP8266 it never worked. So i will give up on the webinterface on EPS8266.

I did order an ESP32 already and will continue with this one. Nevertheless I will use the running ESP8266 esp-radio OLED in my kitchen, without web interface.

Btw.: On my second esp-radio I did attach an OLED 0'92 SH1106 via SPI to it with a frame buffer switching between different screen content every 5secs and NTP. If you like I can provide you my INO file.

Again thank you very much !

Best regards

  Peter

________________________________
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

Thread 105 (2017-08-16):

Command timings whilst streaming a file directly.

texynz, 2017-08-16:
If playing a MP3 from a file (HTTP served), using

?station = http:\\myserver\mymp3.mp3
or
?preset = 1 (where the saved preset is http:\\myserver\mymp3.mp3

You cannot stop the file being played by forcing another file to be streamed by setting another preset/station. No stop or forced stop is recognised.

I have tried setting two different files in the preset, but if i play preset1, and lets say it is 3min long, and 2minutes along i say to myself, i sick of this song, lets jump to the next track. I cannot change to preset2, and force it to play preset2. I seems like the code is not looking for/of has enough time to see another "command" whilst it is streaming preset1.

No issues if you are using proper streams, rather than direct file streams.

Is this a processing issue with the es8266 which can be resolved with the higher spec esp32 or more to do wit the way the direct mp3 file is streamed.

Edzelf, 2017-08-16:
I tested it with:
preset_10 = www.smallenburg.nl/kontiki.mp3
preset_11 = www.smallenburg.nl/friendly.mp3
That works correctly.  Maybe the bitrate of your MP3 is very high.
Anyway, consider to switch to ESP32.  It is much better.

texynz, 2017-08-16:
Ok I tried it with your presets and it works, and then tried it again via and external network and it worked prefectly, but not when using it within the same environment.

using
preset_10 = 192.168.1.5/mymp3.mp3
doesnt work for forcing it to stop mid playing

but using
preset_10 = myexternaldns/mymp3.mp3
works fine

Going to do a bit more testing. Dont think it is a bitrate issue cos same bit rate on both tests. Might be a router problem, but going to try a few things.

texynz, 2017-08-21:
Update on this. Still not sure what the actual issue is, but looks like it might have something to do with the router. I changed have tried it on a few different network setups/configs and sort of hit and miss and there is not specific pattern.

One of the things I am seeing when it doesnt work, is when I am watching the serial logs, I dont see the "stop" command when a new preset is set, also the track seems to loop itself, it is like the loop has detected a new preset command, but hasnt got enough time to set it, so just replays the last.

Thread 106 (2017-08-21):

Compiling error: XML_callback was not declared

Kneheim, 2017-08-21:
Hello,
great work. Exactly what I was looking for.
But I have problems compiling the sketch in Arduino.
All libraries are included. Also the tiny XML.
but I still get the message: XML_callback was not declared in that scope.
See screenshot attached.
Appreciate your help.

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

regards
Andreas

Kneheim, 2017-08-21:
sorry, had an old Arduino version running.
After updating it works.

Closed 2017-08-21.

Thread 109 (2017-10-18):

Current version with latest libraries fails to compile

Uksa007, 2017-10-18:
Using a WeMos D1 mini getting the following compile errors.
Any ideas?

C:\Users\Uksa007\Documents\Arduino\libraries\ESPAsyncTCP-master\src\ESPAsyncTCP.cpp: In constructor 'AsyncClient::AsyncClient(tcp_pcb*)':

C:\Users\Uksa007\Documents\Arduino\libraries\ESPAsyncTCP-master\src\ESPAsyncTCP.cpp:77:28: error: invalid conversion from 'long int (*)(void*, tcp_pcb*, pbuf*, long int)' to 'tcp_recv_fn {aka signed char (*)(void*, tcp_pcb*, pbuf*, signed char)}' [-fpermissive]

     tcp_recv(_pcb, &_s_recv);

                            ^

In file included from C:\Users\Uksa007\Documents\Arduino\libraries\ESPAsyncTCP-master\src\ESPAsyncTCP.cpp:27:0:

C:\Users\Uksa007\AppData\Local\Arduino15\packages\esp8266\hardware\esp8266\2.3.0/tools/sdk/lwip/include/lwip/tcp.h:318:18: error:   initializing argument 2 of 'void tcp_recv(tcp_pcb*, tcp_recv_fn)' [-fpermissive]

 void             tcp_recv    (struct tcp_pcb *pcb, tcp_recv_fn recv) ICACHE_FLASH_ATTR;

                  ^

C:\Users\Uksa007\Documents\Arduino\libraries\ESPAsyncTCP-master\src\ESPAsyncTCP.cpp:78:28: error: invalid conversion from 'long int (*)(void*, tcp_pcb*, uint16_t) {aka long int (*)(void*, tcp_pcb*, short unsigned int)}' to 'tcp_sent_fn {aka signed char (*)(void*, tcp_pcb*, short unsigned int)}' [-fpermissive]

     tcp_sent(_pcb, &_s_sent);

                            ^

In file included from C:\Users\Uksa007\Documents\Arduino\libraries\ESPAsyncTCP-master\src\ESPAsyncTCP.cpp:27:0:

C:\Users\Uksa007\AppData\Local\Arduino15\packages\esp8266\hardware\esp8266\2.3.0/tools/sdk/lwip/include/lwip/tcp.h:319:18: error:   initializing argument 2 of 'void tcp_sent(tcp_pcb*, tcp_sent_fn)' [-fpermissive]

 void             tcp_sent    (struct tcp_pcb *pcb, tcp_sent_fn sent)ICACHE_FLASH_ATTR;

                  ^

C:\Users\Uksa007\Documents\Arduino\libraries\ESPAsyncTCP-master\src\ESPAsyncTCP.cpp:79:28: error: invalid conversion from 'void (*)(void*, long int)' to 'tcp_err_fn {aka void (*)(void*, signed char)}' [-fpermissive]

     tcp_err(_pcb, &_s_error);

                            ^

In file included from C:\Users\Uksa007\Documents\Arduino\libraries\ESPAsyncTCP-master\src\ESPAsyncTCP.cpp:27:0:

C:\Users\Uksa007\AppData\Local\Arduino15\packages\esp8266\hardware\esp8266\2.3.0/tools/sdk/lwip/include/lwip/tcp.h:321:18: error:   initializing argument 2 of 'void tcp_err(tcp_pcb*, tcp_err_fn)' [-fpermissive]

 void             tcp_err     (struct tcp_pcb *pcb, tcp_err_fn err)ICACHE_FLASH_ATTR;

                  ^

C:\Users\Uksa007\Documents\Arduino\libraries\ESPAsyncTCP-master\src\ESPAsyncTCP.cpp:80:31: error: invalid conversion from 'long int (*)(void*, tcp_pcb*)' to 'tcp_poll_fn {aka signed char (*)(void*, tcp_pcb*)}' [-fpermissive]

     tcp_poll(_pcb, &_s_poll, 1);

                               ^

In file included from C:\Users\Uksa007\Documents\Arduino\libraries\ESPAsyncTCP-master\src\ESPAsyncTCP.cpp:27:0:

C:\Users\Uksa007\AppData\Local\Arduino15\packages\esp8266\hardware\esp8266\2.3.0/tools/sdk/lwip/include/lwip/tcp.h:320:18: error:   initializing argument 2 of 'void tcp_poll(tcp_pcb*, tcp_poll_fn, u8_t)' [-fpermissive]

 void             tcp_poll    (struct tcp_pcb *pcb, tcp_poll_fn poll, u8_t interval)ICACHE_FLASH_ATTR;

                  ^

C:\Users\Uksa007\Documents\Arduino\libraries\ESPAsyncTCP-master\src\ESPAsyncTCP.cpp: In member function 'bool AsyncClient::connect(IPAddress, uint16_t)':

C:\Users\Uksa007\Documents\Arduino\libraries\ESPAsyncTCP-master\src\ESPAsyncTCP.cpp:128:25: error: invalid conversion from 'void (*)(void*, long int)' to 'tcp_err_fn {aka void (*)(void*, signed char)}' [-fpermissive]

   tcp_err(pcb, &_s_error);

                         ^

In file included from C:\Users\Uksa007\Documents\Arduino\libraries\ESPAsyncTCP-master\src\ESPAsyncTCP.cpp:27:0:

C:\Users\Uksa007\AppData\Local\Arduino15\packages\esp8266\hardware\esp8266\2.3.0/tools/sdk/lwip/include/lwip/tcp.h:321:18: error:   initializing argument 2 of 'void tcp_err(tcp_pcb*, tcp_err_fn)' [-fpermissive]

 void             tcp_err     (struct tcp_pcb *pcb, tcp_err_fn err)ICACHE_FLASH_ATTR;

                  ^

C:\Users\Uksa007\Documents\Arduino\libraries\ESPAsyncTCP-master\src\ESPAsyncTCP.cpp: In member function 'AsyncClient& AsyncClient::operator=(const AsyncClient&)':

C:\Users\Uksa007\Documents\Arduino\libraries\ESPAsyncTCP-master\src\ESPAsyncTCP.cpp:166:28: error: invalid conversion from 'long int (*)(void*, tcp_pcb*, pbuf*, long int)' to 'tcp_recv_fn {aka signed char (*)(void*, tcp_pcb*, pbuf*, signed char)}' [-fpermissive]

     tcp_recv(_pcb, &_s_recv);

                            ^

In file included from C:\Users\Uksa007\Documents\Arduino\libraries\ESPAsyncTCP-master\src\ESPAsyncTCP.cpp:27:0:

C:\Users\Uksa007\AppData\Local\Arduino15\packages\esp8266\hardware\esp8266\2.3.0/tools/sdk/lwip/include/lwip/tcp.h:318:18: error:   initializing argument 2 of 'void tcp_recv(tcp_pcb*, tcp_recv_fn)' [-fpermissive]

 void             tcp_recv    (struct tcp_pcb *pcb, tcp_recv_fn recv) ICACHE_FLASH_ATTR;

                  ^

C:\Users\Uksa007\Documents\Arduino\libraries\ESPAsyncTCP-master\src\ESPAsyncTCP.cpp:167:28: error: invalid conversion from 'long int (*)(void*, tcp_pcb*, uint16_t) {aka long int (*)(void*, tcp_pcb*, short unsigned int)}' to 'tcp_sent_fn {aka signed char (*)(void*, tcp_pcb*, short unsigned int)}' [-fpermissive]

     tcp_sent(_pcb, &_s_sent);

                            ^

In file included from C:\Users\Uksa007\Documents\Arduino\libraries\ESPAsyncTCP-master\src\ESPAsyncTCP.cpp:27:0:

C:\Users\Uksa007\AppData\Local\Arduino15\packages\esp8266\hardware\esp8266\2.3.0/tools/sdk/lwip/include/lwip/tcp.h:319:18: error:   initializing argument 2 of 'void tcp_sent(tcp_pcb*, tcp_sent_fn)' [-fpermissive]

 void             tcp_sent    (struct tcp_pcb *pcb, tcp_sent_fn sent)ICACHE_FLASH_ATTR;

                  ^

C:\Users\Uksa007\Documents\Arduino\libraries\ESPAsyncTCP-master\src\ESPAsyncTCP.cpp:168:28: error: invalid conversion from 'void (*)(void*, long int)' to 'tcp_err_fn {aka void (*)(void*, signed char)}' [-fpermissive]

     tcp_err(_pcb, &_s_error);

                            ^

In file included from C:\Users\Uksa007\Documents\Arduino\libraries\ESPAsyncTCP-master\src\ESPAsyncTCP.cpp:27:0:

C:\Users\Uksa007\AppData\Local\Arduino15\packages\esp8266\hardware\esp8266\2.3.0/tools/sdk/lwip/include/lwip/tcp.h:321:18: error:   initializing argument 2 of 'void tcp_err(tcp_pcb*, tcp_err_fn)' [-fpermissive]

 void             tcp_err     (struct tcp_pcb *pcb, tcp_err_fn err)ICACHE_FLASH_ATTR;

                  ^

C:\Users\Uksa007\Documents\Arduino\libraries\ESPAsyncTCP-master\src\ESPAsyncTCP.cpp:169:31: error: invalid conversion from 'long int (*)(void*, tcp_pcb*)' to 'tcp_poll_fn {aka signed char (*)(void*, tcp_pcb*)}' [-fpermissive]

     tcp_poll(_pcb, &_s_poll, 1);

                               ^

In file included from C:\Users\Uksa007\Documents\Arduino\libraries\ESPAsyncTCP-master\src\ESPAsyncTCP.cpp:27:0:

C:\Users\Uksa007\AppData\Local\Arduino15\packages\esp8266\hardware\esp8266\2.3.0/tools/sdk/lwip/include/lwip/tcp.h:320:18: error:   initializing argument 2 of 'void tcp_poll(tcp_pcb*, tcp_poll_fn, u8_t)' [-fpermissive]

 void             tcp_poll    (struct tcp_pcb *pcb, tcp_poll_fn poll, u8_t interval)ICACHE_FLASH_ATTR;

                  ^

C:\Users\Uksa007\Documents\Arduino\libraries\ESPAsyncTCP-master\src\ESPAsyncTCP.cpp: In member function 'long int AsyncClient::_connected(void*, long int)':

C:\Users\Uksa007\Documents\Arduino\libraries\ESPAsyncTCP-master\src\ESPAsyncTCP.cpp:290:28: error: invalid conversion from 'long int (*)(void*, tcp_pcb*, pbuf*, long int)' to 'tcp_recv_fn {aka signed char (*)(void*, tcp_pcb*, pbuf*, signed char)}' [-fpermissive]

     tcp_recv(_pcb, &_s_recv);

                            ^

In file included from C:\Users\Uksa007\Documents\Arduino\libraries\ESPAsyncTCP-master\src\ESPAsyncTCP.cpp:27:0:

C:\Users\Uksa007\AppData\Local\Arduino15\packages\esp8266\hardware\esp8266\2.3.0/tools/sdk/lwip/include/lwip/tcp.h:318:18: error:   initializing argument 2 of 'void tcp_recv(tcp_pcb*, tcp_recv_fn)' [-fpermissive]

 void             tcp_recv    (struct tcp_pcb *pcb, tcp_recv_fn recv) ICACHE_FLASH_ATTR;

                  ^

C:\Users\Uksa007\Documents\Arduino\libraries\ESPAsyncTCP-master\src\ESPAsyncTCP.cpp:291:28: error: invalid conversion from 'long int (*)(void*, tcp_pcb*, uint16_t) {aka long int (*)(void*, tcp_pcb*, short unsigned int)}' to 'tcp_sent_fn {aka signed char (*)(void*, tcp_pcb*, short unsigned int)}' [-fpermissive]

     tcp_sent(_pcb, &_s_sent);

                            ^

In file included from C:\Users\Uksa007\Documents\Arduino\libraries\ESPAsyncTCP-master\src\ESPAsyncTCP.cpp:27:0:

C:\Users\Uksa007\AppData\Local\Arduino15\packages\esp8266\hardware\esp8266\2.3.0/tools/sdk/lwip/include/lwip/tcp.h:319:18: error:   initializing argument 2 of 'void tcp_sent(tcp_pcb*, tcp_sent_fn)' [-fpermissive]

 void             tcp_sent    (struct tcp_pcb *pcb, tcp_sent_fn sent)ICACHE_FLASH_ATTR;

                  ^

C:\Users\Uksa007\Documents\Arduino\libraries\ESPAsyncTCP-master\src\ESPAsyncTCP.cpp:292:31: error: invalid conversion from 'long int (*)(void*, tcp_pcb*)' to 'tcp_poll_fn {aka signed char (*)(void*, tcp_pcb*)}' [-fpermissive]

     tcp_poll(_pcb, &_s_poll, 1);

                               ^

In file included from C:\Users\Uksa007\Documents\Arduino\libraries\ESPAsyncTCP-master\src\ESPAsyncTCP.cpp:27:0:

C:\Users\Uksa007\AppData\Local\Arduino15\packages\esp8266\hardware\esp8266\2.3.0/tools/sdk/lwip/include/lwip/tcp.h:320:18: error:   initializing argument 2 of 'void tcp_poll(tcp_pcb*, tcp_poll_fn, u8_t)' [-fpermissive]

 void             tcp_poll    (struct tcp_pcb *pcb, tcp_poll_fn poll, u8_t interval)ICACHE_FLASH_ATTR;

                  ^

C:\Users\Uksa007\Documents\Arduino\libraries\ESPAsyncTCP-master\src\ESPAsyncTCP.cpp: In member function 'void AsyncServer::begin()':

C:\Users\Uksa007\Documents\Arduino\libraries\ESPAsyncTCP-master\src\ESPAsyncTCP.cpp:839:30: error: invalid conversion from 'long int (*)(void*, tcp_pcb*, long int)' to 'tcp_accept_fn {aka signed char (*)(void*, tcp_pcb*, signed char)}' [-fpermissive]

   tcp_accept(_pcb, &_s_accept);

                              ^

In file included from C:\Users\Uksa007\Documents\Arduino\libraries\ESPAsyncTCP-master\src\ESPAsyncTCP.cpp:27:0:

C:\Users\Uksa007\AppData\Local\Arduino15\packages\esp8266\hardware\esp8266\2.3.0/tools/sdk/lwip/include/lwip/tcp.h:317:18: error:   initializing argument 2 of 'void tcp_accept(tcp_pcb*, tcp_accept_fn)' [-fpermissive]

 void             tcp_accept  (struct tcp_pcb *pcb, tcp_accept_fn accept) ICACHE_FLASH_ATTR;

                  ^

exit status 1
Error compiling for board WeMos D1 R2 & mini.

Uksa007, 2017-10-18:
To answer my own question, this issuse was the library,
I have changed the library.json back to commit 9b0cc37 but still had error found I need to implement c2d4c16 to resolve.
Why are they committing PR for 2.4_RC when they don't work with the current production release is beyone me !

pathakhcst, 2017-10-19:
I am facing this issue with NodeMCU and PlatformIO. I am using esp8266_stage.
.piolibdeps\ESPAsyncTCP_ID305\src\ESPAsyncTCP.cpp:839:30: error: invalid conversion from 'int8_t ()(void, tcp_pcb*, int8_t) {
aka signed char ()(void, tcp_pcb*, signed char)}' to 'tcp_accept_fn {aka long int ()(void, tcp_pcb*, long int)}' [-fpermiss
ive]
tcp_accept(pcb, &s_accept);
^
In file included from .piolibdeps\ESPAsyncTCP_ID305\src\ESPAsyncTCP.cpp:27:0:
C:\Users\verizon.platformio\packages\framework-arduinoespressif8266@src-31d658a59f41540201fc3726a1394910\tools\sdk\lwip\include/lwip/tcp.h:317:18: error: initializing argument 2 of 'void tcp_accept(tcp_pcb*, tcp_accept_fn)' [-fpermissive]
void tcp_accept (struct tcp_pcb *pcb, tcp_accept_fn accept) ICACHE_FLASH_ATTR;
^
*** [.pioenvs\nossl\lib\ESPAsyncTCP_ID305\ESPAsyncTCP.o] Error 1

Edzelf, 2017-10-19:
Did you check  https://github.com/me-no-dev/ESPAsyncTCP/issues/60 ?

pathakhcst, 2017-10-19:
I saw it but I don't understand what to do to resolve the issue? I am using platformio ide.

Edzelf, 2017-11-13:
I used [this](https://github.com/me-no-dev/ESPAsyncTCP/commit/c2d4c168d41b78d9abd71a074c80eb8087c33561) to correct it.

Thread 110 (2017-10-30):

Station playback stops every 30 minutes

RonWei, 2017-10-30:
Every 30 minutes the playback of the current radiostation stops/freeze. After a moment the firmware switches to the next radiostation in the programmlist and continue for another 30 minutes of playback. And so on ...

Edzelf, 2017-10-30:
The radio will switch over if the data stream stops for a longer time.  Maybe your internet connection is very busy every 30 minutes.  You may have some clues in the logging on the serial output.

RonWei, 2017-10-30:
Thx for your answer. I think here is the code part that skips the station ever 30 minutes.

 I will investigate my traffic to find out why

RonWei, 2017-10-30:
Thx for your answer. I think this code part skips the station after 30 minutes.
```

      if ( ( morethanonce > 0 ) ||                // Happened more than once?
           ( playlist_num > 0 ) )                 // Or playlist active?
      {
        datamode = STOPREQD ;                     // Stop player
//        ini_block.newpreset++ ;                 // Yes, try next channel

        dbgprint ( "Trying other station/file..." ) ;
      }
      morethanonce++ ;                            // Count the fails
```

I have to investigate my traffic to find out why the datastream stops or i have to rewrite the code to reconnect to the same (not the next) radio station. Should a " hostreq = true ;  " is enough to reconnect?

Best regards

Edzelf, 2017-10-30:
Ron, If any data is received, morethanonce will be reset to 0.  You will see in the logging:
"Recovered from dataloss" and the radio will keep playing the same station.
Normally a reconnect is not the solution, as in most cases the station is not reachable.  That's why the radio will try the next station.  Setting hostreq to true will not reconnect as the host has not changed.
So again, look into the logging to see what's going on.
You will probably see "No data input" several times before the radio gives up.

RonWei, 2017-10-30:
Hello Edzelf, thats right, i checked the log. It seems to be a problem with the radio station i heard. Sometimes no data can be received for a couple of seconds from this station and then your firmware get a "timeout" and switch to the next station.
I modified the code so the radio will continue to play the same channel when new data is received after a few seconds.  In my opinion thats a better option than changing the channel.

Edzelf, 2017-10-30:
In that case, just increase the number 0 in line 962.

Closed 2017-10-30.

Thread 111 (2017-11-15):

VS1053 error retry SB:4X R1:4X R2:4X

Barrois, 2017-11-15:
Hello,
I want to do an cheap web radio with the "Minimal version".
First I want to test with your : SimpleMp3PlayerWithDebug.ino
but the return is   :

N: Playing sound... 0⸮~?⸮4⸮!⸮⸮⸮⸮ _SAA⸮⸮N: Hello VS1053!
N: Reset VS1053...
N: End reset VS1053...
N: Slow SPI,Testing VS1053 read/write registers...
E: VS1053 error retry SB:4X R1:4X R2:4X
E: VS1053 error retry SB:4X R1:4X R2:4X
E: VS1053 error retry SB:4X R1:4X R2:4X
E: VS1053 error retry SB:4X R1:4X R2:4X
E: VS1053 error retry SB:4X R1:4X R2:4X
E: VS1053 error retry SB:4X R1:4X R2:4X
E: VS1053 error retry SB:4X R1:4X R2:4X
E: VS1053 error retry SB:4X R1:4X R2:4X
E: VS1053 error retry SB:4X R1:4X R2:4X
E: VS1053 error retry SB:4X R1:4X R2:4X
E: VS1053 error retry SB:4X R1:4X R2:4X
E: VS1053 error retry SB:4X R1:4X R2:4X
E: VS1053 error retry SB:4X R1:4X R2:4X
E: VS1053 error retry SB:4X R1:4X R2:4X
E: VS1053 error retry SB:4X R1:4X R2:4X
E: VS1053 error retry SB:4X R1:4X R2:4X
E: VS1053 error retry SB:4X R1:4X R2:4X
E: VS1053 error retry SB:4X R1:4X R2:4X
E: VS1053 error retry SB:4X R1:4X R2:4X
E: VS1053 error retry SB:4X R1:4X R2:4X
N: Fast SPI, Testing VS1053 read/write registers again...
E: VS1053 error retry SB:4X R1:4X R2:4X
E: VS1053 error retry SB:4X R1:4X R2:4X
E: VS1053 error retry SB:4X R1:4X R2:4X
E: VS1053 error retry SB:4X R1:4X R2:4X
E: VS1053 error retry SB:4X R1:4X R2:4X
E: VS1053 error retry SB:4X R1:4X R2:4X
E: VS1053 error retry SB:4X R1:4X R2:4X
E: VS1053 error retry SB:4X R1:4X R2:4X
E: VS1053 error retry SB:4X R1:4X R2:4X
E: VS1053 error retry SB:4X R1:4X R2:4X
E: VS1053 error retry SB:4X R1:4X R2:4X
E: VS1053 error retry SB:4X R1:4X R2:4X
E: VS1053 error retry SB:4X R1:4X R2:4X
E: VS1053 error retry SB:4X R1:4X R2:4X
E: VS1053 error retry SB:4X R1:4X R2:4X
E: VS1053 error retry SB:4X R1:4X R2:4X
E: VS1053 error retry SB:4X R1:4X R2:4X
E: VS1053 error retry SB:4X R1:4X R2:4X
E: VS1053 error retry SB:4X R1:4X R2:4X
E: VS1053 error retry SB:4X R1:4X R2:4X
N: endFillByte is 0xFF
N: Playing sound...

can you help me ?

Edzelf, 2017-11-15:
SimpleMp3PlayerWithDebug.ino is not mine....

Barrois, 2017-11-17:
Yes you are right ,  désolé et encore merci.
Have you a small .ino for only a ESP and a VS1053 just to ear some web radio  with 5 botton : + -, stop , radio+, radio - ?
Something little for the "Minimal version"

Edzelf, 2017-11-17:
The current version can do just that, so I do not see the need for a special version.

Barrois, 2017-11-20:
Merci.
but I got a error  on ESPAsyncTCP.cpp
sure is not yourse !

C:\Users\Bernard\Documents\Arduino\libraries\ESPAsyncTCP-master\src\ESPAsyncTCP.cpp: In constructor 'AsyncClient::AsyncClient(tcp_pcb*)':

C:\Users\Bernard\Documents\Arduino\libraries\ESPAsyncTCP-master\src\ESPAsyncTCP.cpp:78:28: error: invalid conversion from 'long int (*)(void*, tcp_pcb*, pbuf*, long int)' to 'tcp_recv_fn {aka signed char (*)(void*, tcp_pcb*, pbuf*, signed char)}' [-fpermissive]

     tcp_recv(_pcb, &_s_recv);

                            ^

In file included from C:\Users\Bernard\Documents\Arduino\libraries\ESPAsyncTCP-master\src\ESPAsyncTCP.cpp:27:0:

C:\Users\Bernard\AppData\Local\Arduino15\packages\esp8266\hardware\esp8266\2.3.0-rc2/tools/sdk/lwip/include/lwip/tcp.h:318:18: error:   initializing argument 2 of 'void tcp_recv(tcp_pcb*, tcp_recv_fn)' [-fpermissive]

 void             tcp_recv    (struct tcp_pcb *pcb, tcp_recv_fn recv) ICACHE_FLASH_ATTR;

                  ^

C:\Users\Bernard\Documents\Arduino\libraries\ESPAsyncTCP-master\src\ESPAsyncTCP.cpp:79:28: error: invalid conversion from 'long int (*)(void*, tcp_pcb*, uint16_t) {aka long int (*)(void*, tcp_pcb*, short unsigned int)}' to 'tcp_sent_fn {aka signed char (*)(void*, tcp_pcb*, short unsigned int)}' [-fpermissive]

     tcp_sent(_pcb, &_s_sent);

                            ^

In file included from C:\Users\Bernard\Documents\Arduino\libraries\ESPAsyncTCP-master\src\ESPAsyncTCP.cpp:27:0:

C:\Users\Bernard\AppData\Local\Arduino15\packages\esp8266\hardware\esp8266\2.3.0-rc2/tools/sdk/lwip/include/lwip/tcp.h:319:18: error:   initializing argument 2 of 'void tcp_sent(tcp_pcb*, tcp_sent_fn)' [-fpermissive]

 void             tcp_sent    (struct tcp_pcb *pcb, tcp_sent_fn sent)ICACHE_FLASH_ATTR;

                  ^

C:\Users\Bernard\Documents\Arduino\libraries\ESPAsyncTCP-master\src\ESPAsyncTCP.cpp:80:28: error: invalid conversion from 'void (*)(void*, long int)' to 'tcp_err_fn {aka void (*)(void*, signed char)}' [-fpermissive]

     tcp_err(_pcb, &_s_error);

                            ^

In file included from C:\Users\Bernard\Documents\Arduino\libraries\ESPAsyncTCP-master\src\ESPAsyncTCP.cpp:27:0:

C:\Users\Bernard\AppData\Local\Arduino15\packages\esp8266\hardware\esp8266\2.3.0-rc2/tools/sdk/lwip/include/lwip/tcp.h:321:18: error:   initializing argument 2 of 'void tcp_err(tcp_pcb*, tcp_err_fn)' [-fpermissive]

 void             tcp_err     (struct tcp_pcb *pcb, tcp_err_fn err)ICACHE_FLASH_ATTR;

                  ^

C:\Users\Bernard\Documents\Arduino\libraries\ESPAsyncTCP-master\src\ESPAsyncTCP.cpp:81:31: error: invalid conversion from 'long int (*)(void*, tcp_pcb*)' to 'tcp_poll_fn {aka signed char (*)(void*, tcp_pcb*)}' [-fpermissive]

     tcp_poll(_pcb, &_s_poll, 1);

                               ^

In file included from C:\Users\Bernard\Documents\Arduino\libraries\ESPAsyncTCP-master\src\ESPAsyncTCP.cpp:27:0:

C:\Users\Bernard\AppData\Local\Arduino15\packages\esp8266\hardware\esp8266\2.3.0-rc2/tools/sdk/lwip/include/lwip/tcp.h:320:18: error:   initializing argument 2 of 'void tcp_poll(tcp_pcb*, tcp_poll_fn, u8_t)' [-fpermissive]

 void             tcp_poll    (struct tcp_pcb *pcb, tcp_poll_fn poll, u8_t interval)ICACHE_FLASH_ATTR;

                  ^

C:\Users\Bernard\Documents\Arduino\libraries\ESPAsyncTCP-master\src\ESPAsyncTCP.cpp: In member function 'bool AsyncClient::connect(IPAddress, uint16_t)':

C:\Users\Bernard\Documents\Arduino\libraries\ESPAsyncTCP-master\src\ESPAsyncTCP.cpp:130:25: error: invalid conversion from 'void (*)(void*, long int)' to 'tcp_err_fn {aka void (*)(void*, signed char)}' [-fpermissive]

   tcp_err(pcb, &_s_error);

                         ^

In file included from C:\Users\Bernard\Documents\Arduino\libraries\ESPAsyncTCP-master\src\ESPAsyncTCP.cpp:27:0:

C:\Users\Bernard\AppData\Local\Arduino15\packages\esp8266\hardware\esp8266\2.3.0-rc2/tools/sdk/lwip/include/lwip/tcp.h:321:18: error:   initializing argument 2 of 'void tcp_err(tcp_pcb*, tcp_err_fn)' [-fpermissive]

 void             tcp_err     (struct tcp_pcb *pcb, tcp_err_fn err)ICACHE_FLASH_ATTR;

                  ^

C:\Users\Bernard\Documents\Arduino\libraries\ESPAsyncTCP-master\src\ESPAsyncTCP.cpp: In member function 'AsyncClient& AsyncClient::operator=(const AsyncClient&)':

C:\Users\Bernard\Documents\Arduino\libraries\ESPAsyncTCP-master\src\ESPAsyncTCP.cpp:168:28: error: invalid conversion from 'long int (*)(void*, tcp_pcb*, pbuf*, long int)' to 'tcp_recv_fn {aka signed char (*)(void*, tcp_pcb*, pbuf*, signed char)}' [-fpermissive]

     tcp_recv(_pcb, &_s_recv);

                            ^

In file included from C:\Users\Bernard\Documents\Arduino\libraries\ESPAsyncTCP-master\src\ESPAsyncTCP.cpp:27:0:

C:\Users\Bernard\AppData\Local\Arduino15\packages\esp8266\hardware\esp8266\2.3.0-rc2/tools/sdk/lwip/include/lwip/tcp.h:318:18: error:   initializing argument 2 of 'void tcp_recv(tcp_pcb*, tcp_recv_fn)' [-fpermissive]

 void             tcp_recv    (struct tcp_pcb *pcb, tcp_recv_fn recv) ICACHE_FLASH_ATTR;

                  ^

C:\Users\Bernard\Documents\Arduino\libraries\ESPAsyncTCP-master\src\ESPAsyncTCP.cpp:169:28: error: invalid conversion from 'long int (*)(void*, tcp_pcb*, uint16_t) {aka long int (*)(void*, tcp_pcb*, short unsigned int)}' to 'tcp_sent_fn {aka signed char (*)(void*, tcp_pcb*, short unsigned int)}' [-fpermissive]

     tcp_sent(_pcb, &_s_sent);

                            ^

In file included from C:\Users\Bernard\Documents\Arduino\libraries\ESPAsyncTCP-master\src\ESPAsyncTCP.cpp:27:0:

C:\Users\Bernard\AppData\Local\Arduino15\packages\esp8266\hardware\esp8266\2.3.0-rc2/tools/sdk/lwip/include/lwip/tcp.h:319:18: error:   initializing argument 2 of 'void tcp_sent(tcp_pcb*, tcp_sent_fn)' [-fpermissive]

 void             tcp_sent    (struct tcp_pcb *pcb, tcp_sent_fn sent)ICACHE_FLASH_ATTR;

                  ^

C:\Users\Bernard\Documents\Arduino\libraries\ESPAsyncTCP-master\src\ESPAsyncTCP.cpp:170:28: error: invalid conversion from 'void (*)(void*, long int)' to 'tcp_err_fn {aka void (*)(void*, signed char)}' [-fpermissive]

     tcp_err(_pcb, &_s_error);

                            ^

In file included from C:\Users\Bernard\Documents\Arduino\libraries\ESPAsyncTCP-master\src\ESPAsyncTCP.cpp:27:0:

C:\Users\Bernard\AppData\Local\Arduino15\packages\esp8266\hardware\esp8266\2.3.0-rc2/tools/sdk/lwip/include/lwip/tcp.h:321:18: error:   initializing argument 2 of 'void tcp_err(tcp_pcb*, tcp_err_fn)' [-fpermissive]

 void             tcp_err     (struct tcp_pcb *pcb, tcp_err_fn err)ICACHE_FLASH_ATTR;

                  ^

C:\Users\Bernard\Documents\Arduino\libraries\ESPAsyncTCP-master\src\ESPAsyncTCP.cpp:171:31: error: invalid conversion from 'long int (*)(void*, tcp_pcb*)' to 'tcp_poll_fn {aka signed char (*)(void*, tcp_pcb*)}' [-fpermissive]

     tcp_poll(_pcb, &_s_poll, 1);

                               ^

In file included from C:\Users\Bernard\Documents\Arduino\libraries\ESPAsyncTCP-master\src\ESPAsyncTCP.cpp:27:0:

C:\Users\Bernard\AppData\Local\Arduino15\packages\esp8266\hardware\esp8266\2.3.0-rc2/tools/sdk/lwip/include/lwip/tcp.h:320:18: error:   initializing argument 2 of 'void tcp_poll(tcp_pcb*, tcp_poll_fn, u8_t)' [-fpermissive]

 void             tcp_poll    (struct tcp_pcb *pcb, tcp_poll_fn poll, u8_t interval)ICACHE_FLASH_ATTR;

                  ^

C:\Users\Bernard\Documents\Arduino\libraries\ESPAsyncTCP-master\src\ESPAsyncTCP.cpp: In member function 'long int AsyncClient::_connected(void*, long int)':

C:\Users\Bernard\Documents\Arduino\libraries\ESPAsyncTCP-master\src\ESPAsyncTCP.cpp:292:28: error: invalid conversion from 'long int (*)(void*, tcp_pcb*, pbuf*, long int)' to 'tcp_recv_fn {aka signed char (*)(void*, tcp_pcb*, pbuf*, signed char)}' [-fpermissive]

     tcp_recv(_pcb, &_s_recv);

                            ^

In file included from C:\Users\Bernard\Documents\Arduino\libraries\ESPAsyncTCP-master\src\ESPAsyncTCP.cpp:27:0:

C:\Users\Bernard\AppData\Local\Arduino15\packages\esp8266\hardware\esp8266\2.3.0-rc2/tools/sdk/lwip/include/lwip/tcp.h:318:18: error:   initializing argument 2 of 'void tcp_recv(tcp_pcb*, tcp_recv_fn)' [-fpermissive]

 void             tcp_recv    (struct tcp_pcb *pcb, tcp_recv_fn recv) ICACHE_FLASH_ATTR;

                  ^

C:\Users\Bernard\Documents\Arduino\libraries\ESPAsyncTCP-master\src\ESPAsyncTCP.cpp:293:28: error: invalid conversion from 'long int (*)(void*, tcp_pcb*, uint16_t) {aka long int (*)(void*, tcp_pcb*, short unsigned int)}' to 'tcp_sent_fn {aka signed char (*)(void*, tcp_pcb*, short unsigned int)}' [-fpermissive]

     tcp_sent(_pcb, &_s_sent);

                            ^

In file included from C:\Users\Bernard\Documents\Arduino\libraries\ESPAsyncTCP-master\src\ESPAsyncTCP.cpp:27:0:

C:\Users\Bernard\AppData\Local\Arduino15\packages\esp8266\hardware\esp8266\2.3.0-rc2/tools/sdk/lwip/include/lwip/tcp.h:319:18: error:   initializing argument 2 of 'void tcp_sent(tcp_pcb*, tcp_sent_fn)' [-fpermissive]

 void             tcp_sent    (struct tcp_pcb *pcb, tcp_sent_fn sent)ICACHE_FLASH_ATTR;

                  ^

C:\Users\Bernard\Documents\Arduino\libraries\ESPAsyncTCP-master\src\ESPAsyncTCP.cpp:294:31: error: invalid conversion from 'long int (*)(void*, tcp_pcb*)' to 'tcp_poll_fn {aka signed char (*)(void*, tcp_pcb*)}' [-fpermissive]

     tcp_poll(_pcb, &_s_poll, 1);

                               ^

In file included from C:\Users\Bernard\Documents\Arduino\libraries\ESPAsyncTCP-master\src\ESPAsyncTCP.cpp:27:0:

C:\Users\Bernard\AppData\Local\Arduino15\packages\esp8266\hardware\esp8266\2.3.0-rc2/tools/sdk/lwip/include/lwip/tcp.h:320:18: error:   initializing argument 2 of 'void tcp_poll(tcp_pcb*, tcp_poll_fn, u8_t)' [-fpermissive]

 void             tcp_poll    (struct tcp_pcb *pcb, tcp_poll_fn poll, u8_t interval)ICACHE_FLASH_ATTR;

                  ^

C:\Users\Bernard\Documents\Arduino\libraries\ESPAsyncTCP-master\src\ESPAsyncTCP.cpp: In member function 'void AsyncServer::begin()':

C:\Users\Bernard\Documents\Arduino\libraries\ESPAsyncTCP-master\src\ESPAsyncTCP.cpp:848:30: error: invalid conversion from 'long int (*)(void*, tcp_pcb*, long int)' to 'tcp_accept_fn {aka signed char (*)(void*, tcp_pcb*, signed char)}' [-fpermissive]

   tcp_accept(_pcb, &_s_accept);

                              ^

In file included from C:\Users\Bernard\Documents\Arduino\libraries\ESPAsyncTCP-master\src\ESPAsyncTCP.cpp:27:0:

C:\Users\Bernard\AppData\Local\Arduino15\packages\esp8266\hardware\esp8266\2.3.0-rc2/tools/sdk/lwip/include/lwip/tcp.h:317:18: error:   initializing argument 2 of 'void tcp_accept(tcp_pcb*, tcp_accept_fn)' [-fpermissive]

 void             tcp_accept  (struct tcp_pcb *pcb, tcp_accept_fn accept) ICACHE_FLASH_ATTR;

                  ^

exit status 1
Erreur de compilation pour la carte WeMos D1 R2 & mini

Edzelf, 2017-11-20:
Solved, see issue 109.

Thread 114 (2017-12-13):

ESP- radio with Nextion display

middelbh, 2017-12-13:
I succeeded to use your program with my Wemos mini d1. Works great!
Now I want to use a Nextion display as a user interface, allowing touch control. Whatever I try, the Nextion will not react..
if I use the program below separately it works, but including it in Esp-radio there is no reaction in my textbox (t0).

#include <SoftwareSerial.h>
#include <Nextion.h>
SoftwareSerial nextion(d3,d4);// Nextion TX to pin d3 and RX to pin d4 of Wemos d1 mini
Nextion myNextion(nextion, 9600);

in Setup:
myNextion.init();
myNextion.setComponentText("t0","4321");//symply to test if info is sent to the display

Hope anyone can help!

Edzelf, 2017-12-13:
Did you remove the references to d3 and d4 in the radio software?
Does SoftwareSerial work in combination with the normal Serial I/O?

middelbh, 2017-12-13:
As far as I know I removed all references to d3 and d4, and normally SoftwareSerial works together with normal serial.. I will do a separate test for this lateron..

middelbh, 2017-12-13:
By the way, what possibilities exist to change your system into a library? That would make programs more clear to debug...

middelbh, 2017-12-13:
@Edzelf, I tested, Serial and SoftwareSerial do work in combination...

Edzelf, 2017-12-13:
I ordered one, so I can test (in a couple of weeks).
I'm not planning to turn the sketch into a library.

Edzelf, 2017-12-13:
Which Nection library are you using?

Edzelf, 2017-12-13:
The description of this library does not mention the ESP8266 as a supported board.

middelbh, 2017-12-13:
Correct, but I used it in several other test situations without problems... just check the right GPIO’s and it works. What I will try tomorrow is attach another arduino to the serial ports that go to my nextion and see if teh softwareserial works...

Edzelf, 2017-12-13:
Good idea.

middelbh, 2017-12-14:
Tested, but looks like softwareserial does not work in Esp-radio. I will try to find the cause..

middelbh, 2017-12-18:
Got it working now, I will have to cleanup my sketch, I will then show what has to be done to the program to get it working.
Grtz, Hans

middelbh, 2017-12-27:
in the initialisation of the program I added:
int d1=5;
int d2=4;
int d3=0;
int d4=2;
int d5=14;
int d6=12;
int d7=13;
int d8=15;
and
#include <SoftwareSerial.h>
#include <Nextion.h>
SoftwareSerial displayPort = SoftwareSerial(d4,d3);// Nextion RX to pin d3 and TX to pin d4 of 	Arduino
Nextion myNextion(displayPort, 9600);

Change Pins for VS1053 module: as my wemos d1 with battery does not have a d0 but a d8
#define VS1053_DCS    d8

Delete:
#define TFT_CS 15
#define TFT_DC 2
and
#define BUTTON1 2
#define BUTTON2 0
#define BUTTON3 15

In TIMER100  remove all regarding BUTTON1, BUTTON2 and BUTTON3

In SHOWSTREAMTITLE comment out:
  if ( ( p1 = strstr ( streamtitle, " - " ) ) ) // look for artist/title separator
  {

    *p1++ = '  ' ; // Found: replace 3 characters by newline

    p2 = p1 + 2 ;
    if ( *p2 == ' ' )                           // Leading space in title?
    {
      p2++ ;
    }
    strcpy ( p1, p2 ) ;                         // Shift 2nd part of title 2 or 3 places
  }

  displayinfo ( streamtitle, 20, 40, CYAN ) ;   // Show title at position 20

And replace by:

  myNextion.setComponentText("g0",streamtitle);  //I've a scrolling text on g0 in Nextion
  myNextion.setComponentText("t0",String(vs1053player.getVolume()));//I've a text at t0
  myNextion.setComponentValue("z0",vs1053player.getVolume());  //I've a dial at z0

In SETUP :

add in the beginning:

displayPort.begin(9600);
myNextion.init();
myNextion.setComponentText("g0","Radio started");

change system_update_cpu_freq ( 160 ) ;
to
system_update_cpu_freq ( 80 ) ;

and delete the lines:

pinMode ( BUTTON2, INPUT_PULLUP ) ;
pinMode ( BUTTON1, INPUT_PULLUP ) ; // Input for control button 1
pinMode ( BUTTON3, INPUT_PULLUP ) ;// Input for control button 3

manddar, 2018-05-15:
Hi @middelbh ,

I recently set up ESP Radio without display, but I have one Nextion display in storage. Is it possible for you to upload ino file and describe changes made in pin connections?

TIA - Mandar

Thread 115 (2018-01-08):

Web Interface Issues in AP mode

jgrulich, 2018-01-08:
I've found several issues when there is no correct WiFi setting and it switches into AP mode.
1) The web server doesn't work at all in secure AP mode, need to be used only open mode.
2) The radio.ini file is limited to 30 lines only, otherwise it is note saved and is cleared and the serial reports the following and freezes:

_D: /radio.ini saved

Exception (28):
epc1=0x4000bf0e epc2=0x00000000 epc3=0x00000000 excvaddr=0x00000000 depc=0x00000000

ctx: sys
sp: 3ffffc20 end: 3fffffb0 offset: 01a0

>>>stack>>>
3ffffdc0:  00000001 3fff989c 3ffffdf0 3ffec608
3ffffdd0:  00000001 3fff989c 3ffffe08 40215b4a
3ffffde0:  00000001 3fff989c 3fff98d0 4020dc43
3ffffdf0:  00000000 00000000 00000000 00000000
3ffffe00:  00000000 00000000 3fffb3fc 0000067f
3ffffe10:  00000675 3fffa0f4 0000000f 00000007
3ffffe20:  3fff40e4 3fff9774 3fff9774 00000030
3ffffe30:  3ffec839 3ffec83a 3fff989c 4020e4d7
3ffffe40:  00000000 00000006 3fffacfc 4023a1e0
3ffffe50:  3fffa29c 00000000 3fff9b54 401074e4
3ffffe60:  3fff9774 3fff9778 00000006 00000001
3ffffe70:  00000000 b1190000 3fff9774 3fff9d88
3ffffe80:  00000001 3fff40e4 3fff9d34 4020e5a9
3ffffe90:  00000001 3fff40e4 3fff9d34 4020c1ac
3ffffea0:  3fff9774 00000b68 3fff9774 40237b76
3ffffeb0:  3fff3104 3fff3110 00000006 3fff2f18
3ffffec0:  3fff9774 3fff2f20 3fff2f1c 4020c1ff
3ffffed0:  3fff9774 3fff2f20 3fff2f1c 4023b9fc
3ffffee0:  00000232 0104a8c0 00000018 00000232
3ffffef0:  00000018 00000000 000000fc 402363f1
3fffff00:  40220000 00000000 00000064 3fff3108
3fffff10:  3ffec5e0 3fff3110 3fff40e4 40239ef9
3fffff20:  3fff2e14 3fffa29c 3fffa29c 4021e8d2
3fffff30:  4021edc6 3ffef130 3ffec5c0 3fffa29c
3fffff40:  3ffec5d2 00000000 3fff40e4 402392f5
3fffff50:  0204a8c0 00000001 4010510a 3ffef868
3fffff60:  3ffeee10 40101ab1 00000000 00000005
3fffff70:  00000002 40101843 00000002 00000000
3fffff80:  4010187e 00000002 00000000 3fff3a74
3fffff90:  3fffdc90 00000000 3fff40e4 4022ddaf
3fffffa0:  40000f49 3fffdab0 3fffdab0 40000f49
<<<stack<<<

 ets Jan  8 2013,rst cause:2, boot mode:(3,6)_

3) The reset command reports this and freezes:

_D: Command: reset (without parameter)

 ets Jan  8 2013,rst cause:2, boot mode:(1,6)

 ets Jan  8 2013,rst cause:4, boot mode:(1,6)

wdt reset_

I've tested on several EPS modules with the same result.
I'm using Arduino 1.8.5. , ESP8266 v. 2.3.0, the rest libs are the latest version.
May someone double check this?

Edzelf, 2018-01-09:
See issue #59

jgrulich, 2018-01-09:
The issue #59 is related to the CLI mode when the MP3 is played.
But I'm reporting issues which happens in AP mode, when the MP3 is not played. But seems to me that in this AP mode, even more when the secure AP is used, there is no more resources left for the web, even when only one connection is open.

jgrulich, 2018-01-09:
Basically, this is following of the issue #74 with additional not working points.
I know that there is ESP-32 version, but it's too expensive.
I like this ESP8266 based version, which is simple and looks reasonably and therefor like to bring it working.

Thread 120 (2018-01-17):

Esp reset

mat3511, 2018-01-17:
I have this problem:
D: Starting ESP Version Wed, 31 May 2017 12:35:00 GMT...  Free memory 10504
D: Sketch size 387840, free size 659456
D: Reset VS1053...
D: End reset VS1053...
D: Slow SPI,Testing VS1053 read/write registers...
D: Fast SPI, Testing VS1053 read/write registers again...
D: endFillByte is 0
D: Selected network: ZTE-6ZKV3X       
D: Try WiFi ZTE-6ZKV3X
D: IP = 192.168.1.12
D: Start server for commands

 ets Jan  8 2013,rst cause:4, boot mode:(3,7)

wdt reset
load 0x4010f000, len 1384, room 16
tail 8
chksum 0x2d
csum 0x2d
v4ceabea9
~ld

Does anyone know what can cause it?

Edzelf, 2018-01-17:
Is your power supply strong enough?

ajitam, 2018-02-15:
@mat3511 do you by any chance running macOS High Sierra?
A have the same problem.
But when I upload on my notebook (macOS Sierra) everything works.

I know it's a long shot but still... I'll do some further analysis and post here

ajitam, 2018-02-16:
0K, here is what I found out so far.

What I did:

* a check what was the difference between computer (alts call it *HS*) on which I get a restart (macOS **High** Sierra) and computer (lets call it *S*) I can (macOS Sierra)

* od computer *S* I had board version `2.3.0` so I downgraded version on computer *HS* ☛ uploading error

* I then searched solution for uploading error on High Sierra and I found out that there could be a FTDI driver problem ☛ [https://github.com/esp8266/Arduino/issues/3711](Issue)

* I updated the [http://www.ftdichip.com/Drivers/VCP.htm](driver), restart ESP, restart Arduino IDE ,
 reuploaded `data.ini`, recompile and reupload sketch ☛ it worked!

Few more things:
* uploading `data.ini` with old drivers took about 5min, whit new driver - few seconds
* ESP always crashed after line `D: Start server for commands`. I'm guessing this is the point where MQTT connection is made.
* I will try to go back to `2.4.0` and see if problem comes back

I have no idea if this is OS / board version / FTDI driver or combination of any of those.

Edzelf, 2018-02-16:
Try to use a powersupply that can deliver at least 1 ampere.

ajitam, 2018-02-16:
I don't think that the power supply is the issue here. I'm running on the same setup for a few months with now problems. Problems started to emerge when I switch env/configuration

mat3511, 2018-02-16:
Hello, I am runnig win 10, but I slolved this problem by putting comment symbols in this part of code:
 **if ( NetworkFound )                                  // OTA and MQTT only if Wifi network found
  {
    ArduinoOTA.setHostname ( NAME ) ;                  // Set the hostname
    ArduinoOTA.onStart ( otastart ) ;
    ArduinoOTA.begin() ;                               // Allow update over the air
    if ( ini_block.mqttbroker.length() )               // Broker specified?
    {
      // Initialize the MQTT client
      WiFi.hostByName ( ini_block.mqttbroker.c_str(),
                        mqtt_server_IP ) ;             // Lookup IP of MQTT server
      mqttclient.onConnect ( onMqttConnect ) ;
      mqttclient.onDisconnect ( onMqttDisconnect ) ;
      mqttclient.onSubscribe ( onMqttSubscribe ) ;
      mqttclient.onUnsubscribe ( onMqttUnsubscribe ) ;
      mqttclient.onMessage ( onMqttMessage ) ;
      mqttclient.onPublish ( onMqttPublish ) ;
      mqttclient.setServer ( mqtt_server_IP,           // Specify the broker
                             ini_block.mqttport ) ;    // And the port
      mqttclient.setCredentials ( ini_block.mqttuser.c_str(),
                                  ini_block.mqttpasswd.c_str() ) ;
      mqttclient.setClientId ( NAME ) ;
      dbgprint ( "Connecting to MQTT %s, port %d, user %s, password %s...",
                 ini_block.mqttbroker.c_str(),
                 ini_block.mqttport,
                 ini_block.mqttuser.c_str(),
                 ini_block.mqttpasswd.c_str() ) ;
      mqttclient.connect();
    }
  }
  else
  {
    currentpreset = ini_block.newpreset ;              // No network: do not start radio
  }**
It worked, I am not using OTA or MQTT anyway

Ps: I also did change my pover supply, becouse the old one wasn't strong enough.

ajitam, 2018-02-16:
Hmm ok I guess this problem is all over the place :) Should we just close this issue for now?

mat3511, 2018-02-16:
Yes, we should. :)

Edzelf, 2018-02-16:
The latest version of the library (rc2) has a working OTA.

nixnuex, 2018-03-03:
Had the same issue with Arduino 1.8.5 on macOS High Sierra with Arduino ESP board version 2.4.0 and a china ESP8266 NodeMCU v3 with CH340G chip.

The solution was to downgrade the Arduino ESP board version to 2.3.0

Thread 122 (2018-01-26):

adding oled vu meters

perlix, 2018-01-26:
Just built this radio and it works flawlessly! As a finishing touch, I would like to add two small oled displays for emulating analog vu meters. I'm already using a second (serial connected) Esp for driving the TFT display, so there's enough free pins for the (I2C) oleds.

I have a working sketch for the vu meters, and know how to wire an external audio signal with a voltage divider for DC bias. However, applying this wiring for reading the VS1053's output would require its audio GND to be connected to the common Esp/VS1053 GND. Something tells me that this is not a good idea (and might even cause damage). Any suggestions?

Edzelf, 2018-01-26:
You may use some 600:600 ohm transformers.  They are cheap on Aliexpress.

perlix, 2018-01-28:
Thanks, that looks like exactly what I need.

Thread 124 (2018-01-31):

A Status LED would be nice

Primus007, 2018-01-31:
Support for a status led would be nice. A blink code shows problems. like fast blinking = no connection to the wlan. slow blinking = no connection to the radio station(s) .... #

Edzelf, 2018-01-31:
You may try to connect a LED (with a 1k resistor in series) from +5 Volt to the DREQ pin.  That will give some info.

Primus007, 2018-02-01:
that's not the same but thanks anyway.
Maybe you'll want to make a blinkcode later if you have time :)

I would like to thank you at this point for your good work! Esp-radio is great and easy to use.

fredericplante, 2018-02-01:
Ain't the TFT supposed to display the status, if you use a TFT, I see no point to use a blinking LED to tel the state.

Thread 126 (2018-02-05):

Some m3u playlist does not work

mischaka, 2018-02-05:
Hello,
Some m3u playlist does not work

works because ends with \ n
www.rockantenne.de/webradio/rockantenne.m3u

does not work because ends with file end
http://www.dradio.de/streaming/dkultur_hq_ogg.m3u

Edzelf, 2018-02-05:
It's not easy to correct this.  It doesn't work on WinAMp either.
Use "st02.dlf.de/dlf/02/104/ogg/stream.ogg" instead.

mischaka, 2018-02-07:
Many Thanks
You're right.
Playlist is built wrong

Thread 128 (2018-02-14):

Other VS1053 Modules possible?

Primus007, 2018-02-14:
The blue VS1053 Module from LC Technology is shown in the hardware parts list. But are other Modules possible and tested? What is with the geetech vs1053 http://www.geeetech.com/wiki/index.php/VS1053_MP3_breakout_board_with_SD_card
??

This board has a CS pin, where to connect this? And where to connect the 8k1 PullUp ?
I am using the minimal version with an Wemos D1 mini.

thank you.

Edzelf, 2018-02-14:
I guess it will work with this board.
There is a CS and a XCS pin on this board.  I think the XCS is for the VS1053 and the CS is for the SD-card.
The 8k2 resistor is a pull-up for the XRST line of the VS12053.  So connect it to the XRESET of the VS1053 and +3.3V or + 5V.

Primus007, 2018-02-16:
thank you. i try this if i receive the board.

Thread 129 (2018-02-24):

Stop playing after command/change

dupcakgmailcom, 2018-02-24:
Hi, it's great project!

It plays well right after reset.
But it will stop when I change something (vol+-, station).

It will continue playing after disconnect and connect RST wire from VS1053. (probably reseting)
I've checked wiring multiple times. I tried to connect VS1053 RST to ESP8266 RST (WemosD1) or to 5V - it doesn't matter.

I'm aware of one change - I had to change following code:
from system_update_cpu_freq ( 160 ) ; to system_update_cpu_freq ( 80 ) ;
If it was set to 160 then tho sound was disruptive. For 80MHz is good.

This is part of debug output:
D: Reset VS1053...
D: End reset VS1053...
D: Slow SPI,Testing VS1053 read/write registers...
D: Fast SPI, Testing VS1053 read/write registers again...
D: endFillByte is 88

Could you advise ?
Thanks

Edzelf, 2018-02-24:
Looks like there is something wrong with the web interface.  Could you try to enter some commands like "upvolume=2" on the serial interface in the IDE?  Use the "Enter" key after each command.
Could you also try a different (stronger) powersupply?

RobertSVK, 2018-02-24:
I appreciate your quick response.

I've tried different stronger powersupply and also command via serial interface - same behaviour :(
I believe it's not related to web GUI.

I don't have "reset circuit". I've just connected V1053 RST to ESP RST or 5V or via 10k resistor to 5V.
Could missing "reset circuit" affect functionality ?
I've read in different thread that it's not really necessary.

Also I've tried my VS1053 board in different project without problems. So I believe my hardware is ok.

Edzelf, 2018-02-24:
The reset circuit is not critical.  Are there unusual lines in the logging when you change the volume?

RobertSVK, 2018-02-24:
I don't think so. It looks normal for me

D: Starting ESP Version Wed, 31 May 2017 12:35:00 GMT...  Free memory 13152
D: Sketch size 348080, free size 700416
D: Reset VS1053...
D: End reset VS1053...
D: Slow SPI,Testing VS1053 read/write registers...
D: Fast SPI, Testing VS1053 read/write registers again...
D: endFillByte is 88
...
D: FileRequest received /index.html
D: Response sent
D: list request from browser
D: FileRequest received /radio.css
D: Response sent
D: FileRequest received /favicon.ico
D: Response sent
**D: Command: upvolume with parameter 2**

> then I need to diconnect/connect VS1053 RST  manually

D: Command: upvolume with parameter 2

> diconnect/connect VS1053 RST

D: Volume is now 34

> same after command via serial - diconnect/connect VS1053 RST

D: Metadata block 64 bytes
D: Streamtitle found, 56 bytes
D: StreamTitle='Urban Jazz Coalition - Better Days Comin'';

Edzelf, 2018-02-24:
I see something strange: The endFillByte is 88.  Normally this would be 00.  Are you sure you chip is a VS1053?.  I know that some modules have a different chip, although it has been sold as a VS1053.  Please check this.

Edzelf, 2018-02-25:
Yes, the software is for VS1053 only.

Thread 131 (2018-03-14):

Esp-radio reveals private WiFi password in access point mode

nixnuex, 2018-03-14:
If the connection to the preset WiFis from the .ini file fails, Esp-radio opens it's own WiFi with name and password default:

https://github.com/Edzelf/Esp-radio/blob/2dbd3945f6b28e967706043dc246acba18ec195a/Esp_radio.ino#L199

https://github.com/Edzelf/Esp-radio/blob/2dbd3945f6b28e967706043dc246acba18ec195a/Esp_radio.ino#L1389

This mechanism allows an external party to log into the AP, go to the configuration page and read out the users private WiFi key.

I consider this as a serious issue as it might open up the users WiFi without him even noticing that this information was accessible (as it happened in my case). I propose to deactivate the AP mode by default or block access to the content of the .ini file if the AP mode password has not been customized by the user.

Edzelf, 2018-03-14:
In the ESP32 version of the radio, the passwords are hidden in the webinterface and the logging.  But even then it it possible to hack the ESP and read the passwords.  A solution might be to encode the password.

fredericplante, 2018-03-19:
But the bottom line question is, do you hide something that is so secret that you want it?  Worst case scenario, you reburn the thing with a diffenrant password, that all... Are you the FBI or the CIA? Do you put your banking info on the ESP8266?

nixnuex, 2018-03-20:
@fredericplante I don't know if that came across, but this is primarily about making my home's (not Esp-radio's) WiFi password accessible through Esp-radio in AP mode after it failed to connect for whatever reason. And yes, I consider this as a security risk, especially if it happens as default and even unnoticed for most users.

@Edzelf Thank you very much for your reply. I like your implementation and first level of defense on the Esp32-radio. And I agree: as long as you get access to the Esp-radio, there is a chance that you can extract all information.

So, is a non-default / user-defined AP mode password the best protection? Along with some information that your home's WiFi password might be visible from the .ini when switching to the AP mode?

Edzelf, 2018-03-20:
I added some comment of changing default network name and password in the documentation.

Thread 132 (2018-03-23):

saving .ini corrupts file

dirkclemens, 2018-03-23:
All,

when saving the ini file, only the first approx. 100 chars will be stored, the rest is lost.
So after reset the sketch can no more read the ini file.

Any idea? I did some debugging, but no results :-(
This is what I did for debugging:

```
...
 // *****************************************************************************
  // For the "save" command, the contents is the value of the next parameter
  if ( argument.startsWith ( "save" ) && ( params > 1 ) )
  {
    dbgprint ( "saving ini-file +++++++++++++++++++++++++++++++++++++++++++" ) ;
    dbgprint ( "counting param: %d", params ) ;

    for(int i=0;i<params;i++){
      dbgprint ( "LOOP  {%d}", i) ;
      p = request->getParam(i);
      dbgprint ( "isPost(): {%d} %s", i, p->isPost() ? "yes":"no" ) ;
      dbgprint ( "isFile(): {%d} %s", i, p->isFile() ? "yes":"no" ) ;
      dbgprint ( "size(): {%d} %d", i, p->size()) ;
      if(p->isFile()){
        dbgprint("_FILE[%s]: %s, size: %u\n", p->name().c_str(), p->value().c_str(), p->size());
      } else if(p->isPost()){
        dbgprint("_POST[%s]: %s\n", p->name().c_str(), p->value().c_str());
      } else {
        dbgprint("_GET[%s]: %s\n", p->name().c_str(), p->value().c_str());
      }
    }
...

```

Edzelf, 2018-03-26:
I know that the SPIFFS is not very reliable.  Sometimes the position of the file on the SPIFFS makes a difference.  The quality of the power supply is also very important.  The ESP32 version of the radio performs much better.

Thread 135 (2018-04-19):

extract of VS1053

DerMega, 2018-04-19:
Hi Edzelf,

I hope my question ist not to cheeky but, is it possible to get an extract of the VS1053 Class and the neccesary code to get Webstreams running on the ESP? :)
U seem to be the only person on the WEB who made this running on ESP and I´m very impressed.
I´m not a bad coder but this is a whole new level for me.
I have a private project for a daylight alarm clock and everithing is perfect with it except the alarm via webstream. I cant get it to work, so I am hoping you could help me. :)

thx Tobi

Edzelf, 2018-04-19:
What do you mean by "extract".  All the sourcecode for the VS1053 class is present in the sketch.  You may use it freely.

DerMega, 2018-04-19:
I had the idea that you possibly have the class and the neccesary adittional sourcecode for streaming in a single file, for testing purposes or so, wich you could provide.
If not its okay.
I already startet to seperate your class from the entire radio code. Its a lot of work and I just thought I could save some time :D
Thanks anyways, especially for sharing your code with us!

Edzelf, 2018-04-19:
I do not have a separate file.  But it should not be so hard to isolate the class.  Maybe you have to remove the dbgwrite calls.

vadpol, 2018-04-23:
Adafruit has made a vs1053 library
https://github.com/adafruit/Adafruit_VS1053_Library/archive/master.zip

DerMega, 2018-04-24:
Thx for the input vadpol. Even though I´m well advanced in extracting the lib from edzelf I´ll look at it.

perlix, 2018-04-24:
Isn't the library at https://github.com/baldram/ESP_VS1053_Library a fork of Ed's library?

There's also a basic radio example for Adafruit's library at https://learn.adafruit.com/adabox004/internet-radio. It can be changed to use the above library with very little effort.

baldram, 2018-08-01:
@perlix Exaclty, this is true. The https://github.com/baldram/ESP_VS1053_Library is fork of @Edzelf Esp-radio which contains only the code needed to drive VS1053 chip. So it's just a driver for this audio device. Probably it's exactly what @DerMega is looking for.
PS: If you like ESP_VS1053_Library, please do not forget to click the "star" ;-)

baldram, 2018-08-03:
One more thing, the https://github.com/baldram/ESP_VS1053_Library already has an Basic Web Radio example like the one from Adafruit mentioned by @perlix . So no need to adopt it, already done. So this is exactly what @fredericplante is looking for.
 https://github.com/baldram/ESP_VS1053_Library/tree/master/examples/WebRadioDemo

Thread 136 (2018-04-26):

wifi key default?

Nurbull, 2018-04-26:
First of all I wanted to thank you with a lot of work done.
I interested the project and decided to repeat it, as I'm new to this case, I ask you to prompt me.
The problem is that after uploading the program, the "Esp-radio" network appeared, but it is locked with a password. tell me please what password is the default or where can I look at the wikifey in the program esp-radio.ino

the start log:
```
D: FS Total 2949250, used 0
D: File /radio.ini not found!
D: * Scan Networks *
D: Number of available networks: 1
D:  1 - KN group                  Signal: -37 dBm Encryption Auto
D: --------------------------------------
D: File /radio.ini not found, use save command to create one!
D: Starting ESP Version Wed, 18 Apr 2018 10:42:00 GMT...  Free memory 13728
D: Sketch size 355024, free size 692224
D: Reset VS1053...
D: End reset VS1053...
D: Slow SPI,Testing VS1053 read/write registers...
D: VS1053 error retry SB:0000 R1:FFFF R2:FFFF
D: VS1053 error retry SB:012C R1:FFFF R2:FFFF
D: VS1053 error retry SB:0258 R1:FFFF R2:FFFF
D: VS1053 error retry SB:0384 R1:FFFF R2:FFFF
D: VS1053 error retry SB:04B0 R1:FFFF R2:FFFF
D: VS1053 error retry SB:05DC R1:FFFF R2:FFFF
D: VS1053 error retry SB:0708 R1:FFFF R2:FFFF
D: VS1053 error retry SB:0834 R1:FFFF R2:FFFF
D: VS1053 error retry SB:0960 R1:FFFF R2:FFFF
D: VS1053 error retry SB:0A8C R1:FFFF R2:FFFF
D: VS1053 error retry SB:0BB8 R1:FFFF R2:FFFF
D: VS1053 error retry SB:0CE4 R1:FFFF R2:FFFF
D: VS1053 error retry SB:0E10 R1:FFFF R2:FFFF
D: VS1053 error retry SB:0F3C R1:FFFF R2:FFFF
D: VS1053 error retry SB:1068 R1:FFFF R2:FFFF
D: VS1053 error retry SB:1194 R1:FFFF R2:FFFF
D: VS1053 error retry SB:12C0 R1:FFFF R2:FFFF
D: VS1053 error retry SB:13EC R1:FFFF R2:FFFF
D: VS1053 error retry SB:1518 R1:FFFF R2:FFFF
D: VS1053 error retry SB:1644 R1:FFFF R2:FFFF
D: Fast SPI, Testing VS1053 read/write registers again...
D: VS1053 error retry SB:0000 R1:FFFF R2:FFFF
D: VS1053 error retry SB:0003 R1:FFFF R2:FFFF
D: VS1053 error retry SB:0006 R1:FFFF R2:FFFF
D: VS1053 error retry SB:0009 R1:FFFF R2:FFFF
D: VS1053 error retry SB:000C R1:FFFF R2:FFFF
D: VS1053 error retry SB:000F R1:FFFF R2:FFFF
D: VS1053 error retry SB:0012 R1:FFFF R2:FFFF
D: VS1053 error retry SB:0015 R1:FFFF R2:FFFF
D: VS1053 error retry SB:0018 R1:FFFF R2:FFFF
D: VS1053 error retry SB:001B R1:FFFF R2:FFFF
D: VS1053 error retry SB:001E R1:FFFF R2:FFFF
D: VS1053 error retry SB:0021 R1:FFFF R2:FFFF
D: VS1053 error retry SB:0024 R1:FFFF R2:FFFF
D: VS1053 error retry SB:0027 R1:FFFF R2:FFFF
D: VS1053 error retry SB:002A R1:FFFF R2:FFFF
D: VS1053 error retry SB:002D R1:FFFF R2:FFFF
D: VS1053 error retry SB:0030 R1:FFFF R2:FFFF
D: VS1053 error retry SB:0033 R1:FFFF R2:FFFF
D: VS1053 error retry SB:0036 R1:FFFF R2:FFFF
D: VS1053 error retry SB:0039 R1:FFFF R2:FFFF
D: endFillByte is FF
D: Selected network: <null>           
D: Try WiFi <null>
D: WiFi Failed!  Trying to setup AP with name Esp-radio and password Esp-radio.
D: IP = 192.168.4.1
D: Start server for commands
```

skakri, 2018-04-26:
> D: WiFi Failed!  Trying to setup AP with name Esp-radio and password Esp-radio.

Nurbull, 2018-04-26:
solved thanks

johnnyrockswell, 2020-03-29:
Hey Guys, how did you solve it? I have the same problem. I entered the wifi credentials to defaultpresets.h but it doesn't connect. thanks for your help!

Thread 140 (2018-07-22):

Can not receive data from streaming radio

srspinho, 2018-07-22:
Hello Ed Smallenburg ! ! !

My name name is Sergio, and I am from Brazil.

I have just built the ESP-Radio and it worked very well. I also followed the suggestion to include the ST7735 (Pinout for TFT lcd with ST7735S controller #95) display, and it worked from the first try.

But, I am trying to listen to a Brazilian classic Rock station (Kiss FM) via the address :

stm50.sateg.com.br:26840

When I put it on the Winamp, I am able to listen to the radio without problems :

Network received: 420745 bytes
Server: Ultravox/2.1 SHOUTcast v2.5.1.724/posix(linux x64)
Content-Type: audio/aacp
Ultravox sync: 756 messages, 0 desyncs
Ultravox Data Message: 0x8003
Ultravox SID/AvgBR/MaxBR: 1/96000/96000
Stream name: Orban Opticodec-PC Encoder
Current title: Hi-Fi Internet Stream

But, when I try to do the same on ESP-Radio, I can not receive data :

D: New preset/file requested (6/0) from
D: New preset/file requested (6/0) from stm50.sateg.com.br:26840
D: Connect to new host stm50.sateg.com.br:26840
D: Connect to stm50.sateg.com.br on port 26840, extension /
D: Connected to server
D: Switch to HEADER
D: Accept-Ranges:none
D: Access-Control-Allow-Origin:*
D: Cache-Control:no-cache,no-store,must-revalidate,max-age=0
D: Connection:close
D: icy-name:Orban Opticodec-PC Encoder
D: icy-genre:Various
D: icy-br:96
D: icy-sr:22050
D: icy-url:http://www.kiissfm.com.br
D: icy-pub:1
D: content-type:audio/aacp
D: udio/aacp seen.
D: icy-metaint:32768
D: X-Clacks-Overhead:GNU Terry Pratchett
D: Switch to DATA, bitrate is 96, metaint is 32768
D: First chunk:
D: FF F9 5C 80 45 A1 E8 21
D: 1B 55 25 B9 86 42 81 20
D: E4 30 36 24 09 89 01 61
D: 20 88 4B 70 53 9B 68 CE
D: No data input

have you faced this problem or something similar to this ?

One detail : I can receive data from this service, but from another radios.

Thank you very Much !

Sergio Pinheiro

Edzelf, 2018-07-22:
The station broadcasts an AACP stream, not MP3.  Make sure you have a VS1053 chip installed.  Other decodeder chips will not work with AACP.

srspinho, 2018-07-22:
Hello Ed !
Thank you very much for the fast reply.
Well, my MP3 board has a VS1053B chip on it (please, see the picture attached).

I was reading a pdf from Sparkfun and found the following

**_VS1053b contains AAC technology (ISO/IEC 13818-7 and ISO/IEC 14496-3) which cannot be used
without a proper license from Via Licensing Corporation or individual patent holders.
VS1053b contains spectral band replication (SBR) and parametric stereo (PS) technologies developed by
Coding Technologies. Licensing of SBR is handled within MPEG4 through Via Licensing Corporation.
Licensing of PS is handled with Coding Technologies.
See
http://www.codingtechnologies.com/licensing/aacplus.htm
for more information.
To the best of our knowledge, if the end product does not play a specific format that otherwise would
require a customer license: MPEG 1.0/2.0 layers I and II, WMA, or AAC, the respective license should
not be required. Decoding of MPEG layers I and II are disabled by default, and WMA and AAC format
exclusion can be easily performed based on the contents of the SCI
HDAT1 register.  Also PS and SBR
decoding can be separately disabled._**

as I undestood, the AAC would be available by default. (the link wit details about AAC is not available anymore).

Or, should I enable another register in order to enable it ?

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

Thank You !

Sergio Pinheiro

PS. I am building the ESP-32 version too ! !

Thread 142 (2018-08-15):

VS1053 settings (Volume and Tone) are not saved in the ini file

Lastowne, 2018-08-15:
Hi, first thank you very much for this awesome project.
The Volume and Tone settings  are not saved in the ini file, the ESP don't remeber them.
Thanks!

Edzelf, 2018-08-15:
The Volume and Tone settings are not saved automatically.  In the ESP32 version they will be saved automatically.
You have to use the "save" button in the config page of the webinterface.  In the logging you should see:
```
D: FileRequest received /config.html
D: Response sent
D: Command: getnetworks with parameter 0
D: FileRequest received /radio.ini
D: Response sent
D: /radio.ini saved
```

Thread 143 (2018-08-23):

Using ESp8266+VS1053 as an USB DAC

Arduinoslfan, 2018-08-23:
Great project Edzelf.
This idea came to my mind and didnt found any information about a similar project.
Is it possible to use ESP8266+VS1053 combo as an USB DAC?
I mean we connect esp8266 to pc usb port and get audio through the VS1053 headphone out.
Do you think its possible?
Thank you

Edzelf, 2018-08-23:
I guess so, but the PC is also capable to generate analog audio.

Arduinoslfan, 2018-08-31:
@Edzelf Thank you. you are right PC can output analog audio through its inbuilt DAC. However its quality is quite average.Any idea how should I proceed ?

@fredericplante you are right. serial port needs to handle 1 million plus baud rate. But esp8266 seems to be capable of that. Sadly my knowledge is quite limited about this area. So needs to do more research. Thank you.

Edzelf, 2018-08-31:
Why using a serial port? In combination with an ESP8266 WiFi is a better option.
In combination with an STM32, the USB port may be the better way.

fredericplante, 2018-08-31:
Oh you mean not using the ESP8266 at all if your connected on the USB.

Le ven. 31 août 2018 à 04:28, Ed Smallenburg <notifications@github.com> a
écrit :

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

Thread 144 (2018-08-24):

WiFI password not working , SAVE option not working

radegast-rado, 2018-08-24:
Hi ED

I have few issues with my build.

1 - Wifi password is not recognized - only works with open WIFI without password.
question is where to put password for my WIFI?
is it inside DATA.INI file
wifi_00 = SSID/PASSWORD
I am not sure if this is correct.

2 - Everytime when I try to SAVE changes on DATA.INI file via webserver - everything stop, also when click on Restart button everything stop working.
how can I restart my radio without uploading sketch again and again?

BTW - brilliant project !!!

Cheers

RAD

Edzelf, 2018-08-24:
1 - this method (wifi_00=ssid/password) is correct.
2 - the SPIFFS filesystem is not very reliable.  You may try to add an extra dummy file of 100 kB or so to the SPIFFS.  The ini-file will be stored in a different part of the SPIFFS.  That will help if you are lucky.  Be sure that your power supply is powerful enough.
The best solution is to switch to the ESP32 version.

radegast-rado, 2018-09-05:
I have noticed that reloading DATA.INI after sketch fixed the issue - unfortunately updating DATA file from webserver cause glitches.
Reset issue only occurs when USB cable is connected to computer - on external power everything run ok.

I am about to change esp8266 to esp32 as suggested.

Thanks ED for all your help.

I will keep you updated about ESP32 build - all the best!

Closed 2018-09-05.

Thread 146 (2018-11-05):

Solution with noise and Class D Amp without two batteries

madias123, 2018-11-05:
Hello,
there is no need using two separate power supplies (batteries) using a Class D amp, I found a working solution on this page (german only, but just scroll to until the circuit "Schaltplan analoges Teil"
http://esp8266-server.de/Internetradio.html
This only works if the amp has a separate "Vref"
Maybe you can update the PDF?

Regards Matthias

Thread 150 (2018-11-24):

How to install the ESP-Radio to ESP32 board?

wieb18, 2018-11-24:
Hello,

I am very very new to Arduino, just few days ago bought new ESP32 and VS1053 boards.

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

Try installing ESP-Radio but never passed Arduino Compiler (although already choosed DUMMYTFT, didn't buy any LCD yet).

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

**The error message:**

```
Arduino: 1.8.7 (Windows 10), Board: "ESP32 Dev Module, Disabled, Default, QIO, 80MHz, 4MB (32Mb), 115200, Info"

In file included from C:\Users\wieb\Documents\Arduino\libraries\SoftwareSerial-master/avr/interrupt.h:38:0,

                 from C:\Users\wieb\Documents\Arduino\libraries\SoftwareSerial-master\SoftwareSerial.cpp:41:

C:\Users\wieb\Documents\Arduino\libraries\SoftwareSerial-master/avr/io.h:635:6: warning: #warning "device type not defined" [-Wcpp]

 #    warning "device type not defined"

      ^

In file included from C:\Users\wieb\Documents\Arduino\libraries\SoftwareSerial-master\SoftwareSerial.cpp:43:0:

C:\Users\wieb\AppData\Local\Arduino15\packages\esp32\hardware\esp32\1.0.0\cores\esp32/Arduino.h:83:0: warning: "sei" redefined

 #define sei()

 ^

In file included from C:\Users\wieb\Documents\Arduino\libraries\SoftwareSerial-master\SoftwareSerial.cpp:41:0:

C:\Users\wieb\Documents\Arduino\libraries\SoftwareSerial-master/avr/interrupt.h:81:0: note: this is the location of the previous definition

 # define sei()  __asm__ __volatile__ ("sei" ::: "memory")

 ^

In file included from C:\Users\wieb\Documents\Arduino\libraries\SoftwareSerial-master\SoftwareSerial.cpp:43:0:

C:\Users\wieb\AppData\Local\Arduino15\packages\esp32\hardware\esp32\1.0.0\cores\esp32/Arduino.h:84:0: warning: "cli" redefined

 #define cli()

 ^

In file included from C:\Users\wieb\Documents\Arduino\libraries\SoftwareSerial-master\SoftwareSerial.cpp:41:0:

C:\Users\wieb\Documents\Arduino\libraries\SoftwareSerial-master/avr/interrupt.h:99:0: note: this is the location of the previous definition

 # define cli()  __asm__ __volatile__ ("cli" ::: "memory")

 ^

In file included from C:\Users\wieb\Documents\Arduino\libraries\SoftwareSerial-master\SoftwareSerial.cpp:43:0:

C:\Users\wieb\AppData\Local\Arduino15\packages\esp32\hardware\esp32\1.0.0\cores\esp32/Arduino.h:106:0: warning: "_BV" redefined

 #define _BV(b) (1UL << (b))

 ^

In file included from C:\Users\wieb\Documents\Arduino\libraries\SoftwareSerial-master/avr/io.h:99:0,

                 from C:\Users\wieb\Documents\Arduino\libraries\SoftwareSerial-master/avr/interrupt.h:38,

                 from C:\Users\wieb\Documents\Arduino\libraries\SoftwareSerial-master\SoftwareSerial.cpp:41:

C:\Users\wieb\Documents\Arduino\libraries\SoftwareSerial-master/avr/sfr_defs.h:208:0: note: this is the location of the previous definition

 #define _BV(bit) (1 << (bit))

 ^

In file included from C:\Users\wieb\AppData\Local\Arduino15\packages\esp32\hardware\esp32\1.0.0\cores\esp32/WString.h:29:0,

                 from C:\Users\wieb\AppData\Local\Arduino15\packages\esp32\hardware\esp32\1.0.0\cores\esp32/Arduino.h:150,

                 from C:\Users\wieb\Documents\Arduino\libraries\SoftwareSerial-master\SoftwareSerial.cpp:43:

C:\Users\wieb\AppData\Local\Arduino15\packages\esp32\hardware\esp32\1.0.0\cores\esp32/pgmspace.h:32:0: warning: "PROGMEM" redefined

 #define PROGMEM

 ^

In file included from C:\Users\wieb\Documents\Arduino\libraries\SoftwareSerial-master\SoftwareSerial.cpp:42:0:

C:\Users\wieb\Documents\Arduino\libraries\SoftwareSerial-master/avr/pgmspace.h:113:0: note: this is the location of the previous definition

 #define PROGMEM __ATTR_PROGMEM__

 ^

In file included from C:\Users\wieb\AppData\Local\Arduino15\packages\esp32\hardware\esp32\1.0.0\cores\esp32/WString.h:29:0,

                 from C:\Users\wieb\AppData\Local\Arduino15\packages\esp32\hardware\esp32\1.0.0\cores\esp32/Arduino.h:150,

                 from C:\Users\wieb\Documents\Arduino\libraries\SoftwareSerial-master\SoftwareSerial.cpp:43:

C:\Users\wieb\AppData\Local\Arduino15\packages\esp32\hardware\esp32\1.0.0\cores\esp32/pgmspace.h:36:0: warning: "PSTR" redefined

 #define PSTR(s)       (s)

 ^

In file included from C:\Users\wieb\Documents\Arduino\libraries\SoftwareSerial-master\SoftwareSerial.cpp:42:0:

C:\Users\wieb\Documents\Arduino\libraries\SoftwareSerial-master/avr/pgmspace.h:408:0: note: this is the location of the previous definition

 # define PSTR(s) (__extension__({static const char __c[] PROGMEM = (s); &__c[0];}))

 ^

In file included from C:\Users\wieb\AppData\Local\Arduino15\packages\esp32\hardware\esp32\1.0.0\cores\esp32/WString.h:29:0,

                 from C:\Users\wieb\AppData\Local\Arduino15\packages\esp32\hardware\esp32\1.0.0\cores\esp32/Arduino.h:150,

                 from C:\Users\wieb\Documents\Arduino\libraries\SoftwareSerial-master\SoftwareSerial.cpp:43:

C:\Users\wieb\AppData\Local\Arduino15\packages\esp32\hardware\esp32\1.0.0\cores\esp32/pgmspace.h:37:0: warning: "_SFR_BYTE" redefined

 #define _SFR_BYTE(n)  (n)

 ^

In file included from C:\Users\wieb\Documents\Arduino\libraries\SoftwareSerial-master/avr/io.h:99:0,

                 from C:\Users\wieb\Documents\Arduino\libraries\SoftwareSerial-master/avr/interrupt.h:38,

                 from C:\Users\wieb\Documents\Arduino\libraries\SoftwareSerial-master\SoftwareSerial.cpp:41:

C:\Users\wieb\Documents\Arduino\libraries\SoftwareSerial-master/avr/sfr_defs.h:190:0: note: this is the location of the previous definition

 #define _SFR_BYTE(sfr) _MMIO_BYTE(_SFR_ADDR(sfr))

 ^

In file included from C:\Users\wieb\AppData\Local\Arduino15\packages\esp32\hardware\esp32\1.0.0\cores\esp32/WString.h:29:0,

                 from C:\Users\wieb\AppData\Local\Arduino15\packages\esp32\hardware\esp32\1.0.0\cores\esp32/Arduino.h:150,

                 from C:\Users\wieb\Documents\Arduino\libraries\SoftwareSerial-master\SoftwareSerial.cpp:43:

C:\Users\wieb\AppData\Local\Arduino15\packages\esp32\hardware\esp32\1.0.0\cores\esp32/pgmspace.h:39:0: warning: "pgm_read_byte" redefined

 #define pgm_read_byte(addr)   (*(const unsigned char *)(addr))

 ^

In file included from C:\Users\wieb\Documents\Arduino\libraries\SoftwareSerial-master\SoftwareSerial.cpp:42:0:

C:\Users\wieb\Documents\Arduino\libraries\SoftwareSerial-master/avr/pgmspace.h:1055:0: note: this is the location of the previous definition

 #define pgm_read_byte(address_short)    pgm_read_byte_near(address_short)

 ^

In file included from C:\Users\wieb\AppData\Local\Arduino15\packages\esp32\hardware\esp32\1.0.0\cores\esp32/WString.h:29:0,

                 from C:\Users\wieb\AppData\Local\Arduino15\packages\esp32\hardware\esp32\1.0.0\cores\esp32/Arduino.h:150,

                 from C:\Users\wieb\Documents\Arduino\libraries\SoftwareSerial-master\SoftwareSerial.cpp:43:

C:\Users\wieb\AppData\Local\Arduino15\packages\esp32\hardware\esp32\1.0.0\cores\esp32/pgmspace.h:40:0: warning: "pgm_read_word" redefined

 #define pgm_read_word(addr) ({ \

 ^

In file included from C:\Users\wieb\Documents\Arduino\libraries\SoftwareSerial-master\SoftwareSerial.cpp:42:0:

C:\Users\wieb\Documents\Arduino\libraries\SoftwareSerial-master/avr/pgmspace.h:1064:0: note: this is the location of the previous definition

 #define pgm_read_word(address_short)    pgm_read_word_near(address_short)

 ^

In file included from C:\Users\wieb\AppData\Local\Arduino15\packages\esp32\hardware\esp32\1.0.0\cores\esp32/WString.h:29:0,

                 from C:\Users\wieb\AppData\Local\Arduino15\packages\esp32\hardware\esp32\1.0.0\cores\esp32/Arduino.h:150,

                 from C:\Users\wieb\Documents\Arduino\libraries\SoftwareSerial-master\SoftwareSerial.cpp:43:

C:\Users\wieb\AppData\Local\Arduino15\packages\esp32\hardware\esp32\1.0.0\cores\esp32/pgmspace.h:44:0: warning: "pgm_read_dword" redefined

 #define pgm_read_dword(addr) ({ \

 ^

In file included from C:\Users\wieb\Documents\Arduino\libraries\SoftwareSerial-master\SoftwareSerial.cpp:42:0:

C:\Users\wieb\Documents\Arduino\libraries\SoftwareSerial-master/avr/pgmspace.h:1073:0: note: this is the location of the previous definition

 #define pgm_read_dword(address_short)   pgm_read_dword_near(address_short)

 ^

In file included from C:\Users\wieb\AppData\Local\Arduino15\packages\esp32\hardware\esp32\1.0.0\cores\esp32/WString.h:29:0,

                 from C:\Users\wieb\AppData\Local\Arduino15\packages\esp32\hardware\esp32\1.0.0\cores\esp32/Arduino.h:150,

                 from C:\Users\wieb\Documents\Arduino\libraries\SoftwareSerial-master\SoftwareSerial.cpp:43:

C:\Users\wieb\AppData\Local\Arduino15\packages\esp32\hardware\esp32\1.0.0\cores\esp32/pgmspace.h:48:0: warning: "pgm_read_float" redefined

 #define pgm_read_float(addr) ({ \

 ^

In file included from C:\Users\wieb\Documents\Arduino\libraries\SoftwareSerial-master\SoftwareSerial.cpp:42:0:

C:\Users\wieb\Documents\Arduino\libraries\SoftwareSerial-master/avr/pgmspace.h:1082:0: note: this is the location of the previous definition

 #define pgm_read_float(address_short)   pgm_read_float_near(address_short)

 ^

In file included from C:\Users\wieb\AppData\Local\Arduino15\packages\esp32\hardware\esp32\1.0.0\cores\esp32/WString.h:29:0,

                 from C:\Users\wieb\AppData\Local\Arduino15\packages\esp32\hardware\esp32\1.0.0\cores\esp32/Arduino.h:150,

                 from C:\Users\wieb\Documents\Arduino\libraries\SoftwareSerial-master\SoftwareSerial.cpp:43:

C:\Users\wieb\AppData\Local\Arduino15\packages\esp32\hardware\esp32\1.0.0\cores\esp32/pgmspace.h:52:0: warning: "pgm_read_ptr" redefined

 #define pgm_read_ptr(addr) ({ \

 ^

In file included from C:\Users\wieb\Documents\Arduino\libraries\SoftwareSerial-master\SoftwareSerial.cpp:42:0:

C:\Users\wieb\Documents\Arduino\libraries\SoftwareSerial-master/avr/pgmspace.h:1091:0: note: this is the location of the previous definition

 #define pgm_read_ptr(address_short)     pgm_read_ptr_near(address_short)

 ^

In file included from C:\Users\wieb\AppData\Local\Arduino15\packages\esp32\hardware\esp32\1.0.0\cores\esp32/WString.h:29:0,

                 from C:\Users\wieb\AppData\Local\Arduino15\packages\esp32\hardware\esp32\1.0.0\cores\esp32/Arduino.h:150,

                 from C:\Users\wieb\Documents\Arduino\libraries\SoftwareSerial-master\SoftwareSerial.cpp:43:

C:\Users\wieb\AppData\Local\Arduino15\packages\esp32\hardware\esp32\1.0.0\cores\esp32/pgmspace.h:57:0: warning: "pgm_read_byte_near" redefined

 #define pgm_read_byte_near(addr)  pgm_read_byte(addr)

 ^

In file included from C:\Users\wieb\Documents\Arduino\libraries\SoftwareSerial-master\SoftwareSerial.cpp:42:0:

C:\Users\wieb\Documents\Arduino\libraries\SoftwareSerial-master/avr/pgmspace.h:645:0: note: this is the location of the previous definition

 #define pgm_read_byte_near(address_short) __LPM((uint16_t)(address_short))

 ^

In file included from C:\Users\wieb\AppData\Local\Arduino15\packages\esp32\hardware\esp32\1.0.0\cores\esp32/WString.h:29:0,

                 from C:\Users\wieb\AppData\Local\Arduino15\packages\esp32\hardware\esp32\1.0.0\cores\esp32/Arduino.h:150,

                 from C:\Users\wieb\Documents\Arduino\libraries\SoftwareSerial-master\SoftwareSerial.cpp:43:

C:\Users\wieb\AppData\Local\Arduino15\packages\esp32\hardware\esp32\1.0.0\cores\esp32/pgmspace.h:58:0: warning: "pgm_read_word_near" redefined

 #define pgm_read_word_near(addr)  pgm_read_word(addr)

 ^

In file included from C:\Users\wieb\Documents\Arduino\libraries\SoftwareSerial-master\SoftwareSerial.cpp:42:0:

C:\Users\wieb\Documents\Arduino\libraries\SoftwareSerial-master/avr/pgmspace.h:653:0: note: this is the location of the previous definition

 #define pgm_read_word_near(address_short) __LPM_word((uint16_t)(address_short))

 ^

In file included from C:\Users\wieb\AppData\Local\Arduino15\packages\esp32\hardware\esp32\1.0.0\cores\esp32/WString.h:29:0,

                 from C:\Users\wieb\AppData\Local\Arduino15\packages\esp32\hardware\esp32\1.0.0\cores\esp32/Arduino.h:150,

                 from C:\Users\wieb\Documents\Arduino\libraries\SoftwareSerial-master\SoftwareSerial.cpp:43:

C:\Users\wieb\AppData\Local\Arduino15\packages\esp32\hardware\esp32\1.0.0\cores\esp32/pgmspace.h:59:0: warning: "pgm_read_dword_near" redefined

 #define pgm_read_dword_near(addr) pgm_read_dword(addr)

 ^

In file included from C:\Users\wieb\Documents\Arduino\libraries\SoftwareSerial-master\SoftwareSerial.cpp:42:0:

C:\Users\wieb\Documents\Arduino\libraries\SoftwareSerial-master/avr/pgmspace.h:661:0: note: this is the location of the previous definition

 #define pgm_read_dword_near(address_short) \

 ^

In file included from C:\Users\wieb\AppData\Local\Arduino15\packages\esp32\hardware\esp32\1.0.0\cores\esp32/WString.h:29:0,

                 from C:\Users\wieb\AppData\Local\Arduino15\packages\esp32\hardware\esp32\1.0.0\cores\esp32/Arduino.h:150,

                 from C:\Users\wieb\Documents\Arduino\libraries\SoftwareSerial-master\SoftwareSerial.cpp:43:

C:\Users\wieb\AppData\Local\Arduino15\packages\esp32\hardware\esp32\1.0.0\cores\esp32/pgmspace.h:60:0: warning: "pgm_read_float_near" redefined

 #define pgm_read_float_near(addr) pgm_read_float(addr)

 ^

In file included from C:\Users\wieb\Documents\Arduino\libraries\SoftwareSerial-master\SoftwareSerial.cpp:42:0:

C:\Users\wieb\Documents\Arduino\libraries\SoftwareSerial-master/avr/pgmspace.h:670:0: note: this is the location of the previous definition

 #define pgm_read_float_near(address_short) \

 ^

In file included from C:\Users\wieb\AppData\Local\Arduino15\packages\esp32\hardware\esp32\1.0.0\cores\esp32/WString.h:29:0,

                 from C:\Users\wieb\AppData\Local\Arduino15\packages\esp32\hardware\esp32\1.0.0\cores\esp32/Arduino.h:150,

                 from C:\Users\wieb\Documents\Arduino\libraries\SoftwareSerial-master\SoftwareSerial.cpp:43:

C:\Users\wieb\AppData\Local\Arduino15\packages\esp32\hardware\esp32\1.0.0\cores\esp32/pgmspace.h:61:0: warning: "pgm_read_ptr_near" redefined

 #define pgm_read_ptr_near(addr)   pgm_read_ptr(addr)

 ^

In file included from C:\Users\wieb\Documents\Arduino\libraries\SoftwareSerial-master\SoftwareSerial.cpp:42:0:

C:\Users\wieb\Documents\Arduino\libraries\SoftwareSerial-master/avr/pgmspace.h:679:0: note: this is the location of the previous definition

 #define pgm_read_ptr_near(address_short) \

 ^

C:\Users\wieb\Documents\Arduino\libraries\SoftwareSerial-master\SoftwareSerial.cpp:260:2: error: #error This version of SoftwareSerial supports only 20, 16 and 8MHz processors

 #error This version of SoftwareSerial supports only 20, 16 and 8MHz processors

  ^

In file included from C:\Users\wieb\Documents\Arduino\libraries\SoftwareSerial-master\SoftwareSerial.cpp:42:0:

C:\Users\wieb\Documents\Arduino\libraries\SoftwareSerial-master/avr/pgmspace.h:1529:25: warning: 'strlen_PF' initialized and declared 'extern'

 extern size_t strlen_PF(uint_farptr_t src) __ATTR_CONST__; /* program memory can't change */

                         ^

C:\Users\wieb\Documents\Arduino\libraries\SoftwareSerial-master/avr/pgmspace.h:1529:25: error: 'uint_farptr_t' was not declared in this scope

C:\Users\wieb\Documents\Arduino\libraries\SoftwareSerial-master/avr/pgmspace.h:94:49: warning: attributes after parenthesized initializer ignored [-Wattributes]

 #define __ATTR_CONST__ __attribute__((__const__))

                                                 ^

C:\Users\wieb\Documents\Arduino\libraries\SoftwareSerial-master/avr/pgmspace.h:1529:44: note: in expansion of macro '__ATTR_CONST__'

 extern size_t strlen_PF(uint_farptr_t src) __ATTR_CONST__; /* program memory can't change */

                                            ^

C:\Users\wieb\Documents\Arduino\libraries\SoftwareSerial-master/avr/pgmspace.h:1545:26: warning: 'strnlen_PF' initialized and declared 'extern'

 extern size_t strnlen_PF(uint_farptr_t src, size_t len) __ATTR_CONST__; /* program memory can't change */

                          ^

C:\Users\wieb\Documents\Arduino\libraries\SoftwareSerial-master/avr/pgmspace.h:1545:26: error: 'uint_farptr_t' was not declared in this scope

C:\Users\wieb\Documents\Arduino\libraries\SoftwareSerial-master/avr/pgmspace.h:1545:52: error: expected primary-expression before 'len'

 extern size_t strnlen_PF(uint_farptr_t src, size_t len) __ATTR_CONST__; /* program memory can't change */

                                                    ^

C:\Users\wieb\Documents\Arduino\libraries\SoftwareSerial-master/avr/pgmspace.h:94:49: warning: attributes after parenthesized initializer ignored [-Wattributes]

 #define __ATTR_CONST__ __attribute__((__const__))

                                                 ^

C:\Users\wieb\Documents\Arduino\libraries\SoftwareSerial-master/avr/pgmspace.h:1545:57: note: in expansion of macro '__ATTR_CONST__'

 extern size_t strnlen_PF(uint_farptr_t src, size_t len) __ATTR_CONST__; /* program memory can't change */

                                                         ^

C:\Users\wieb\Documents\Arduino\libraries\SoftwareSerial-master/avr/pgmspace.h:94:49: error: expression list treated as compound expression in initializer [-fpermissive]

 #define __ATTR_CONST__ __attribute__((__const__))

                                                 ^

C:\Users\wieb\Documents\Arduino\libraries\SoftwareSerial-master/avr/pgmspace.h:1545:57: note: in expansion of macro '__ATTR_CONST__'

 extern size_t strnlen_PF(uint_farptr_t src, size_t len) __ATTR_CONST__; /* program memory can't change */

                                                         ^

C:\Users\wieb\Documents\Arduino\libraries\SoftwareSerial-master/avr/pgmspace.h:1560:36: error: 'uint_farptr_t' has not been declared

 extern void *memcpy_PF(void *dest, uint_farptr_t src, size_t len);

                                    ^

C:\Users\wieb\Documents\Arduino\libraries\SoftwareSerial-master/avr/pgmspace.h:1575:36: error: 'uint_farptr_t' has not been declared

 extern char *strcpy_PF(char *dest, uint_farptr_t src);

                                    ^

C:\Users\wieb\Documents\Arduino\libraries\SoftwareSerial-master/avr/pgmspace.h:1595:37: error: 'uint_farptr_t' has not been declared

 extern char *strncpy_PF(char *dest, uint_farptr_t src, size_t len);

                                     ^

C:\Users\wieb\Documents\Arduino\libraries\SoftwareSerial-master/avr/pgmspace.h:1611:36: error: 'uint_farptr_t' has not been declared

 extern char *strcat_PF(char *dest, uint_farptr_t src);

                                    ^

C:\Users\wieb\Documents\Arduino\libraries\SoftwareSerial-master/avr/pgmspace.h:1632:37: error: 'uint_farptr_t' has not been declared

 extern size_t strlcat_PF(char *dst, uint_farptr_t src, size_t siz);

                                     ^

C:\Users\wieb\Documents\Arduino\libraries\SoftwareSerial-master/avr/pgmspace.h:1649:37: error: 'uint_farptr_t' has not been declared

 extern char *strncat_PF(char *dest, uint_farptr_t src, size_t len);

                                     ^

C:\Users\wieb\Documents\Arduino\libraries\SoftwareSerial-master/avr/pgmspace.h:1665:38: error: 'uint_farptr_t' has not been declared

 extern int strcmp_PF(const char *s1, uint_farptr_t s2) __ATTR_PURE__;

                                      ^

C:\Users\wieb\Documents\Arduino\libraries\SoftwareSerial-master/avr/pgmspace.h:1682:39: error: 'uint_farptr_t' has not been declared

 extern int strncmp_PF(const char *s1, uint_farptr_t s2, size_t n) __ATTR_PURE__;

                                       ^

C:\Users\wieb\Documents\Arduino\libraries\SoftwareSerial-master/avr/pgmspace.h:1698:42: error: 'uint_farptr_t' has not been declared

 extern int strcasecmp_PF(const char *s1, uint_farptr_t s2) __ATTR_PURE__;

                                          ^

C:\Users\wieb\Documents\Arduino\libraries\SoftwareSerial-master/avr/pgmspace.h:1716:43: error: 'uint_farptr_t' has not been declared

 extern int strncasecmp_PF(const char *s1, uint_farptr_t s2, size_t n) __ATTR_PURE__;

                                           ^

C:\Users\wieb\Documents\Arduino\libraries\SoftwareSerial-master/avr/pgmspace.h:1732:40: error: 'uint_farptr_t' has not been declared

 extern char *strstr_PF(const char *s1, uint_farptr_t s2);

                                        ^

C:\Users\wieb\Documents\Arduino\libraries\SoftwareSerial-master/avr/pgmspace.h:1744:37: error: 'uint_farptr_t' has not been declared

 extern size_t strlcpy_PF(char *dst, uint_farptr_t src, size_t siz);

                                     ^

C:\Users\wieb\Documents\Arduino\libraries\SoftwareSerial-master/avr/pgmspace.h:1760:36: error: 'uint_farptr_t' has not been declared

 extern int memcmp_PF(const void *, uint_farptr_t, size_t) __ATTR_PURE__;

                                    ^

C:\Users\wieb\Documents\Arduino\libraries\SoftwareSerial-master\SoftwareSerial.cpp: In member function 'void SoftwareSerial::setTX(uint8_t)':

C:\Users\wieb\Documents\Arduino\libraries\SoftwareSerial-master\SoftwareSerial.cpp:493:25: error: cannot convert 'volatile uint32_t* {aka volatile unsigned int*}' to 'volatile uint8_t* {aka volatile unsigned char*}' in assignment

   _transmitPortRegister = portOutputRegister(port);

                         ^

C:\Users\wieb\Documents\Arduino\libraries\SoftwareSerial-master\SoftwareSerial.cpp: In member function 'void SoftwareSerial::setRX(uint8_t)':

C:\Users\wieb\Documents\Arduino\libraries\SoftwareSerial-master\SoftwareSerial.cpp:504:24: error: cannot convert 'volatile uint32_t* {aka volatile unsigned int*}' to 'volatile uint8_t* {aka volatile unsigned char*}' in assignment

   _receivePortRegister = portInputRegister(port);

                        ^

C:\Users\wieb\Documents\Arduino\libraries\SoftwareSerial-master\SoftwareSerial.cpp: In member function 'void SoftwareSerial::begin(long int)':

C:\Users\wieb\Documents\Arduino\libraries\SoftwareSerial-master\SoftwareSerial.cpp:515:31: error: 'table' was not declared in this scope

   for (unsigned i=0; i<sizeof(table)/sizeof(table[0]); ++i)

                               ^

C:\Users\wieb\Documents\Arduino\libraries\SoftwareSerial-master\SoftwareSerial.cpp:531:38: error: 'digitalPinToPCICR' was not declared in this scope

     if (digitalPinToPCICR(_receivePin))

                                      ^

In file included from C:\Users\wieb\Documents\Arduino\libraries\SoftwareSerial-master\SoftwareSerial.cpp:43:0:

C:\Users\wieb\Documents\Arduino\libraries\SoftwareSerial-master\SoftwareSerial.cpp:533:78: error: 'digitalPinToPCICRbit' was not declared in this scope

       *digitalPinToPCICR(_receivePin) |= _BV(digitalPinToPCICRbit(_receivePin));

                                                                              ^

C:\Users\wieb\AppData\Local\Arduino15\packages\esp32\hardware\esp32\1.0.0\cores\esp32/Arduino.h:106:25: note: in definition of macro '_BV'

 #define _BV(b) (1UL << (b))

                         ^

C:\Users\wieb\Documents\Arduino\libraries\SoftwareSerial-master\SoftwareSerial.cpp:534:37: error: 'digitalPinToPCMSK' was not declared in this scope

       *digitalPinToPCMSK(_receivePin) |= _BV(digitalPinToPCMSKbit(_receivePin));

                                     ^

In file included from C:\Users\wieb\Documents\Arduino\libraries\SoftwareSerial-master\SoftwareSerial.cpp:43:0:

C:\Users\wieb\Documents\Arduino\libraries\SoftwareSerial-master\SoftwareSerial.cpp:534:78: error: 'digitalPinToPCMSKbit' was not declared in this scope

       *digitalPinToPCMSK(_receivePin) |= _BV(digitalPinToPCMSKbit(_receivePin));

                                                                              ^

C:\Users\wieb\AppData\Local\Arduino15\packages\esp32\hardware\esp32\1.0.0\cores\esp32/Arduino.h:106:25: note: in definition of macro '_BV'

 #define _BV(b) (1UL << (b))

                         ^

C:\Users\wieb\Documents\Arduino\libraries\SoftwareSerial-master\SoftwareSerial.cpp: In member function 'void SoftwareSerial::end()':

C:\Users\wieb\Documents\Arduino\libraries\SoftwareSerial-master\SoftwareSerial.cpp:549:36: error: 'digitalPinToPCMSK' was not declared in this scope

   if (digitalPinToPCMSK(_receivePin))

                                    ^

In file included from C:\Users\wieb\Documents\Arduino\libraries\SoftwareSerial-master\SoftwareSerial.cpp:43:0:

C:\Users\wieb\Documents\Arduino\libraries\SoftwareSerial-master\SoftwareSerial.cpp:550:77: error: 'digitalPinToPCMSKbit' was not declared in this scope

     *digitalPinToPCMSK(_receivePin) &= ~_BV(digitalPinToPCMSKbit(_receivePin));

                                                                             ^

C:\Users\wieb\AppData\Local\Arduino15\packages\esp32\hardware\esp32\1.0.0\cores\esp32/Arduino.h:106:25: note: in definition of macro '_BV'

 #define _BV(b) (1UL << (b))

                         ^

C:\Users\wieb\Documents\Arduino\libraries\SoftwareSerial-master\SoftwareSerial.cpp: In member function 'virtual size_t SoftwareSerial::write(uint8_t)':

C:\Users\wieb\Documents\Arduino\libraries\SoftwareSerial-master\SoftwareSerial.cpp:590:26: error: 'XMIT_START_ADJUSTMENT' was not declared in this scope

   tunedDelay(_tx_delay + XMIT_START_ADJUSTMENT);

                          ^

Multiple libraries were found for "SD.h"
 Used: C:\Users\wieb\AppData\Local\Arduino15\packages\esp32\hardware\esp32\1.0.0\libraries\SD
 Not used: C:\Program Files (x86)\Arduino\libraries\SDx
exit status 1
Error compiling for board ESP32 Dev Module.

This report would have more information with
"Show verbose output during compilation"
option enabled in File -> Preferences.
```

This ESP-Radio using tons of library and I managed fill all the missing library files one by one. But the last compiler error above , I don't know how to solve it.

**How to install the ESP-Radio to my ESP32 board?**

Maybe my question is very dumb because I could see a lot people done installing without any issues. But I am sure there is many people like me who are very very new to Arduino and has the same issue like me.

Any help very appreciated and thanks in advance.

Edzelf, 2018-11-24:
All errors point to softserial.  That is not used in this program.  Remove you softserial library and try to compile a simple example like "blinky" first.

wieb18, 2018-11-25:
Edzelf... thanks a lot for the guidance, finally ESP32-Radio able correctly compiled.

Previous error because of my mistake which include Nextion default display on the first run, then changed to DUMMYTFT on the last minute. That is why the compiler producing error because its still loaded with Nextion Display library which doesn't use anymore.

Maybe anyone experiencing issue like myself, here is the step for installing ESP32-Radio:

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

1. First... choose your display to prevent compiler error. If no display (like myself) then choose DUMMYTFT.

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

2. Load Esp32_radio_init.ino to Arduino IDE

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

3. Change Esp32_radio_init.ino Wifi credential to yours own Wifi network

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

4. Upload Esp32_radio_init.ino to ESP32

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

5. Finally... upload ESP32-Radio.ino to ESP32

**Here is my Serial output:**

```
D: Starting ESP32-radio running on CPU 1 at 240 MHz.  Version Thu, 04 Oct 2018 07:22:32 GMT.  Free memory 233752
D: Display type is DUMMYTFT
D: Partition nvs found, 20480 bytes
D: Read 31 keys from NVS
D: pin_ir set to -1
D: pin_enc_clk set to -1
D: pin_enc_dt set to -1
D: pin_enc_sw set to -1
D: pin_tft_cs set to -1
D: pin_tft_dc set to -1
D: pin_tft_scl set to -1
D: pin_tft_sda set to -1
D: pin_tft_bl set to -1
D: pin_tft_blx set to -1
D: pin_sd_cs set to -1
D: pin_vs_cs set to -1
D: pin_vs_dcs set to -1
D: pin_vs_dreq set to -1
D: pin_shutdown set to -1
D: pin_shutdownx set to -1
D: pin_spi_sck set to 18
D: pin_spi_miso set to 19
D: pin_spi_mosi set to 23
D: GPIO0 is HIGH
D: GPIO2 is HIGH
D: GPIO4 is HIGH
D: GPIO5 is HIGH
D: GPIO12 is HIGH
D: GPIO13 is HIGH
D: GPIO14 is HIGH
D: GPIO15 is HIGH
D: GPIO16 is HIGH
D: GPIO17 is HIGH
D: GPIO18 is HIGH
D: GPIO19 is HIGH
D: GPIO21 is HIGH
D: GPIO22 is HIGH
D: GPIO23 is HIGH
D: GPIO25 is HIGH
D: GPIO26 is HIGH
D: GPIO27 is HIGH
D: GPIO32 is HIGH
D: GPIO33 is HIGH
D: GPIO34 is LOW, probably no PULL-UP
D: GPIO35 is LOW, probably no PULL-UP
D: GPIO39 is LOW, probably no PULL-UP
D: gpio_00 will execute uppreset = 1
D: gpio_12 will execute upvolume = 2
D: gpio_13 will execute downvolume = 2
D: Create list with acceptable WiFi networks
D: Added BRAYCHUA to list of networks
D: Added BRAYCHUA to list of networks
D: End adding networks
D: Scan Networks
D: Scan completed
D: Number of
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

Thread 151 (2018-11-27):

Wemos D1 R1 +JUMPER MOD GEEETECH VS1053B + SOLAR POWERED = 24/7 WEBRADIO (Amp powerup not included)

SurenBono, 2018-11-27:
...recently i managed a OTA sketch upload for some variety of blinking leds on a Wemos D1 R1... but later i wanted more...so i encountered a uno plugable VS1053 & UNO plugable Touch display....but i cant find a similar sketch for it... i tried all the sketches near similar that i can find online  but nothing worked...i can upload the sketches but i can only hear a pulsing sound on my amp....can anybody make a custom sketch for such combination..?...please help
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

SurenBono, 2018-11-28:
...after hundreds of error i only managed to list out my WEBRADIO on the wifi...hehe..but still no sound yet coming out of it...complex codes that i not understand..just copy from others with somewhat similar hardware but different pin config..i think it will be my lifes project to get it working like the other guys..this will be my advance studies in multimedias....

Edzelf, 2018-11-28:
Just publish your debug output.  The answer lies in there.

SurenBono, 2018-11-29:
At first try i had some issues to resolve like additional libraries to install through the debug output
.... the debug output points to nodemcu while my board are of wemos d1...i tried copying the D1/ pins_arduino.h into node mcu folder after backing up the nodemcu/ pins_arduino.h...i could upload the sketch successfully but just blipping sound...do i need the tft to run it..?..or is the radio.ini in the right folder..?
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

SurenBono, 2018-11-29:
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

SurenBono, 2018-11-29:
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

Edzelf, 2018-11-29:
That's not the debug output.  I mean the output to the Serial when you start the radio.  You may compare it with the example debuf output in the last page of the documentation.    It should start like this:
```
D: FS Total 2949250, used 2145297
D: /radio.ini                       -    1780
D: /friendly.mp3                    -  281941
D: /kontiki.mp3                     - 1843200
D: Added SSID 00 = NETGEAR-11 to acceptable networks
D: Added SSID 01 = ADSL-11 to acceptable networks
D: * Scan Networks *
D: Number of available networks: 8
D:  1 - HZN240825082              Signal: -73 dBm Encryption WPA2
D:  2 - Private_FON               Signal: -56 dBm Encryption WPA
D:  3 - FON_Roulet_11             Signal: -56 dBm Encryption None
D:  4 - ADSL-11                   Signal: -86 dBm Encryption Auto  Acceptable
D:  5 - Roulet 9 Gast             Signal: -88 dBm Encryption Auto
D:  6 - Roulet 9                  Signal: -87 dBm Encryption Auto
D:  7 - NETGEAR-11                Signal: -58 dBm Encryption WPA2  Acceptable
D:  8 - TWEED                     Signal: -86 dBm Encryption WPA2
D: --------------------------------------
D: Command: wifi_00 with parameter NETGEAR-11/XXXXXXXX
D: Command: wifi_01 with parameter ADSL-11/YYYYYYY
D: Command: volume with parameter 72
D: Command: toneha with parameter 0
D: Command: tonehf with parameter 0

```

SurenBono, 2018-11-29:
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

SurenBono, 2018-11-29:
...ohh....ok..
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

SurenBono, 2018-11-29:
how do i upload the radio.ini file...?

SurenBono, 2018-11-29:
Trying to connect to the  AP #define NAME //line202 adding a #define PASSWORD .. //line203
WiFi.softAP (  NAME, PASSWORD ) ; //line1407..... the ap shows up a bit later..so i can login and upload the radio.ini through the browser...but it cant register a ip yet

Edzelf, 2018-11-29:
To upload the .ini file: use the "ESP8266 sketch Data Upload" in the IDE.  See page 2 of the document.....

Edzelf, 2018-11-29:
Connect to AP: see page 12 of the document.

SurenBono, 2018-11-29:
finally got the radio.ini file uploaded through a smart phone ....the laptop wifi was skipping connecting to the esp since it was a slow connection...happy that i archieved something today..thanks bro...but got lot more to figure out
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

SurenBono, 2018-11-30:
> Just publish your debug output. The answer lies in there.

SurenBono, 2018-11-30:
> Just publish your debug output. The answer lies in there.

SurenBono, 2018-11-30:
..thats the serial monitor

SurenBono, 2018-11-30:
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

SurenBono, 2018-12-02:
Finally i got it sounding like its suppossed to bro.... i fritz the VS1053B since the x_DCS & X-CS pin is in conflict with the MOSI & MISO on D1....but i got to work on the buffer later for smoother play...its sounds skanky...but better than nothing within my budget....i want to let you know so that you could comment on other guys who is trying the same module
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

SurenBono, 2018-12-02:
check my skanky webradio on WeMos D1 R1 + VS1053--->  https://youtu.be/o-9Ow0_Cs9o

SurenBono, 2018-12-03:
https://youtu.be/jKUjhhCNEgg

..now i got to figure out how to add a 1602 LCD BUTTON SELECTION from the esp32webradio sketch... can u guide me..?

SurenBono, 2018-12-06:
..Working on a ESP32 WeMos D1 R32  but error uploading the blink sketch after installing the Expressif ESP32 platform...while listening to my perfected ESP8266 EDZELF WEBRADIO..not sure if its compatible with xp or is a 64bit board...considering a ESP32 LYRA board where comes with a stereo out ..but cant find sites that sell one..

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

SurenBono, 2018-12-06:
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

SurenBono, 2018-12-06:
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

...I think this is whats goin on there...

SurenBono, 2018-12-07:
...trying to create a new variant for WeMos Wroom esp32 R32  ...seem not working on xp...i need a 64-bit OS for this most probably....
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

SurenBono, 2018-12-11:
...working on a 4-bit 1602 BUTTON LCD to add into the sketch...the pinout is RS=9(D1.8266=0) ,EN=8(D1.8266=2) ,DB4=4(D1.8266=4) ,DB5=5(D1.8266=14),DB6=6(D1.8266=12),DB7=7(D1.8266=13).5-BUTTON=A0...only worked on hd44780....
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

SurenBono, 2018-12-11:
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

SurenBono, 2018-12-13:
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

SurenBono, 2018-12-13:
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

hihiman1, 2019-03-08:
Hi SurenBono,
could you please describe in detail how you modified the sktech to enable the lcd keypad shield?
- which part of the sketch (used for TFT display) is changed into comment
- where do have add the values for A0 to use the four buttons

Could you upload a picture of the jumper from LCD's pin D7 & D6 to the Wemos D1?
Is it possible to realize this modification without soldering?

Thanks in advance
HiHiMan

SurenBono, 2019-03-11:
Hi,
1.the LCD which was not i2s did not work on d1r1.
2.I could work those LCD  buttons if the A0 were as same as uno board but
would not be a proper addon since the LCD was not compatible for d1r1.
3.Do not uncommented the TFT even for bare minimum setup it just was not
smooter without.
4.you could try a D1r2 board or recommend a r3 version with RX & TX to D6 &
D7

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

hihiman1, 2019-03-24:
Hi,
bought a wemos D1 R32 - works perfectly with the VS1053 shield!
Next I will check if the LCD shield will also work...

SurenBono, 2019-03-24:
..esp32 R32 did not...on me ..it sounded like a blaring ..lacking of
something...but it was perfect on esp8266 with only when TFT were
uncommented... and it's not 5g thingy ,and only little more speedy than
simple esp8266...if you tested the LCD with a non i2c it probably a rare
one..let me know if it worked, include the test on a A0 buttoned LCD

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

Closed 2019-02-09.

Thread 153 (2019-01-11):

Which schematic is correct?

wa8lbz, 2019-01-11:
I discovered a little more confusion as outlined below.

The schematic diagram in schema.png shows pin 1 (RST) on the ESP8266 board connected to +5V, pin 1 (RST) on LCD, pin 10 (+5V) on VS1053 pin 6 (+5V) on LCD and pin 7 (BL) on LCD.

The schematic diagram in the ESP-radio.pdf shows pin 1 on ESP8266 board with no connection.

The wiring information in Esp_radio.ino shows pin 1 (RST) on ESP8266 board connected to pin 1 (RST) on LCD and pin 3 (RST) on VS1053 board.

Which schematic is correct? If it the schematic in the schema.png, do you really want pin 1 on ESP8266 board going to +5V?

Thread 154 (2019-01-20):

Cant play some streams (No data input); WINAMP play them

Schulz19, 2019-01-20:
Dear Mr. Smallenburg
thank you for your great project work.

I still have a problem with two webstreams

1.: st03.dlf.de/dlf/03/128/mp3/stream.mp3 (Deutschlandfunk Nova)

D: Connect to new host st03.dlf.de/dlf/03/128/mp3/stream.mp3
D: Connect to st03.dlf.de on port 80, extension /dlf/03/128/mp3/stream.mp3
D: Connected to server
D: Switch to HEADER
D: Server: nginx
D: Content-Length: 0
D: Connection: close
D: Cache-Control: no-cache, no-store
D: Expires: Mon, 26 Jul 1997 05:00:00 GMT
D: Access-Control-Allow-Origin: *
D: Access-Control-Allow-Headers: Origin, Accept, X-Requested-With, Content-Type
D: -Allow-Headers: Origin, Accept, X-Requested-With, Content-Type seen.
D: Access-Control-Allow-Methods: GET, OPTIONS, HEAD
D: Location: http://dg-dradio-http-fra-dtag-cdn.cast.addradio.de/dlf/03/128/mp3/stream.mp3
D: Switch to DATA, bitrate is 0, metaint is 0

2.: br-br3-live.cast.addradio.de/br/br3/live/mp3/128/stream.mp3 (Bayern 3)

D: Connect to br-br3-live.cast.addradio.de on port 80, extension /br/br3/live/mp3/128/stream.mp3
D: Connected to server
D: Switch to HEADER
D: Server: nginx
D: Content-Length: 0
D: Connection: close
D: Cache-Control: no-cache, no-store
D: Expires: Mon, 26 Jul 1997 05:00:00 GMT
D: Access-Control-Allow-Origin: *
D: Access-Control-Allow-Headers: Origin, Accept, X-Requested-With, Content-Type
D: -Allow-Headers: Origin, Accept, X-Requested-With, Content-Type seen.
D: Access-Control-Allow-Methods: GET, OPTIONS, HEAD
D: Location: http://dg-br-http-fra-dtag-cdn.cast.addradio.de/br/br3/live/mp3/128/stream.mp3
D: Switch to DATA, bitrate is 0, metaint is 0
D: No data input

These streams can be played in WINAMP but not on WEB radio

Is there any idea for this problem?

Greetings

Ernst

Schulz19, 2019-01-20:
I have a solution:

Bayern 3

This URL worked:

dg-br-http-fra-dtag-cdn.cast.addradio.de/br/br3/live/mp3/128/stream.mp3

Dlf Nova
dg-dradio-http-dus-dtag-cdn.cast.addradio.de/dlf/03/128/mp3/stream.mp3

Greetings

Ernst

Thread 157 (2019-01-29):

D: /radio.ini - 1987

netrosec, 2019-01-29:
I'm testing with the VS1053 and a wemos nodemcu without a tft screen but i included the tft library in the sketch. I get this error immediately after uploading i dont know what it means.
```
D: FS Total 2949250, used 2259
D: /radio.ini                       -    1987
D: Added SSID 00 = (:) to acceptable networks
D: Added SSID 01 = ADSL-11 to acceptable networks
D: * Scan Networks *
D: Number of available networks: 1
D:  1 - (:)                       Signal: -40 dBm Encryption WPA2  Acceptable
D: --------------------------------------
D: Command: mqttbroker with parameter broker.hivemq.com
D: Command: mqttport with parameter 1883
D: Command: mqttuser with parameter none
D: Command: mqttpasswd with parameter none
D: Command: mqtttopic with parameter espradio
D: Command: mqttpubtopic with parameter espradioIP
D: Command: wifi_00 with parameter (:)/switchfoot
D: Command: wifi_01 with parameter ADSL-11/yyyyyyy
D: Command: volume with parameter 72
D: Command: toneha with parameter 0
D: Command: tonehf with parameter 0
D: Command: tonela with parameter 0
D: Command: tonelf with parameter 0
D: Command: preset with parameter 6
D: Command: preset_00 with parameter 109.206.96.34:8100
D: Command: preset_01 with parameter airspectrum.cdnstream1.com:8114/1648_128
D: Command: preset_02 with parameter us2.internet-radio.com:8050
D: Command: preset_03 with parameter airspectrum.cdnstream1.com:8000/1261_192
D: Command: preset_04 with parameter airspectrum.cdnstream1.com:8008/1604_128
D: Command: preset_05 with parameter us1.internet-radio.com:8105
D: Command: preset_06 with parameter icecast.omroep.nl:80/radio1-bb-mp3
D: Command: preset_07 with parameter 205.164.62.15:10032
D: Command: preset_08 with parameter skonto.ls.lv:8002/mp3
D: Command: preset_09 with parameter 94.23.66.155:8106
D: Command: preset_10 with parameter ihr/IHR_IEDM
D: Command: preset_11 with parameter ihr/IHR_TRAN
D: Command: preset_12 with parameter ihr/WQTR
D: Command: preset_13 with parameter ihr/CKMXAM
D: FS Total 957314, used 2259
D: /radio.ini                       -    1987
D: Added SSID 00 = (:) to acceptable networks
D: Added SSID 01 = ADSL-11 to acceptable networks
D: * Scan Networks *

```

netrosec, 2019-01-29:
I have a 5v 2amp power bank. But the esp8266 is connected to my computer.

Edzelf, 2019-01-29:
Better connect it to the powerbank.

netrosec, 2019-01-29:
@edzelf I did but nothing changed. The nodemcu light pulses about every second a network search shows esp radio is not on my network.

Edzelf, 2019-01-29:
Maybe it has something to do with the weird name of the network.

netrosec, 2019-01-29:
Unlikely. The network name worked fine for the esp32 radio project. Maybe i'll stick with esp32 radio.

Thread 159 (2019-02-10):

Getting errors: VS1053 SPI error. SB:15EA R1:15E7 R2:15E7 ....

AaronNGray, 2019-02-10:
I am getting the following errors I am suspecting the VS1053 board is faulty ?

D: Slow SPI, Testing VS1053 read/write registers...
D: Fast SPI, Testing VS1053 read/write registers again...
D: VS1053 SPI error. SB:15EA R1:15E7 R2:15E7
D: VS1053 SPI error. SB:1ED8 R1:1ED5 R2:1ED5
D: VS1053 SPI error. SB:2A36 R1:2A33 R2:2A33
D: VS1053 SPI error. SB:2B6E R1:0000 R2:0000
D: VS1053 SPI error. SB:2B71 R1:FF00 R2:0000
D: VS1053 SPI error. SB:2B74 R1:FE00 R2:0000
D: VS1053 SPI error. SB:2B77 R1:FF00 R2:0000
D: VS1053 SPI error. SB:2B7A R1:FF00 R2:0000
D: VS1053 SPI error. SB:2B7D R1:FE00 R2:0000
D: VS1053 SPI error. SB:2B80 R1:FF00 R2:0000
D: VS1053 SPI error. SB:2B83 R1:FF00 R2:0000
D: VS1053 SPI error. SB:2B86 R1:FF00 R2:0000
D: VS1053 SPI error. SB:2B89 R1:FF00 R2:0000
D: VS1053 SPI error. SB:2B8C R1:FF00 R2:0000
D: VS1053 SPI error. SB:2B8F R1:FF00 R2:0000
D: VS1053 SPI error. SB:2B92 R1:FE00 R2:0000
D: VS1053 SPI error. SB:2B95 R1:FF00 R2:0000
D: VS1053 SPI error. SB:2B98 R1:FF00 R2:0000
D: VS1053 SPI error. SB:2B9B R1:FF00 R2:0000
D: VS1053 SPI error. SB:2B9E R1:FF00 R2:0000

I have the following wiring :-

|ESP32  |Colour|VS1053|Rotary
|-------|------|------|--
|EN     |Blue  |XRST  |
|GPIO32   |Grey  |XDCS  |
|GPIO5    |White |XCS   |
|GPIO4    |Purple|DREQ  |
|GPIO18   |Yellow|SCK   |
|GPIO19   |Orange|MISO  |
|GPIO23   |Green |MOSI  |
|GPIO25   |White |      |CLK
|GPIO26   |Grey  |      |DT
|GPIO27   |Purple|      |SW

Edzelf, 2019-02-10:
The slow SPI test seems to work.  Probably a wiring problem or a wek powersupply.

AaronNGray, 2019-02-10:
AFAICS the wiring is fine. I am using Two USB connections from the same computer one for power and the other for serial connection with the grounds connected. I have seemed to been having what looks like RF field problems to some degree when I was first trying to get it to work.

It did not work at first after setting the WIFI SSID and Password then I did a reset and it sprung into action working for several hours. Then stopped and it was late so I presumed it was a network issue and packed in for the night. Next morning there was no audio but the serial output looked totally correct.

I am now with another ESP32 board and a new VS1053 board thats now giving the above error with the following output but no sound.

D: Starting ESP32-radio running on CPU 1 at 240 MHz.  Version Tue, 05 Jan 2019 19:48:00 GMT.  Free memory 291184
D: Display type is BLUETFT
D: Partition nvs found, 20480 bytes
D: Read 46 keys from NVS
D: pin_ir set to 35
D: pin_enc_clk set to 25
D: pin_enc_dt set to 26
D: pin_enc_sw set to 27
D: pin_tft_cs set to 15
D: pin_tft_dc set to 2
D: pin_tft_scl set to -1
D: pin_tft_sda set to -1
D: pin_tft_bl set to -1
D: pin_tft_blx set to -1
D: pin_sd_cs set to 21
D: pin_vs_cs set to 5
D: pin_vs_dcs set to 32
D: pin_vs_dreq set to 4
D: pin_shutdown set to -1
D: pin_shutdownx set to -1
D: pin_spi_sck set to 18
D: pin_spi_miso set to 19
D: pin_spi_mosi set to 23
D: GPIO0 is HIGH
D: GPIO2 is LOW, probably no PULL-UP
D: GPIO4 is HIGH
D: GPIO5 is HIGH
D: GPIO12 is HIGH
D: GPIO13 is HIGH
D: GPIO14 is HIGH
D: GPIO15 is HIGH
D: GPIO16 is HIGH
D: GPIO17 is HIGH
D: GPIO18 is LOW, probably no PULL-UP
D: GPIO19 is HIGH
D: GPIO21 is HIGH
D: GPIO22 is HIGH
D: GPIO23 is HIGH
D: GPIO25 is HIGH
D: GPIO26 is HIGH
D: GPIO27 is HIGH
D: GPIO32 is HIGH
D: GPIO33 is HIGH
D: GPIO34 is LOW, probably no PULL-UP
D: GPIO35 is LOW, probably no PULL-UP
D: GPIO39 is LOW, probably no PULL-UP
D: gpio_00 will execute uppreset = 1
D: gpio_12 will execute upvolume = 2
D: gpio_13 will execute downvolume = 2
D: gpio_14 will execute stop
D: gpio_17 will execute resume
D: gpio_34 will execute station = icecast.omroep.nl:80/radio1-bb-mp3
D: Enable pin 35 for IR
D: Start display
D: SD Card Mount Failed!
D: Create list with acceptable WiFi networks
D: Added TP-LINK_9789 to list of networks
D: Added SSID2 to list of networks
D: End adding networks
D: Scan Networks
D: Scan completed
D: Number of available networks: 11
D:  1 - FreeBeer                  Signal: -55 dBm, Encryption WPA_WPA2_PSK,
D:  2 - TP-LINK_9789              Signal: -57 dBm, Encryption WPA_WPA2_PSK, Acceptable
D:  3 - BTHub6-HT67               Signal: -75 dBm, Encryption WPA2_PSK,
D:  4 - BTWifi-with-FON           Signal: -75 dBm, Encryption OPEN,
D:  5 - BTWifi-X                  Signal: -75 dBm, Encryption ????,
D:  6 - BTHub6-2C3Z               Signal: -86 dBm, Encryption WPA2_PSK,
D:  7 - BTHub6-HX3T               Signal: -86 dBm, Encryption WPA2_PSK,
D:  8 - BTWifi-with-FON           Signal: -87 dBm, Encryption OPEN,
D:  9 - BTWifi-X                  Signal: -87 dBm, Encryption ????,
D: 10 - TALKTALKAC7D52            Signal: -87 dBm, Encryption WPA_WPA2_PSK,
D: 11 - TALKTALK-60D6F8           Signal: -92 dBm, Encryption WPA_WPA2_PSK,
D: End of list
D: Command: clk_dst with parameter 1
D: Command: clk_offset with parameter 1
D: Command: clk_server with parameter pool.ntp.org
D: Command: gpio_00 with parameter uppreset = 1
D: Command: gpio_12 with parameter upvolume = 2
D: Command: gpio_13 with parameter downvolume = 2
D: Command: gpio_14 with parameter stop
D: Command: gpio_17 with parameter resume
D: Command: gpio_34 with parameter station = icecast.omroep.nl:80/radio1-bb-mp3
D: Command: ir_40bf with parameter upvolume = 2
D: Command: ir_c03f with parameter downvolume = 2
D: Command: mqqprefix with parameter none
D: Command: mqttbroker with parameter none
D: Command: mqttpasswd with parameter *******
D: Command: mqttport with parameter 1883
D: Command: mqttuser with parameter none
D: Command: pin_enc_clk with parameter 25
D: Command: pin_enc_dt with parameter 26
D: Command: pin_enc_sw with parameter 27
D: Command: pin_ir with parameter 35
D: Command: pin_sd_cs with parameter 21
D: Command: pin_tft_cs with parameter 15
D: Command: pin_tft_dc with parameter 2
D: Command: pin_vs_cs with parameter 5
D: Command: pin_vs_dcs with parameter 32
D: Command: pin_vs_dreq with parameter 4
D: Command: preset with parameter 6
D: Command: preset_00 with parameter 109.206.96.34:8100
D: Command: preset_01 with parameter airspectrum.cdnstream1.com:8114/1648_128
D: Command: preset_02 with parameter us2.internet-radio.com:8050
D: Command: preset_03 with parameter airspectrum.cdnstream1.com:8000/1261_192
D: Command: preset_04 with parameter airspectrum.cdnstream1.com:8008/1604_128
D: Command: preset_05 with parameter us1.internet-radio.com:8105
D: Command: preset_06 with parameter icecast.omroep.nl:80/radio1-bb-mp3
D: Command: preset_07 with parameter 205.164.62.15:10032
D: Command: preset_08 with parameter skonto.ls.lv:8002/mp3
D: Command: preset_09 with parameter 94.23.66.155:8106
D: Command: preset_10 with parameter ihr/IHR_IEDM
D: Command: preset_11 with parameter ihr/IHR_TRAN
D: Command: toneha with parameter 0
D: Command: tonehf with parameter 0
D: Command: tonela with parameter 0
D: Command: tonelf with parameter 0
D: Command: volume with parameter 72
D: Slow SPI, Testing VS1053 read/write registers...
D: Fast SPI, Testing VS1053 read/write registers again...
D: VS1053 SPI error. SB:15EA R1:15E7 R2:15E7
D: VS1053 SPI error. SB:1ED8 R1:1ED5 R2:1ED5
D: VS1053 SPI error. SB:2A36 R1:2A33 R2:2A33
D: VS1053 SPI error. SB:2B6E R1:0000 R2:0000
D: VS1053 SPI error. SB:2B71 R1:FF00 R2:0000
D: VS1053 SPI error. SB:2B74 R1:FE00 R2:0000
D: VS1053 SPI error. SB:2B77 R1:FF00 R2:0000
D: VS1053 SPI error. SB:2B7A R1:FF00 R2:0000
D: VS1053 SPI error. SB:2B7D R1:FE00 R2:0000
D: VS1053 SPI error. SB:2B80 R1:FF00 R2:0000
D: VS1053 SPI error. SB:2B83 R1:FF00 R2:0000
D: VS1053 SPI error. SB:2B86 R1:FF00 R2:0000
D: VS1053 SPI error. SB:2B89 R1:FF00 R2:0000
D: VS1053 SPI error. SB:2B8C R1:FF00 R2:0000
D: VS1053 SPI error. SB:2B8F R1:FF00 R2:0000
D: VS1053 SPI error. SB:2B92 R1:FE00 R2:0000
D: VS1053 SPI error. SB:2B95 R1:FF00 R2:0000
D: VS1053 SPI error. SB:2B98 R1:FF00 R2:0000
D: VS1053 SPI error. SB:2B9B R1:FF00 R2:0000
D: VS1053 SPI error. SB:2B9E R1:FF00 R2:0000
D: endFillByte is 0
D: Connect to WiFi
D: Connected to TP-LINK_9789
D: IP = 192.168.0.189
D: Start server for commands
D: Network found. Starting mqtt and OTA
D: MDNS responder started
D: Rotary encoder is enabled
D: Sync TOD
D: Sync TOD, new value is 17:53:32
D: STOP requested
D: New preset/file requested (6/0) from icecast.omroep.nl:80/radio1-bb-mp3
D: Connect to new host icecast.omroep.nl:80/radio1-bb-mp3
D: Connect to icecast.omroep.nl on port 80, extension /radio1-bb-mp3
D: Connected to server
D: nvs_get_str failed 1102 for key basicauth, keylen is 9, len is 150!
D: Contents:
D: Duration mp3loop 1
D: Switch to HEADER
D: Headerline: Content-Type: audio/mpeg
D: audio/mpeg seen.
D: Headerline: icy-br:192
D: Headerline: ice-audio-info: samplerate=48000;channels=2;bitrate=192
D: Headerline: icy-br:192
D: Headerline: icy-genre:Talk
D: Headerline: icy-metadata:1
D: Headerline: icy-name:NPO Radio1
D: Headerline: icy-pub:0
D: Headerline: icy-url:http://www.radio1.nl
D: Headerline: Server: Icecast 2.4.0-kh10
D: Headerline: Cache-Control: no-cache, no-store
D: Headerline: Access-Control-Allow-Origin: *
D: Headerline: Access-Control-Allow-Headers: Origin, Accept, X-Requested-With, Content-Type
D: l-Allow-Headers: Origin, Accept, X-Requested-With, Content-Type seen.
D: Headerline: Access-Control-Allow-Methods: GET, OPTIONS, HEAD
D: Headerline: Connection: Close
D: Headerline: Expires: Mon, 26 Jul 1997 05:00:00 GMT
D: Headerline: icy-metaint:16000
D: Switch to DATA, bitrate is 192, metaint is 16000
D: Duration mp3loop 71
D: Duration mp3loop 137
D: Metadata block 64 bytes
D: Streamtitle found, 52 bytes
D: StreamTitle='NPO Radio 1 - NOS Langs de Lijn - NOS';

AaronNGray, 2019-02-10:
There seems to be an nvs error in there too

```nvs_get_str failed 1102 for key basicauth, keylen is 9, len is 150!```

AaronNGray, 2019-02-10:
And I am getting 4.97 Volts.

Edzelf, 2019-02-10:
The basicauth key is new.  I will check this.
Strange thing is that gpio2 is low.
But there is still something wrong with the SPI bus.

AaronNGray, 2019-02-10:
okay I have checked the powerline with a scope and it looks solid.

AaronNGray, 2019-02-10:
GPIO2 is not connected to anything. And I have checked my breakout board and it should be floating.

AaronNGray, 2019-02-10:
I dont have another VS1053 board to substitute :)

AaronNGray, 2019-02-10:
Sorry I have posted this on the wrong repo !!!

Closed 2019-04-16.

Thread 160 (2019-02-25):

How to change text size ILI9341

onurguc, 2019-02-25:
Hi,

How can I make the text size bigger on ILI9341.  I went into config files but I wasn't able find something that works.

Thanks,
-Onur

Edzelf, 2019-02-25:
If your display is not a 160x128 type, you have to edit the documents/Arduino/libraries/ TFT_ILI9163C-master/_settings/TFT_ILI9163C_settings.h  file (_TFTWIDTH, _TFTHEIGHT, _GRAMWIDTH and _GRAMHEIGHT.
Then change the height and width parameters in calls to tft.xxxxxx in the sketch.

If you just want to change the text size, add calls to tft.setTextSize(x) in the sketch.

onurguc, 2019-02-25:
My display type is 320x240.  I'm using the adafruit library and it's
actually set correctly as 320 and 240.  Text size has (a) here.  What
should I change it to?  Like (e)?

I dont know the pattern.

Thanks,
-Onur

Ed Smallenburg <notifications@github.com>, 25 Şub 2019 Pzt, 11:02 tarihinde
şunu yazdı:

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

onurguc, 2019-02-25:
[image: WhatsApp Image 2019-02-25 at 22.19.22.jpeg]
I managed to change the text size from 1 to 2 but it messed up the clock on
top right corner.  Also the rest of the characters looks pixelated.

Check the below right screen with the right resolution.  This sketch is
using u8g2 library

[image: WhatsApp Image 2019-02-25 at 22.19.22-2.jpeg]

Onur Gucukoglu <onurguc@yahoo.com>, 25 Şub 2019 Pzt, 18:14 tarihinde şunu
yazdı:

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

Edzelf, 2019-02-26:
Sorry, but I cannot see your images.  What is WhatsApp?

djmaj0, 2019-03-20:
> Sorry, but I cannot see your images. What is WhatsApp?

I have same problem. I changed "dsp_setTextSize ( 1 )"  to "dsp_setTextSize ( 2 )"
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
what i need to do now?

djmaj0, 2019-03-20:
Also is there possible to add font with characters like "ľ š č ť ž ý á ä ú ň ô" or central europian character set?
As you can see instead of Rádio Best FM" it shows me "Rdio Best FM"

AlexVichter, 2019-11-09:
Dear Ed,
your Web  Radio project supports the ILI9341 display. I can find in your description only the wiring diagram for the Display with the following pins:
- D/C (A0),
- CLK/SCK,
- DIN/SDA
- CS
- GND
- BL
- VCC
- RST pins

But my display 3.2 TFT SPI 240x320 ILI9341 has another pins:
- SDO(MISO)
- LED
- SCK
- SDI(MOSI)
- DC
- RESET
- CS
- GND
- VCC

Can you please advise the wiring diagram for this variant to ESP32 according to the actual .ino sketch?

Should I change any variables in your .ino sketch to adopt my ILI9341? If yes, which file and which lines in it?

Perhaps my questions are stupid, but I cannot find this information in project files.

Thanks a lot for your help and support!

RufRudolf, 2020-04-06:
> I have same problem. I changed "dsp_setTextSize ( 1 )" to "dsp_setTextSize ( 2 )"
> 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
> what i need to do now?

  Hi, I wonder if someone properly solved this issue. I encountered same problem with font "size 2" but haven't found a solution for it anywhere on the internet. So at least I want to share my experimental solution since the result is ok:

  I use the red ILI9341 2,8'' 240x320 display from Keenso which is a nice size for the project setup :) So after having changed **dsp_setTextSize(1)** to **dsp_setTextSize(2)** in the sketch I also adapted **#define TIMEPOS -52** to **#define TIMEPOS -92** to allow more space for larger time string but to keep it sofar at the right end of the line; since I haven't found any documentation of the font characteristics I had to count the pixel of "size 2" characters and try.

  To avoid the new time string to become a mess it is important to take care of the refresh mechanism in **ILI9341.h** You will find it at the end of the header file in section "DISPLAYTIME": Due to the fact that one character of font "size 2" has a hight of 14 pixels and lenght of 11 pixels while "size 1" is 8 pixels high and 6 pixels wide you have to adapt **dsp_fillRect(pos, 0, 6, 8, BLACK)** to **dsp_fillRect(pos, 0, 11, 14, BLACK)** and **pos+=6** to **pos+=11** since the overwriting of pixels is done character by character for changing parts only - now with bigger area (11x14 istead of 6x8 pixels).

  I additionally changed the size of "yellow area" of the display bottom from 4 to 8 lines to enhance handling of long strings there. It is also defined in ILI9341.h as a vector:
scrseg_struct tftdata[TFTSECS]={
  { false, WHITE,   0,  8, "" },
  { false, CYAN,   20, 64, "" },
  **{ false, YELLOW, 90, 32, "" }** //4 lines at the bottom
  { false, GREEN,  90, 32, "" } }
Bold type changed to  **{ false, YELLOW, 90, 64, "" }** //8 lines at the bottom

  I hope it helps though if someone will find a proper documentation of the font sizes please add this to this thread. I add a picture of the result to let you have an impression:

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

blotfi, 2020-05-24:
You can change the fonts
by adding in
`ILI9341.h`
add
`#include <Fonts/FreeSans9pt7b.h>`

also

```
bool dsp_begin()
{
  tft = new Adafruit_ILI9341 ( ini_block.tft_cs_pin,
                               ini_block.tft_dc_pin ) ;            // Create an instant for TFT

  tft->begin();                                                    // Init TFT interface
  tft->setFont( & FreeSans9pt7b);
  return ( tft != NULL ) ;
}

```

blotfi, 2020-05-24:
with original font and double size

    dsp_setTextSize ( 2 ) ;
Here is the file you should use as

    ILI9341.h

```
// ILI9341.h
//
// Contributed by Uksa007@gmail.com
// Separated from the main sketch to allow several display types.
// Includes for various ILI9341 displays.  Tested on 320 x 240.
// Requires Adafruit ILI9341 library, available from library manager.
// Below set your dsp_getwidth() and dsp_getwidth() to suite your display.

#include <Adafruit_ILI9341.h>
#include <Fonts/FreeSans9pt7b.h>

// Color definitions for the TFT screen (if used)
// TFT has bits 6 bits (0..5) for RED, 6 bits (6..11) for GREEN and 4 bits (12..15) for BLUE.
#define BLACK   ILI9341_BLACK
#define BLUE    ILI9341_BLUE
#define RED     ILI9341_RED
#define GREEN   ILI9341_GREEN
#define CYAN    GREEN | BLUE
#define MAGENTA RED | BLUE
#define YELLOW  RED | GREEN
#define WHITE   RED | BLUE | GREEN

// Data to display.  There are TFTSECS sections
#define TFTSECS 4
scrseg_struct     tftdata[TFTSECS] =                        // Screen divided in 3 segments + 1 overlay
{                                                           // One text line is 8 pixels
  { false, WHITE,   0,  8, "" },    // 1 top line
  { false, CYAN,   20, 64, "" },    // 8 lines in the middle
  { false, YELLOW, 90, 32, "" },    // 4 lines at the bottom
  { false, GREEN,  90, 32, "" }         // 4 lines at the bottom for rotary encoder
} ;

Adafruit_ILI9341*     tft = NULL ;                                  // For instance of display driver

// Various macro's to mimic the ILI9341 version of display functions
#define dsp_setRotation()       tft->setRotation ( 3 )             // Use landscape format (3 for upside down)
#define dsp_print(a)            tft->print ( a )                   // Print a string
#define dsp_println(b)          tft->println ( b )                 // Print a string followed by newline
#define dsp_fillRect(a,b,c,d,e) tft->fillRect ( a, b, c, d, e ) ;  // Fill a rectange
#define dsp_setTextSize(a)      tft->setTextSize(a)                // Set the text size
#define dsp_setTextColor(a)     tft->setTextColor(a)               // Set the text color
#define dsp_setCursor(a,b)      tft->setCursor ( a, b )            // Position the cursor
#define dsp_erase()             tft->fillScreen ( BLACK ) ;        // Clear the screen
#define dsp_getwidth()          320                                // Adjust to your display
#define dsp_getheight()         240                                // Get height of screen
#define dsp_update()                                               // Updates to the physical screen
#define dsp_usesSPI()           true                               // Does use SPI

bool dsp_begin()
{
  tft = new Adafruit_ILI9341 ( ini_block.tft_cs_pin,
                               ini_block.tft_dc_pin ) ;            // Create an instant for TFT

  tft->begin();                                                    // Init TFT interface
//  tft->setFont( & FreeSans9pt7b);
  return ( tft != NULL ) ;
}

//**************************************************************************************************
//                                      D I S P L A Y B A T T E R Y                                *
//**************************************************************************************************
// Show the current battery charge level on the screen.                                            *
// It will overwrite the top divider.                                                              *
// No action if bat0/bat100 not defined in the preferences.                                        *
//**************************************************************************************************
void displaybattery()
{
  if ( tft )
  {
    if ( ini_block.bat0 < ini_block.bat100 )              // Levels set in preferences?
    {
      static uint16_t oldpos = 0 ;                        // Previous charge level
      uint16_t        ypos ;                              // Position on screen
      uint16_t        v ;                                 // Constrainted ADC value
      uint16_t        newpos ;                            // Current setting

      v = constrain ( adcval, ini_block.bat0,             // Prevent out of scale
                      ini_block.bat100 ) ;
      newpos = map ( v, ini_block.bat0,                   // Compute length of green bar
                     ini_block.bat100,
                     0, dsp_getwidth() ) ;
      if ( newpos != oldpos )                             // Value changed?
      {
        oldpos = newpos ;                                 // Remember for next compare
        ypos = tftdata[1].y - 5 ;                         // Just before 1st divider
        dsp_fillRect ( 0, ypos, newpos, 2, GREEN ) ;      // Paint green part
        dsp_fillRect ( newpos, ypos,
                       dsp_getwidth() - newpos,
                       2, RED ) ;                          // Paint red part
      }
    }
  }
}

//**************************************************************************************************
//                                      D I S P L A Y V O L U M E                                  *
//**************************************************************************************************
// Show the current volume as an indicator on the screen.                                          *
// The indicator is 2 pixels heigh.                                                                *
//**************************************************************************************************
void displayvolume()
{
  if ( tft )
  {
    static uint8_t oldvol = 0 ;                         // Previous volume
    uint8_t        newvol ;                             // Current setting
    uint16_t       pos ;                                // Positon of volume indicator

    newvol = vs1053player->getVolume() ;                // Get current volume setting
    if ( newvol != oldvol )                             // Volume changed?
    {
      oldvol = newvol ;                                 // Remember for next compare
      pos = map ( newvol, 0, 100, 0, dsp_getwidth() ) ; // Compute position on TFT
      dsp_fillRect ( 0, dsp_getheight() - 2,
                     pos, 2, RED ) ;                    // Paint red part
      dsp_fillRect ( pos, dsp_getheight() - 2,
                     dsp_getwidth() - pos, 2, GREEN ) ; // Paint green part
    }
  }
}

//**************************************************************************************************
//                                      D I S P L A Y T I M E                                      *
//**************************************************************************************************
// Show the time on the LCD at a fixed position in a specified color                               *
// To prevent flickering, only the changed part of the timestring is displayed.                    *
// An empty string will force a refresh on next call.                                              *
// A character on the screen is 8 pixels high and 6 pixels wide.                                   *
//**************************************************************************************************
void displaytime ( const char* str, uint16_t color )
{
  static char oldstr[9] = "........" ;             // For compare
  uint8_t     i ;                                  // Index in strings
  uint16_t    pos = dsp_getwidth() + TIMEPOS ;     // X-position of character, TIMEPOS is negative

  if ( str[0] == '\0' )                            // Empty string?
  {
    for ( i = 0 ; i < 8 ; i++ )                    // Set oldstr to dots
    {
      oldstr[i] = '.' ;
    }
    return ;                                       // No actual display yet
  }
  if ( tft )                                       // TFT active?
  {
    dsp_setTextColor ( color ) ;                   // Set the requested color
    for ( i = 0 ; i < 8 ; i++ )                    // Compare old and new
    {
      if ( str[i] != oldstr[i] )                   // Difference?
      {
        //dsp_fillRect ( pos, 0, 6, 8, BLACK ) ;     // Clear the space for new character
        dsp_fillRect(pos, 0, 11, 14, BLACK);      // Clear the space for new character
        dsp_setCursor ( pos, 0 ) ;                 // Prepare to show the info
        dsp_print ( str[i] ) ;                     // Show the character
        oldstr[i] = str[i] ;                       // Remember for next compare
      }
      pos += 11 ;                                   // Next position
    }
  }
}
```
`

Thread 162 (2019-03-27):

SWR Preset won't work

lautrarer, 2019-03-27:
Some Presets work but swr 3 won't. In winamp its normally playing.

D: New preset/file requested (-1/0) from swr-swr3-live.cast.addradio.de/swr/swr3/live/mp3/128/stream.m
D: Connect to new host swr-swr3-live.cast.addradio.de/swr/swr3/live/mp3/128/stream.mp3
D: Connect to swr-swr3-live.cast.addradio.de on port 80, extension /swr/swr3/live/mp3/128/stream.mp3
D: Connected to server
D: Switch to HEADER
D: Server: nginx
D: Content-Length: 0
D: Connection: close
D: Cache-Control: no-cache, no-store
D: Expires: Mon, 26 Jul 1997 05:00:00 GMT
D: Access-Control-Allow-Origin: *
D: Access-Control-Allow-Headers: Origin, Accept, X-Requested-With, Content-Type
D: -Allow-Headers: Origin, Accept, X-Requested-With, Content-Type seen.
D: Access-Control-Allow-Methods: GET, OPTIONS, HEAD
D: Location: http://dg-swr-http-fra-dtag-cdn.cast.addradio.de/swr/swr3/live/mp3/128/stream.mp3
D: Switch to DATA, bitrate is 0, metaint is 0
D: No data input
D: No data input

This is all what i get

Edzelf, 2019-03-27:
You will be redirected in winamp if you use that.
Use dg-swr-http-dus-dtag-cdn.cast.addradio.de/swr/swr3/live/mp3/128/stream.mp3 instead.

lautrarer, 2019-03-27:
Works now ty

Closed 2019-03-27.

Thread 169 (2019-06-29):

NodeMCU V3 - LoLin

dagisr, 2019-06-29:
Hello,
I have my first ESP-Radio running on a NODMCU  Amica and it is very nice.
Esp-Radio app on my android is really something.

Hovever, can not get it running with NODEMCU V3 - LoLin

Any help, please.

/Dag

teschmitt, 2019-09-01:
What issues are you having specifically? I have it up and running with exactly that board.

fc92, 2020-04-18:
I have a NodeMcu V3 board and it works. (I don't use TFT screen and I wired the VS1053 reset pin with the NodeMcu RST pin).

Thread 170 (2019-08-18):

Get error while compileing

diwo13, 2019-08-18:
Hi

i try to compile but i get following error. I don't know what to do.
Can anyone please help me?

`/home/USER/Arduino/libraries/Adafruit_Circuit_Playground/Adafruit_Circuit_Playground.h:100:3: error: 'Adafruit_CPlay_FreeTouch' does not name a type
   Adafruit_CPlay_FreeTouch     cap[7]; ///< the array of capacitive touch sensors`

I think the problem starts here. But i don't know what to do.

`
#ifdef __AVR__ // Circuit Playground 'classic'
  CPlay_CapacitiveSensor cap[8]; ///< the array of capacitive touch sensors
#else
  Adafruit_CPlay_FreeTouch     cap[7]; ///< the array of capacitive touch sensors
  IRrecvPCI              irReceiver; ///< the IR receiver object
  IRdecode               irDecoder; ///< the IR decoder object
  IRsend                 irSend; ///< the IR send object
#endif
`

I use arduino IDE 1.8.9 but I tried 1.8.5 else.

The needed libries i downloaded by from links in the head of the file ESP_RADIO.ino

Thanks for help
If you need additional informations i try give this.

Edzelf, 2019-08-18:
Did you select the right board?  It looks like an error while compiling for Atmega instead of ESP8266.

diwo13, 2019-08-18:
Hi Edzelf

thank you for your comment.

I use a WEMOS D1 mini.
I can't select this board, but I can (and did) select a LOLIN(WEMOS) D1 R2 & mini. I also tried to select Generic ESP8266 Module.

The problem stays.

Edzelf, 2019-08-18:
Could you try to remove the adafruit-circuit-playground library?

diwo13, 2019-08-18:
I remove the complete Adafruit_Circuit_Playground folder from the libraries folder.
Now i got this message

`Esp_radio:1:41: error: Adafruit_Circuit_Playground.h: No such file or directory
 #include <Adafruit_Circuit_Playground.h>`

Edzelf, 2019-08-18:
But there is no include for this library in my sketch.  Are you sure you have the right sketch, the one with the 3129 lines?

diwo13, 2019-08-18:
In my sketch is
```
#include Adafruit_CircuitPlayground
#include Adafruit_Circuit_Playground
```

I commend them out

```
//#include Adafruit_CircuitPlayground
//#include Adafruit_Circuit_Playground
```

now there error message while compiling and I can load the sketch

Thank you for your help

Closed 2019-08-20.

Thread 171 (2019-08-20):

I can't add 'RadioBOB' can you please help me?

diwo13, 2019-08-20:
Hi

the Radio works fine. But I have some problems to add new Radio-Stations.

For example "Radio Bob"

I got these links from Radio Bob website: [https://streams.radiobob.de/](url)
`https://streams.radiobob.de/bob-80srock/mp3-192/streams.radiobob.de/`
`https://streams.radiobob.de/bob-80srock/mp3-192/streams.radiobob.de/play.pls`
`https://streams.radiobob.de/bob-80srock/mp3-192/streams.radiobob.de/play.m3u`

I put the first link into winamp an get this: (it's the same string)

`https://streams.radiobob.de/bob-80srock/mp3-192/streams.radiobob.de/`

Unfortunately no one works in ESP-Radio.

Can you please help me?

Thanks

Edzelf, 2019-08-20:
streams.radiobob.de/bob-80srock/mp3-192/streams.radiobob.de works in my setup.
I entered it in the webinterface next to the PLAY button.
And I made a preset for it:
```
preset_012 = streams.radiobob.de/bob-80srock/mp3-192/streams.radiobob.de  # 12 - Radio Bob
```
Did you remove the "https://" prefix?

diwo13, 2019-08-20:
Hi Edzelf

Thank you for Your fast answer.

Yes I removed the "https://"

I tried to put the string next to the play-button. No Radio Bob is playing.

I copied exacly your preset-String and put it into the radio.ini and saved it. Then I restarted the esp-radio. But in no way Radio Bob is playing here :-(

I have a PiHole working here, but deaktivated it for 5 minutes. But this is not the problem. No Radio Bob at all.

I don't find my mistake

Edzelf, 2019-08-20:
I tried this station on my ESP32 radio.  I will test it on the ESP8266 version...

Edzelf, 2019-08-20:
You are right.  It does not play on the ESP8266 version.   The URL is in fact a link to:
bob.hoerradar.de/radiobob-80srock-mp3-hq?sABC=5q5p28p9%230%23po3994944q0n932r5qp091r95r3q6059%23fgernzf.enqvbobo.qr&amsparams=playerid:streams.radiobob.de;skey:1566320841
This works on my set-up.  Without any interrupts.

diwo13, 2019-08-20:
Hi

thank you for your help.
Unfortunately it works on my side only with interrupts.

Can You try if this link `bob.hoerradar.de/radiobob-80srock-mp3-hq` works on your ESP8266? It's still your link cutted after `.... mp3-hq`

on my side it's the same effect, if use the long link you have posted, or the short link.

Edzelf, 2019-08-20:
Yes, **bob.hoerradar.de/radiobob-80srock-mp3-hq** works correctly.

diwo13, 2019-08-20:
Okay

then I have to search for the problem in my installation. Do you have an idea, where I can start the search?

WIFI is 300 MBit
Every other Station works good
I have an 100MBit DSL-connection (Speedtest 5 minutes ago confirmed 100MBit)
The ESP has an fixed ip-adress in my network
When the sound stops an I i click the button TEST i get this message `Free memory is 14864, ringbuf 0, stream 0`
When the sound is correctly and I hit the TEST-button i get this message `Free memory is 14808, ringbuf 2085, stream 1861` (for example)

Thank you

Edzelf, 2019-08-20:
Your internet connection is much better than mine.  Under normal circumstances the ringbuf should have 19000+ bytes.  The stream should have 1000+ bytes.

diwo13, 2019-08-22:
Hi

can you take a look on that photo?
It shows the configuration I used. Is there everything correct?

Thank you

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

Edzelf, 2019-08-22:
Configuration looks good.  Can you test it on a different WiFi network?

diwo13, 2019-08-23:
Thats a good idea.

I think I can try this tomorrow.

Thanks

diwo13, 2019-08-31:
Hi

Sorry, I've just managed to test it.
On a other WIFI th problem with RadioBOB stays on.

I checked the message from the arduino-monitor. Maybe this can help to find the error.

`
D: Command: preset with parameter 12

D: STOP requested
D: Stopping client
D: Song stopped correctly after 0 msec
D: New preset/file requested (3/0) from streams.radiobob.de/bob-80srock/mp3-192/streams.radiobob.de
D: Connect to new host streams.radiobob.de/bob-80srock/mp3-192/streams.radiobob.de
D: Connect to streams.radiobob.de on port 80, extension /bob-80srock/mp3-192/streams.radiobob.de
D: Connected to server
D: Switch to HEADER
D: Access-Control-Allow-Origin: *
D: Cache-Control: no-cache, must-revalidate
D: Content-Type: audio/mpeg
D: audio/mpeg seen.
D: Expires: Sat, 31 Aug 2019 07:41:28 GMT
D: Location: http://bob.hoerradar.de/radiobob-80srock-mp3-hq?sABC=5q6n24n8                    
D: Server: Caddy
D: Status: 302 Moved Temporarily
D: X-Powered-By: PHP/7.3.6
D: Content-Length: 0
D: Connection: close
D: Switch to DATA, bitrate is 0, metaint is 0
D: No data input
D: No data input
D: Trying other station/file...
D: STOP requested
D: Song stopped correctly after 0 msec
D: New preset/file requested (12/0) from ihr/CKMXAM
D: Connect to new iHeartRadio host: CKMXAM
D: GET /api/livestream?version=1.5&mount=CKMXAMAAC&lang=en
D: Connected!
D: XML parser processing...
D: Bad xml status-code 453
D: Closing XML connection.
D: Connect to new host
D: Connect to  on port 80, extension /
D: Request  failed!
D: No data input
`

Thank You

diwo13, 2019-08-31:
:-)

YEESSS i git it.
I put the string from the monitor output
`bob.hoerradar.de/radiobob-80srock-mp3-hq?sABC=5q6n24n8`
into th config file.

And it plays.......GREAT

Thank you for your help.

AND MANY THANKS FOR THIS PROJEKT. IT'S A GREAT RADIO. :+1:

diwo13, 2019-09-02:
:-(

unfortunately it is not perfect yet. every now and then there are still interruptions. but at tolerable intervals, so several minutes to hours between individual interruptions

Thread 175 (2019-09-06):

Display error

Hans8266, 2019-09-06:
I have the radio up and running (actually build two with the same problem).
But the diplay shows garbage 7 mm to the right.
I changed the TFT_ILI9163C.cpp file in line 1096 as described, but this did not change anything.
What am i missing?

Edzelf, 2019-09-06:
What display are you using?  How many pixels is 7 mm?Are you us

Edzelf, 2019-09-06:
What display are you using? How many pixels is 7 mm?

Edzelf, 2019-09-06:
What is the complete path of the TFT__ILI9163C.cpp file you had changed?  Are you sure that this one is used as a library bij IDE?

Hans8266, 2019-09-07:
I use the 1.8 SPI TFT 128x160 .
I have found the problem after reading your pdf again :-),
in the file TFT_ILI9163C_settings.h I changed line 24 from 128 to 160.
I did not find the “blue 1.8 SPI 128x160 board” setting and so changed the default __144_RED_PCB__.
Although at boot up it still shows a little garbagde to the right, but when running it is all fine.
Thank you for the support and the great application!

Bye the way, I had to change the analog values for the 3 keys on the analog port, for me this worked:
asw1 - 588, asw2 - 697, asw3 - 883. My ESP-07 has reading 1024 for 1V input voltage.
I build exactly your circuit.

clparrish, 2019-09-27:
Hi Hans,
I have the same problem with the TFT that you described. I read with interest your solution to the problem, but I don't completely understand it. The lines in my file TFT_ILI9163C_settings.h are not numbered as yours obviously are. Could you please provide more detail about your solution?
Thank you, Curtis

Hans8266, 2019-09-28:
Hi Curties.
The file does not have linenumbers, but the Editor you use may display them, I use Notepad++.
Here I show line 24 and 25:
	#define _TFTWIDTH  		160//the REAL W resolution of the TFT
	#define _TFTHEIGHT 		128//the REAL H resolution of the TFT
I still have some display errors at boot up, but this is of no importance I think.

clparrish, 2019-09-28:
Hans,
Thank you very much for the information.
Curtis

On Sat, Sep 28, 2019 at 1:34 AM Hans Harbeck <notifications@github.com>
wrote:

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

Thread 177 (2019-09-27):

Edzelf

clparrish, 2019-09-27:
Hi,
I have the radio working nicely except for the display. It shows the information correctly, but everything is shifted to the left, with about 13% of "video noise" on the right. Implementing the instructions for modifying the referenced libraries does not change anything (I have the blue 128x160 TFT board). Also, my library lines are not numbered, which makes it difficult. Could you please elaborate on the procedure to correct this problem?
Thank you, Curtis

JOliverasC, 2020-08-04:
I have a similar (or same) problem, and I solved with the modifications published in <<Pinout for TFT lcd with ST7735S controller #95>>
I have a 1,8" TFT ST7736S SPI  160 x128, red one, and I guess that you have the same

clparrish, 2020-08-04:
Hi, thanks for your tip regarding the TFT. I will try this when I receive
my new ESP8266.
Curt

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

Thread 178 (2019-10-04):

Please add AAC & HE-AAC support

K1WIZ, 2019-10-04:
This looks like a great project and hats off to the developers.   As I understand it, the VS1053 does support decoding AAC and AAC+ (HE-AAC) streams.   Can you include support for those?  Many stations I am finding are moving to AAC+ because of the quality at much lower bandwidth.

Edzelf, 2019-10-06:
Asw far as I know, the AAC format will work on the radio.  Please send the URL of the station that does not work.

kost-1, 2020-08-06:
>
>
> As far as I know, the AAC format will work on the radio. Please send the URL of the station that does not work.

https://fed.fmplay.ru:8000/relax-32.aac?uid=198683153

Edzelf, 2020-08-07:
It works on ESP32 version.  It works on the ESP8266 version.  Just remove the "https://" from the station name.

Edzelf, 2020-08-07:
Maybe you have a fake VS1053 chip.  Try to read the printing on the IC.

kost-1, 2020-08-08:
Sorry, it vs1003 chip. My mistake.

Derek-K, 2021-07-02:
Tested. "fed.fmplay.ru:8000/relax-32.aac?uid=198683153" works on ESP-Radio as well. :)

m040601, 2021-07-03:
> As far as I know, the AAC format will work on the radio

@Edzelf

Could you update the README front page ? Only one sentence more or just type a few characters to make this crystal clear for end users finding this page for the first time.

Right now when one lands on the front page on bumps into this:

```
NOTES:

    If you are using V2.4.0 of the core library: set IwIP Variant to "V1.4 Prebuilt" in the Tools of the IDE.
    The radio will NOT play AACP streams.

Features:

    Can connect to thousands of Internet radio stations that broadcast MP3 or Ogg audio streams.

```

It then keeps talking a lot about "mp3" and "ogg" without any **explicit reference to aacp and it's variants**

I've been checking this project on and off for some time in the last months.
I've search the documentation extensevely.

And I could not decide my self to buy a VS1053 because I could not be 100 % sure.

Nowadays aac is long established, and it's the only thing I'm interested in.

Edzelf, 2021-07-05:
The ESP8266 version of the radio is replaced by the ESP32 version.  Please use the ESP32 version.  AAC is supported by the VS1053 and therefore also by the radio. If AACP is supported by the VS1053, it will probably work on the radio as well.

Thread 179 (2019-11-09):

ESP32+ILI9341 Wiring

AlexVichter, 2019-11-09:
Dear Ed,
your Web Radio ESP32 project supports the ILI9341 display. I can find in your description only the wiring diagram for the Display with the following pins:
    D/C (A0),
    CLK/SCK,
    DIN/SDA
    CS
    GND
    BL
    VCC
    RST pins

But my display 3.2 TFT SPI 240x320 ILI9341 has another pins:
    SDO(MISO)
    LED
    SCK
    SDI(MOSI)
    DC
    RESET
    CS
    GND
    VCC
Can you please advise the wiring diagram for this variant to ESP32 device according to the actual .ino sketch?

Should I change any variables in your .ino sketch to adopt my ILI9341? If yes, which file and which lines in it?

Perhaps my questions are stupid, but I cannot find this information in project files.

Thanks a lot for your help and support!

Derek-K, 2021-07-02:
I have ILI9341 connected to ESP8266 (not ESP32) You might want to take a look at [ESP32-Radio](https://github.com/Edzelf/ESP32-Radio) project and get help from there.

But I can share some of my experience here...
Pin D/C(A0) = DC
Pin BL, That's the backlight, usually, you can just connect to 3.3V
Pin SDI(MOSI) = DIN/SDA
Pin SDO(MOSI), totally optional, not needed for TFT operation

But you will also need to use the correct TFT LCD library. The easiest approach is to use TFT_eSPI, with very minimal change to the original code.

Thread 180 (2019-12-14):

Radio changes channels

clparrish, 2019-12-14:
How can I prevent my ESP-radio from changing channels on it's own?

Edzelf, 2019-12-14:
The radio changes channels if there is no stream input for a number of seconds.  You may switch off the counter for this feature.

clparrish, 2019-12-14:
Thanks for the explanation.

Closed 2019-12-14.

Thread 182 (2020-02-02):

How to connect to WiFi with "#" in password?

doeschwo, 2020-02-02:
Hi,

any chance to connect to a wlan with "'#" in the password? It seems like the hash is interpreted as a comment, so everything after in the password is cropped.

If there will be a way, it would be nice to get it in simple words. I have no experience in programming...

Tanks for your great work so far!

doeschwo

doeschwo, 2020-02-04:
Hi,

with ESP32-Radio it works, so i have build my radio with an ESP32-Board.

Greets

doeschwo

Closed 2020-02-04.

Thread 183 (2020-02-08):

Can you help me working this stream-adresse?

diwo13, 2020-02-08:
Hello

I tried unsuccessfully to get this stream going.

www.radiokoeln.de/service/radioplayer.html?radiochannel=hsg-karneval

Can somebody help me with it?

Thank you

Edzelf, 2020-02-08:
Try: radiokoeln-live.cast.addradio.de/radiokoeln/live/mp3/high?ar-distributor=f0b7

diwo13, 2020-02-08:
Thanks

Unfortunately that doesn't work

Edzelf, 2020-02-12:
It does work on the ESP32 version of the radio.

diwo13, 2020-02-16:
Not on my 8266 Version. :-(

I think i have to build a esp32 Version.

Thank you for your help

Thread 186 (2020-03-30):

Bluetooth module instead of VS1053

dagisr, 2020-03-30:
Could it be possible to replace VS1053 with some bluetooth module to play radio wireless using a BT-speaker. How?

Edzelf, 2020-03-30:
Without software changes you may connect a bluetooth audio transmitter to the VS1053.

dagisr, 2020-04-07:
Thank you.
How do you do that. Which BT module please

Edzelf, 2020-04-07:
Use one like [this](https://www.aliexpress.com/item/4000411307894.html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,searchweb201602_,searchweb201603_) and plug it into the VS1053.

dagisr, 2020-04-16:
yes of course! but
how to do it replacing VS1053.
in other words - feeding a BT module direct digitally from maybe esp32

Edzelf, 2020-04-16:
That's not possible with the current software.

Thread 188 (2020-04-24):

Esp radio stops and changes channel every 25 minutes

pinkobalinko, 2020-04-24:
Hello!
Thanks for your great work on this project. And above all on support offered!
I made this project on NodeMCU v3 (esp-12F). Works like intended, except for similar situation than [here](https://github.com/Edzelf/Esp-radio/issues/110).
No matter what channel, radio stops and skips to next channel after exactly 25 minutes (1500 seconds).  Now, this may be network issue, but went unnoticed till now on other devices - radio keeps playing on other devices without interruptions.
If I manually switch channels the 25 minutes counter resets.
Could it be that built in watchdog is to sensitive? How do I disable it?

pinkobalinko, 2020-04-25:
The more I look into this, the more I think it's because of lag.
My ESP radio apparently plays a little bit slower. You can't notice while listening, it's maybe 3% slower, around 2 seconds per minute. That means, after 20 minutes, lag is 40 seconds already. And that 40 seconds of stream have to be stored in buffer, right?

Edzelf, 2020-04-25:
Strange.  Looks like the clock frequency of the VS1053 is to low.  Could you try a spare VS1053?

pinkobalinko, 2020-04-25:
Thanks for answer. I thought that, too. Tried another VS1053, same result, but spare module is from the same "bunch" and they both might be faulty.
I'll try a different one that I have. I'll report.

pinkobalinko, 2020-04-25:
Well, for now looks like I have bad luck with VS1053. The different one I can't get to work, but I noticed  that frequency written on crystal on the non working VS is slightly higher than on other two (those that play to slow) - 12.288 MHz vs. 12.000 MHz.
VS1053 datasheet states input clock frequency from 12 MHz to 13 MHz. According to [this](http://www.vsdsp-forum.com/phpbb/viewtopic.php?t=481) post, stream with 44 kHz sampling rate should play fine on 12 MHz crystal, while stream with 48 kHz sampling rate would play slower.
Looks like I have to order new VS1053. In meantime I might swap crystal from one VS1053 to another.

pinkobalinko, 2020-04-26:
OK, I managed to get to work the other VS1053 (the one with 12.288 MHz - MOSI and MISO were mislabeled) and now radio works as it should. Looks like we have to be careful when ordering VS1053s.
My question is: can I still use 12 MHz VS1053 somehow or are they only waste bin material?
Note: I edited title of the theme.

Edzelf, 2020-04-26:
The difference between 12.288 and 12.000 explains the 3 percent difference in playing speed.  Maybe you can replace the xtal with the right one.  This will cost you 10 dollarcent or so.  Chinese manufacturers tend to replace components with ones that are "just as good as the original".

pinkobalinko, 2020-04-26:
I'll certainly try that.
I'll also order some new vs1053 modules, but you can never know which you get, since click freq is usually not specified and picture is not always accurate.
Thanks again for your work and for putting me on the right track in solving this problem.

pinkobalinko, 2020-04-28:
I might have found the solution.
VS1053 datasheet states clock frequency from 12 MHz to 13 Mhz - typical is 12.288 which is right for 48 kHz sampling. I was thinking, if xtali frequency can be different but it affects playing speed, the data about that frequency must be written somewhere in VS1053 registry so player can compensate.
So I looked into [datasheet](http://www.vlsi.fi/fileadmin/datasheets/vs1003.pdf) and found that this data is written in SCI_CLOCKF registry on the address 0x3. And, luckily, there is example of calculating value for 12 MHz xtali:

> Example: If SCI_CLOCKF is 0x9BE8, SC_MULT = 4, SC_ADD = 3 and SC_FREQ = 0x3E8 = 1000.
This means that XTALI = 1000 × 4000 + 8000000 = 12 MHz. The clock multiplier is set to
3.0×XTALI = 36 MHz, and the maximum allowed multiplier that the firmware may automatically
choose to use is (3.0 + 1.5)×XTALI = 54 MHz.

So I modified line 599 from
`write_register ( SCI_CLOCKF, 6 << 12 ) ;`
to
`write_register ( SCI_CLOCKF, 0x9BE8 ) ;`

Radio works now correctly with 12 MHz VS1053. At least for mp3 with 44 kHz sampling rate.

Edzelf, 2020-04-28:
Yes, great!

pinkobalinko, 2020-04-28:
I will still try to find solution for AAC which is now not working.

Edzelf, 2020-04-28:
If you have a VS1003, it will not work.

pinkobalinko, 2020-04-28:
And it doesn't work. Well in fact I have VS1003 and all the time I thought I have VS1053 :rofl: But chip is in fact VS1003b.
And according to VS1053 datasheet, the right number for 12 MHz VS1053 is 0x8BE8.

Thread 189 (2020-05-20):

SPI fast error

drunagr, 2020-05-20:
dear Ed
i made a simple version without a screen and i got this error message, can you help?
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

drunagr, 2020-05-20:
when i connect the speakers i got only the FAST SPI:
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
this is the connections :
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

h1aji, 2022-02-07:
@drunagr connect XRST pin to EN pin on esp8266 directly instead of 8k2 resistor. That diagram doesnt seem to be right

Thread 191 (2020-09-27):

Only 2 sample stations are working

zoltanszalontay, 2020-09-27:
Hi, great project!

I put together a Wemos D1 mini + VS1053 based minimal (headless) config following the 8th page of your PDF. I used your sample station presets, but only highlighted stations 0 and 7, NAXI and GAIA, are streaming. For all others, I get "Request failed" and "No data input" errors and the ESP8266 skips for the next station.

I am using the latest build. Installed yesterday.

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

According to the log, all other stations send no data:

> 17:42:32.163 -> D: New preset/file requested (1/0) from us2.internet-radio.com:8050
17:42:32.201 -> D: Connect to new host us2.internet-radio.com:8050
17:42:32.201 -> D: Connect to us2.internet-radio.com on port 8050, extension /
17:42:41.486 -> D: No data input
17:42:41.486 -> D: Trying other station/file...
17:42:42.485 -> D: Request us2.internet-radio.com:8050 failed!
17:42:42.485 -> D: STOP requested
17:42:42.519 -> D: Song stopped correctly after 0 msec
17:42:43.170 -> D: New preset/file requested (2/0) from airspectrum.cdnstream1.com:8000/1261_192
17:42:43.170 -> D: Connect to new host airspectrum.cdnstream1.com:8000/1261_192
17:42:43.203 -> D: Connect to airspectrum.cdnstream1.com on port 8000, extension /1261_192
17:42:51.502 -> D: No data input
17:42:51.502 -> D: Trying other station/file...
17:42:53.469 -> D: Request airspectrum.cdnstream1.com:8000/1261_192 failed!
17:42:53.469 -> D: STOP requested
17:42:53.502 -> D: Song stopped correctly after 0 msec
17:42:54.169 -> D: New preset/file requested (3/0) from airspectrum.cdnstream1.com:8008/1604_128

Any help would be appreciated!

Thanks!
Z

Edzelf, 2020-09-27:
I do not know which stations are still up and runnning, but "icecast.omroep.nl:80/radio1-bb-mp3" should work.  You can test if a station is still up by testing it in your Internet browser or by Winamp.

zoltanszalontay, 2020-09-29:
Hi, that one and NAXI plus Gaia from the default radio.ini are working. However, all of my own URL-s fail.

Examples: Klub Radio, Hungary. 3 official URL-s. All fail.

preset = 0 # Start with preset 0
preset_00 = stream.klubradio.hu:8080/bpstream			# 2 - Klub Rádió 96kbps
preset_01 = stream.klubradio.hu:8080/source			# 3 - Klub Rádió 96kbps
preset_02 = stream.klubradio.hu:8080/32kbit			# 4 - Klub Rádió 32kbps

Log:
10:48:43.752 -> D: New preset/file requested (0/0) from stream.klubradio.hu:8080/source
10:48:43.752 -> D: Connect to new host stream.klubradio.hu:8080/source
10:48:43.793 -> D: Connect to stream.klubradio.hu on port 8080, extension /source
10:48:54.064 -> D: Request stream.klubradio.hu:8080/source failed!
10:49:01.612 -> D: No data input

Chrome plays all of them well. Any idea?

zoltanszalontay, 2020-09-29:
I also tried a lot of other Hungarian URL-s from here.
[https://github.com/gyarakilaszlo/Radiotray-hu/blob/master/.local/share/radiotray/bookmarks.xml](url)
Winamp gives the same URL, Chrome plays them well. Esp-radio says "No data" for these URL-s.

Edzelf, 2020-09-29:
Are you sure you have the right chip in the VS1053 module?
is "icecast.omroep.nl:80/radio1-bb-mp3" working?

zoltanszalontay, 2020-09-29:
Nope :-(
> 14:23:45.653 -> D: Request icecast.omroep.nl:80/radio1-bb-mp3 failed!
> 14:23:54.428 -> D: No data input

Again, some streams, e.g. "205.164.62.15:10032" are working.

The decoder chip is VS1053B. The PCB looks exactly like the one in your PDF, but green.

zoltanszalontay, 2020-09-29:
I just recognized that the URL you gave me is identical to the one you gave yesterday. It played yesterday, but not today. Weird.

Edzelf, 2020-09-29:
Strange.  Can you try another WiFi network in the neighbourhood?

zoltanszalontay, 2020-09-29:
Sure, I can check that in the evening. Until then, I found that

> if ( mp3client->connect ( hostwoext.c_str(), port ) )

in connecttohost() returns 0, even though it splits the URL well:
> Connect to icecast.omroep.nl on port 80, extension /radio1-bb-mp3

My wifi should be fine, anyway as a web browser plays this URL well, but anyhow, I'll check it with another.

zoltanszalontay, 2020-09-30:
Well, I connected to my iPhone's hotspot and all station started streaming immediately! Great find!

I just can't imagine what my Asus wifi router filters out. Firewall is enabled, but URL filter, keyword filter and network services aren't.

Never had any problems with accessing any URL-s. And I can stream those stations from a browser on this wifi network.

zoltanszalontay, 2020-10-01:
A got a bit further. DNS name resolution is not working when using my home wifi network. Only stations with IP addresses, like NAXI or GAIA radio work.

However, when connecting to my iPhone's hotspot, name resolution is working.

About my config: DHCP Server is my wifi router. DNS is set to the IP of my Synology NAS, which forwards all requests to 8.8.8.8 (Google). When I use iPhone hotspot, the DNS is external (172.20.10.1).

I suspect this problem is related to LWIP's DNS forwarding, but still investigating.

Edzelf, 2020-10-02:
Glad you found the cause.  Maybe the DNS request takes to long going through the NAS software (ad blocking?).

zoltanszalontay, 2020-10-02:
I'll check the timestamp of the name resolution. Also, I am going to set 8.8.8.8 in my DHCP scope. I'll lose the ability to access my local computers by names as I do not use WINS, but that's not a problem. No ad blocking takes place on the server side. My last tip would have been WIFI_STA mode, but that's being used.

Until then, I use IP addresses.

Great piece of software! Thanks!

P.S.: You may close this issue as it is up to the IP stack or my network config. Thx

zoltanszalontay, 2020-10-02:
Got it!

Setting a public DNS Server (e.g. 8.8.8.8) on my router's DHCP scope solved the problem so it was the DNS forwarding initiated by my Synology NAS.

Closed 2020-10-02.

Thread 192 (2020-10-12):

Connect to internet radio stream - Radio Nowy Świat

macwojs, 2020-10-12:
Hello
I tried to connect to this radio station: https://nowyswiat.online/gdzie-nas-slychac/
I tried with http and https connection:

- http - stream.rcs.revma.com:80/ypqt40u0x1zuv

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

- https - stream.nowyswiat.online:443/mp3

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

I must use another url or what?

I use D1 mini with esp8266 and preset radio station mostly work fine.

Edzelf, 2020-10-13:
Try: "stream.rcs.revma.com/ypqt40u0x1zuv" without "http://"
Request to stream.nowyswiat.online/mp3 are redirected to:
Location: https://stream.rcs.revma.com/ypqt40u0x1zuv
HTTPS is not supported by the radio, but since http://stream.rcs.revma.com/ypqt40u0x1zuv also works, you can use
"stream.rcs.revma.com/ypqt40u0x1zuv"

macwojs, 2020-10-13:
I tried and still can't connect to radio:

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

Maybe it's problem with ESP3266 version as here: https://github.com/Edzelf/Esp-radio/issues/183. You use ESP32? If this is the issue then I need to buy ESP32.

Edzelf, 2020-10-13:
Maybe the key "ypqt40u0x1zuv" changes for every session.  AT this moment it still works for me.
Try to get the right location (in the logging) by connecting to "stream.nowyswiat.online/mp3"

macwojs, 2020-10-13:
The same:

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

Edzelf, 2020-10-13:
I tested it on the ESP32 version of the radio.  I am not sure if chunked transfer is supported on the ESP8266 version.

macwojs, 2020-10-13:
Okej, so I'm waiting for my esp32 and then I get it I will send update about this issue

Edzelf, 2020-10-13:
I just test this on my ESP8266 radio.  Same result: connaction oka, but chunked stream can not be decoded.

Dubik12, 2021-02-17:
> Maybe the key "ypqt40u0x1zuv" changes for every session. AT this moment it still works for me.
> Try to get the right location (in the logging) by connecting to "stream.nowyswiat.online/mp3"

Not this key does not change. The end of the address is changed, and the server number is changed (at the beginning of the HTTP address). For example:
http://n14a-eu.rcs.revma.com/ypqt40u0x1zuv?rj-ttl=5&rj-tok=AAABd7E0lvsAjObIsY8Nc-MKtA
 I try to use the command on your Radio:
//-----------------------------------------------
const char* headerNames[] = { "Location" };

    String Location;

HTTPClient http;
http.begin(URL);
    http.collectHeaders(headerNames, sizeof(headerNames)/sizeof(headerNames[0]));

    int httpCode = http.GET();
Serial.print (httpCode);
 if (httpCode == 302)
    {
     Serial.println("following redirect");
    Location = http.header("Location");
 Serial.print ("LOCATION   "); Serial.println (Location);
 char url[100];
int  pos = Location.length();
 Serial.print("Location.length()  ");    Serial.println (pos);
  Location.substring(0, pos).toCharArray(url, pos+1);
  Serial.println (url);
     }

//---------------------------------------------
They are located after WiFi "connect lines" &
" file = new AudioFileSourceICYStream(url);
  file->RegisterMetadataCB(MDCallback, (void*)"ICY");"
The answer is a valid link, but it has already expired. or maybe a future link.
Can You help? This is the only way to listen to this radio

Closed 2020-10-19.

Thread 193 (2021-01-15):

Synchronized / synchronous playback on multiple ESP radios?

Wookbert, 2021-01-15:
NOOB question: I want to listen to the same internet radio stations in several rooms of my apartment (bath, kitchen, dining room etc.). I see two possible paths:

**Path A – A single ESP radio receiver with multiple Bluetooth 5.0 transmitters** attached to the analogue audio output of the VS1053. BT range is a certain issue here.
What I don't like in this setup is the fact that the audio signal goes Digital->Analogue->Digital->Analogue  (ESP->VS1053->BT TX->BT RX).

**Path B – Several parallel ESP radios**, one in each room.

The big question regarding path B: Is it possible to have the four or five ESP radios play totally synchronous, using e.g. an internet time server and some sort of time code/stamp? If yes, how exactly.

Thanks in advance!

Edzelf, 2021-01-15:
I don't think it is possible to synchronize two internet radios.

Wookbert, 2021-01-15:
I guess I'm not alone when it comes to the need for affordable (wireless) multi-room radio.

A totally naive idea/suggestion: Couldn't you – time and interest given – develop an ESP Radio Server which receives the stream, adds some sort of time code on top and rebroadcasts to ESP Radio Clients, whereas Server and Clients have synchronized clocks?

Perhaps one can inspect or implement code from other [multi-room projects](https://github.com/topics/multiroom-audio), e.g. [SnapCast](https://github.com/badaix/snapcast).

Having a single ESP32-based server and multiple, super low cost  EPS8266-based clients is really appealing.

Thread 196 (2021-01-24):

Adafruit_I2CDevice.h and Adafruit_SPIDevice.h missing

newbee90, 2021-01-24:
hello,
I have Arduiono1.8.13 installed as a portable version, to have a clean version
and esp8266 community vers 2.2.0
and all the libraries I found in Esp_radio.ino
now I get this error message
libraries\Adafruit-GFX-Library\Adafruit_GrayOLED.h:30:32: fatal error: Adafruit_I2CDevice.h: No such file or directory
and after if I cange the entry in Adafruit_GrayOLED.h to //#include <Adafruit_I2CDevice.h>
libraries\Adafruit-GFX-Library\Adafruit_GrayOLED.h:31:32: fatal error: Adafruit_SPIDevice.h: No such file or directory
is there a Esp_radio.bin which I could flash with NodeMCU-PyFlasher?

Edzelf, 2021-01-24:
I have uploaded the sketch in binary format to the bin directory.

newbee90, 2021-01-25:
thank you

newbee90, 2021-01-25:
I have no sound, I can see Artist and Title information at the webside, so the radio work
I have checked the wiring several times, but all is correct
is your bin file with tft or without tft?

Edzelf, 2021-01-25:
Show the logging at the serial port.

newbee90, 2021-01-25:
23:55:18.081 -> D: Slow SPI,Testing VS1053 read/write registers...
23:55:18.081 -> D: VS1053 error retry SB:012C R1:0000 R2:0000
23:55:18.081 -> D: VS1053 error retry SB:0258 R1:0000 R2:0000
23:55:18.128 -> D: VS1053 error retry SB:0384 R1:0000 R2:0000
23:55:18.128 -> D: VS1053 error retry SB:04B0 R1:0000 R2:0000
23:55:18.128 -> D: VS1053 error retry SB:05DC R1:0000 R2:0000
23:55:18.181 -> D: VS1053 error retry SB:0708 R1:0000 R2:0000
23:55:18.181 -> D: VS1053 error retry SB:0834 R1:0000 R2:0000
23:55:18.181 -> D: VS1053 error retry SB:0960 R1:0000 R2:0000
23:55:18.181 -> D: VS1053 error retry SB:0A8C R1:0000 R2:0000
23:55:18.228 -> D: VS1053 error retry SB:0BB8 R1:0000 R2:0000
23:55:18.228 -> D: VS1053 error retry SB:0CE4 R1:0000 R2:0000
23:55:18.228 -> D: VS1053 error retry SB:0E10 R1:0000 R2:0000
23:55:18.281 -> D: VS1053 error retry SB:0F3C R1:0000 R2:0000
23:55:18.281 -> D: VS1053 error retry SB:1068 R1:0000 R2:0000
23:55:18.281 -> D: VS1053 error retry SB:1194 R1:0000 R2:0000
23:55:18.328 -> D: VS1053 error retry SB:12C0 R1:0000 R2:0000
23:55:18.328 -> D: VS1053 error retry SB:13EC R1:0000 R2:0000
23:55:18.328 -> D: VS1053 error retry SB:1518 R1:0000 R2:0000
23:55:18.381 -> D: VS1053 error retry SB:1644 R1:0000 R2:0000
23:55:18.381 -> D: VS1053 error retry SB:1770 R1:0000 R2:0000
23:55:18.482 -> D: Fast SPI, Testing VS1053 read/write registers again...
23:55:18.529 -> D: VS1053 error retry SB:0003 R1:0000 R2:0000
23:55:18.529 -> D: VS1053 error retry SB:0006 R1:0000 R2:0000
23:55:18.529 -> D: VS1053 error retry SB:0009 R1:0000 R2:0000
23:55:18.582 -> D: VS1053 error retry SB:000C R1:0000 R2:0000
23:55:18.582 -> D: VS1053 error retry SB:000F R1:0000 R2:0000
23:55:18.582 -> D: VS1053 error retry SB:0012 R1:0000 R2:0000
23:55:18.582 -> D: VS1053 error retry SB:0015 R1:0000 R2:0000
23:55:18.629 -> D: VS1053 error retry SB:0018 R1:0000 R2:0000
23:55:18.629 -> D: VS1053 error retry SB:001B R1:0000 R2:0000
23:55:18.629 -> D: VS1053 error retry SB:001E R1:0000 R2:0000
23:55:18.682 -> D: VS1053 error retry SB:0021 R1:0000 R2:0000
23:55:18.682 -> D: VS1053 error retry SB:0024 R1:0000 R2:0000
23:55:18.682 -> D: VS1053 error retry SB:0027 R1:0000 R2:0000
23:55:18.729 -> D: VS1053 error retry SB:002A R1:0000 R2:0000
23:55:18.729 -> D: VS1053 error retry SB:002D R1:0000 R2:0000
23:55:18.729 -> D: VS1053 error retry SB:0030 R1:0000 R2:0000
23:55:18.783 -> D: VS1053 error retry SB:0033 R1:0000 R2:0000
23:55:18.783 -> D: VS1053 error retry SB:0036 R1:0000 R2:0000
23:55:18.783 -> D: VS1053 error retry SB:0039 R1:0000 R2:0000
23:55:18.783 -> D: VS1053 error retry SB:003C R1:0000 R2:0000
23:55:18.829 -> D: endFillByte is 0
23:55:19.986 -> D: Selected network: FRITZBox7490     
23:55:19.986 -> D: Try WiFi FRITZBox7490
23:55:23.072 -> D: IP = 192.168.178.41
23:55:23.125 -> D: Start server for commands
23:55:23.125 -> D: Connecting to MQTT broker.hivemq.com, port 1883, user none, password none...
23:55:23.373 -> D: MQTT Connected to the broker broker.hivemq.com, session is not present
23:55:23.373 -> D: Subscribing to espradio at QoS 2, packetId = 1
23:55:23.373 -> D: Publishing IP 192.168.178.41 to topic espradioIP
23:55:23.426 -> D: MQTT Subscribe acknowledged, packetId = 1, QoS = 2
23:55:23.426 -> D: MQTT Publish acknowledged, packetId = 2
23:55:24.128 -> D: BASS settings is 0000
23:55:24.128 -> D: STOP requested
23:55:24.175 -> D: Song stopped correctly after 0 msec
23:55:24.830 -> D: New preset/file requested (-1/0) from
23:55:24.877 -> D: New preset/file requested (-1/0) from webstream.radio-bamberg.de/radio-bamberg.mp3
23:55:24.877 -> D: Connect to new host webstream.radio-bamberg.de/radio-bamberg.mp3
23:55:24.877 -> D: Connect to webstream.radio-bamberg.de on port 80, extension /radio-bamberg.mp3
23:55:25.023 -> D: Connected to server
23:55:25.209 -> D: Switch to HEADER

Edzelf, 2021-01-25:
All those VS1053 errors shows that there is a (wiring) problem withe the SPI bus.

newbee90, 2021-01-25:
https://ibb.co/R7fcCDG
https://ibb.co/b2T91t9
I made it new, same problem

Edzelf, 2021-01-26:
Wiring looks good.  Check if the chip on the MP3 board is really an VS1053.
Check if the reset pin of the VS1053 board is high.
It should also work without the diodes.

newbee90, 2021-01-26:
now I have remove the diodes and connected reset to vss, now I have sound but with many breaks, like very old CD
https://ibb.co/wsKfR8Y it is an VS1053

Thread 197 (2021-02-16):

Split content with 2.42 OLED Display

martix90, 2021-02-16:
Hi,
I really like this very cool project and want to build my own WebRadio.

I would like to use a 2.42 OLED display that I have around. This uses an SSD1309 Chip, which (according to most Docu) is almost identical to the SSD1306. But when I configured this project to use the OLED display, the image is split in half and the left side is right and the right side is left (see image).
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

If I use an example sketch with u8g2 the display works just fine.

Is there any idea what could cause this issue? Or is this type of display simply not supported? I think there's not much missing for it to work correctly...

Edzelf, 2021-02-17:
You need to modify the constructor and the init call on line 23 and 36 of "oled.h". It is now:
U8G2_SSD1306_128X64_NONAME_1_SW_I2C
And it should be the one for 1309.  See [https://github.com/olikraus/u8g2/wiki/u8g2setupcpp](https://github.com/olikraus/u8g2/wiki/u8g2setupcpp).
For example:
U8G2_SSD1309_128X64_NONAME2_1_SW_I2C

martix90, 2021-02-17:
Hi @Edzelf, first thank you very much for your answer. I just noticed I'm in the wrong project with my question (I'm using an ESP32) - but I think you already noticed - reading your answer :)

To be honest, I don't quite understand it yet. If "OLED" is defined, the file SSD1306.h is included. Here, oled.h is never used. If I instead include oled.h (where I have changed the two lines of your comment), it doesn't compile since oled.h does not have all the required functions (like for example displayvolume() ).
I think I did not understand something correct here :(

Edzelf, 2021-02-17:
You are right.
If you uncomment the #define OLEd in line 178 o main.cpp and comment the line with BLUETFT.
Then SSD1306.h is included.
The file oled.h is not in use anymore.
The driver for the SSD1306 is not quite compatible with the 1309.
I will try to fix that later.

martix90, 2021-02-17:
Thank you very much!

Edzelf, 2021-02-19:
Try the new version.  I did not test it, because I don't have the right module.
3 models are available:
```
//#define OLED1306                     // 64x128 I2C OLED SSD1306
//#define OLED1309                     // 64x128 I2C OLED SSD1309
//#define OLED1106                     // 64x128 I2C OLED SH1106
```

martix90, 2021-02-20:
Wow - I'm really impressed with how fast you did the refactoring of the oled drivers. I will try it as soon as possible :) Thank you so much!

martix90, 2021-02-20:
Hi @Edzelf, I've just tested it. It's a lot better but not yet quite right. The lines seem to start at different columns Maybe an off-by-one error?

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

Edzelf, 2021-02-20:
Did you try all 3 models?  Please give me the exact type of the display.  Maybe I can find a hint in the datasheet.Vriendelijke groeten,Ed.

-------- Oorspronkelijk bericht --------
Van: martix90 <notifications@github.com>
Datum: 20-02-21  10:56  (GMT+01:00)
Aan: Edzelf/Esp-radio <Esp-radio@noreply.github.com>
Cc: Ed Smallenburg <ed@smallenburg.nl>, Mention <mention@noreply.github.com>
Onderwerp: Re: [Edzelf/Esp-radio] Split content with 2.42 OLED Display (#197)

Hi @Edzelf, I've just tested it. It's a lot better but not yet quite right. The lines seem to start at different columns Maybe an off-by-one error?

—You are receiving this because you were mentioned.Reply to this email directly, view it on GitHub, or unsubscribe.
[
{
"@context": "http://schema.org",
"@type": "EmailMessage",
"potentialAction": {
"@type": "ViewAction",
"target": "https://github.com/Edzelf/Esp-radio/issues/197#issuecomment-782598065",
"url": "https://github.com/Edzelf/Esp-radio/issues/197#issuecomment-782598065",
"name": "View Issue"
},
"description": "View this Issue on GitHub",
"publisher": {
"@type": "Organization",
"name": "GitHub",
"url": "https://github.com"
}
}
]

martix90, 2021-02-20:
Hi Ed, I now tried all three models (OLED1306, OLED1309 and OLED1106).
All of them behave exactly the same.

The model I use is called "DIY MORE" and says on the back "2,42' OLED, SSD1309", here's a links:
https://www.diymore.cc/products/2-42-inch-12864-oled-display-module-iic-i2c-spi-serial-for-arduino-c51-stm32-green-white-blue-yellow

Thank you and greetings from Germany
Martin

martix90, 2021-02-24:
I think I found the issue:
If I comment out  this line, it works :)

//i2c_master_write ( i2Cchan, fillbuf, 4, true ) ;      // Yes, fill extra RAM with zeroes

Edzelf, 2021-02-24:
Great!

Thread 198 (2021-02-28):

Ols SSID in list

ilioss, 2021-02-28:
Hi Ed,

Long time no see.
Last half a year I moved to un other house.
So the old SSID has to be changed.
My new router is Ziggo connection box.
If I changed the old SSID name and password in the pref. file.
It will not connect to the wifi???
The serial monitor still mention that the old SSID is added to the list of networks.
Connect to WiFi     ( the new SSID/password in the pref.file)
WiFi failed!  Trying .....

The resent not connect issue ZI tried but no result.
BTW in the PlatformIO the project is compiled and uploaded ( proof by turning the display ) must be corrected.
But it also complained that the include is missing?
Any cloe about this issues.
I preferably like to use the radio again while Ziggo is hopeless with his radio.
And I will use platformIO
Like to hear.
Kind regards Theo

Edzelf, 2021-02-28:
Try to connect to the wifi access point that is available if the radio cannot connect to the network.  Then goto 192.168.4.1 and add your ziggo credentials to the config page of the web interface.

ilioss, 2021-02-28:
Hallo Ed,Top bedankt.Werkt weer als een jekko.Btw om mijn opzet wat degelijker te maken een nakedninje pcb besteld.Hoewel de radio zoals hij is door de jaren heen weer iets heeft van waarom veranderen.Nog steeds erg onder de indruk.Met vriendelijke groet,Theo Op 28 feb. 2021 12:40 schreef Ed Smallenburg <notifications@github.com>:
Try to connect to the wifi access point that is available if the radio cannot connect to the network.  Then goto 192.168.4.1 and add your ziggo credentials to the config page of the web interface.

—You are receiving this because you authored the thread.Reply to this email directly, view it on GitHub, or unsubscribe.

Thread 199 (2021-03-02):

Has anyone uploaded the sketch wirelessly using OTA? Is you did, how did you do it? I can;t get to work.

wa8lbz, 2021-03-02:

Edzelf, 2021-03-02:
First you have to upload a sketch that is able to handle OTA.  Then you can specilfy OTA as upload method to upload a new sketch that can also handle OTA.

Derek-K, 2021-07-02:
Assume you are using Arduino IDE.

The very first time, you need to flash via USB (unless you already have OTA firmware installed on your ESP8266).

From that point on, assume your computer is on the same network as your ESP-Radio. Under Arduino IDE, go to Tools -> Port: xxxxx  Select ESP-radio at xxx.xxx.xxx.xxx. (Note, serial monitor no longer works. Use another terminal software instead, e.g. Putty). upload the code as usual, it will upload Over-the-Air.

Thread 200 (2021-04-12):

Reset Circuit with 2 Diodes not working with VS1053b?

HoerMirAuf, 2021-04-12:
First, thank you for this great Project.

I build my WebRadio without Display and 3 Button usage on GPIO2, GPIO15, GPIO0
The both Diodes from VS1053B-Reset to GND Result to a not working VS1053b

Set the VS1053b-Reset up to 5V by a 10K Resistor an all working well.

Is this a bug in the circuit? Or why this not working if the Diodes connected to GND?

Derek-K, 2021-07-02:
Check your wiring again. XRST with 1k pull down to GND, and the two diodes connect to GPIO 16 & GPIO 5.

The diodes acted as OR gate. During normal operations, XCS and/or XDCS will be high, so XRST will always high. The only time goes low is when XCS & XDCS goes low during init (line 575-577)

https://github.com/Edzelf/Esp-radio/blob/56e57fcaece56d0447246fa4f6be938c7ae0bb09/Esp_radio.ino#L575-L577

BTW, if I am not mistaken VS1053B is a 3.3V part, pull up to 5V might damage it in the long run.

Thread 201 (2021-04-15):

http://streams.br.de/bayern3_2.m3u funktioniert nicht mehr

erich140, 2021-04-15:
in einer version vom letzten jahr geht es noch.

Edzelf, 2021-04-16:
Try br-br3-live.cast.addradio.de/br/br3/live/mp3/mid

erich140, 2021-04-16:
Thank you for your quick answer.

I know it work with this addr. br-br3-live.cast.addradio.de/br/br3/live/mp3/.

But my Question is why the addr. http://streams.br.de/bayern3_2.m3u not working anymore.

When i compile and load a old version than the addr. works.

Regards

Erich

Edzelf, 2021-04-16:
You have to debug the part that parses the playlists.

Thread 202 (2021-05-12):

Migrate to Platformio

h1aji, 2021-05-12:
Hi @Edzelf are you planning to migrate this code platformio? Same you did for esp32-radio?
Thanks

Edzelf, 2021-05-12:
No, but it should not be too difficult to do this.  I guess it is just a matter of renaming the sketch and add a line to include "arduino.h".

h1aji, 2021-05-15:
Thanks for your reply. Just created for with Platformio here - https://github.com/h1aji/Esp-radio.
Replaced digital buttons control with Infra-red
I want to replace ILI9361 with LCD 2004 now, any help welcome

Closed 2021-08-04.

Thread 203 (2021-05-12):

Newbie needing help with TFT colours and fonts

rjmusto, 2021-05-12:
Hi all,
Firstly a big thanks to Ed for sharing all his hard work on this Internet radio. Amazing stuff.

I have got mine up and running and am using an ST7735 1.8" display, and am very happy to have got it working.

As there is plenty of room on the display, I would really like to make the font bigger and maybe add some background colours, but can't work out how to do this (not new to Arduino code but certainly no expert...). I've seen the;

"#define dsp_setTextSize(a)      tft->setTextSize(a)                // Set the text size"

line in the bluetft.h tab, but am not sure what to do with it.   I've read about setTextSize(1) and setTextSize(2), but no idea how the (a) in this example relates to that.

And as for background colours.... no idea where to start.

Any help much appreciated.

Thanks,
Ralph

Edzelf, 2021-05-13:
dsp_setText is just a macro.  The goal is to make a function "dsp_setText()" that will work on all included display drivers.
So if you want to change the size, look for calls of "dsp_setText" in the main program.
For colours, look for "BLACK" or "RED" or "YELLOW" in the main program.

rjmusto, 2021-05-15:
Hi Ed,
Many thanks for the reply, much appreciated.

My main interest was to make the text in the middle block that displays the station being played a bit bigger - helps with my ageing eysight.....

Thanks for the hints - I am gradually developing a better understanding of the sketch structure, so will work away on that.

BR,
Ralph

Derek-K, 2021-07-02:
I have successfully replaced the original AdadruitGFX & ILI9163C library with TFT_eSPI library with minimal modification and eventually redesigned the GUI.

Using TFT_eSPI will allow you to use many types of LCD (e.g. I am currently using a 320x240 ILI9341 with touch screen control)

h1aji, 2022-02-07:
@Derek-K would you be able to share your code with TFT_eSPI? thanks

Derek-K, 2022-03-21:
@h1aji As far as I remember, just load the TFT_eSPI library, and if there are any changes, it will be very minor.

h1aji, 2022-03-24:
@Derek-K Figured out, easy. Thanks

Thread 204 (2021-05-13):

another compilation problem

stefan12O, 2021-05-13:
Hello,
I am trying to compile Esp_radio, but I don't manage to. Hopefully someone can help or advice me.
I use Arduino IDE (1.8.13) an the error message(s) are as follows:
```
In file included from /home/stefan/Arduino/NodeMCU/Esp-radio-master/Esp_radio/Esp_radio.ino:2:0:
/home/stefan/.arduino15/packages/esp8266/hardware/esp8266/2.7.4/libraries/ESP8266WebServer/src/Parsing-impl.h:64:30: error: expected initializer before '<' token
 bool ESP8266WebServerTemplate<ServerType>::_parseRequest(ClientType& client) {
                              ^
/home/stefan/.arduino15/packages/esp8266/hardware/esp8266/2.7.4/libraries/ESP8266WebServer/src/Parsing-impl.h:266:30: error: expected initializer before '<' token
 bool ESP8266WebServerTemplate<ServerType>::_collectHeader(const char* headerName, const char* headerValue) {
                              ^
/home/stefan/.arduino15/packages/esp8266/hardware/esp8266/2.7.4/libraries/ESP8266WebServer/src/Parsing-impl.h: In member function 'void storeArgHandler<ServerType>::operator()(String&, String&, const String&, int, int, int, int)':
/home/stefan/.arduino15/packages/esp8266/hardware/esp8266/2.7.4/libraries/ESP8266WebServer/src/Parsing-impl.h:281:11: error: 'ESP8266WebServerTemplate' was not declared in this scope
     key = ESP8266WebServerTemplate<ServerType>::urlDecode(data.substring(pos, key_end_pos));

...

In file included from /home/stefan/.arduino15/packages/esp8266/hardware/esp8266/2.7.4/libraries/ESP8266WebServer/src/Parsing-impl.h:25:0,
                 from /home/stefan/Arduino/NodeMCU/Esp-radio-master/Esp_radio/Esp_radio.ino:2:
/home/stefan/.arduino15/packages/esp8266/hardware/esp8266/2.7.4/libraries/ESP8266WebServer/src/ESP8266WebServer.h:34:19: note: previous declaration 'HTTPMethod HTTP_ANY'
 enum HTTPMethod { HTTP_ANY, HTTP_GET, HTTP_HEAD, HTTP_POST, HTTP_PUT, HTTP_PATCH, HTTP_DELETE, HTTP_OPTIONS };
                   ^
Mehrere Bibliotheken wurden für "SPI.h" gefunden
 Benutzt: /home/stefan/.arduino15/packages/esp8266/hardware/esp8266/2.7.4/libraries/SPI
 Nicht benutzt: /home/stefan/Arduino/libraries/SPI
Mehrere Bibliotheken wurden für "WiFiServer.h" gefunden
 Benutzt: /home/stefan/.arduino15/packages/esp8266/hardware/esp8266/2.7.4/libraries/ESP8266WiFi
 Nicht benutzt: /home/stefan/Programme/arduino-1.8.13/libraries/WiFi
exit status 1
Fehler beim Kompilieren für das Board NodeMCU 1.0 (ESP-12E Module).
```
(if needed, i can add the complete thing, but all messages are regarding "expected initializer"

I did modify the file ESPAsyncTCP.cpp according to [this description](https://github.com/me-no-dev/ESPAsyncTCP/commit/c2d4c168d41b78d9abd71a074c80eb8087c33561) but it did not change a thing.

So, actually I am stuck on page 14 of the ESP-radio.pdf and did each step until
`Load the sketch. You should be able to compile it. `
but it doesn't.
I have no idea what is wrong, maybe someone can help ?

kind regards
Stefan

stefan12O, 2021-05-13:
sorry, forget this issue.
I did not realise, that there is ESP32-Radio.
I use it and everything works fine.

Closed 2021-05-13.

Thread 208 (2021-08-18):

Display with driver ST7735 V2. 0

samand587, 2021-08-18:
Hello! I collected the ESP8266 radio. Everything works perfectly! There is only a 1"44 128x128 TFT_LCD display with the ST7755 driver. What do I need to change to connect this display? Thanks!

Дисплей с драйвером ST7735 V2.0  Здравствуйте! Собрал радио ESP8266. Все работает отлично! В наличии только дисплей 1"44 128х128 TFT_LCD с драйвером ST7755. Что нужно изменить для подключения данного дисплея? Спасибо!

samand587, 2021-08-18:
I connected the display without changing the sketch. There is information on the display, but the entire image is shifted to the left and up by one pixel. How can this be fixed?

Подключил дисплей не меняя скетч. Информация на дисплее имеется, но все изображение сдвинуто влево и вверх на один пиксель. Как это можно исправить?

samand587, 2021-08-18:
Залил скетч от jgrulich.  Все встало на свои места! Вопросы сняты!

Closed 2021-08-28.

Thread 211 (2021-12-27):

Issues with radio station

ranger81, 2021-12-27:
Hi,
I cannot play the radio station with this URL:
http://st01.sslstream.dlf.de/dlf/01/high/aac/stream.aac?aggregator=web

Could you please help me?
Thanks

Edzelf, 2021-12-27:
Works correctly with ESP32-Radio V2, but not with the ESP8266 version.
The URL you mentioned is a redirect to (for example):
d131.rndfnk.com/ard/dlf/01/aac/192/stream.aac?aggregator=web&sid=22sGzDeUL92ipudJ6owb4d9oN77&token=RuS353Va9D2GWGj034xHa_00B7uGYYeMIFV_EMZDAAE&tvf=dWpsvw-6xBZkMTMxLnJuZGZuay5jb20

Redirect is not supported by the ESP8266 version of the radio.

ranger81, 2021-12-27:
Oh okay, however, thanks for the information.

Thread 213 (2022-02-27):

Stations with redirect will not work when SPIRAM enabled

h1aji, 2022-02-27:
Hi Ed,
I noticed that if SPIRAM enabled then stations with redirect wont work. Here is output

```
D: New preset/file requested (1/0) from n0d.radiojar.com/hcrb063nn3quv
D: Connect to new host n0d.radiojar.com/hcrb063nn3quv
D: Connect to n0d.radiojar.com on port 80, extension /hcrb063nn3quv
D: Connected to server
D: Switch to HEADER
D: Access-Control-Allow-Origin: *
D: No data input
D: No data input
D: Trying other station/file...
D: STOP requested
D: New preset/file requested (8/0) from stream.live.vc.bbcmedia.co.uk/bbc_world_service
```
Although ringbuf works perfectly fine

Edzelf, 2022-02-27:
Yes, I know.  That is because there is a delay (a number of input bytes).  The redirect info is less than that number and is therefore not handled.

h1aji, 2022-02-27:
Is there a quick way to fix it? Thanks

Also please see my version **spiram.cpp** without external library.

```
//******************************************************************************************
// SPI RAM routines.                                                                       *
//******************************************************************************************
// Use SPI RAM as a circular buffer with chunks of 32 bytes.                               *
//******************************************************************************************

#include <SPI.h>

#define SRAM_SIZE  131072                   // Total size SPI ram in bytes
#define CHUNKSIZE      32                   // Chunk size
#define SRAM_CH_SIZE 4096                   // Total size SPI ram in chunks

#define SRAM_CS        10                   // GPIO1O SRAM CS pin
#define SRAM_FREQ    16e6                   // The 23LC1024 supports theorically up to 20MHz

// SRAM opcodes
#define SRAM_READ    0x03
#define SRAM_WRITE   0x02

// Global variables
uint16_t   chcount ;                       // Number of chunks currently in buffer
uint32_t   readinx ;                       // Read index
uint32_t   writeinx ;                      // write index

uint32_t spiTransfer32 ( uint32_t data )
{
  union { uint32_t val; struct { uint16_t lsb; uint16_t msb; }; } in, out;
  in.val = data;
  out.msb = SPI.transfer16 ( in.msb ) ;
  out.lsb = SPI.transfer16 ( in.lsb ) ;
  return out.val;
}

void spiramWrite ( uint32_t addr, uint8_t *buff, uint32_t size )
{
  int i = 0;
  while ( size-- )
  {
      SPI.beginTransaction ( SPISettings ( SRAM_FREQ, MSBFIRST, SPI_MODE0 ) ) ;
      digitalWrite ( SRAM_CS, LOW ) ;
      spiTransfer32 ( (SRAM_WRITE<<24)|(addr++&0x00ffffff) ) ;   // Set write mode
      SPI.transfer ( buff[i++] ) ;
      digitalWrite ( SRAM_CS, HIGH ) ;
      SPI.endTransaction();
  }
}

void spiramRead ( uint32_t addr, uint8_t *buff, uint32_t size )
{
  int i = 0;
  while ( size-- )
  {
      SPI.beginTransaction ( SPISettings ( SRAM_FREQ, MSBFIRST, SPI_MODE0 ) ) ;
      digitalWrite ( SRAM_CS, LOW ) ;
      spiTransfer32 ( (SRAM_READ<<24)|(addr++&0x00ffffff) ) ;   // Set read mode
      buff[i++] = SPI.transfer ( 0x00 );
      digitalWrite ( SRAM_CS, HIGH ) ;
      SPI.endTransaction();
  }
}

//******************************************************************************************
//                              S P A C E A V A I L A B L E                                *
//******************************************************************************************
// Returns true if bufferspace is available.                                               *
//******************************************************************************************
bool spaceAvailable()
{
  return ( chcount < SRAM_CH_SIZE ) ;
}

//******************************************************************************************
//                              D A T A A V A I L A B L E                                  *
//******************************************************************************************
// Returns the number of chunks available in the buffer.                                   *
//******************************************************************************************
uint16_t dataAvailable()
{
  return chcount ;
}

//******************************************************************************************
//                    G E T F R E E B U F F E R S P A C E                                  *
//******************************************************************************************
// Return the free buffer space in chunks.                                                 *
//******************************************************************************************
uint16_t getFreeBufferSpace()
{
  return ( SRAM_CH_SIZE - chcount ) ;                   // Return number of chunks available
}

//******************************************************************************************
//                             B U F F E R W R I T E                                       *
//******************************************************************************************
// Write one chunk (32 bytes) to SPI RAM.                                                  *
// No check on available space.  See spaceAvailable().                                     *
//******************************************************************************************
void bufferWrite ( uint8_t *b )
{
  spiramWrite ( writeinx * CHUNKSIZE, b, CHUNKSIZE ) ;  // Put byte in SRAM
  writeinx = ( writeinx + 1 ) % SRAM_CH_SIZE ;          // Increment and wrap if necessary
  chcount++ ;                                           // Count number of chunks
}

//******************************************************************************************
//                             B U F F E R R E A D                                         *
//******************************************************************************************
// Read one chunk in the user buffer.                                                      *
// Assume there is always something in the bufferpace.  See dataAvailable()                *
//******************************************************************************************
void bufferRead ( uint8_t *b )
{
  spiramRead ( readinx * CHUNKSIZE, b, CHUNKSIZE ) ;    // return next chunk
  readinx = ( readinx + 1 ) % SRAM_CH_SIZE ;            // Increment and wrap if necessary
  chcount-- ;                                           // Count is now one less
}

//******************************************************************************************
//                            B U F F E R R E S E T                                        *
//******************************************************************************************
void bufferReset()
{
  readinx = 0 ;                                         // Reset ringbuffer administration
  writeinx = 0 ;
  chcount = 0 ;
}

//******************************************************************************************
//                                S P I R A M S E T U P                                    *
//******************************************************************************************
void spiramSetup()
{
  SPI.begin();
  pinMode ( SRAM_CS, OUTPUT ) ;
  digitalWrite ( SRAM_CS, HIGH ) ;

  digitalWrite ( SRAM_CS, HIGH ) ;
  delay ( 50 ) ;
  digitalWrite ( SRAM_CS, LOW ) ;
  delay ( 50 ) ;
  digitalWrite ( SRAM_CS, HIGH ) ;

  SPI.beginTransaction ( SPISettings ( SRAM_FREQ, MSBFIRST, SPI_MODE0 ) ) ;
  digitalWrite ( SRAM_CS, LOW ) ;
  SPI.transfer ( 0x01 ) ;                             // Write mode register
  SPI.transfer ( 0x00 ) ;                             // Set byte mode
  digitalWrite ( SRAM_CS, HIGH ) ;
  SPI.endTransaction();

  bufferReset() ;                                     // Reset ringbuffer administration
}

```

Edzelf, 2022-02-27:
I have no way to test it.

h1aji, 2022-02-27:
I tested it and it works fine

Edzelf, 2022-02-27:
so, what is the problem?

h1aji, 2022-02-27:
No issue with the code itself. Just redirect is not working

h1aji, 2022-02-28:
@Edzelf I removed code with spiramdelay but it had no effect. Same out as I had above.
I even connected SPI RAM CS pin to GPIO 15 and set frequency to 20MHz, still ...

Edzelf, 2022-02-28:
Yes, I know. That is because there is a delay (a number of input bytes). The redirect info is less than that number and is therefore not handled

h1aji, 2022-03-06:
Hi @Edzelf
I was trying to modify
https://github.com/Edzelf/Esp-radio/blob/65f20ce4a5334ed1a272d046e8ed7f6b73dbb5e5/Esp_radio.ino#L2478

with no success.

Would you be able to advise how it can be done, maybe you can give me a clue? Thanks

h1aji, 2024-06-05:
Hi @Edzelf
Is there any chance to make redirect working while SPIRAM option is enabled?
Thanks

Thread 214 (2022-05-27):

Playlist m3u next - prev function (similar to esp32 radio)

Sanc0Pansa, 2022-05-27:
Hi Ed, would it be possible to set the code so that when playing m3u playlists it is possible to skip tracks (next - previous function) using uppreset - downpreset as it is in esp32 radio? Could you direct me to what to adjust? Well thank you.

Sanc0Pansa, 2022-05-30:
I have it. I've found that a simple code modification is enough.

Thread 216 (2023-08-17):

Can't upload data to ESP8266

wa8lbz63, 2023-08-17:
My old computer died so I am stating this project all over again with new Windows 10 (with latest updates installed) Dell laptop computer. Everything has gone well until I tried to upload data to ESP8266 using ESP8266 Sketch Data Upload in Arduino IDE Tools window. I am using Arduino IDE 1.8.19; ESP8266FS 0.5.0; Python 3.11.4; and COM4. All are located in the Arduino folder. I get the error message shown below.

Arduino: 1.8.19 (Windows 10), Board: "NodeMCU 1.0 (ESP-12E Module), 80 MHz, Flash, Disabled (new aborts on oom), Disabled, All SSL ciphers (most compatible), 32KB cache + 32KB IRAM (balanced), Use pgm_read macros for IRAM/PROGMEM, 4MB (FS:1MB OTA:~1019KB), 2, v2 Lower Memory, Disabled, None, Only Sketch, 115200"

[SPIFFS] data    : C:\Program Files (x86)\Arduino\Esp_radio\data
[SPIFFS] size    : 1000
[SPIFFS] page    : 256
[SPIFFS] block   : 8192
/radio.ini
[SPIFFS] upload  : C:\Users\Al\AppData\Local\Temp\arduino_build_841679/Esp_radio.spiffs.bin
[SPIFFS] address  : 0x300000
[SPIFFS] reset    : --before default_reset --after hard_reset
[SPIFFS] port     : COM4
[SPIFFS] speed    : 115200
[SPIFFS] python   : python.exe
[SPIFFS] uploader : C:\Users\Al\AppData\Local\Arduino15\packages\esp8266\hardware\esp8266\3.1.2\tools\upload.py

usage: esptool [-h] [--chip {auto,esp8266,esp32,esp32s2,esp32s3beta2,esp32c3}]
               [--port PORT] [--baud BAUD]
               [--before {default_reset,no_reset,no_reset_no_sync}]
               [--after {hard_reset,soft_reset,no_reset}] [--no-stub]
               [--trace] [--override-vddsdio [{1.8V,1.9V,OFF}]]
               [--connect-attempts CONNECT_ATTEMPTS]
               {load_ram,dump_mem,read_mem,write_mem,write_flash,run,image_info,make_image,elf2image,read_mac,chip_id,flash_id,read_flash_status,write_flash_status,read_flash,verify_flash,erase_flash,erase_region,version,get_security_info}
               ...
esptool: error: unrecognized arguments: --end
SPIFFS Upload failed!

Edzelf, 2023-08-18:
Google is your friend.  See [here](https://github.com/esp8266/arduino-esp8266fs-plugin/issues/76).

Thread 219 (2023-09-03):

No Longer Connects To WiFi

wa8lbz63, 2023-09-03:
I have compiled and uploaded VERSION "Fri, 11 Feb 2022 13:05:00 GMT" ESP_radio.ino sketch with no problems. The Radio.ini file remained unchanged and worked before. Now when I turn on the ESP_radio, it no longer connects to the WiFi. This is indicated by the "Connecting To WiFi" message in the display continuing indefinitely. I didn't see any changes in the manual pertaining to this latest software version.

I would like to say that didn't build this project just build it, I built it to use it and I do. This is why I am trying to stay current the changing code. Your help is greatly appreciated, and I hope my input is helpful to you.

wa8lbz63, 2023-09-04:
Line 22 of the ino says: Compiling: Set SPIFS to 3 MB.  Set IwIP variant to "V1.4 Higher Bandwidth". My chices in the Arduino IDE 1.8.19 are: Tools > Flash Size "4MB (FS 3MB OTA-512KB)" and V2 Higher Bandwidth. It maybe that the flash is being written to the wrong place in memory or is some how being over written by something else.

Here is the printout from the data upload:

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

Thread 220 (2023-12-22):

The board keeps restarting, instead of the website only "sorry" appears

JureqB, 2023-12-22:
I am unable to access the website because the board keeps restarting. I tried different ESP32 modules, tested with and without a connected display and decoder - the effect is the same:

ets Jul 29 2019 12:21:46

rst:0xc (SW_CPU_RESET),boot:0x13 (SPI_FAST_FLASH_BOOT)
configsip: 0, SPIWP:0xee
clk_drv:0x00,q_drv:0x00,d_drv:0x00,cs0_drv:0x00,hd_drv:0x00,wp_drv:0x00
mode:DIO, clock div:2
load:0x3fff0030,len:1184
load:0x40078000,len:13232
load:0x40080400,len:3028
entry 0x400805e4
E (516) esp_core_dump_flash: No core dump f�ѥѥ���found!
E (516) esp_core_dump_flash: No core dump partition found!
[     8][D][esp32-hal-cpu.c:244] setCpuFrequencyMhz(): PLL: 480 / 2 = 240 Mhz, APB: 80000000 Hz

Starting ESP32-radio running on CPU 1 at 240 MHz.
[  3025][I][main.cpp:2582] setup(): [main] Version Thu, 14 Dec 2023 09:00:00 GMT.  Free memory 110580
[  3027][I][main.cpp:2583] setup(): [main] Display type is ILI9341
[  3123][I][main.cpp:2593] setup(): [main] SPIFFS is okay, space 1016801, used 0
[  3196][I][main.cpp:2614] setup(): [main] Found partition 'nvs     ' at offset 0x009000 with size    20480
[  3196][I][main.cpp:2614] setup(): [main] Found partition 'otadata ' at offset 0x00E000 with size     8192
[  3204][I][main.cpp:2614] setup(): [main] Found partition 'spiffs  ' at offset 0x2F0000 with size  1114112
[  3216][I][main.cpp:2486] fillkeylist(): [main] Read 0 keys from NVS
[  3220][I][main.cpp:1910] readIOprefs(): [main] pin_spi_sck set to 18
[  3226][I][main.cpp:1910] readIOprefs(): [main] pin_spi_miso set to 19
[  3232][I][main.cpp:1910] readIOprefs(): [main] pin_spi_mosi set to 23
[  3249][I][main.cpp:2655] setup(): [main] GPIO0 is HIGH
[  3259][I][main.cpp:2655] setup(): [main] GPIO2 is HIGH
[  3269][I][main.cpp:2655] setup(): [main] GPIO4 is HIGH
[  3279][I][main.cpp:2655] setup(): [main] GPIO5 is HIGH
[  3289][I][main.cpp:2655] setup(): [main] GPIO12 is HIGH
[  3299][I][main.cpp:2655] setup(): [main] GPIO13 is HIGH
[  3309][I][main.cpp:2655] setup(): [main] GPIO14 is HIGH
[  3319][I][main.cpp:2655] setup(): [main] GPIO15 is HIGH
[  3329][I][main.cpp:2655] setup(): [main] GPIO16 is HIGH
[  3339][I][main.cpp:2655] setup(): [main] GPIO17 is HIGH
[  3349][I][main.cpp:2655] setup(): [main] GPIO18 is HIGH
[  3359][I][main.cpp:2655] setup(): [main] GPIO19 is HIGH
[  3369][I][main.cpp:2655] setup(): [main] GPIO21 is HIGH
[  3379][I][main.cpp:2655] setup(): [main] GPIO22 is HIGH
[  3389][I][main.cpp:2655] setup(): [main] GPIO23 is HIGH
[  3399][I][main.cpp:2655] setup(): [main] GPIO25 is HIGH
[  3409][I][main.cpp:2655] setup(): [main] GPIO26 is HIGH
[  3419][I][main.cpp:2655] setup(): [main] GPIO27 is HIGH
[  3429][I][main.cpp:2655] setup(): [main] GPIO32 is HIGH
[  3439][I][main.cpp:2655] setup(): [main] GPIO33 is HIGH
[  3449][I][main.cpp:2655] setup(): [main] GPIO34 is LOW, probably no PULL-UP
[  3459][I][main.cpp:2655] setup(): [main] GPIO35 is HIGH
[  3469][I][main.cpp:2655] setup(): [main] GPIO39 is LOW, probably no PULL-UP
[  3471][I][main.cpp:2672] setup(): [main] Start ILI9341 display
[  3472][E][main.cpp:2689] setup(): [main] Display not activated
[  3476][I][main.cpp:2278] mk_lsan(): [main] Create list with acceptable WiFi networks
[  3484][I][WiFiMulti.cpp:84] addAP(): [WIFI][APlistAdd] add SSID: siatka
[  3491][I][main.cpp:2308] mk_lsan(): [main] Added siatka to list of networks
[  4014][D][WiFiGeneric.cpp:1035] _eventCallback(): Arduino Event: 0 - WIFI_READY
[  4112][V][WiFiGeneric.cpp:340] _arduino_event_cb(): STA Started
[  4112][D][WiFiGeneric.cpp:1035] _eventCallback(): Arduino Event: 2 - STA_START
[  4611][I][main.cpp:865] listNetworks(): [main] Scan Networks
[ 10826][V][WiFiGeneric.cpp:383] _arduino_event_cb(): SCAN Done: ID: 128, Status: 0, Results: 7
[ 10826][D][WiFiGeneric.cpp:1035] _eventCallback(): Arduino Event: 1 - SCAN_DONE
[ 10831][I][main.cpp:867] listNetworks(): [main] Scan completed
[ 10836][I][main.cpp:875] listNetworks(): [main] Number of available networks: 7
[ 10843][I][main.cpp:893] listNetworks(): [main]  1 - ArabicaGuest              Signal: -56 dBm, Encryption WPA_WPA2_PSK, Not accepttable
[ 10855][I][main.cpp:893] listNetworks(): [main]  2 - ARABICA2GHZ               Signal: -56 dBm, Encryption WPA2_PSK, Not accepttable
[ 10867][I][main.cpp:893] listNetworks(): [main]  3 - G6_5308                   Signal: -72 dBm, Encryption WPA2_PSK, Not accepttable
[ 10879][I][main.cpp:893] listNetworks(): [main]  4 - sieciunia                 Signal: -77 dBm, Encryption WPA2_PSK, Not accepttable
[ 10891][I][main.cpp:893] listNetworks(): [main]  5 - c96MQcTF                  Signal: -77 dBm, Encryption WPA2_PSK, Not accepttable
[ 10902][I][main.cpp:893] listNetworks(): [main]  6 - siatka                    Signal: -79 dBm, Encryption WPA2_PSK, Acceptable
[ 10914][I][main.cpp:893] listNetworks(): [main]  7 - NETIASPOT-87EF10          Signal: -82 dBm, Encryption WPA_WPA2_PSK, Not accepttable
[ 10926][I][main.cpp:897] listNetworks(): [main] End of list
[ 10931][I][main.cpp:2717] setup(): [main] Connect to network
[ 10938][V][WiFiGeneric.cpp:343] _arduino_event_cb(): STA Stopped
[ 10942][D][WiFiGeneric.cpp:1035] _eventCallback(): Arduino Event: 3 - STA_STOP
[ 11948][D][WiFiGeneric.cpp:1035] _eventCallback(): Arduino Event: 0 - WIFI_READY
[ 11952][V][WiFiGeneric.cpp:340] _arduino_event_cb(): STA Started
[ 11952][D][WiFiGeneric.cpp:1035] _eventCallback(): Arduino Event: 2 - STA_START
[ 12953][V][WiFiGeneric.cpp:97] set_esp_interface_ip(): Configuring Station static IP: 0.0.0.0, MASK: 0.0.0.0, GW: 0.0.0.0
[ 12959][I][main.cpp:1605] connectwifi(): [main] Try WiFi siatka
[ 14028][V][WiFiGeneric.cpp:355] _arduino_event_cb(): STA Connected: SSID: siatka, BSSID: 08:31:a4:8b:55:af, Channel: 5, Auth: WPA2_PSK
[ 14029][D][WiFiGeneric.cpp:1035] _eventCallback(): Arduino Event: 4 - STA_CONNECTED
[ 14082][V][WiFiGeneric.cpp:369] _arduino_event_cb(): STA Got New IP:10.0.0.167
[ 14083][D][WiFiGeneric.cpp:1035] _eventCallback(): Arduino Event: 7 - STA_GOT_IP
[ 14086][D][WiFiGeneric.cpp:1098] _eventCallback(): STA IP: 10.0.0.167, MASK: 255.255.255.0, GW: 10.0.0.2
[ 14160][I][main.cpp:1638] connectwifi(): [main] SSID = siatka
[ 14160][I][main.cpp:1642] connectwifi(): [main] IP = 10.0.0.167
[ 14160][I][main.cpp:2727] setup(): [main] Start web server
[ 14166][I][main.cpp:2737] setup(): [main] Network found. Starting clients
[ 14175][I][main.cpp:2771] setup(): [main] MDNS responder started
[ 15180][I][main.cpp:2816] setup(): [main] Rotary encoder is disabled (-1/-1/-1)
[ 15181][I][main.cpp:4372] gettime(): [main] Sync TOD
[ 15181][I][main.cpp:4385] gettime(): [main] TOD synced
[ 15288][E][main.cpp:749] nvsgetstr(): [main] nvs_get_str failed 1102 for key preset, keylen is 6, len is 150!
[ 15288][E][main.cpp:750] nvsgetstr(): [main] Contents:
[ 15292][I][main.cpp:966] nextPreset(): [main] nextPreset is 0
[ 15297][I][main.cpp:3403] radiofuncs(): [main] Radiofuncs cmd is 1
[ 15304][I][main.cpp:1400] connecttohost(): [main] Connect to host
[ 15309][E][AsyncTCP.cpp:729] connect(): error: -16
[ 15314][E][main.cpp:1472] connecttohost(): [main] Request  failed!
Guru Meditation Error: Core  1 panic'ed (LoadProhibited). Exception was unhandled.

Core  1 register dump:
PC      : 0x400edf5b  PS      : 0x00060d30  A0      : 0x800d88e8  A1      : 0x3ffcee30
A2      : 0x00000000  A3      : 0x00000000  A4      : 0xc4490906  A5      : 0x3ffcee10
A6      : 0x3ffcee10  A7      : 0x00000080  A8      : 0x800d645c  A9      : 0x3ffc60dc
A10     : 0x3ffcebc8  A11     : 0x00000004  A12     : 0x3f400124  A13     : 0x000005c0
A14     : 0x3f401e86  A15     : 0x3f401f25  SAR     : 0x0000001b  EXCCAUSE: 0x0000001c
EXCVADDR: 0x00000009  LBEG    : 0x4008bb95  LEND    : 0x4008bba5  LCOUNT  : 0xffffffff

Backtrace: 0x400edf58:0x3ffcee30 0x400d88e5:0x3ffcee50 0x400da1c8:0x3ffcee70 0x400f2269:0x3ffcee90

ELF file SHA256: 960efa8f48f0d366

E (15553) esp_core_dump_flash: Core dump flash config is corrupted! CRC=0x7bd5c66f instead of 0x0
Rebooting...
ets Jul 29 2019 12:21:46

Edzelf, 2023-12-22:
Copy the files in the "data" directory to SPIFFS.
See [here](https://randomnerdtutorials.com/install-esp32-filesystem-uploader-arduino-ide/) for tutorial.

JureqB, 2023-12-22:
I did everything according to this tutorial: [](https://randomnerdtutorials.com/esp32-vs-code-platformio-spiffs/)
Now I have connected another new ESP32 Wroom 32D board, V1053 decoder and ILI19341 display:

Processing esp32 (platform: espressif32; board: esp32doit-devkit-v1; framework: arduino)
---------------------------------------------------------------------------------------------Verbose mode can be enabled via `-v, --verbose` option
CONFIGURATION: https://docs.platformio.org/page/boards/espressif32/esp32doit-devkit-v1.html
PLATFORM: Espressif 32 (6.4.0) > DOIT ESP32 DEVKIT V1
HARDWARE: ESP32 240MHz, 320KB RAM, 4MB Flash
DEBUG: Current (cmsis-dap) External (cmsis-dap, esp-bridge, esp-prog, iot-bus-jtag, jlink, minimodule, olimex-arm-usb-ocd, olimex-arm-usb-ocd-h, olimex-arm-usb-tiny-h, olimex-jtag-tiny,
tumpa)
PACKAGES:
 - framework-arduinoespressif32 @ 3.20011.230801 (2.0.11)
 - tool-esptoolpy @ 1.40501.0 (4.5.1)
 - tool-mkspiffs @ 2.230.0 (2.30)
 - toolchain-xtensa-esp32 @ 8.4.0+2021r2-patch5
LDF: Library Dependency Finder -> https://bit.ly/configure-pio-ldf
LDF Modes: Finder ~ chain+, Compatibility ~ soft
Found 56 compatible libraries
Scanning dependencies...
Dependency Graph
|-- Wire @ 2.0.0
|-- PubSubClient @ 2.8.0
|-- Adafruit BusIO @ 1.14.5
|-- Adafruit GFX Library @ 1.11.9
|-- Adafruit ILI9341 @ 1.6.0
|-- Adafruit ST7735 and ST7789 Library @ 1.10.3
|-- AsyncTCP @ 1.1.1
|-- ESP Async WebServer @ 1.2.3
|-- AC101 @ 0.0.1
|-- WiFi @ 2.0.0
|-- FS @ 2.0.0
|-- ESPmDNS @ 2.0.0
|-- SPI @ 2.0.0
|-- SPIFFS @ 2.0.0
|-- codecs
|-- ILI9341
Building in release mode
Building FS image from 'data' directory to .pio\build\esp32\spiffs.bin
/about.html
/config.html
/defaultprefs.txt
/favicon.ico
/index.html
/mp3play.html
/nomp3play.html
/search.html
/style.css
================================ [SUCCESS] Took 5.12 seconds

and next:

Processing esp32 (platform: espressif32; board: esp32doit-devkit-v1; framework: arduino)
---------------------------------------------------------------------------------------------------------------------------------------------------------------------------------------------Verbose mode can be enabled via `-v, --verbose` option
CONFIGURATION: https://docs.platformio.org/page/boards/espressif32/esp32doit-devkit-v1.html
PLATFORM: Espressif 32 (6.4.0) > DOIT ESP32 DEVKIT V1
HARDWARE: ESP32 240MHz, 320KB RAM, 4MB Flash
DEBUG: Current (cmsis-dap) External (cmsis-dap, esp-bridge, esp-prog, iot-bus-jtag, jlink, minimodule, olimex-arm-usb-ocd, olimex-arm-usb-ocd-h, olimex-arm-usb-tiny-h, olimex-jtag-tiny, tumpa)
PACKAGES:
 - framework-arduinoespressif32 @ 3.20011.230801 (2.0.11)
 - tool-esptoolpy @ 1.40501.0 (4.5.1)
 - tool-mkfatfs @ 2.0.1
 - tool-mklittlefs @ 1.203.210628 (2.3)
 - tool-mkspiffs @ 2.230.0 (2.30)
 - toolchain-xtensa-esp32 @ 8.4.0+2021r2-patch5
LDF: Library Dependency Finder -> https://bit.ly/configure-pio-ldf
LDF Modes: Finder ~ chain+, Compatibility ~ soft
Found 56 compatible libraries
Scanning dependencies...
Dependency Graph
|-- Wire @ 2.0.0
|-- PubSubClient @ 2.8.0
|-- Adafruit BusIO @ 1.14.5
|-- Adafruit GFX Library @ 1.11.9
|-- Adafruit ILI9341 @ 1.6.0
|-- Adafruit ST7735 and ST7789 Library @ 1.10.3
|-- AsyncTCP @ 1.1.1
|-- ESP Async WebServer @ 1.2.3
|-- AC101 @ 0.0.1
|-- WiFi @ 2.0.0
|-- FS @ 2.0.0
|-- ESPmDNS @ 2.0.0
|-- SPI @ 2.0.0
|-- SPIFFS @ 2.0.0
|-- codecs
|-- ILI9341
Building in release mode
Building FS image from 'data' directory to .pio\build\esp32\spiffs.bin
/about.html
/config.html
/defaultprefs.txt
/favicon.ico
/index.html
/mp3play.html
/nomp3play.html
/search.html
/style.css
Looking for upload port...
Using manually specified: COM6
Uploading .pio\build\esp32\spiffs.bin
esptool.py v4.5.1
Serial port COM6
Connecting....
Chip is ESP32-D0WD-V3 (revision v3.1)
Features: WiFi, BT, Dual Core, 240MHz, VRef calibration in efuse, Coding Scheme None
Crystal is 40MHz
MAC: a8:42:e3:9e:af:34
Uploading stub...
Running stub...
Stub running...
Changing baud rate to 460800
Changed.
Configuring flash size...
Flash will be erased from 0x002f0000 to 0x003fffff...
Compressed 1114112 bytes to 12288...
Writing at 0x002f0000... (100 %)
Wrote 1114112 bytes (12288 compressed) at 0x002f0000 in 5.5 seconds (effective 1617.4 kbit/s)...
Hash of data verified.

Leaving...
Hard resetting via RTS pin...
=============================================================================== [SUCCESS] Took 13.35 seconds

JureqB, 2023-12-22:
Unfortunately, nothing has changed:

rst:0xc (SW_CPU_RESET),boot:0x13 (SPI_FAST_FLASH_BOOT)
configsip: 0, SPIWP:0xee
clk_drv:0x00,q_drv:0x00,d_drv:0x00,cs0_drv:0x00,hd_drv:0x00,wp_drv:0x00
mode:DIO, clock div:2
load:0x3fff0030,len:1184
load:0x40078000,len:13232
load:0x40080400,len:3028
entry 0x400805e4
E (516) esp_core_dump_flash: No core dump f�ѥѥ�� found!
E (516) esp_core_dump_flash: No core dump partition found!
[     8][D][esp32-hal-cpu.c:244] setCpuFrequencyMhz(): PLL: 480 / 2 = 240 Mhz, APB: 80000000 Hz

Starting ESP32-radio running on CPU 1 at 240 MHz.
[  3024][I][main.cpp:2582] setup(): [main] Version Thu, 14 Dec 2023 09:00:00 GMT.  Free memory 110580
[  3026][I][main.cpp:2583] setup(): [main] Display type is ILI9341
[  3123][I][main.cpp:2593] setup(): [main] SPIFFS is okay, space 1016801, used 33383
[  3126][I][main.cpp:2614] setup(): [main] Found partition 'nvs     ' at offset 0x009000 with size    20480
[  3129][I][main.cpp:2614] setup(): [main] Found partition 'otadata ' at offset 0x00E000 with size     8192
[  3138][I][main.cpp:2614] setup(): [main] Found partition 'spiffs  ' at offset 0x2F0000 with size  1114112
[  3151][I][main.cpp:2486] fillkeylist(): [main] Read 0 keys from NVS
[  3155][I][main.cpp:1910] readIOprefs(): [main] pin_spi_sck set to 18
[  3160][I][main.cpp:1910] readIOprefs(): [main] pin_spi_miso set to 19
[  3166][I][main.cpp:1910] readIOprefs(): [main] pin_spi_mosi set to 23
[  3183][I][main.cpp:2655] setup(): [main] GPIO0 is HIGH
[  3193][I][main.cpp:2655] setup(): [main] GPIO2 is HIGH
[  3203][I][main.cpp:2655] setup(): [main] GPIO4 is HIGH
[  3213][I][main.cpp:2655] setup(): [main] GPIO5 is HIGH
[  3223][I][main.cpp:2655] setup(): [main] GPIO12 is HIGH
[  3233][I][main.cpp:2655] setup(): [main] GPIO13 is HIGH
[  3243][I][main.cpp:2655] setup(): [main] GPIO14 is HIGH
[  3253][I][main.cpp:2655] setup(): [main] GPIO15 is HIGH
[  3263][I][main.cpp:2655] setup(): [main] GPIO16 is HIGH
[  3273][I][main.cpp:2655] setup(): [main] GPIO17 is HIGH
[  3283][I][main.cpp:2655] setup(): [main] GPIO18 is HIGH
[  3293][I][main.cpp:2655] setup(): [main] GPIO19 is HIGH
[  3303][I][main.cpp:2655] setup(): [main] GPIO21 is HIGH
[  3313][I][main.cpp:2655] setup(): [main] GPIO22 is HIGH
[  3323][I][main.cpp:2655] setup(): [main] GPIO23 is HIGH
[  3333][I][main.cpp:2655] setup(): [main] GPIO25 is HIGH
[  3343][I][main.cpp:2655] setup(): [main] GPIO26 is HIGH
[  3353][I][main.cpp:2655] setup(): [main] GPIO27 is HIGH
[  3363][I][main.cpp:2655] setup(): [main] GPIO32 is HIGH
[  3373][I][main.cpp:2655] setup(): [main] GPIO33 is HIGH
[  3383][I][main.cpp:2655] setup(): [main] GPIO34 is LOW, probably no PULL-UP
[  3393][I][main.cpp:2655] setup(): [main] GPIO35 is LOW, probably no PULL-UP
[  3403][I][main.cpp:2655] setup(): [main] GPIO39 is LOW, probably no PULL-UP
[  3405][I][main.cpp:2672] setup(): [main] Start ILI9341 display
[  3406][E][main.cpp:2689] setup(): [main] Display not activated
[  3410][I][main.cpp:2278] mk_lsan(): [main] Create list with acceptable WiFi networks
[  3418][I][WiFiMulti.cpp:84] addAP(): [WIFI][APlistAdd] add SSID: siatka
[  3425][I][main.cpp:2308] mk_lsan(): [main] Added siatka to list of networks
[  3948][D][WiFiGeneric.cpp:1035] _eventCallback(): Arduino Event: 0 - WIFI_READY
[  4041][V][WiFiGeneric.cpp:340] _arduino_event_cb(): STA Started
[  4041][D][WiFiGeneric.cpp:1035] _eventCallback(): Arduino Event: 2 - STA_START
[  4541][I][main.cpp:865] listNetworks(): [main] Scan Networks
[ 10755][V][WiFiGeneric.cpp:383] _arduino_event_cb(): SCAN Done: ID: 128, Status: 0, Results: 9
[ 10756][D][WiFiGeneric.cpp:1035] _eventCallback(): Arduino Event: 1 - SCAN_DONE
[ 10761][I][main.cpp:867] listNetworks(): [main] Scan completed
[ 10766][I][main.cpp:875] listNetworks(): [main] Number of available networks: 9
[ 10773][I][main.cpp:893] listNetworks(): [main]  1 - ArabicaGuest              Signal: -52 dBm, Encryption WPA_WPA2_PSK, Not accepttable
[ 10785][I][main.cpp:893] listNetworks(): [main]  2 - ARABICA2GHZ               Signal: -52 dBm, Encryption WPA2_PSK, Not accepttable
[ 10797][I][main.cpp:893] listNetworks(): [main]  3 - c96MQcTF                  Signal: -67 dBm, Encryption WPA2_PSK, Not accepttable
[ 10809][I][main.cpp:893] listNetworks(): [main]  4 - siatka                    Signal: -67 dBm, Encryption WPA2_PSK, Acceptable
[ 10820][I][main.cpp:893] listNetworks(): [main]  5 - sieciunia                 Signal: -68 dBm, Encryption WPA2_PSK, Not accepttable
[ 10832][I][main.cpp:893] listNetworks(): [main]  6 - G6_5308                   Signal: -71 dBm, Encryption WPA2_PSK, Not accepttable
[ 10843][I][main.cpp:893] listNetworks(): [main]  7 - CGA2121_nSeyQFz           Signal: -86 dBm, Encryption WPA2_PSK, Not accepttable
[ 10855][I][main.cpp:893] listNetworks(): [main]  8 - NETIASPOT-87EF10          Signal: -88 dBm, Encryption WPA_WPA2_PSK, Not accepttable
[ 10867][I][main.cpp:893] listNetworks(): [main]  9 - DIRECT-76-HP M477 LaserJet Signal: -90 dBm, Encryption WPA2_PSK, Not accepttable
[ 10879][I][main.cpp:897] listNetworks(): [main] End of list
[ 10884][I][main.cpp:2717] setup(): [main] Connect to network
[ 10891][V][WiFiGeneric.cpp:343] _arduino_event_cb(): STA Stopped
[ 10896][D][WiFiGeneric.cpp:1035] _eventCallback(): Arduino Event: 3 - STA_STOP
[ 11901][D][WiFiGeneric.cpp:1035] _eventCallback(): Arduino Event: 0 - WIFI_READY
[ 11905][V][WiFiGeneric.cpp:340] _arduino_event_cb(): STA Started
[ 11905][D][WiFiGeneric.cpp:1035] _eventCallback(): Arduino Event: 2 - STA_START
[ 12906][V][WiFiGeneric.cpp:97] set_esp_interface_ip(): Configuring Station static IP: 0.0.0.0, MASK: 0.0.0.0, GW: 0.0.0.0
[ 12912][I][main.cpp:1605] connectwifi(): [main] Try WiFi siatka
[ 13979][V][WiFiGeneric.cpp:355] _arduino_event_cb(): STA Connected: SSID: siatka, BSSID: 08:31:a4:8b:55:af, Channel: 5, Auth: WPA2_PSK
[ 13981][D][WiFiGeneric.cpp:1035] _eventCallback(): Arduino Event: 4 - STA_CONNECTED
[ 14046][V][WiFiGeneric.cpp:369] _arduino_event_cb(): STA Got New IP:10.0.0.166
[ 14047][D][WiFiGeneric.cpp:1035] _eventCallback(): Arduino Event: 7 - STA_GOT_IP
[ 14050][D][WiFiGeneric.cpp:1098] _eventCallback(): STA IP: 10.0.0.166, MASK: 255.255.255.0, GW: 10.0.0.2
[ 14113][I][main.cpp:1638] connectwifi(): [main] SSID = siatka
[ 14113][I][main.cpp:1642] connectwifi(): [main] IP = 10.0.0.166
[ 14113][I][main.cpp:2727] setup(): [main] Start web server
[ 14119][I][main.cpp:2737] setup(): [main] Network found. Starting clients
[ 14128][I][main.cpp:2771] setup(): [main] MDNS responder started
[ 15133][I][main.cpp:2816] setup(): [main] Rotary encoder is disabled (-1/-1/-1)
[ 15134][I][main.cpp:4372] gettime(): [main] Sync TOD
[ 15134][I][main.cpp:4385] gettime(): [main] TOD synced
[ 15241][E][main.cpp:749] nvsgetstr(): [main] nvs_get_str failed 1102 for key preset, keylen is 6, len is 150!
[ 15241][E][main.cpp:750] nvsgetstr(): [main] Contents:
[ 15245][I][main.cpp:966] nextPreset(): [main] nextPreset is 0
[ 15250][I][main.cpp:3403] radiofuncs(): [main] Radiofuncs cmd is 1
[ 15257][I][main.cpp:1400] connecttohost(): [main] Connect to host
[ 15262][E][AsyncTCP.cpp:729] connect(): error: -16
[ 15267][E][main.cpp:1472] connecttohost(): [main] Request  failed!
Guru Meditation Error: Core  1 panic'ed (LoadProhibited). Exception was unhandled.

Core  1 register dump:
PC      : 0x400edf5b  PS      : 0x00060d30  A0      : 0x800d88e8  A1      : 0x3ffcee30
A2      : 0x00000000  A3      : 0x00000000  A4      : 0xf380c909  A5      : 0x3ffcee10
A6      : 0x3ffcee10  A7      : 0x00000080  A8      : 0x800d645c  A9      : 0x3ffc60dc
A10     : 0x3ffcebc8  A11     : 0x00000004  A12     : 0x3f400124  A13     : 0x000005c0
A14     : 0x3f401e86  A15     : 0x3f401f25  SAR     : 0x0000001a  EXCCAUSE: 0x0000001c
EXCVADDR: 0x00000009  LBEG    : 0x4008bb95  LEND    : 0x4008bba5  LCOUNT  : 0xffffffff

Backtrace: 0x400edf58:0x3ffcee30 0x400d88e5:0x3ffcee50 0x400da1c8:0x3ffcee70 0x400f2269:0x3ffcee90

  #0  0x400edf58:0x3ffcee30 in VS1053::setVolume(unsigned char) at lib/codecs/src/VS1053.cpp:216
  #1  0x400d88e5:0x3ffcee50 in spfuncs() at src/main.cpp:3352
      (inlined by) spfuncs() at src/main.cpp:3327
  #2  0x400da1c8:0x3ffcee70 in loop() at src/main.cpp:3468
  #3  0x400f2269:0x3ffcee90 in loopTask(void*) at C:/Users/jtp/.platformio/packages/framework-arduinoespressif32/cores/esp32/main.cpp:50

ELF file SHA256: 9ab732facf8772cc

E (15505) esp_core_dump_flash: Core dump flash config is corrupted! CRC=0x7bd5c66f instead of 0x0
Rebooting...

JureqB, 2023-12-22:
I repeated this process once again, but now before pressing "Upload Filesystem Image" I selected the "Program Size" option.
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
I uploaded everything again and... the website is now working, I'm starting to configure it.

Thread 223 (2024-10-29):

IDE version 1.8, esp8266 software 2.2.0, how to get LittleFS to work??

HoerMirAuf, 2024-10-29:
See the headline.

How to get LittleFS to work?
(LittleFS.h not found!!)

Edzelf, 2024-10-29:
I used:
```
name=LittleFS
version=0.1.0
author=Earle F. Philhower, III
maintainer=Earle F. Philhower, III <earlephilhower@yahoo.com>
sentence=Port of LittleFS to ESP8266 Arduino
paragraph=Replacement for SPIFFS to manage a filesystem in the onboard flash, supporting power fail safety and higher performance than SPIFFS at the cost of a lower maximum number of files.
category=Data Storage
url=https://github.com/esp8266/Arduino/libraries/LittleFS
architectures=esp8266
dot_a_linkage=true

```

HoerMirAuf, 2024-10-30:
Hi ... thank you for the URL.
But ist a 404 error.

The only LittleFS i can find is part of the Arduino Master tree:
https://github.com/esp8266/Arduino/tree/master/libraries
And this one will not compile with core 2.2.0

Maybe you can share your LittleFS package?

Edzelf, 2024-10-30:
I'm using version 3.1.1 of the ESP8266 toolchain:
```
Using library ESP8266WiFi at version 1.0 in folder: C:\Users\hp\AppData\Local\Arduino15\packages\esp8266\hardware\esp8266\3.1.1\libraries\ESP8266WiFi
Using library ESPAsyncTCP-master at version 1.2.0 in folder: D:\docs\Arduino\libraries\ESPAsyncTCP-master
Using library ESPAsyncWebServer-master at version 1.2.0 in folder: D:\docs\Arduino\libraries\ESPAsyncWebServer-master
Using library async-mqtt-client-master at version 0.8.1 in folder: D:\docs\Arduino\libraries\async-mqtt-client-master
Using library SPI at version 1.0 in folder: C:\Users\hp\AppData\Local\Arduino15\packages\esp8266\hardware\esp8266\3.1.1\libraries\SPI
Using library Adafruit_GFX_Library at version 1.11.5 in folder: D:\docs\Arduino\libraries\Adafruit_GFX_Library
Using library Adafruit_BusIO at version 1.15.0 in folder: D:\docs\Arduino\libraries\Adafruit_BusIO
Using library Wire at version 1.0 in folder: C:\Users\hp\AppData\Local\Arduino15\packages\esp8266\hardware\esp8266\3.1.1\libraries\Wire
Using library TFT_ILI9163C-master at version 0.9 in folder: D:\docs\Arduino\libraries\TFT_ILI9163C-master
Using library Ticker at version 1.0 in folder: C:\Users\hp\AppData\Local\Arduino15\packages\esp8266\hardware\esp8266\3.1.1\libraries\Ticker
Using library ArduinoOTA at version 1.0 in folder: C:\Users\hp\AppData\Local\Arduino15\packages\esp8266\hardware\esp8266\3.1.1\libraries\ArduinoOTA
Using library TinyXML at version 1.0.2 in folder: D:\docs\Arduino\libraries\TinyXML
Using library LittleFS at version 0.1.0 in folder: C:\Users\hp\AppData\Local\Arduino15\packages\esp8266\hardware\esp8266\3.1.1\libraries\LittleFS
Using library Hash at version 1.0 in folder: C:\Users\hp\AppData\Local\Arduino15\packages\esp8266\hardware\esp8266\3.1.1\libraries\Hash
Using library ESP8266mDNS at version 1.2 in folder: C:\Users\hp\AppData\Local\Arduino15\packages\esp8266\hardware\esp8266\3.1.1\libraries\ESP8266mDNS

```
In the "Additional board manager URLs:
`http://arduino.esp8266.com/stable/package_esp8266com_index.json`

HoerMirAuf, 2024-10-30:
Thank you very much ... :)
3.1.1 toolchain, did it. 👍

What's about IwIP variant? i took v2 higher bandwich or it's better to take sometihng else?

Edzelf, 2024-10-30:
I don't know, just try.
Please consider [this](https://github.com/Edzelf/ESP32Radio-V2) for a better version of the radio.

HoerMirAuf, 2024-10-30:
Ok ... i did.
The only stable IwIP build seems to be: "v2 Lower Memory (no features)"
Thank you very much for your help and hints 👍

Closed 2024-10-30.

Thread 225 (2025-03-12):

New features added, minor bugs fixed and appearance changed

PedjaZzz, 2025-03-12:
Hello,

First, let me commend the author for his excellent work and for his selfless sharing of it.
Some minor issues have been resolved, new features have been added, and the layout has been adapted to mobile phones.

  -Mobile-friendly appearance.
  -Station presets buttons (first 8 stations in .ini)
  -Show station name in PRESET: (using preset buttons or PREV/NEXT)
  -Show status few seconds after selecting station.
  -Static IP ("esp-radio.local" sometimes not working) - line 1980 - set to 192.168.0.7
  -Fixed "If volume it decreases less than 0, then it becomes 100".
  -Fixed "Changing volume when changing station -> volume goes at once to 0 or 100".
  -Load current EQ settings into drop-down boxes on web interface (ESP32-Radio #12).
  -Added support for IR remote control through IRremoteESP8266 #130.
  -Not fixed: POP after changing station. Wrong status if station do not have it.

Attached are the files that have been changed from the original.

[Esp_radio.zip](https://github.com/user-attachments/files/19206890/Esp_radio.zip)

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

Thread 226 (2025-05-08):

output pin for external relay

ghostxder, 2025-05-08:
hello, I already have built the radio on breadboard, using a 2,8" display, the vs1053b, a 1838 IR module, rotary encoder and a chinese amplifier (12V).  I also changed the fontsize and clockposition (described in issue #160). It works perfekt at the moment. Now I want to establish an external line-in, which I can activate with the IR remote control (just change the amplifier input from vs1053b to the line in with a simple relay board). For this i need an output-pin defined which i can connect in the config to an ir-code (it will take two ir-codes like mute/unmute // relay on/relay off).
How can I manage this? Where/ in which file to define the output-pin? What else do I have to program?

Edzelf, 2025-05-09:
Add this to the function "const char* analyzeCmd ( const char* par, const char* val )", near line 4153:

```
  else if ( argument == "linein" )                    // Line input change?
  {
    pinMode ( xxxx, OUTPUT ) ;
    digitalWrite ( ivalue != 0 ) ;
  }
```
Where "xxxx" is the pin you want to use.
Now you can configure (in the preferences in the config page of the web interface) the 2 IR codes to execute "linein = 1" or "linein = 0", for example:

```
ir_807F = linein = 1
ir_9903 = linein = 0

```
Good luck!

ghostxder, 2025-05-09:
Thank you for the quick response! I first added the code you suggested, but I received an Error: "Zu wenig Argumente im Funktionsaufruf". Then I modified the digitalWrite see picture. I could upload the code, the radio is working and a LED connected to pin 13 shows a HI-Signal. When using the remote both buttons set pin 13 to LOW. Only way to get a HI-Signal again is to reset the radio. Unfortunately I can't figure out my mistake.

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

Edzelf, 2025-05-09:
Sorry, it should be:digitalWrite ( 13, ivalue != 0 ) ;Verzonden vanaf mijn Galaxy
-------- Oorspronkelijk bericht --------Van: ghostxder ***@***.***> Datum: 09-05-2025  21:32  (GMT+01:00) Aan: Edzelf/Esp-radio ***@***.***> Cc: Ed Smallenburg ***@***.***>, Comment ***@***.***> Onderwerp: Re: [Edzelf/Esp-radio] output pin for external relay (Issue #226)
ghostxder left a comment (Edzelf/Esp-radio#226)
Thank you for the quick response! I first added the code you suggested, but I received an Error: "Zu wenig Argumente im Funktionsaufruf". Then I modified the digitalWrite see picture. I could upload the code, the radio is working and a LED connected to pin 13 shows a HI-Signal. When using the remote both buttons set pin 13 to LOW. Only way to get a HI-Signal again is to reset the radio. Unfortunately I can't figure out my mistake.
Screenshot.2025-05-09.211336.png (view on web)

—Reply to this email directly, view it on GitHub, or unsubscribe.You are receiving this because you commented.Message ID: ***@***.***
 .com>

[
{
***@***.***": "http://schema.org",
***@***.***": "EmailMessage",
"potentialAction": {
***@***.***": "ViewAction",
"target": "https://github.com/Edzelf/Esp-radio/issues/226#issuecomment-2867694858",
"url": "https://github.com/Edzelf/Esp-radio/issues/226#issuecomment-2867694858",
"name": "View Issue"
},
"description": "View this Issue on GitHub",
"publisher": {
***@***.***": "Organization",
"name": "GitHub",
"url": "https://github.com"
}
}
]

ghostxder, 2025-05-10:
Hello Ed, oh man... I thought much too complicated... didn't see the forest because of the trees in front of it...
Well, it is working, i can toggle the pin with the IR!
After Reset/ Power up there is no defined state (low/ high) on the pin (I used others, it is the same there, also) and the test-LED light up, maybe half brightness (I connected the LED to ground including a 220 Ohm resistor). Defined pin states are after first use of IR.
Is this due to "SETUP - check programmable input pins" (~ line 2558 - 2570) ? Is there a chance to exclude this pin from being pulled up?
Would it be very complicated to display "Line in" when the relay-pin is high?

Markus

Edzelf, 2025-05-10:
Put the "pinMode" call into "setup()" at the end, followed by a call to digitaWrite to set the default state of the output pin.
Than you may removen the "pinMode" call from "analyzeCmd".

ghostxder, 2025-05-11:
Hello Ed, thank you so much, this solved the issue. The relay pin is low before music starts to play.

Markus

Closed 2025-05-12.
