Edzelf/Esp-radio/(commit log)

2016-10-05 Add files via upload
    Replacement for TFT_ILI9163C-master. See https://github.com/sumotoy/TFT_ILI9163C and the PDF-file.
    Changes made for the blue 1.8 SPI 128x160 board.
2017-01-16 Add files via upload
    Correction playlists
    [Esp_radio.ino]
2017-01-17 Add files via upload
    Bugfix
    [Esp_radio.ino]
2017-01-23 Add files via upload
    Correction playlists.
    [Esp_radio.ino]
2017-02-01 Add files via upload
    Bugfix uploading files.
    [Esp_radio.ino]
